hackathon-buke-team/grid-up/hardware/B1/GW/pcb-3d.png

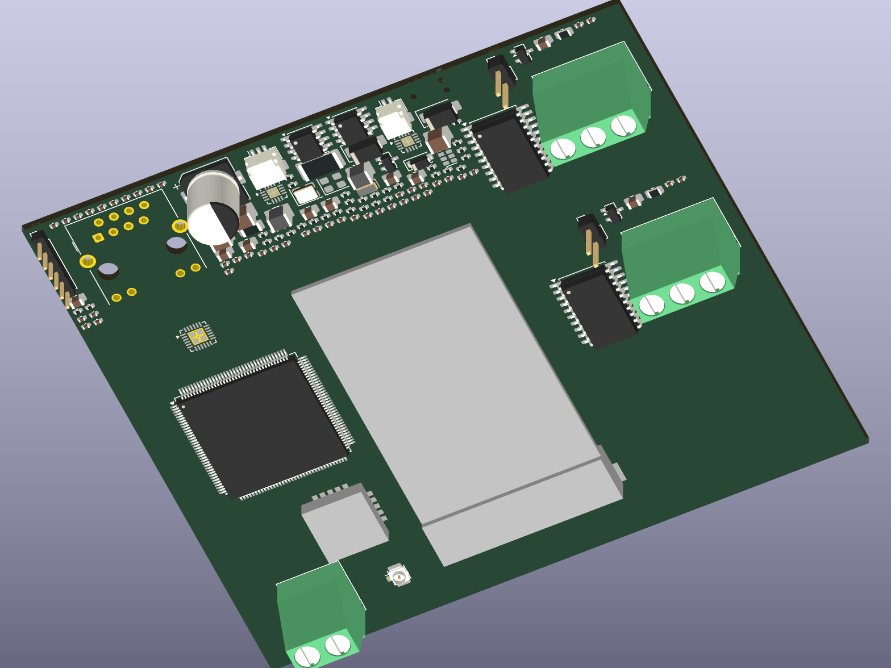
hardware/B1/GW/pcb-3d.png
