hackathon-buke-team/grid-up/hardware/B1/TC/pcb-3d.png

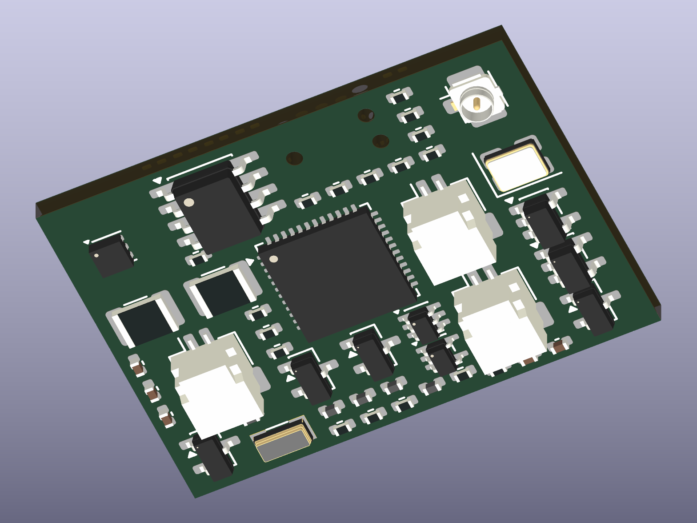
hardware/B1/TC/pcb-3d.png
