hackathon-buke-team/grid-up/hardware/B1/TEDARIK-ACIKLARI.md

# B1 tedarik açıkları

Bu dosya teklif talebi hazırlığıdır; hiçbir tedarikçiye gönderilmedi. Her satır için kesin MPN, paket, pin dizilimi, sıcaklık sınıfı, birim fiyat/para birimi/adet, alternatif ve Türkiye teslim tarihi kaydedilmelidir.

RF eşleme parçalarının değerleri routing ve RF doğrulaması sonrası sabitlenir. CT, HLC, izole faz referansı ve kutu kalemlerinde ölçü/elektriksel uygunluk fiyatla birlikte onaylanmalıdır.

| Kart / ref | Adet / kit | Teknik şart | Açık iş |
|---|---:|---|---|
| TC / J1 | 6 | CELL + HLC / Connector_JST:JST_SH_SM02B-SRSS-TB_1x02-1MP_P1.00mm_Horizontal | MPN_AND_QUOTE_REVIEW |
| TC / C1,C2,C13,C28,C30 | 30 | X7R 16V 1uF / Capacitor_SMD:C_0402_1005Metric | MPN_AND_QUOTE_REVIEW |
| TC / Q1 | 6 | AO3401A / Package_TO_SOT_SMD:SOT-23 | MPN_AND_QUOTE_REVIEW |
| TC / Q2,Q3 | 12 | 2N7002 / Package_TO_SOT_SMD:SOT-23 | MPN_AND_QUOTE_REVIEW |
| TC / R1,R2,R18,R19 | 24 | 1% thick film 1M / Resistor_SMD:R_0402_1005Metric | MPN_AND_QUOTE_REVIEW |
| TC / R3,R4,R6,R9,R11,R16 | 36 | 1% thick film 100k / Resistor_SMD:R_0402_1005Metric | MPN_AND_QUOTE_REVIEW |
| TC / C3 | 6 | X7R 16V 10nF / Capacitor_SMD:C_0402_1005Metric | MPN_AND_QUOTE_REVIEW |
| TC / R5 | 6 | 1% thick film 68R 0.5W / Resistor_SMD:R_1210_3225Metric | MPN_AND_QUOTE_REVIEW |
| TC / R7,R8 | 12 | 1% thick film 10k / Resistor_SMD:R_0402_1005Metric | MPN_AND_QUOTE_REVIEW |
| TC / C4,C5,C6,C7,C8,C11,C12,C16,C27,C31 | 60 | X7R 16V 100nF / Capacitor_SMD:C_0402_1005Metric | MPN_AND_QUOTE_REVIEW |
| TC / J2 | 6 | SWD TC2030 / Connector:Tag-Connect_TC2030-IDC-NL_2x03_P1.27mm_Vertical | MPN_AND_QUOTE_REVIEW |
| TC / J3 | 6 | MOUNT switch / Connector_JST:JST_SH_SM02B-SRSS-TB_1x02-1MP_P1.00mm_Horizontal | MPN_AND_QUOTE_REVIEW |
| TC / C9,C10 | 12 | X7R 16V 4.7uF / Capacitor_SMD:C_0402_1005Metric | MPN_AND_QUOTE_REVIEW |
| TC / R10,R15 | 12 | 1% thick film 0R / Resistor_SMD:R_0402_1005Metric | MPN_AND_QUOTE_REVIEW |
| TC / Y1 | 6 | 32MHz CL=10pF / Crystal:Crystal_SMD_3225-4Pin_3.2x2.5mm | MPN_AND_QUOTE_REVIEW |
| TC / Y2 | 6 | 32.768kHz CL=6pF / Crystal:Crystal_SMD_3215-2Pin_3.2x1.5mm | MPN_AND_QUOTE_REVIEW |
| TC / C14,C15 | 12 | X7R 16V 6pF / Capacitor_SMD:C_0402_1005Metric | MPN_AND_QUOTE_REVIEW |
| TC / U2 | 6 | MB85RS64V / Package_SO:SOIC-8_3.9x4.9mm_P1.27mm | MPN_AND_QUOTE_REVIEW |
| TC / R12,R13 | 12 | 1% thick film 4.7k / Resistor_SMD:R_0402_1005Metric | MPN_AND_QUOTE_REVIEW |
| TC / L1 | 6 | 47nH / Inductor_SMD:L_0402_1005Metric | MPN_AND_QUOTE_REVIEW |
| TC / C17,C29 | 12 | X7R 16V 47nF / Capacitor_SMD:C_0402_1005Metric | MPN_AND_QUOTE_REVIEW |
| TC / C18,C22,C26 | 18 | X7R 16V 68pF / Capacitor_SMD:C_0402_1005Metric | MPN_AND_QUOTE_REVIEW |
| TC / L2 | 6 | 4.4nH / Inductor_SMD:L_0402_1005Metric | MPN_AND_QUOTE_REVIEW |
| TC / C19 | 6 | X7R 16V 5.5pF / Capacitor_SMD:C_0402_1005Metric | MPN_AND_QUOTE_REVIEW |
| TC / C20 | 6 | X7R 16V 2.5pF / Capacitor_SMD:C_0402_1005Metric | MPN_AND_QUOTE_REVIEW |
| TC / L3 | 6 | 3.4nH / Inductor_SMD:L_0402_1005Metric | MPN_AND_QUOTE_REVIEW |
| TC / C21 | 6 | X7R 16V 4.3pF / Capacitor_SMD:C_0402_1005Metric | MPN_AND_QUOTE_REVIEW |
| TC / L4 | 6 | 9.2nH / Inductor_SMD:L_0402_1005Metric | MPN_AND_QUOTE_REVIEW |
| TC / C23 | 6 | X7R 16V 3.5pF / Capacitor_SMD:C_0402_1005Metric | MPN_AND_QUOTE_REVIEW |
| TC / C24 | 6 | X7R 16V 4.5pF / Capacitor_SMD:C_0402_1005Metric | MPN_AND_QUOTE_REVIEW |
| TC / L5 | 6 | 12nH / Inductor_SMD:L_0402_1005Metric | MPN_AND_QUOTE_REVIEW |
| TC / C25 | 6 | X7R 16V 2.7pF / Capacitor_SMD:C_0402_1005Metric | MPN_AND_QUOTE_REVIEW |
| TC / U3 | 6 | PE4259 / Package_TO_SOT_SMD:SOT-363_SC-70-6 | MPN_AND_QUOTE_REVIEW |
| TC / J4 | 6 | 868 MHz u.FL / Connector_Coaxial:U.FL_Hirose_U.FL-R-SMT-1_Vertical | MPN_AND_QUOTE_REVIEW |
| TC / J5 | 6 | CT 3000:1 / Connector_JST:JST_SH_SM02B-SRSS-TB_1x02-1MP_P1.00mm_Horizontal | MPN_AND_QUOTE_REVIEW |
| TC / R14 | 6 | 5.1R 0.1% 0.5W precision thin film; NOT generic 1% / Resistor_SMD:R_1210_3225Metric | MPN_AND_QUOTE_REVIEW |
| TC / R17 | 6 | 1% thick film 1k / Resistor_SMD:R_0402_1005Metric | MPN_AND_QUOTE_REVIEW |
| TC / U6 | 6 | BAT54S / Package_TO_SOT_SMD:SOT-23 | MPN_AND_QUOTE_REVIEW |
| IR / J1 | 1 | CELL + HLC / Connector_JST:JST_SH_SM02B-SRSS-TB_1x02-1MP_P1.00mm_Horizontal | MPN_AND_QUOTE_REVIEW |
| IR / L1 | 1 | 2.2uH Isat>=1A / Inductor_SMD:L_0805_2012Metric | MPN_AND_QUOTE_REVIEW |
| IR / R1 | 1 | 1% thick film 36.5k / Resistor_SMD:R_0402_1005Metric | MPN_AND_QUOTE_REVIEW |
| IR / R2 | 1 | 1% thick film 16.2k / Resistor_SMD:R_0402_1005Metric | MPN_AND_QUOTE_REVIEW |
| IR / C1,C28 | 2 | X7R 16V 10uF / Capacitor_SMD:C_0805_2012Metric | MPN_AND_QUOTE_REVIEW |
| IR / C2 | 1 | X7R 16V 22uF / Capacitor_SMD:C_0805_2012Metric | MPN_AND_QUOTE_REVIEW |
| IR / Q1,Q4 | 2 | AO3401A / Package_TO_SOT_SMD:SOT-23 | MPN_AND_QUOTE_REVIEW |
| IR / Q2,Q3,Q5 | 3 | 2N7002 / Package_TO_SOT_SMD:SOT-23 | MPN_AND_QUOTE_REVIEW |
| IR / R3,R4 | 2 | 1% thick film 1M / Resistor_SMD:R_0402_1005Metric | MPN_AND_QUOTE_REVIEW |
| IR / R5,R6,R8,R11,R13,R16,R17 | 7 | 1% thick film 100k / Resistor_SMD:R_0402_1005Metric | MPN_AND_QUOTE_REVIEW |
| IR / C3 | 1 | X7R 16V 10nF / Capacitor_SMD:C_0402_1005Metric | MPN_AND_QUOTE_REVIEW |
| IR / R7 | 1 | 1% thick film 68R 0.5W / Resistor_SMD:R_1210_3225Metric | MPN_AND_QUOTE_REVIEW |
| IR / R9,R10 | 2 | 1% thick film 10k / Resistor_SMD:R_0402_1005Metric | MPN_AND_QUOTE_REVIEW |
| IR / C4,C5,C6,C7,C8,C11,C12,C16,C27,C29 | 10 | X7R 16V 100nF / Capacitor_SMD:C_0402_1005Metric | MPN_AND_QUOTE_REVIEW |
| IR / J2 | 1 | SWD TC2030 / Connector:Tag-Connect_TC2030-IDC-NL_2x03_P1.27mm_Vertical | MPN_AND_QUOTE_REVIEW |
| IR / J3 | 1 | MOUNT switch / Connector_JST:JST_SH_SM02B-SRSS-TB_1x02-1MP_P1.00mm_Horizontal | MPN_AND_QUOTE_REVIEW |
| IR / C9,C10 | 2 | X7R 16V 4.7uF / Capacitor_SMD:C_0402_1005Metric | MPN_AND_QUOTE_REVIEW |
| IR / R12 | 1 | 1% thick film 0R / Resistor_SMD:R_0402_1005Metric | MPN_AND_QUOTE_REVIEW |
| IR / C13 | 1 | X7R 16V 1uF / Capacitor_SMD:C_0402_1005Metric | MPN_AND_QUOTE_REVIEW |
| IR / Y1 | 1 | 32MHz CL=10pF / Crystal:Crystal_SMD_3225-4Pin_3.2x2.5mm | MPN_AND_QUOTE_REVIEW |
| IR / Y2 | 1 | 32.768kHz CL=6pF / Crystal:Crystal_SMD_3215-2Pin_3.2x1.5mm | MPN_AND_QUOTE_REVIEW |
| IR / C14,C15 | 2 | X7R 16V 6pF / Capacitor_SMD:C_0402_1005Metric | MPN_AND_QUOTE_REVIEW |
| IR / U2 | 1 | MB85RS64V / Package_SO:SOIC-8_3.9x4.9mm_P1.27mm | MPN_AND_QUOTE_REVIEW |
| IR / R14,R15 | 2 | 1% thick film 4.7k / Resistor_SMD:R_0402_1005Metric | MPN_AND_QUOTE_REVIEW |
| IR / L2 | 1 | 47nH / Inductor_SMD:L_0402_1005Metric | MPN_AND_QUOTE_REVIEW |
| IR / C17 | 1 | X7R 16V 47nF / Capacitor_SMD:C_0402_1005Metric | MPN_AND_QUOTE_REVIEW |
| IR / C18,C22,C26 | 3 | X7R 16V 68pF / Capacitor_SMD:C_0402_1005Metric | MPN_AND_QUOTE_REVIEW |
| IR / L3 | 1 | 4.4nH / Inductor_SMD:L_0402_1005Metric | MPN_AND_QUOTE_REVIEW |
| IR / C19 | 1 | X7R 16V 5.5pF / Capacitor_SMD:C_0402_1005Metric | MPN_AND_QUOTE_REVIEW |
| IR / C20 | 1 | X7R 16V 2.5pF / Capacitor_SMD:C_0402_1005Metric | MPN_AND_QUOTE_REVIEW |
| IR / L4 | 1 | 3.4nH / Inductor_SMD:L_0402_1005Metric | MPN_AND_QUOTE_REVIEW |
| IR / C21 | 1 | X7R 16V 4.3pF / Capacitor_SMD:C_0402_1005Metric | MPN_AND_QUOTE_REVIEW |
| IR / L5 | 1 | 9.2nH / Inductor_SMD:L_0402_1005Metric | MPN_AND_QUOTE_REVIEW |
| IR / C23 | 1 | X7R 16V 3.5pF / Capacitor_SMD:C_0402_1005Metric | MPN_AND_QUOTE_REVIEW |
| IR / C24 | 1 | X7R 16V 4.5pF / Capacitor_SMD:C_0402_1005Metric | MPN_AND_QUOTE_REVIEW |
| IR / L6 | 1 | 12nH / Inductor_SMD:L_0402_1005Metric | MPN_AND_QUOTE_REVIEW |
| IR / C25 | 1 | X7R 16V 2.7pF / Capacitor_SMD:C_0402_1005Metric | MPN_AND_QUOTE_REVIEW |
| IR / U3 | 1 | PE4259 / Package_TO_SOT_SMD:SOT-363_SC-70-6 | MPN_AND_QUOTE_REVIEW |
| IR / J4 | 1 | 868 MHz u.FL / Connector_Coaxial:U.FL_Hirose_U.FL-R-SMT-1_Vertical | MPN_AND_QUOTE_REVIEW |
| IR / J5 | 1 | PHASE optional / Connector_JST:JST_SH_SM02B-SRSS-TB_1x02-1MP_P1.00mm_Horizontal | MPN_AND_QUOTE_REVIEW |
| PD / J1 | 1 | CELL + HLC / Connector_JST:JST_SH_SM02B-SRSS-TB_1x02-1MP_P1.00mm_Horizontal | MPN_AND_QUOTE_REVIEW |
| PD / L1 | 1 | 2.2uH Isat>=1A / Inductor_SMD:L_0805_2012Metric | MPN_AND_QUOTE_REVIEW |
| PD / R1 | 1 | 1% thick film 36.5k / Resistor_SMD:R_0402_1005Metric | MPN_AND_QUOTE_REVIEW |
| PD / R2 | 1 | 1% thick film 16.2k / Resistor_SMD:R_0402_1005Metric | MPN_AND_QUOTE_REVIEW |
| PD / C1,C27 | 2 | X7R 16V 10uF / Capacitor_SMD:C_0805_2012Metric | MPN_AND_QUOTE_REVIEW |
| PD / C2,C28 | 2 | X7R 16V 22uF / Capacitor_SMD:C_0805_2012Metric | MPN_AND_QUOTE_REVIEW |
| PD / Q1,Q4 | 2 | AO3401A / Package_TO_SOT_SMD:SOT-23 | MPN_AND_QUOTE_REVIEW |
| PD / Q2,Q3,Q5 | 3 | 2N7002 / Package_TO_SOT_SMD:SOT-23 | MPN_AND_QUOTE_REVIEW |
| PD / R3,R4 | 2 | 1% thick film 1M / Resistor_SMD:R_0402_1005Metric | MPN_AND_QUOTE_REVIEW |
| PD / R5,R6,R8,R11,R13,R17,R18,R23,R24,R25,R26,R27,R28,R29 | 14 | 1% thick film 100k / Resistor_SMD:R_0402_1005Metric | MPN_AND_QUOTE_REVIEW |
| PD / C3,C29,C30,C38,C42 | 5 | X7R 16V 10nF / Capacitor_SMD:C_0402_1005Metric | MPN_AND_QUOTE_REVIEW |
| PD / R7 | 1 | 1% thick film 68R 0.5W / Resistor_SMD:R_1210_3225Metric | MPN_AND_QUOTE_REVIEW |
| PD / R9,R10,R30 | 3 | 1% thick film 10k / Resistor_SMD:R_0402_1005Metric | MPN_AND_QUOTE_REVIEW |
| PD / C4,C5,C6,C7,C8,C11,C12,C16,C31,C33,C37,C40,C41,C44 | 14 | X7R 16V 100nF / Capacitor_SMD:C_0402_1005Metric | MPN_AND_QUOTE_REVIEW |
| PD / J2 | 1 | SWD TC2030 / Connector:Tag-Connect_TC2030-IDC-NL_2x03_P1.27mm_Vertical | MPN_AND_QUOTE_REVIEW |
| PD / J3 | 1 | MOUNT switch / Connector_JST:JST_SH_SM02B-SRSS-TB_1x02-1MP_P1.00mm_Horizontal | MPN_AND_QUOTE_REVIEW |
| PD / C9,C10 | 2 | X7R 16V 4.7uF / Capacitor_SMD:C_0402_1005Metric | MPN_AND_QUOTE_REVIEW |
| PD / R12 | 1 | 1% thick film 0R / Resistor_SMD:R_0402_1005Metric | MPN_AND_QUOTE_REVIEW |
| PD / C13,C43 | 2 | X7R 16V 1uF / Capacitor_SMD:C_0402_1005Metric | MPN_AND_QUOTE_REVIEW |
| PD / Y1 | 1 | 32MHz CL=10pF / Crystal:Crystal_SMD_3225-4Pin_3.2x2.5mm | MPN_AND_QUOTE_REVIEW |
| PD / Y2 | 1 | 32.768kHz CL=6pF / Crystal:Crystal_SMD_3215-2Pin_3.2x1.5mm | MPN_AND_QUOTE_REVIEW |
| PD / C14,C15 | 2 | X7R 16V 6pF / Capacitor_SMD:C_0402_1005Metric | MPN_AND_QUOTE_REVIEW |
| PD / U2 | 1 | MB85RS64V / Package_SO:SOIC-8_3.9x4.9mm_P1.27mm | MPN_AND_QUOTE_REVIEW |
| PD / R14,R15 | 2 | 1% thick film 4.7k / Resistor_SMD:R_0402_1005Metric | MPN_AND_QUOTE_REVIEW |
| PD / L2 | 1 | 47nH / Inductor_SMD:L_0402_1005Metric | MPN_AND_QUOTE_REVIEW |
| PD / C17 | 1 | X7R 16V 47nF / Capacitor_SMD:C_0402_1005Metric | MPN_AND_QUOTE_REVIEW |
| PD / C18,C22,C26 | 3 | X7R 16V 68pF / Capacitor_SMD:C_0402_1005Metric | MPN_AND_QUOTE_REVIEW |
| PD / L3 | 1 | 4.4nH / Inductor_SMD:L_0402_1005Metric | MPN_AND_QUOTE_REVIEW |
| PD / C19 | 1 | X7R 16V 5.5pF / Capacitor_SMD:C_0402_1005Metric | MPN_AND_QUOTE_REVIEW |
| PD / C20 | 1 | X7R 16V 2.5pF / Capacitor_SMD:C_0402_1005Metric | MPN_AND_QUOTE_REVIEW |
| PD / L4 | 1 | 3.4nH / Inductor_SMD:L_0402_1005Metric | MPN_AND_QUOTE_REVIEW |
| PD / C21 | 1 | X7R 16V 4.3pF / Capacitor_SMD:C_0402_1005Metric | MPN_AND_QUOTE_REVIEW |
| PD / L5 | 1 | 9.2nH / Inductor_SMD:L_0402_1005Metric | MPN_AND_QUOTE_REVIEW |
| PD / C23 | 1 | X7R 16V 3.5pF / Capacitor_SMD:C_0402_1005Metric | MPN_AND_QUOTE_REVIEW |
| PD / C24 | 1 | X7R 16V 4.5pF / Capacitor_SMD:C_0402_1005Metric | MPN_AND_QUOTE_REVIEW |
| PD / L6 | 1 | 12nH / Inductor_SMD:L_0402_1005Metric | MPN_AND_QUOTE_REVIEW |
| PD / C25 | 1 | X7R 16V 2.7pF / Capacitor_SMD:C_0402_1005Metric | MPN_AND_QUOTE_REVIEW |
| PD / U3,U5 | 2 | PE4259 / Package_TO_SOT_SMD:SOT-363_SC-70-6 | MPN_AND_QUOTE_REVIEW |
| PD / J4 | 1 | 868 MHz u.FL / Connector_Coaxial:U.FL_Hirose_U.FL-R-SMT-1_Vertical | MPN_AND_QUOTE_REVIEW |
| PD / L7 | 1 | 1uH Isat>=4A / Inductor_SMD:L_1210_3225Metric | MPN_AND_QUOTE_REVIEW |
| PD / R16 | 1 | 1% thick film 732k / Resistor_SMD:R_0402_1005Metric | MPN_AND_QUOTE_REVIEW |
| PD / J5 | 1 | HFCT50 / Connector_Coaxial:SMA_Amphenol_132134_Vertical | MPN_AND_QUOTE_REVIEW |
| PD / R19,R20 | 2 | 1% thick film 49.9R / Resistor_SMD:R_0402_1005Metric | MPN_AND_QUOTE_REVIEW |
| PD / J6 | 1 | TEV plate / Connector_Coaxial:SMA_Amphenol_132134_Vertical | MPN_AND_QUOTE_REVIEW |
| PD / C32 | 1 | X7R 16V 100pF / Capacitor_SMD:C_0402_1005Metric | MPN_AND_QUOTE_REVIEW |
| PD / L8 | 1 | 1uH / Inductor_SMD:L_0402_1005Metric | MPN_AND_QUOTE_REVIEW |
| PD / U6 | 1 | PGA-103+ / Package_TO_SOT_SMD:SOT-89-3 | MPN_AND_QUOTE_REVIEW |
| PD / L9 | 1 | 1uH / Inductor_SMD:L_0805_2012Metric | MPN_AND_QUOTE_REVIEW |
| PD / C34,C35,C39 | 3 | X7R 16V 1nF / Capacitor_SMD:C_0402_1005Metric | MPN_AND_QUOTE_REVIEW |
| PD / C36 | 1 | X7R 16V 220pF / Capacitor_SMD:C_0402_1005Metric | MPN_AND_QUOTE_REVIEW |
| PD / R21 | 1 | 1% thick film 499R / Resistor_SMD:R_0402_1005Metric | MPN_AND_QUOTE_REVIEW |
| PD / R22 | 1 | 1% thick film 1k / Resistor_SMD:R_0402_1005Metric | MPN_AND_QUOTE_REVIEW |
| PD / J7 | 1 | MA40S4R receiver / Connector_JST:JST_SH_SM02B-SRSS-TB_1x02-1MP_P1.00mm_Horizontal | MPN_AND_QUOTE_REVIEW |
| PD / J8 | 1 | ISOLATED 50Hz PHASE / Connector_JST:JST_SH_SM02B-SRSS-TB_1x02-1MP_P1.00mm_Horizontal | MPN_AND_QUOTE_REVIEW |
| GW / J1 | 1 | 5V SELV 4A / TerminalBlock_Phoenix:TerminalBlock_Phoenix_MKDS-1,5-2-5.08_1x02_P5.08mm_Horizontal | MPN_AND_QUOTE_REVIEW |
| GW / F1 | 1 | 3.15A slow / Fuse:Fuse_1206_3216Metric | MPN_AND_QUOTE_REVIEW |
| GW / Q1 | 1 | AO3401A / Package_TO_SOT_SMD:SOT-23 | MPN_AND_QUOTE_REVIEW |
| GW / C1 | 1 | X7R 16V 100uF / Capacitor_SMD:C_1210_3225Metric | MPN_AND_QUOTE_REVIEW |
| GW / L1,L2 | 2 | 2.2uH Isat>=4A / Inductor_SMD:L_1210_3225Metric | MPN_AND_QUOTE_REVIEW |
| GW / R1,R3 | 2 | 1% thick film 316k / Resistor_SMD:R_0402_1005Metric | MPN_AND_QUOTE_REVIEW |
| GW / R2,R4,R29,R30,R34,R35 | 6 | 1% thick film 100k / Resistor_SMD:R_0402_1005Metric | MPN_AND_QUOTE_REVIEW |
| GW / C2,C5,C57 | 3 | X7R 16V 10nF / Capacitor_SMD:C_0402_1005Metric | MPN_AND_QUOTE_REVIEW |
| GW / C3,C6,C56 | 3 | X7R 16V 22uF / Capacitor_SMD:C_0805_2012Metric | MPN_AND_QUOTE_REVIEW |
| GW / C4,C7 | 2 | X7R 16V 47uF / Capacitor_SMD:C_1210_3225Metric | MPN_AND_QUOTE_REVIEW |
| GW / C8 | 1 | X7R 16V 470uF low ESR / Capacitor_SMD:CP_Elec_8x10 | MPN_AND_QUOTE_REVIEW |
| GW / C9,C10 | 2 | X7R 16V 2.2uF / Capacitor_SMD:C_0402_1005Metric | MPN_AND_QUOTE_REVIEW |
| GW / C11,C12,C13,C14,C15,C16,C17,C18,C19,C20,C21,C22,C23,C24,C26,C31,C32,C33,C34,C36,C37,C38,C39,C40,C42,C43,C45,C46,C48,C49,C51,C52,C54 | 33 | X7R 16V 100nF / Capacitor_SMD:C_0402_1005Metric | MPN_AND_QUOTE_REVIEW |
| GW / C25,C44,C47,C50,C53,C55 | 6 | X7R 16V 10uF / Capacitor_SMD:C_0805_2012Metric | MPN_AND_QUOTE_REVIEW |
| GW / R5,R6,R7,R8,R11,R12,R13,R14,R15,R16,R17,R18,R21,R22,R24,R25,R27,R28,R32,R33 | 20 | 1% thick film 10k / Resistor_SMD:R_0402_1005Metric | MPN_AND_QUOTE_REVIEW |
| GW / Y1 | 1 | 25MHz CL=12pF / Crystal:Crystal_SMD_3225-4Pin_3.2x2.5mm | MPN_AND_QUOTE_REVIEW |
| GW / C27,C28 | 2 | X7R 16V 18pF / Capacitor_SMD:C_0402_1005Metric | MPN_AND_QUOTE_REVIEW |
| GW / Y2 | 1 | 32.768kHz / Crystal:Crystal_SMD_3215-2Pin_3.2x1.5mm | MPN_AND_QUOTE_REVIEW |
| GW / C29,C30 | 2 | X7R 16V 6pF / Capacitor_SMD:C_0402_1005Metric | MPN_AND_QUOTE_REVIEW |
| GW / J2 | 1 | SWD TC2030 / Connector:Tag-Connect_TC2030-IDC-NL_2x03_P1.27mm_Vertical | MPN_AND_QUOTE_REVIEW |
| GW / U3 | 1 | W25Q64JVSSIQ / Package_SO:SOIC-8_3.9x4.9mm_P1.27mm | MPN_AND_QUOTE_REVIEW |
| GW / U4 | 1 | APS6404L-3SQR-SN / Package_SO:SOIC-8_3.9x4.9mm_P1.27mm | MPN_AND_QUOTE_REVIEW |
| GW / U5 | 1 | RV-3028-C7 / Package_SON:MicroCrystal_C7_SON-8_1.5x3.2mm_P0.9mm | MPN_AND_QUOTE_REVIEW |
| GW / J3 | 1 | RTC primary cell / Connector_JST:JST_SH_SM02B-SRSS-TB_1x02-1MP_P1.00mm_Horizontal | MPN_AND_QUOTE_REVIEW |
| GW / R9,R10 | 2 | 1% thick film 4.7k / Resistor_SMD:R_0402_1005Metric | MPN_AND_QUOTE_REVIEW |
| GW / U6 | 1 | LAN8742A-CZ-TR / Package_DFN_QFN:VQFN-24-1EP_4x4mm_P0.5mm_EP2.5x2.5mm_ThermalVias | MPN_AND_QUOTE_REVIEW |
| GW / U7 | 1 | 50MHz 3V3 OSC / Oscillator:Oscillator_SMD_Abracon_ASE-4Pin_3.2x2.5mm | MPN_AND_QUOTE_REVIEW |
| GW / R19 | 1 | 1% thick film 12.1k 1% / Resistor_SMD:R_0402_1005Metric | MPN_AND_QUOTE_REVIEW |
| GW / C35 | 1 | X7R 16V 1uF / Capacitor_SMD:C_0402_1005Metric | MPN_AND_QUOTE_REVIEW |
| GW / J4 | 1 | HR911105A / Connector_RJ:RJ45_Hanrun_HR911105A_Horizontal | MPN_AND_QUOTE_REVIEW |
| GW / R20 | 1 | 1% thick film 1M / Resistor_SMD:R_0402_1005Metric | MPN_AND_QUOTE_REVIEW |
| GW / C41 | 1 | X7R 16V 1nF 2kV / Capacitor_SMD:C_1206_3216Metric | MPN_AND_QUOTE_REVIEW |
| GW / J5 | 1 | MPR / TerminalBlock_Phoenix:TerminalBlock_Phoenix_MKDS-1,5-3-5.08_1x03_P5.08mm_Horizontal | MPN_AND_QUOTE_REVIEW |
| GW / U9,U11 | 2 | SM712 / Package_TO_SOT_SMD:SOT-23 | MPN_AND_QUOTE_REVIEW |
| GW / R23,R26 | 2 | 1% thick film 120R / Resistor_SMD:R_0805_2012Metric | MPN_AND_QUOTE_REVIEW |
| GW / J6,J8 | 2 | TERM OPEN / Connector_PinHeader_2.54mm:PinHeader_1x02_P2.54mm_Vertical | MPN_AND_QUOTE_REVIEW |
| GW / J7 | 1 | TVOC / TerminalBlock_Phoenix:TerminalBlock_Phoenix_MKDS-1,5-3-5.08_1x03_P5.08mm_Horizontal | MPN_AND_QUOTE_REVIEW |
| GW / U12 | 1 | E22-900MM22S / B1:E22-900MM22S | MPN_AND_QUOTE_REVIEW |
| GW / J9 | 1 | 868MHz antenna / Connector_Coaxial:U.FL_Hirose_U.FL-R-SMT-1_Vertical | MPN_AND_QUOTE_REVIEW |
| GW / U13 | 1 | 2041119-1 / B1:TE_2041119_1 | MPN_AND_QUOTE_REVIEW |
| GW / J10 | 1 | SIM connector / Connector_PinHeader_2.00mm:PinHeader_1x06_P2.00mm_Vertical | MPN_AND_QUOTE_REVIEW |
| GW / D1,D2 | 2 | SS34 / Diode_SMD:D_SMA | MPN_AND_QUOTE_REVIEW |
| GW / D3 | 1 | BAT54 / Diode_SMD:D_SOD-123 | MPN_AND_QUOTE_REVIEW |
| GW / R31 | 1 | 1% thick film 100R 1W / Resistor_SMD:R_2512_6332Metric | MPN_AND_QUOTE_REVIEW |
| GW / J11 | 1 | 2x10F 2.7V EDLC pack / Connector_JST:JST_SH_SM03B-SRSS-TB_1x03-1MP_P1.00mm_Horizontal | MPN_AND_QUOTE_REVIEW |
| TC / EXTERNAL | 6 | CT 400 A / 3000:1 / split core / aperture >=32 mm / external | CUSTOM_OR_EXTERNAL_RFQ |
| TC / EXTERNAL | 6 | ER14250 3.6 V primary cell, 1.2 Ah envelope / external | CUSTOM_OR_EXTERNAL_RFQ |
| TC+PD / EXTERNAL | 7 | HLC pulse buffer <=16.5 x55 mm, compatible with Li-SOCl2 / external | CUSTOM_OR_EXTERNAL_RFQ |
| IR / EXTERNAL | 1 | ER14505 3.6 V 2.6 Ah, pulse-rated assembled pack / external | CUSTOM_OR_EXTERNAL_RFQ |
| PD / EXTERNAL | 1 | ER26500 3.6 V 8.5 Ah / external | CUSTOM_OR_EXTERNAL_RFQ |
| PD / EXTERNAL | 1 | HFCT50 / external | CUSTOM_OR_EXTERNAL_RFQ |
| PD / EXTERNAL | 1 | Insulated TEV capacitive plate assembly / external | CUSTOM_OR_EXTERNAL_RFQ |
| PD / EXTERNAL | 1 | MA40S4R 40 kHz receiver / external | CUSTOM_OR_EXTERNAL_RFQ |
| PD / EXTERNAL | 1 | Isolated 50 Hz voltage-phase reference, SELV 0..3.3 V output / external | CUSTOM_OR_EXTERNAL_RFQ |
| GW / EXTERNAL | 1 | EC21-E MiniPCIe LTE modem (not bare LCC EC21) / external | CUSTOM_OR_EXTERNAL_RFQ |
| GW / EXTERNAL | 1 | 5 V SELV 4 A isolated DIN power supply / external | CUSTOM_OR_EXTERNAL_RFQ |
| GW / EXTERNAL | 2 | 10 F / 2.7 V EDLC in enclosed series pack / external | CUSTOM_OR_EXTERNAL_RFQ |
| GW / EXTERNAL | 1 | Primary 3 V RTC backup cell, enclosed / external | CUSTOM_OR_EXTERNAL_RFQ |
| ALL / EXTERNAL | 9 | Insulated 868 MHz antenna and captive coax / external | CUSTOM_OR_EXTERNAL_RFQ |
| GW / EXTERNAL | 1 | LTE antenna + SIM holder + short USB/SIM harness / external | CUSTOM_OR_EXTERNAL_RFQ |
| ALL / EXTERNAL | 1 | 6 TC +1 IR +1 PD +1 GW enclosure/mount/gasket set / external | CUSTOM_OR_EXTERNAL_RFQ |
| ALL / EXTERNAL | 1 | 4-layer PCB: 6 TC +1 IR +1 PD +1 GW; assembly / external | CUSTOM_OR_EXTERNAL_RFQ |
| ALL / EXTERNAL | 1 | Low-voltage cables, clamps, strain relief and labels / external | CUSTOM_OR_EXTERNAL_RFQ |
