hackathon-buke-team/grid-up/PANO-GOZ-TAKIM-GOREV-DAGILIMI.docx

PANO GÖZ

Pano / Hücre İçi Anomali Erken Uyarı Sistemi

ADM & GDZ Elektrik Hackathon

— — — — — — — — — — — — — — — — — —

İSTERLER · YAPILANLAR · GELİŞTİRİLECEKLER
ve
4 KİŞİLİK TAKIM GÖREV DAĞILIMI

Sürüm 1.0 · 11 Eylül 2026

Bu belge takımın dört üyesi için bağımsız ilerleyebilen,
dengeli iş paketleri tanımlar. Herkes kendi bölümünü okumakla yetinmemeli;
§8 ortak kuralları hepimizi bağlar.

# 0. Bir sayfada durum

PANO GÖZ, 1600 kVA'lık bir TEDAŞ AG panosundaki cıvatalı bağlantıların gevşemesini, aşırı yükü, yoğuşmayı, nötr harmonik yüklenmesini ve ark koruma bütünlüğünü, arıza olmadan haftalar önce haber vermek üzere tasarlanmış uçtan uca bir izleme sistemidir. Ölçüm, kestirim, kural, alarm, SCADA ve bildirim katmanlarının tamamı çalışır durumdadır.

Ürünün tek cümlelik farkı şudur: sabit sıcaklık eşiği yerine, aynı havayı soluyan kardeş iletkenler arasındaki farkı anma akımına normalize eden θ metriği kullanılır. Bu sayede mevsim, yük ve yayıcılık sadeleşir; ağustosta kör olmayan, şubatta yanlış alarm üretmeyen bir dedektör kalır.

Boyut | Bugünkü durum
Kod tabanı | ≈ 39 300 satır · Python sunucu + C99 firmware + saf JS arayüz
Kapsanan varlık | Pano başına 74 cıvatalı bağlantı, 40'ı izlenen; 12 fider; 9 cihaz
Kanal kütüğü | 57 kanal, tek doğruluk kaynağı (`contracts/channels.py`)
Arıza modu | 7 mod: gevşek bağlantı, aşırı yük, ark bütünlüğü, ısıl kaçış, nötr harmonik, nem/yoğuşma, yalıtım
Senaryo kütüphanesi | 17 senaryo: 10 alarm üreten, 7 negatif kontrol
SCADA | Modbus TCP slave çalışıyor · ICD v2.0.0 · pano başına 48 register, 200 pano kapasitesi, üst adres 10599
Test durumu | pytest 138 · rules 40/40 · scada 30/30 · modbus 8/8 · prpd tamam · sim 52/52 · entegrasyon 17/17 · firmware öz test 0 hata
Belge paketi | 11 teknik belge + ICD + README ≈ 5 000 satır

Bu belgenin amacı

Elimizdeki şey güçlü ama eşit dağılmamış: yazılım ve doküman tarafı çok ilerideyken fiziksel modül, gerçek bildirim kanalı ve ikinci SCADA protokolü açıkta. Değerlendirme kriterleri bunların hepsine puan veriyor. Aşağıdaki dört iş paketi, tam olarak bu açıkları kapatacak şekilde ve birbirini beklemeyecek biçimde ayrılmıştır.

# 1. Yarışma isterleri ve karşılanma durumu

Aşağıdaki tablo, şartnamedeki “Takımlardan Beklenen Teknik Çıktılar” başlığının yedi maddesini ve demo beklentilerini bugünkü durumla eşler. Renk yerine sözcük kullanıldı, çünkü bu tablo yazdırıldığında da okunmalıdır.

# | İster (şartname) | Durum | Eksik kalan

1 | Kabin içi fiziksel modül / prototip tasarımı | KISMEN | Konsept, bileşen seçimi, blok şema ve BOM var. KiCad şematiği ve PCB çizilmedi, mekanik yerleşim görseli yok.
2 | Elektronik tasarım dokümantasyonu (PCB, I/O, bağlantı şeması, bileşenler) | KISMEN | Blok / I-O / BOM düzeyinde belgelendi. Gerçek şematik sayfası ve kart yerleşimi eksik.
3 | Yazılım mimarisi (MCU kaynak kodu, çalışma mantığı, akış diyagramı, frontend) | TAMAM | C99 firmware + akış diyagramı + frontend kaynağı var. STM32 hedef derlemesi (arm-none-eabi) doğrulanmadı.
4 | Monitoring (merkezî toplama ve izleme) | TAMAM | Dijital ikiz, alarm konsolu, kanıt ve bastırma ekranları çalışıyor. Mobil/saha görünümü yok.
4a | SCADA entegrasyonu — Modbus haritalama | TAMAM | Modbus TCP slave + ICD v2.0.0. IEC 60870-5-104 nokta listesi yazıldı, sunucu kurulmadı.
4b | On-premise altyapı (Public Cloud yok) | TAMAM | Tamamı yerelde çalışıyor, dış servis çağrısı yok. Compose dosyası sertleştirilmedi.
4c | SMS / WhatsApp alarm mekanizması | KISMEN | SMS ve sesli arama simüle ediliyor, transkript üretiliyor. Gerçek bir kanaldan tek bir mesaj bile gitmedi.
5 | Ölçeklenebilirlik — en az 100 modül | TAMAM | 112 pano ile ölçüldü ve raporlandı. 1000 pano yük testi ve kaynak ölçümü yapılmadı.
6 | On-premise / özel altyapı yaklaşımı | TAMAM | Public cloud bağımlılığı yok. mTLS ve broker ACL yorum satırında duruyor.
7 | Alarm ve acil bildirim mekanizması | KISMEN | Eskalasyon merdiveni, kimliklendirilmiş onay, fırtına sınırı kodlandı. Gerçek gönderim yok.
D | Demo: uçtan uca akış, normal/anormal senaryolar, mimari, saha uygulaması | KISMEN | Senaryo metni yazıldı (docs/08). Provası yapılmadı, video ve slayt yok.

## 1.1 Değerlendirme kriterleri ve bugünkü gücümüz

Kriter | Güçlü müyüz? | Neden / ne yapılmalı
Problemin doğru anlaşılması | ÇOK GÜÇLÜ | θ metriği problemin kendisinden türetilmiş; sabit eşiğin neden çalışmadığı sayıyla gösteriliyor.
Anomali ve risk tespitinin başarısı | GÜÇLÜ | RLS + CUSUM + değişim noktası + 3/5 debounce. Yanlış alarm aritmetiği analitik olarak savunuluyor. Doğruluk matrisi sunulmalı.
Saha koşullarında uygulanabilirlik | ORTA | Saha uygulama belgesi güçlü; fiziksel modül görseli ve montaj kanıtı eksik. En büyük açık bu.
Uçtan uca sistem yaklaşımı | ÇOK GÜÇLÜ | Sensörden SCADA register'ına kadar tek zincir çalışıyor.
Mevcut operasyon sistemleriyle entegrasyon | GÜÇLÜ | Modbus haritası hazır. IEC 104 eklenirse tartışmasız olur.
Ölçeklenebilirlik | GÜÇLÜ | 112 pano ölçüldü; 1000 pano testi bunu kanıta çevirir.
Kullanıcı / operasyon deneyimi | ORTA | Ekranlar var ama saha ekibi için mobil akış ve iş emri kartı yok.
Maliyet ve fayda | GÜÇLÜ | Maliyet-fayda belgesi hazır; BOM fiyatları tazelenmeli.
Yenilikçilik | GÜÇLÜ | θ normalizasyonu, bastırma katmanı ve “neden alarm vermedim” ekranı ayırt edici. Sunumda öne çıkarılmalı.

# 2. Bugüne kadar yapılanlar

## 2.1 Ölçüm ve tespit katmanı

- θ kestirimi: kardeş medyanına göre fark, anma akımına normalize; özyinelemeli en küçük kareler (RLS) ile ısıl gecikme çözülüyor.
- Sürüklenme tespiti: günlük medyanlar üzerinde CUSUM, değişim noktası kestirimi ve eğim; haftalar önceden haber verme yolu budur.
- Mutlak güvenlik limitleri ilk dakikadan itibaren açık: 110 °C KRİTİK, 130 °C ACİL — öğrenme haftasında bile.
- Nötr için ayrı kural (H3): K_N = ΔT/I² kendi taban çizgisine göre oranlanır; harmonik yüklenme ile gevşek nötr ayrılır.
- Yoğuşma: duvar sıcaklığı modeli, çiy noktası ve yoğuşma marjı; ıslanma süresi biriktiriliyor.
- Kısmi deşarj kanalı: faz çözünürlüklü histogram ve sınıflandırıcı; AG'de tek başına ekip yönlendirmediği açıkça yazılı.
- Ark koruma bütünlüğü: ABB TVOC-2 register'ları okunuyor; dedektör arızası, otokontrol gecikmesi ve aktif açma ayrı ayrı raporlanıyor.

## 2.2 Kural, alarm ve bildirim katmanı

- Sabit sıra: bastırma → füzyon → alarm. Açıklanabilen kanıt hiç olasılığa girmiyor.
- Bastırma gerekçeleri Türkçe, sayılarıyla ve zaman damgasıyla saklanıyor; “78 °C okudun, neden söylemedin?” sorusunun cevabı ekranda hazır.
- Alarm hijyeni: 3/5 günlük debounce, %40 ölü bant, 7 günlük kendiliğinden kapanma, iki kanal ailesi şartı, fırtına sınırı.
- Eskalasyon merdiveni ve kimliklendirilmiş onay: tahmin edilemeyen 4 haneli token, kişi + olay eşleşmesi.
- Üç faz gerilim THD artışı artık kesin şebeke olayı değil, şebeke olayı ADAYI olarak sınıflandırılıyor; ısıl bulguyu tek başına silmiyor.

## 2.3 Taşıma, depolama ve SCADA

- Süreç içi bus ve MQTT sürücüsü aynı arayüz arkasında; tek ortam değişkeniyle geçiş.
- QoS 1 store-and-forward: PUBACK gelmeden mesaj tamamlanmış sayılmıyor, yeniden başlatmada onaysız kuyruk geri yükleniyor.
- Tekrarlanan veya eski zarf canlı durumu geri almıyor; sıra numarası su damgası yalnız ileri gidiyor.
- Cihaz yayın aralığı sözleşmede taşınıyor (dev.period_s); tazelik pencereleri sunucuda sabit değil, cihazın ilan ettiği kadanstan türetiliyor.
- Modbus TCP slave: yalnız okuma, yazma istisna ile reddediliyor; register haritası ICD belgesinden üretiliyor.

## 2.4 Simülasyon, arayüz ve belgeler

- Fizikten türetilmiş dijital ikiz: yük profili, ısıl model, 17 arıza senaryosu, TVOC-2 ve MPR-53CS register sunucuları, PRPD üreteci.
- Arayüz: filo haritası, dijital ikiz, alarm konsolu, kanıt ekranı, bastırma ekranı, PRPD ve SCADA görünümü.
- C99 uç düğüm firmware'i: float yok, malloc yok; uyarlanabilir kadans (900/60/10 s), histerezis, enerji bütçesi, OTA durum makinesi. Ana bilgisayarda derleniyor ve öz testi sıfır hatayla geçiyor.
- 11 teknik belge: mimari, donanım, elektronik, anomali tespiti, saha uygulaması, ölçeklenebilirlik, maliyet-fayda, demo senaryosu, veri analizi, OG hücre konsepti, açık sorular.

## 2.5 Son turda kapatılan gerçek hatalar

Hata | Sonucu | Şimdi
Füzyon, dedektörün kararını anlık θ ile eziyordu | Alarm konsolu ile pano ekranı aynı bağlantı için farklı seviye gösterebiliyordu | Tek karar mercii; mutlak limitler üstte kalıyor
Pano yükü 2312 A yerine 3250 A'ya bölünüyordu | Üç faz tam yükteyken pano %71 yüklü görünüyordu | Bara ve fider ölçekleri ayrı alanlar
Paho 2.x ReasonCode TypeError | Gerçek broker'a bağlanma yolunda çökme | Düzeltildi, regresyon testi var
PUBACK beklenmeden tampon boşaltılıyordu | Kopan bağlantıda sessiz veri kaybı | Makbuz tabanlı; outbox SQLite'ta kalıcı
Tekrarlanan mesaj eski değeri geri getiriyordu | Canlı akım 200 A'dan 100 A'ya düşebiliyordu | Duplicate düşürülüyor ve sayılıyor
15 dakikalık firmware kadansı 3 dakikalık sunucu eşiğiyle çelişiyordu | Sağlıklı düğüm 3. dakikada ölü ilan ediliyordu | Pencereler kadanstan türetiliyor
Geçmişten debounce penceresi kurulamıyordu | 60 günlük kanıtı olan pano hiç olay açamıyordu | Sentinel düzeltildi, uçtan uca test yeşil
Negatif kontrol testi davranışı değil sözlüğü kontrol ediyordu | Dedektörü kapalı bir sürümde de geçerdi | 7 senaryo gerçek boru hattından geçiyor

# 3. Geliştirilecekler

Öncelik, yarışma puanına etkisine göre verildi. P1 maddeleri kapanmazsa sunumda doğrudan soru gelir; P2 maddeleri farkı açar; P3 maddeleri vaktimiz kalırsa.

Ö | Konu | Neden önemli | Kim
P1 | KiCad şematiği ve PCB yerleşimi | Şartnamenin 2. maddesi doğrudan bunu istiyor. Bugün blok şema düzeyindeyiz. | K1
P1 | Kabin içi mekanik yerleşim görseli | Şartnamenin 1. maddesi. 1600 kVA pano çizimi üzerinde montaj gösterilmeli. | K1
P1 | Gerçek bildirim kanalından tek bir mesajın gitmesi | Şartnamenin 7. maddesi. Simülasyon “gösterilebilir” sayılır ama gerçeği tartışmayı bitirir. | K4
P1 | Gerçek Mosquitto üzerinde uçtan uca test | MQTT yolunun çalıştığını bugün yalnız süreç içi bus ile gösteriyoruz. | K2
P1 | Demo provası, slaytlar ve video | Final sunumu puanın büyük bölümünü taşıyor. | K4
P2 | IEC 60870-5-104 slave | “Mevcut operasyon sistemleriyle entegrasyon” kriterini tartışmasız hale getirir. | K2
P2 | STM32 hedef derlemesi (arm-none-eabi) | Firmware'in gerçek donanıma sığdığını flash/RAM raporuyla gösterir. | K1
P2 | Mobil / saha görünümü | “Kullanıcı ve operasyon deneyimi” kriteri. Ekibi sahaya yönlendiren ekran telefonda açılmalı. | K3
P2 | 1000 pano yük testi ve kaynak ölçümü | Ölçeklenebilirlik iddiasını ölçüme çevirir. | K2
P2 | Kanıt ekranının güçlendirilmesi | Ayırt edici özelliğimiz “neden alarm verdim / vermedim”. Ekran bunu anlatmalı. | K3
P2 | Doğruluk matrisi ve haber verme süresi dağılımı | “Anomali tespitinin başarısı” kriterine sayı ile cevap. | K4
P2 | Compose sertleştirme (mTLS, ACL, proxy) | On-premise güvenlik iddiasının arkasını doldurur. | K2
P3 | expect_flags sözleşme açıkları | STALE, SENSOR_DRIFT ve DE_ENERGISED bayrakları senaryonun vaat ettiği gibi kurulmuyor. | K4
P3 | Ucuz kartla canlı sıcaklık demosu | Tek kardeş çiftinde gerçek θ göstermek, jüride en çok konuşulacak an olur. | K1
P3 | TimescaleDB sürücüsü | Bugün yalnız SQLite var. Kapsam dışı bırakılması da kabul edilebilir; belgede dürüstçe yazılı. | K2
P3 | BOM fiyatlarının tazelenmesi | Maliyet-fayda belgesinin güncel kalması. | K1

Kapsam dışı bırakmaktan korkmayalım

Belge paketinin her bölümünde bir “Belgelendi, kodlanmadı” tablosu var ve bu bizim en güçlü yanlarımızdan biri. Yetişmeyen bir maddeyi gizlemek yerine oraya yazmak, jüride puan kaybettirmiyor; tam tersine mühendislik disiplini olarak okunuyor. Kural şu: yapılmayan hiçbir şey yapılmış gibi anlatılmaz.

# 4. Takım görev dağılımı

Dört iş paketi; her biri yaklaşık 6,5 iş günü. Paketler bilerek farklı dosyalara dokunacak şekilde ayrıldı, böylece aynı anda çalışırken çakışma olmaz. Tek ortak yüzey `panogoz/contracts/` klasörüdür ve oraya dokunmadan önce gruba haber verilir.

Paket | Kişi | Başlık | Ana teslimat | Gün
K1 | ____________ | Donanım ve uç düğüm | Jüriye gösterilebilir fiziksel modül dosyası ve hedef üzerinde derlenen firmware | 6,5
K2 | ____________ | Sunucu, entegrasyon ve ölçek | Gerçek broker üzerinde çalışan, sertleştirilmiş on-prem yığın ve ikinci SCADA protokolü | 6,5
K3 | ____________ | Monitoring ve operasyon deneyimi | Jürinin ekranda göreceği her şey; merkez ve saha için iki ayrı akış | 6,0
K4 | ____________ | Bildirim, doğrulama ve sunum | Telefonun gerçekten çalması ve sistemin doğruluğunun sayıyla savunulması | 6,5

# K1 · Donanım ve Uç Düğüm

Ana teslimat: jüriye gösterilebilir bir fiziksel modül dosyası ve gerçek hedef üzerinde derlenen firmware.

Bu paket bizim en açık yanımızı kapatıyor. Şartnamenin ilk iki maddesi doğrudan fiziksel modül ve elektronik dokümantasyon istiyor; bugün elimizde blok şema ve malzeme listesi var, çizim yok. Bu paket tamamen bağımsızdır: sunucu kodunun tek satırına dokunmadan ilerler.

# | Görev | Bitti sayılır | Gün

1.1 | KiCad şematiği: TC düğümü, IR/PD düğümü ve ağ geçidi kartı. Besleme, sensör arayüzleri, RF ön ucu, koruma elemanları. | Üç şematik sayfası PDF olarak dışa aktarılmış, ERC temiz, docs/03 ile bileşen bileşen eşleşiyor. | 2,0
1.2 | PCB yerleşimi ve 3D görünüm: kart ölçüleri, katman yığını, konnektör tablosu, anten açıklık alanı. | Her kart için üstten görünüm + 3D render PNG; kart ölçüleri kabin içi yerleşime uyuyor. | 1,5
1.3 | Mekanik: modülün 1600 kVA pano teknik çizimi üzerinde montaj yerleşimi; mıknatıs kaide, kablo yolu, erişim mesafesi. | Ölçülendirilmiş yerleşim görseli; “aşırı kablo yığını” kısıtına verilen cevap yazılı. | 1,0
1.4 | STM32WLE5CC hedef derlemesi: arm-none-eabi zinciri, `make target`, flash ve RAM kullanım raporu. | Derleme uyarısız; .map dosyasından flash/RAM kullanımı tabloya yazılmış. | 1,0
1.5 | Saha koşulları: yüksek/düşük sıcaklık, yoğun manyetik alan ve titreşim için alınan önlemlerin şemadaki karşılığı. | docs/03'teki önlem listesinin her satırı bir bileşene veya yerleşim kararına bağlanmış. | 0,5
1.6 | BOM tazeleme: güncel tedarikçi fiyatları, alternatif parçalar, tedarik süresi. | docs/02 ve docs/07'deki maliyet tabloları güncel fiyatlarla yeniden hesaplanmış. | 0,5
1.7 | OPSİYONEL — ucuz bir kart (Nucleo/ESP32) ve iki sıcaklık sensörüyle canlı θ demosu. | Tek kardeş çiftinde gerçek ölçümden θ hesaplanıyor ve arayüzde görünüyor. | 1,5

### Sahip olduğun dosyalar

firmware/ · docs/02-DONANIM-TASARIMI.md · docs/03-ELEKTRONIK-DOKUMANTASYON.md · yeni açılacak hardware/ klasörü (KiCad projesi, dışa aktarımlar)

### Bağımlılıkların

- Kanal listesi değişirse contracts/channels.py'den haberdar ol; başka bağımlılığın yok.
- Opsiyonel canlı demo yapılırsa K3 ile arayüzde tek bir pano kartı üzerinde anlaşın.

# K2 · Sunucu, Entegrasyon ve Ölçek

Ana teslimat: gerçek bir broker üzerinde çalışan, sertleştirilmiş on-premise yığın ve ikinci bir SCADA protokolü.

Bugün MQTT yolunu yalnız süreç içi bus ile ve Paho'nun yayın/ACK sınırını taklit eden testlerle gösteriyoruz. Gerçek Mosquitto üzerinde broker yeniden başlatması ve süreç yeniden başlatması test edilmedi. Bu paket taşıma, depolama ve entegrasyonun tamamını kapsar ve arayüze hiç dokunmaz.

# | Görev | Bitti sayılır | Gün

2.1 | Gerçek Mosquitto ile uçtan uca test: bağlanma, yeniden bağlanma, broker restart, süreç restart, outbox replay, duplicate düşürme. | Broker'ı öldürüp geri açan otomatik test yeşil; kayıp mesaj sıfır, tekrar mesaj sayılmış. | 2,0
2.2 | Compose sertleştirme: mTLS listener açık, cihaz başına ACL, ters vekil, gizli anahtar yönetimi, sağlık kontrolleri. | Anonim düz MQTT dinleyicisi kapalı; sertifikasız istemci reddediliyor (test ile). | 1,0
2.3 | IEC 60870-5-104 slave: nokta listesi ve IOA şeması hazır, sunucu yazılacak. Genel tarama, kendiliğinden bildirim, saat senkronu. | Bir 104 istemcisi bağlanıp nokta okuyor; test takımına eklendi. | 2,0
2.4 | 1000 pano yük testi ve kaynak ölçümü: CPU, RAM, disk, yazma hızı, algılama turu süresi. | Ölçüm tablosu docs/06'ya yazıldı; varsayım olan satırlar ölçüme dönüştü. | 1,0
2.5 | ICD ↔ Modbus haritası otomatik tutarlılık testi ve üçüncü taraf için CSV nokta listesi üretimi. | Belge ile kod ayrışırsa test düşüyor; CSV docs/ altına üretiliyor. | 0,5

### Sahip olduğun dosyalar

panogoz/bus/ · panogoz/store/ · panogoz/scada/ · panogoz/gateway/ · docker-compose.yml · Dockerfile · docs/01 · docs/06 · docs/PANOGOZ-ICD-v2.0.md

### Bağımlılıkların

- 104 sunucusu contracts/icd.py'deki nokta listesini okur; oraya kanal eklemen gerekirse gruba haber ver.
- Yük testi panogoz/api/runtime.py'yi ölçüm amaçlı çalıştırır ama değiştirmez; K3 aynı dosyanın arayüz tarafındadır.

# K3 · Monitoring ve Operasyon Deneyimi

Ana teslimat: jürinin ekranda göreceği her şey; merkez operasyon ve saha ekibi için iki ayrı akış.

Değerlendirme kriterlerinden biri doğrudan “kullanıcı ve operasyon deneyimi”. Ekranlarımız var ama saha ekibini yönlendiren akış eksik ve ayırt edici özelliğimiz olan “neden alarm verdim, neden vermedim” anlatısı ekranda yeterince güçlü değil. Bu paket tamamen arayüz tarafındadır.

# | Görev | Bitti sayılır | Gün

3.1 | Alarm konsolu: onay akışı, iş emri kartı, filtre ve sıralama, fırtına görünümü, kapatma gerekçesi. | Bir olay açılıştan onaya ve kapanışa kadar ekrandan tek başına yönetilebiliyor. | 1,5
3.2 | Kanıt ekranı: θ zaman serisi, CUSUM, değişim noktası işareti, kardeş karşılaştırma grafiği, bastırma gerekçeleri bir arada. | “Bu alarmı neden açtım” sorusu tek ekrandan, sayılarla cevaplanıyor. | 1,5
3.3 | Mobil / tablet görünümü: tek pano, tek bağlantı, konum ve iş emri; QR ile doğrudan bağlantı açılışı. | 400 px genişlikte yatay kaydırma yok; sahadaki telefonda okunuyor. | 1,0
3.4 | Bastırma ekranı ve SCADA register canlı görünümü cilası; register değerinin ekrandaki sayı ile aynı olduğunu gösteren eşleme. | Aynı büyüklük iki yerde gösteriliyor ve görsel olarak eşleştiriliyor. | 1,0
3.5 | Demo kontrol paneli: senaryo enjekte ve temizle, hız ayarı, sıfırlama; sunumda klavye kullanmadan yönetilebilir olsun. | Sunumu yapan kişi yalnız fareyle tüm senaryoları tetikleyebiliyor. | 0,5
3.6 | Ekran görüntülerinin yenilenmesi ve docs/08 demo senaryosuyla birebir eşlenmesi. | docs/ekran-goruntuleri güncel; her demo adımının karşılığı bir görsel. | 0,5

### Sahip olduğun dosyalar

frontend/ · panogoz/api/app.py · docs/08-DEMO-SENARYOSU.md · docs/ekran-goruntuleri/

### Bağımlılıkların

- Yeni bir alan göstermen gerekirse contracts/live.py'ye eklenmesi gerekir; bunu tek başına yapma, gruba söyle.
- K4'ün bildirim ekranı senin alarm konsolunun içinde yaşayacak; arayüzü birlikte kararlaştırın (yarım saatlik iş).

# K4 · Bildirim, Doğrulama ve Sunum

Ana teslimat: telefonun gerçekten çalması ve sistemin doğruluğunun sayıyla savunulabilmesi.

Şartname alarm bildirimini ayrı bir madde olarak istiyor ve bugün her şey simülasyon. Simülasyon kabul edilebilir, ama gerçek bir kanaldan giden tek bir mesaj tartışmayı bitirir. Bu paket ayrıca sunumun sahibi: en iyi sistem bile kötü anlatılırsa kaybeder.

# | Görev | Bitti sayılır | Gün

4.1 | Gerçek bildirim kanalı: WhatsApp Business API ya da on-premise kısıtına uygun bir alternatif; ayrıca gerçek GSM modem yolu. Seçim gerekçesi ve veri mahremiyeti değerlendirmesi yazılı olsun. | Bir KRİTİK olay gerçek bir telefona ulaşıyor ve onay mesajı sisteme geri dönüyor. | 2,0
4.2 | Eskalasyon: rota tanımı, onay token'ı, tekrar aralıkları, fırtına sınırı, sessize alma ve nöbet devri. | Her merdiven basamağı için test var; onaysız KRİTİK tekrar ediyor. | 1,0
4.3 | expect_flags sözleşme açıkları: STALE, SENSOR_DRIFT ve DE_ENERGISED bayrakları cihaz düzeyinde doğru kuruluyor mu? Kurulamıyorsa sözleşme gerçeğe çekilsin. | Yedi negatif senaryonun ilan ettiği her bayrak ya kuruluyor ya da sözleşmeden çıkarılmış. | 1,0
4.4 | Doğruluk sunumu: 17 senaryo × tespit matrisi, haber verme süresi dağılımı, yanlış alarm bütçesi, duyarlılık eğrisi. | Tek sayfalık bir tablo ve iki grafik; her sayı bir testten üretiliyor. | 1,0
4.5 | Sunum paketi: 15 dakikalık anlatı, slaytlar, demo videosu, jüri soru-cevap kartları, yedek plan (demo çökerse video). | Takım önünde bir kez prova edildi ve süre tutuldu. | 1,5

### Sahip olduğun dosyalar

panogoz/notify/ · panogoz/rules/ · panogoz/detector/engine.py (yalnız bayrak bölümü) · tests/ · docs/04-ANOMALI-TESPIT.md · sunum/ (yeni klasör)

### Bağımlılıkların

- Sunum videosunun çekilebilmesi için K3'ün demo kontrol panelinin (3.5) hazır olması iyi olur; olmazsa mevcut arayüzle de çekilebilir.
- Gerçek bildirim kanalı seçimi on-premise kısıtını ilgilendirir; kararı gruba danış, tek başına verme.

# 5. Kilometre taşları

Gün numaraları göreceli. Takım kendi teslim tarihine göre G+0'ı belirlesin.

Zaman | Ne biter | Kim | Kanıtı
G+1 sonu | Herkes kendi paketinin ilk görevine başlamış, ortam kurulu | Hepsi | Kısa yazılı durum mesajı
G+2 sonu | Şematik taslağı · Mosquitto testi yeşil · alarm konsolu akışı · bildirim kanalı seçimi yapılmış | K1 K2 K3 K4 | Ekran görüntüsü / test çıktısı
G+4 sonu | PCB yerleşimi · 104 slave okuyor · kanıt ekranı hazır · gerçek bildirim gitmiş | K1 K2 K3 K4 | Her paketten bir demo
G+5 sonu | Mekanik yerleşim · yük testi · mobil görünüm · doğruluk matrisi | K1 K2 K3 K4 | Belgelere yazılmış
G+6 sonu | Tüm test takımı yeşil · belgeler güncel · özellik dondurma | Hepsi | pytest çıktısı ekte
G+7 | Tam prova: 15 dakika, süre tutularak, kesintisiz | K4 yönetir | Video kaydı

Özellik dondurma kuralı

G+6'dan sonra hiçbir yeni özellik eklenmez. O günden sonra yalnız hata düzeltme, belge güncelleme ve prova yapılır. Son gün eklenen özellik, sunumda çöken özelliktir.

# 6. Riskler ve karşılığı

Risk | Olasılık | Karşılığı
Demo makinede canlı sistem çöker | Orta | Önceden çekilmiş demo videosu hazır olacak (görev 4.5). Sunum videoyla tamamlanabilir.
KiCad öğrenme eğrisi K1'i yavaşlatır | Orta | Şematik önce, PCB sonra. Şematik tek başına da şartnamenin 2. maddesini büyük ölçüde karşılar.
WhatsApp API onayı yetişmez | Yüksek | Alternatif: gerçek GSM modem ile SMS, ya da kurumsal e-posta. Gerekçesi belgeye yazılır.
1000 pano testi makineyi kilitler | Düşük | Kademeli olarak 250 → 500 → 1000. Her kademe ayrı ölçüm; kilitlenirse son geçen kademe raporlanır.
İki kişi aynı dosyayı değiştirir | Düşük | Dosya sahipliği §7'de yazılı. contracts/ dışında çakışma noktası bırakılmadı.
Son gün belgeler koddan geri kalır | Orta | G+6 dondurma günü aynı zamanda belge günü. Her paket kendi belgesini günceller.

# 7. Ortak çalışma kuralları

## 7.1 Dosya sahipliği

Alan | Sahip | Not
firmware/ · hardware/ · docs/02 · docs/03 | K1 | Tek başına karar verir
panogoz/bus · store · scada · gateway · compose · docs/01 · docs/06 | K2 | Tek başına karar verir
frontend/ · panogoz/api/app.py · docs/08 · ekran görüntüleri | K3 | Tek başına karar verir
panogoz/notify · panogoz/rules · tests/ · docs/04 · sunum/ | K4 | Tek başına karar verir
panogoz/contracts/ (channels, live, icd, assets, envelope) | ORTAK | Değiştirmeden önce gruba yaz. Burası ekran ile register'ın aynı sayıyı göstermesini sağlayan yer.
README.md · CLAUDE_CODE_DEVIR.md | ORTAK | Kendi bölümünü herkes günceller

## 7.2 Değişmez kurallar

- Önce kırmızı test. Bir hatayı düzeltmeden önce o hatayı gösteren testi yaz ve düştüğünü gör. Bu proje bu kuralla buraya geldi.
- `python -m pytest -q` yeşil olmadan hiçbir iş “bitti” sayılmaz.
- Yapılmayan hiçbir şey yapılmış gibi yazılmaz. Ölçülmeyen sayı “varsayım” olarak etiketlenir.
- Kendi paketinin belgesini kendin güncelle. Kod ile belge aynı gün değişir.
- Başkasının dosyasına dokunman gerekiyorsa önce sor. Beş dakikalık mesaj, yarım günlük çakışmayı önler.
- Günde bir kez, on dakikalık yazılı durum: dün ne bitti, bugün ne var, neye takıldım.

## 7.3 Sık kullanılacak komutlar

Amaç | Komut
Sistemi çalıştır | python -m panogoz.run_local --panels 112 --port 8080
Hızlı başlangıç (az pano) | python -m panogoz.run_local --panels 8 --backfill-days 20
Tüm gerileme takımı | python -m pytest -q
Kural katmanı kanıtı | python -m tests.test_rules
Dedektör kanıtı | python -m tests.test_detector
Uçtan uca kabul kapısı | python -m tests.test_integration
SCADA / Modbus | python -m tests.test_scada · python -m tests.test_modbus
Firmware ana bilgisayar derlemesi | cd firmware/node && make host && ./panogoz_node --selftest
Firmware enerji bütçesi | ./panogoz_node --scenario energy

Not: Windows'ta Türkçe çıktı için komutların başına PYTHONIOENCODING=utf-8 eklenmelidir.

# 8. Sunum ve demo kontrol listesi

Final sunumunda şartnamenin açıkça istediği yedi başlık. Her birinin sahibi belli olsun ki sunum sırasında kimse birbirini beklemesin.

# | Gösterilecek | Sahibi | Hazır mı?

1 | Fiziksel modül veya çalışan prototip | K1 | ☐
2 | Uçtan uca veri akışı (sensör → SCADA register) | K2 | ☐
3 | Monitoring ve SCADA ekranları | K3 | ☐
4 | Normal ve anormal çalışma senaryoları | K3 + K4 | ☐
5 | Alarm oluşması ve bildirim mekanizması | K4 | ☐
6 | Sistem mimarisi | K2 | ☐
7 | Gerçek saha uygulaması ve ölçeklendirme yaklaşımı | K1 + K2 | ☐
8 | Yedek plan: demo videosu hazır | K4 | ☐

Sunumda öne çıkaracağımız üç cümle

1) Sabit eşik ağustosu atlatacak kadar yüksek kurulur, dolayısıyla şubatta kördür; biz kardeşler arasındaki farkı ölçüyoruz ve yük ile mevsim sadeleşiyor. 2) Bastırma katmanı, alarm üretmediğimiz durumların gerekçesini de kaydeder; “78 derece okudun, neden söylemedin?” sorusunun cevabı ekranda hazır duruyor. 3) Sistem koruma yapmaz ve bunu açıkça söyler: ark açması SIL-2 donanımda yaklaşık bir milisaniyede gerçekleşir, biz gözler, konumlandırır, zaman damgalar ve haber veririz.
