hackathon-buke-team/grid-up/docs/ekran-goruntuleri/s1-filo.png

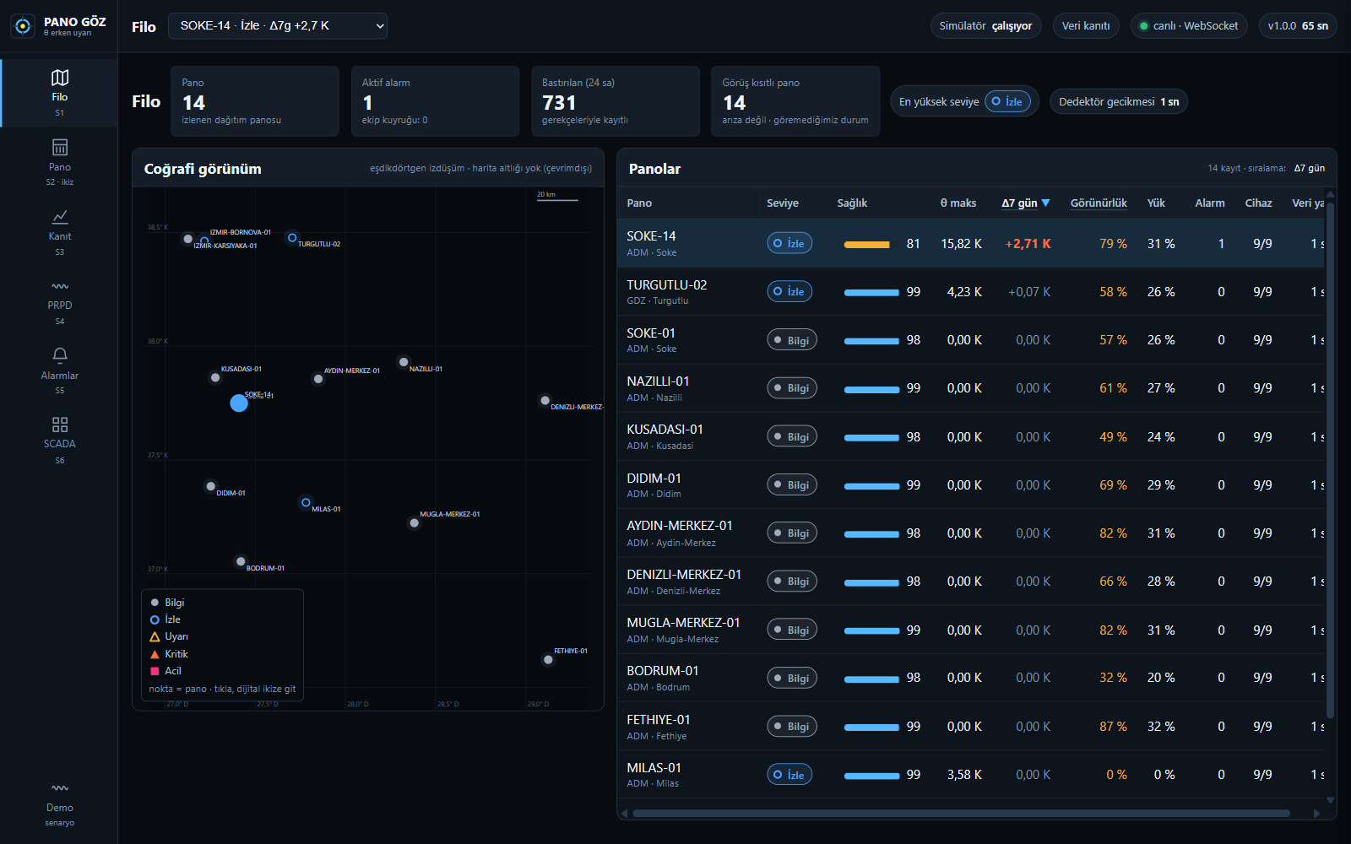
docs/ekran-goruntuleri/s1-filo.png
