hackathon-buke-team/grid-up/docs/ekran-goruntuleri/s2-dijital-ikiz.png

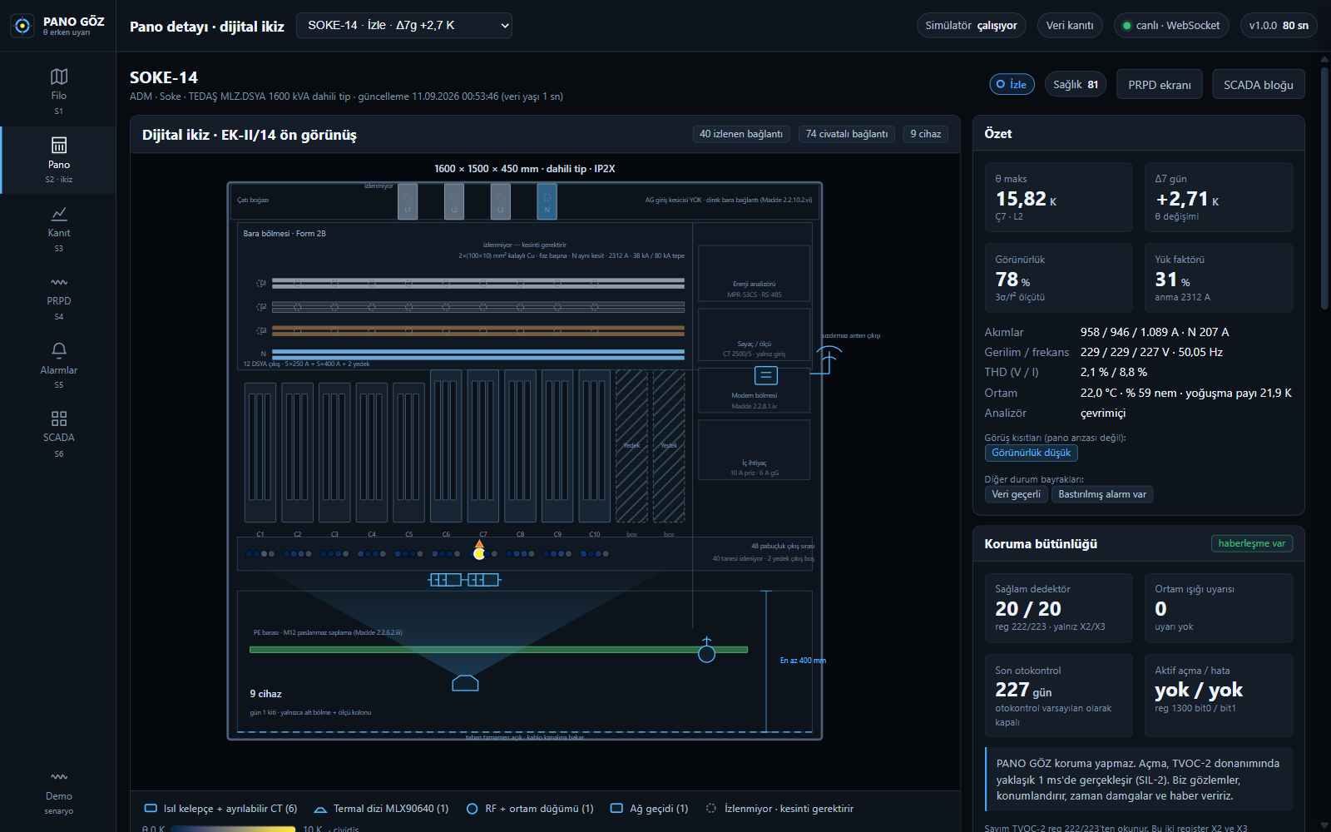
docs/ekran-goruntuleri/s2-dijital-ikiz.png
