hackathon-buke-team/grid-up/docs/ekran-goruntuleri/s3-kanit.png

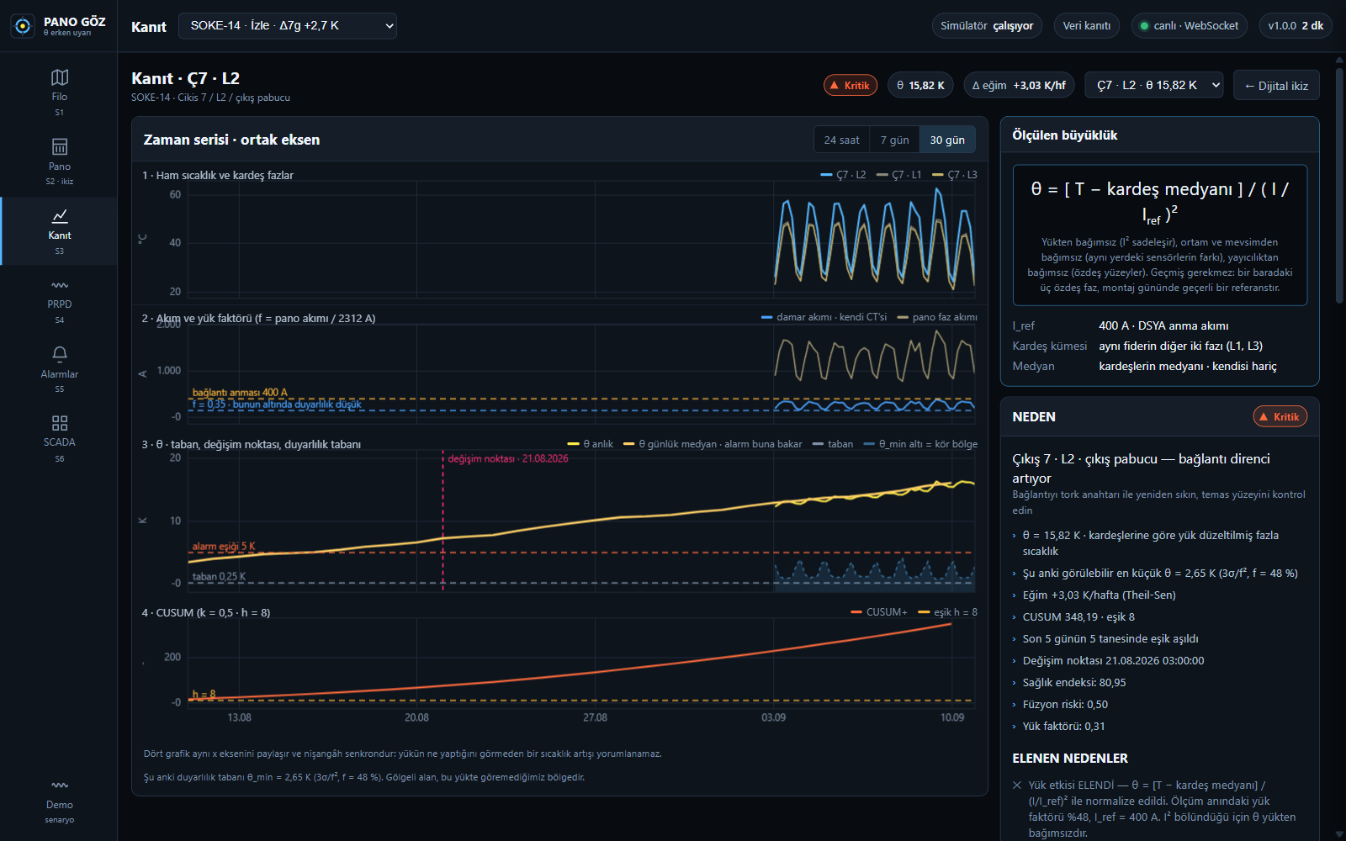
docs/ekran-goruntuleri/s3-kanit.png
