hackathon-buke-team/grid-up/docs/ekran-goruntuleri/s4-prpd.png

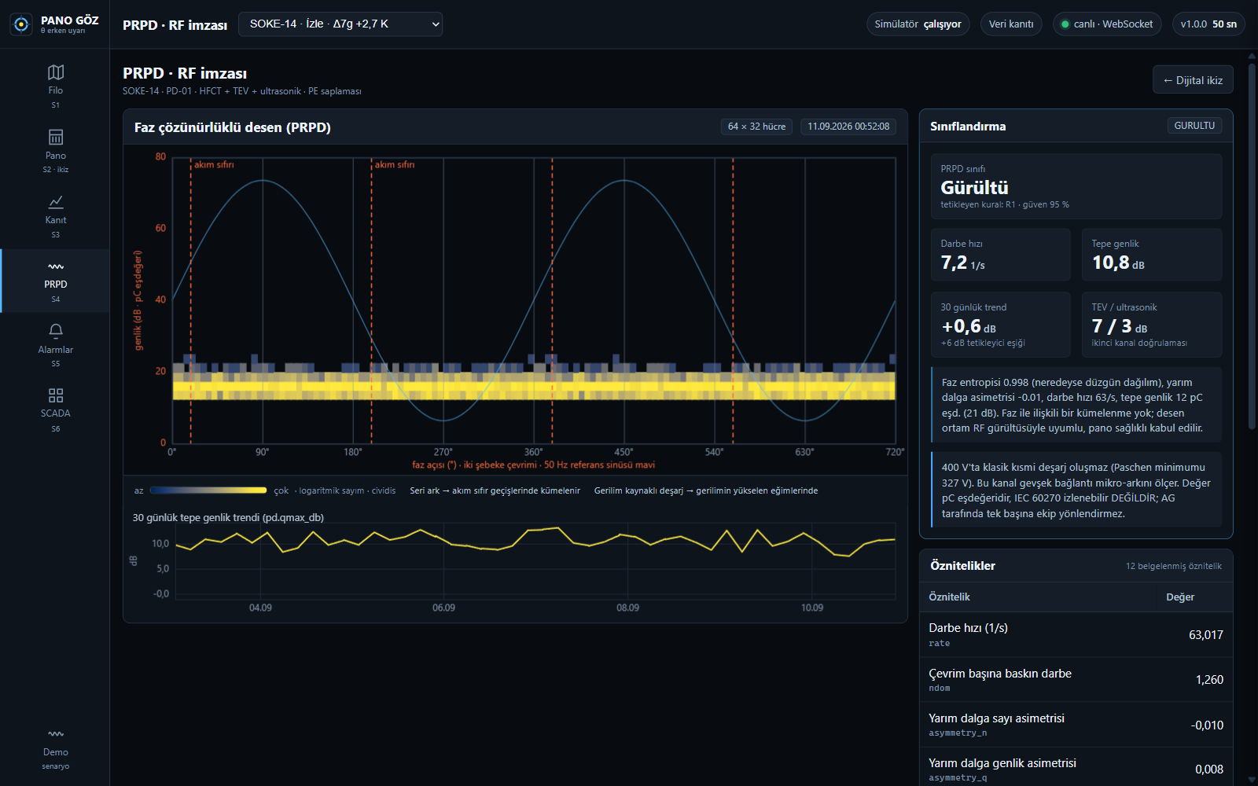
docs/ekran-goruntuleri/s4-prpd.png
