hackathon-buke-team/grid-up/docs/ekran-goruntuleri/s5-bastirilan.png

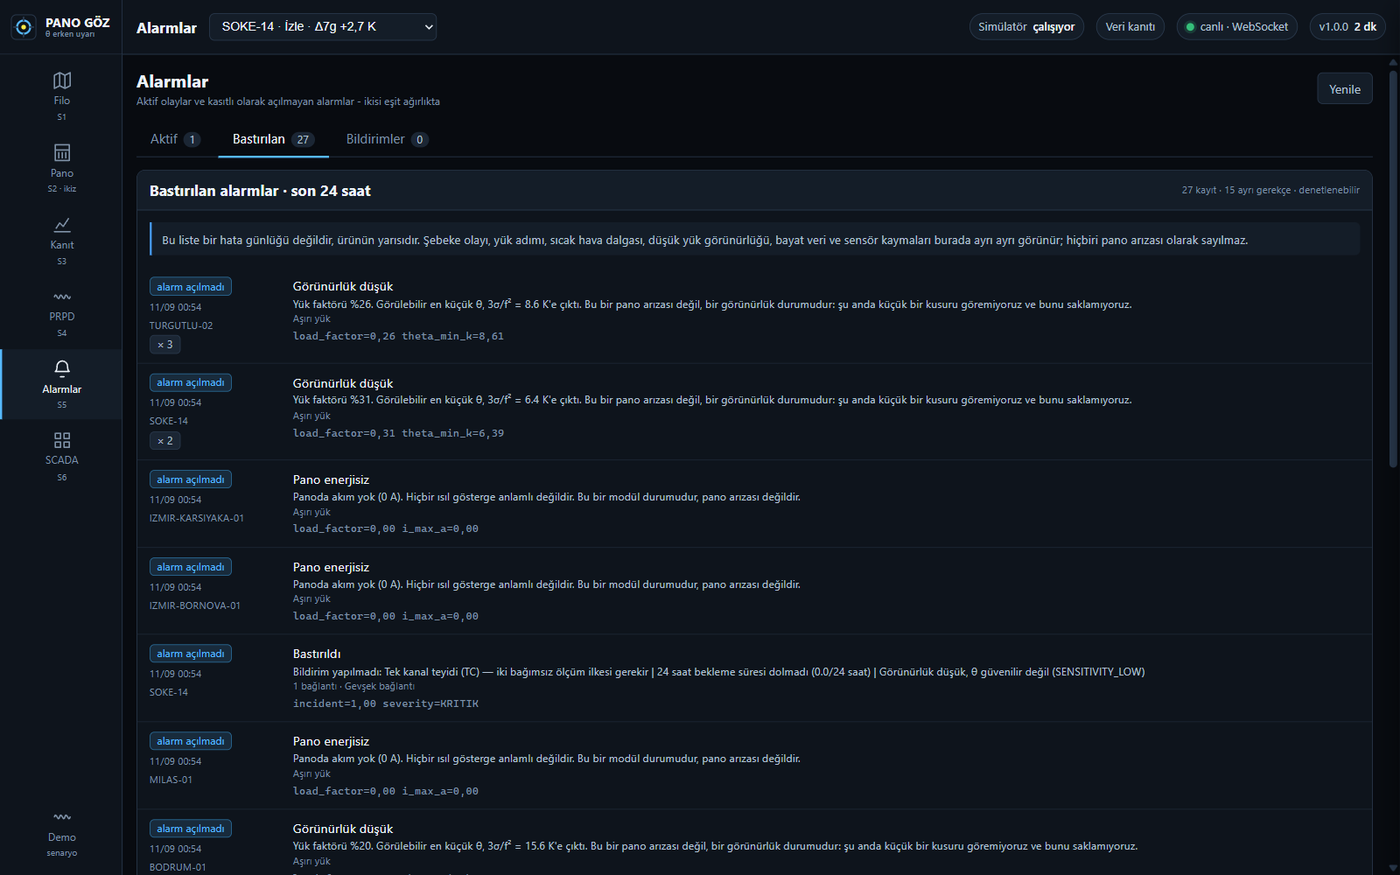
docs/ekran-goruntuleri/s5-bastirilan.png
