hackathon-buke-team/grid-up/docs/ekran-goruntuleri/s6-scada.png

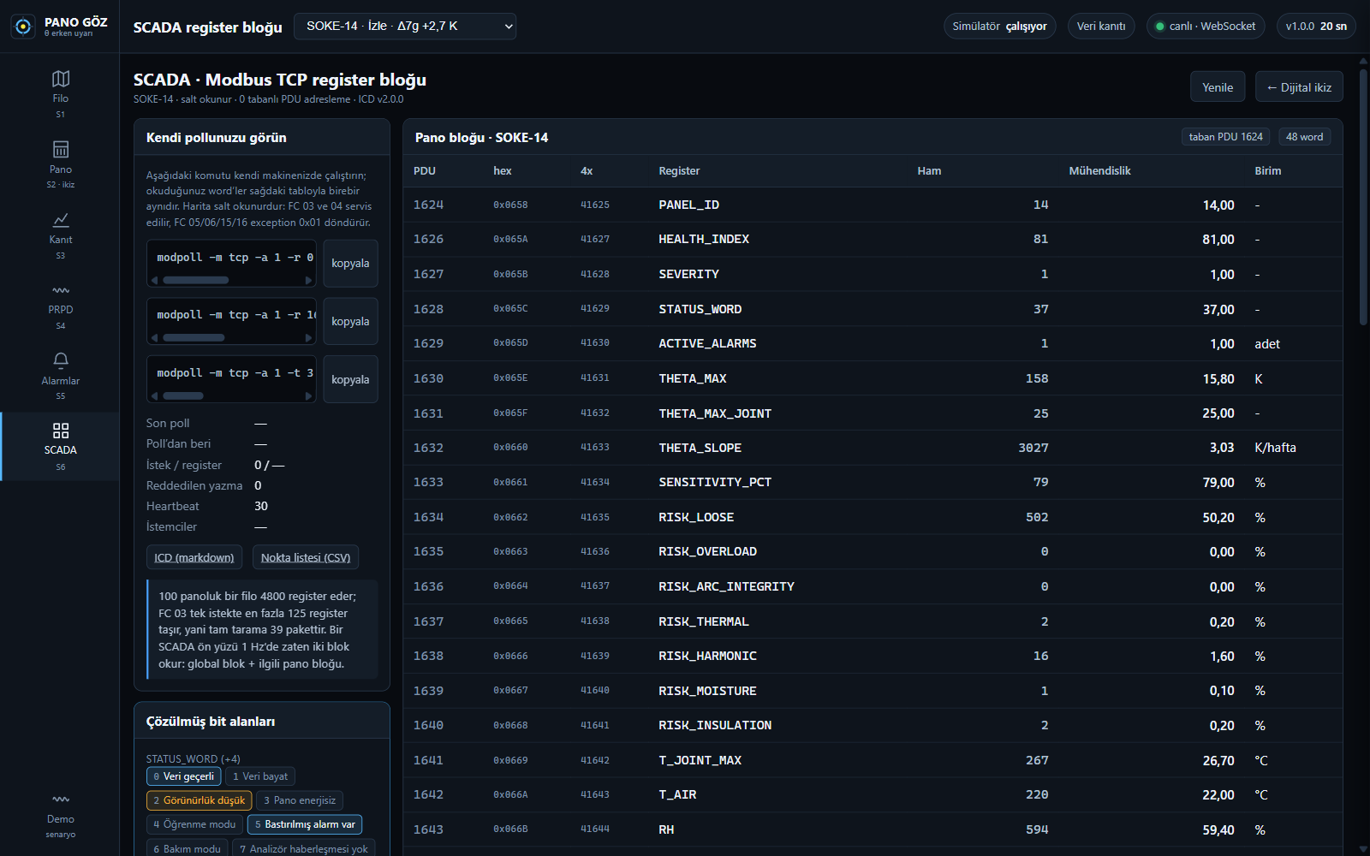
docs/ekran-goruntuleri/s6-scada.png
