hackathon-buke-team/grid-up/hardware/B1/GW/pcb-bottom.png

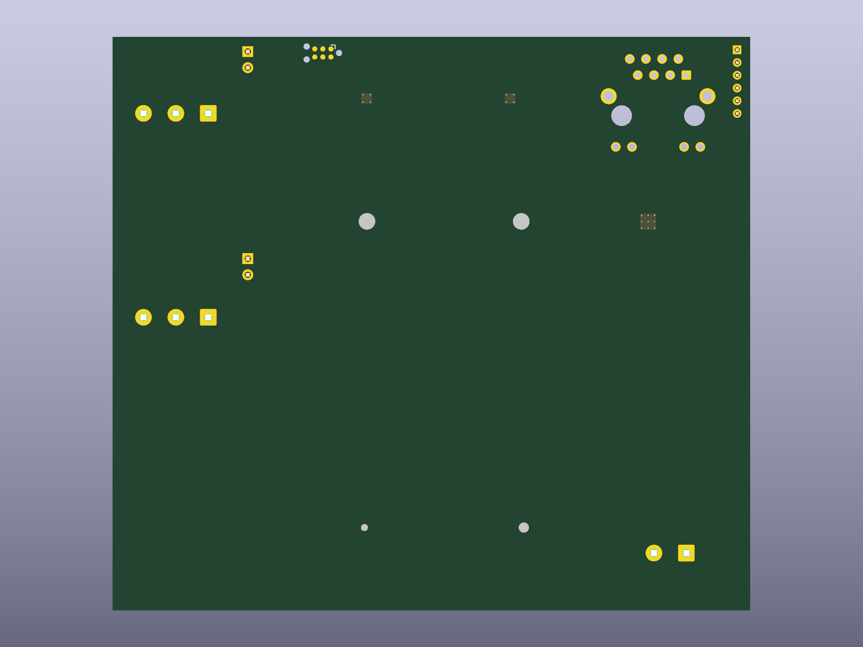
hardware/B1/GW/pcb-bottom.png
