hackathon-buke-team/grid-up/hardware/B1/GW/pcb-top.png

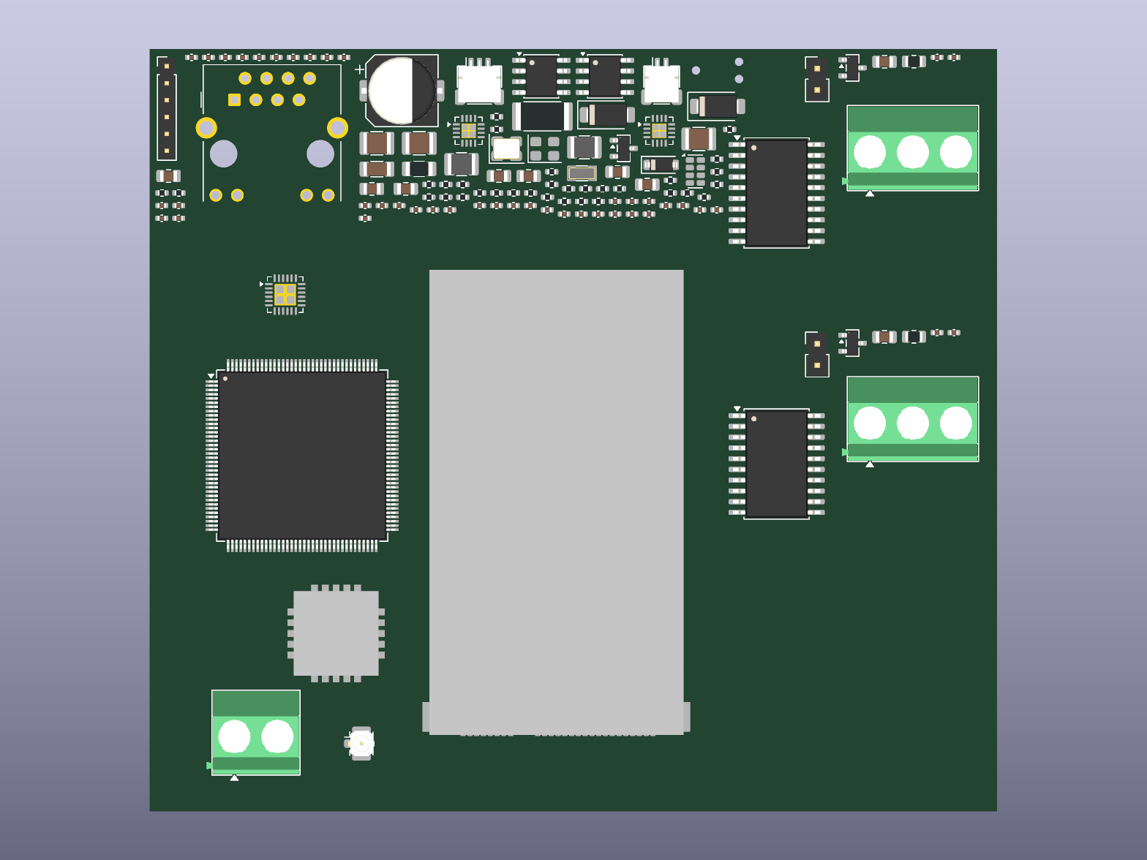
hardware/B1/GW/pcb-top.png
