hackathon-buke-team/grid-up/hardware/B1/IR/pcb-3d.png

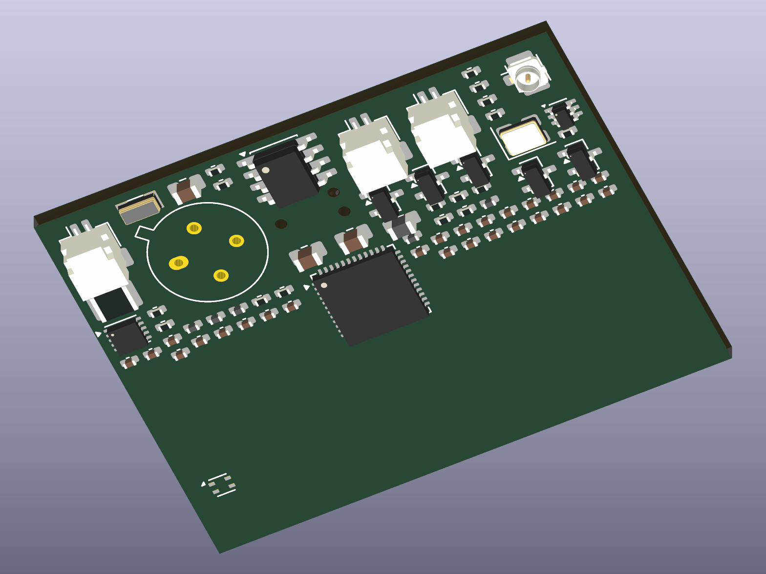
hardware/B1/IR/pcb-3d.png
