hackathon-buke-team/grid-up/hardware/B1/IR/pcb-bottom.png

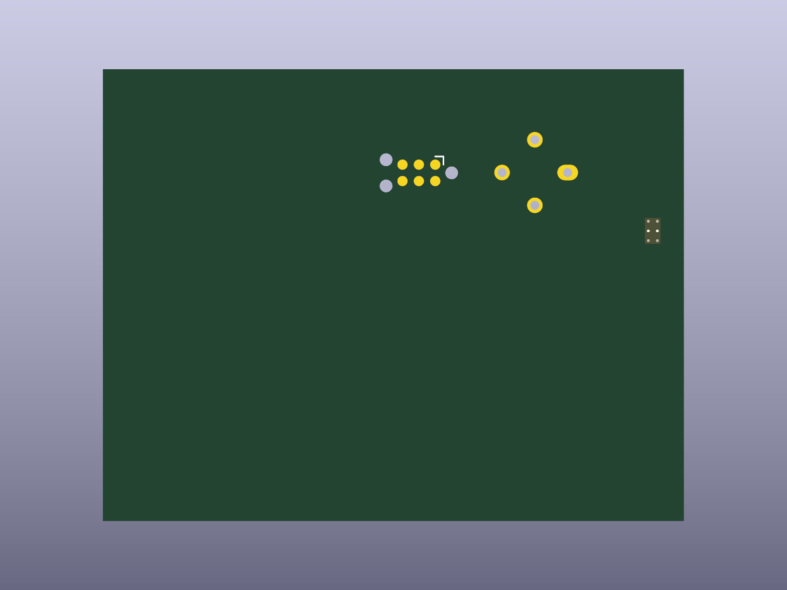
hardware/B1/IR/pcb-bottom.png
