hackathon-buke-team/grid-up/hardware/B1/IR/pcb-top.png

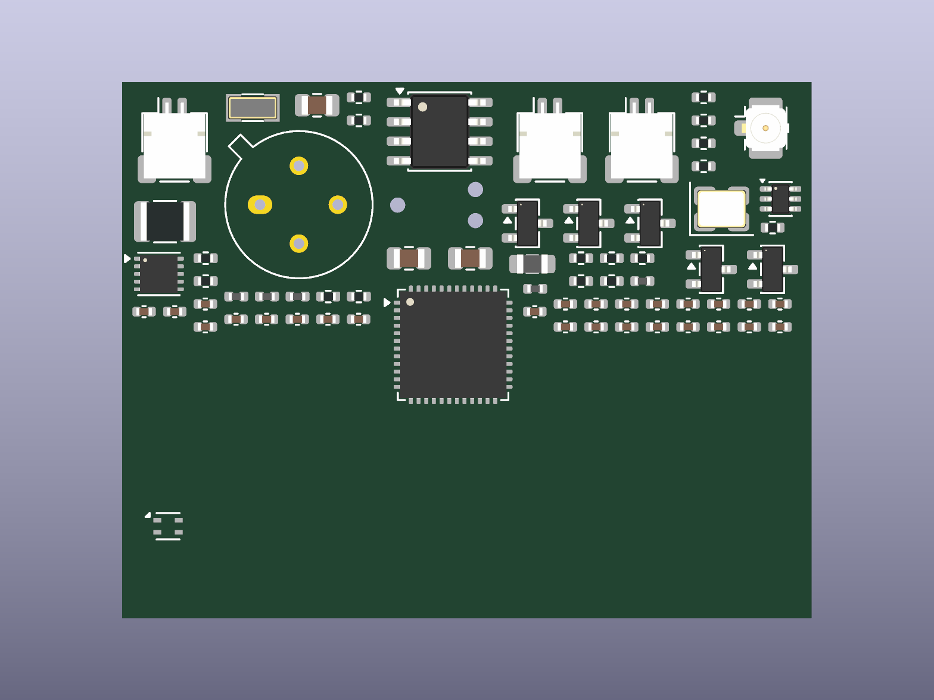
hardware/B1/IR/pcb-top.png
