hackathon-buke-team/grid-up/hardware/B1/mechanical/panel-reference.png

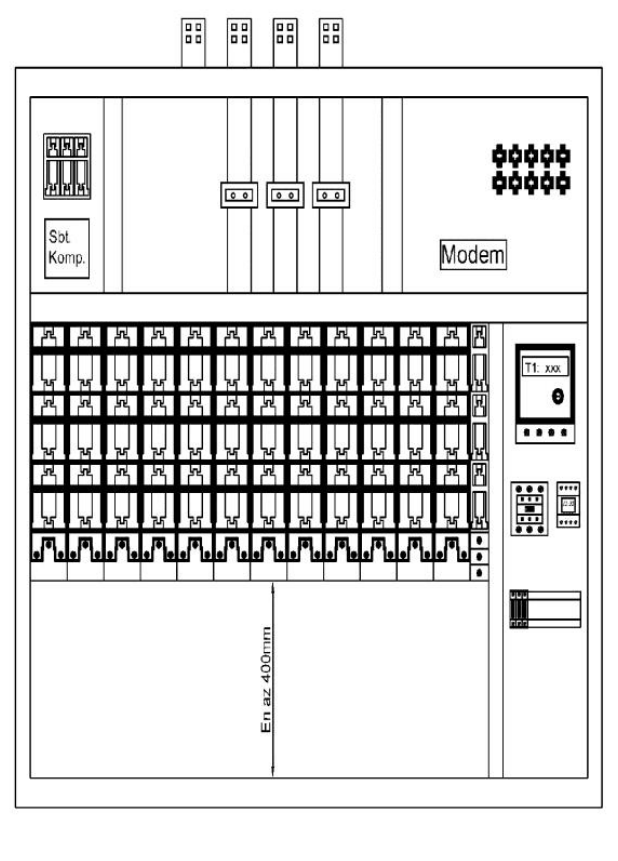
hardware/B1/mechanical/panel-reference.png
