hackathon-buke-team/grid-up/hardware/B1/PD/pcb-3d.png

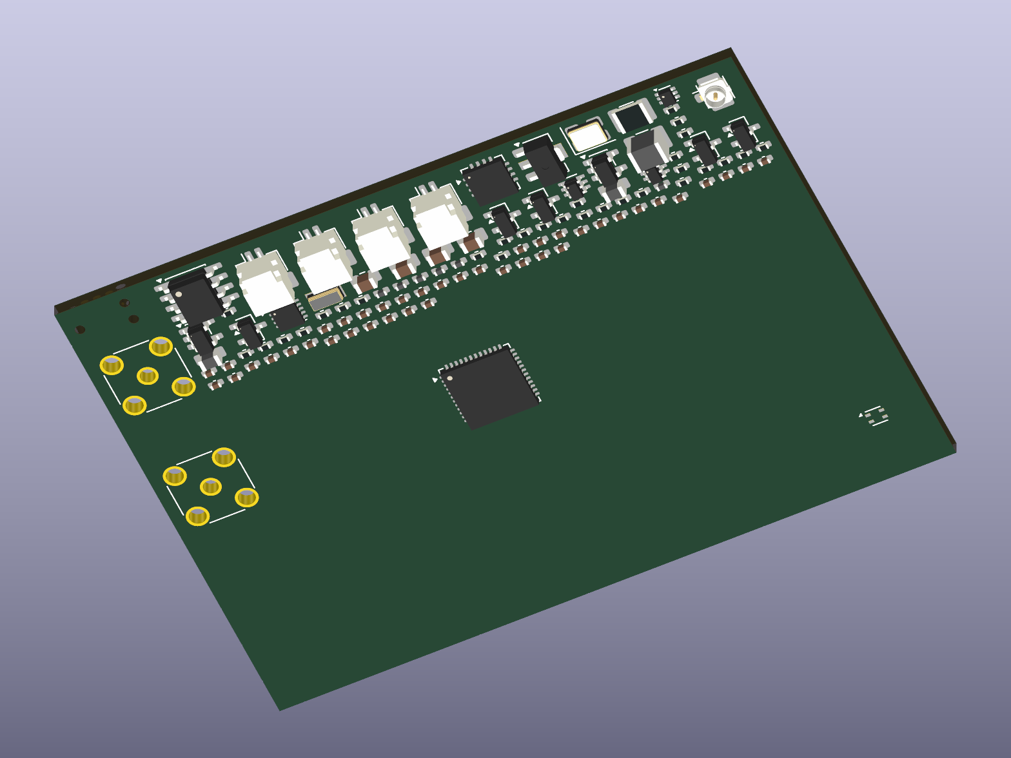
hardware/B1/PD/pcb-3d.png
