hackathon-buke-team/grid-up/hardware/B1/PD/pcb-bottom.png

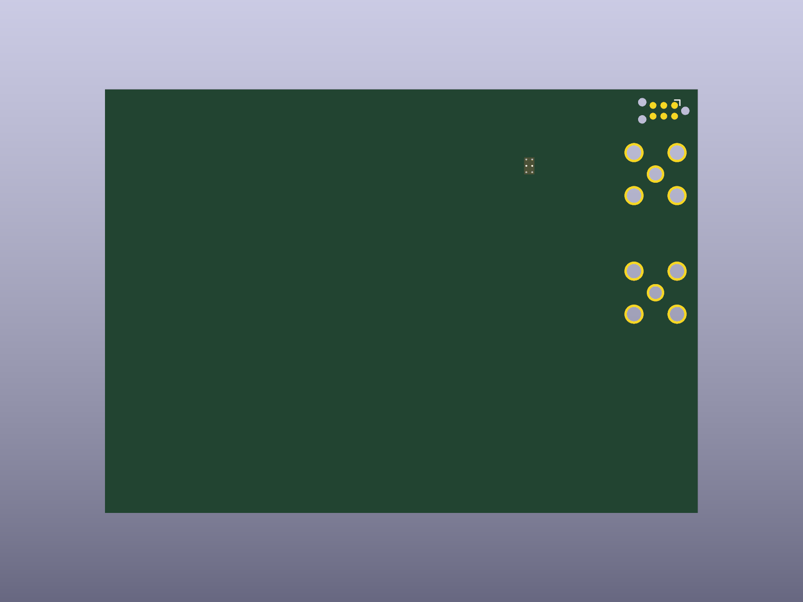
hardware/B1/PD/pcb-bottom.png
