hackathon-buke-team/grid-up/hardware/B1/PD/pcb-top.png

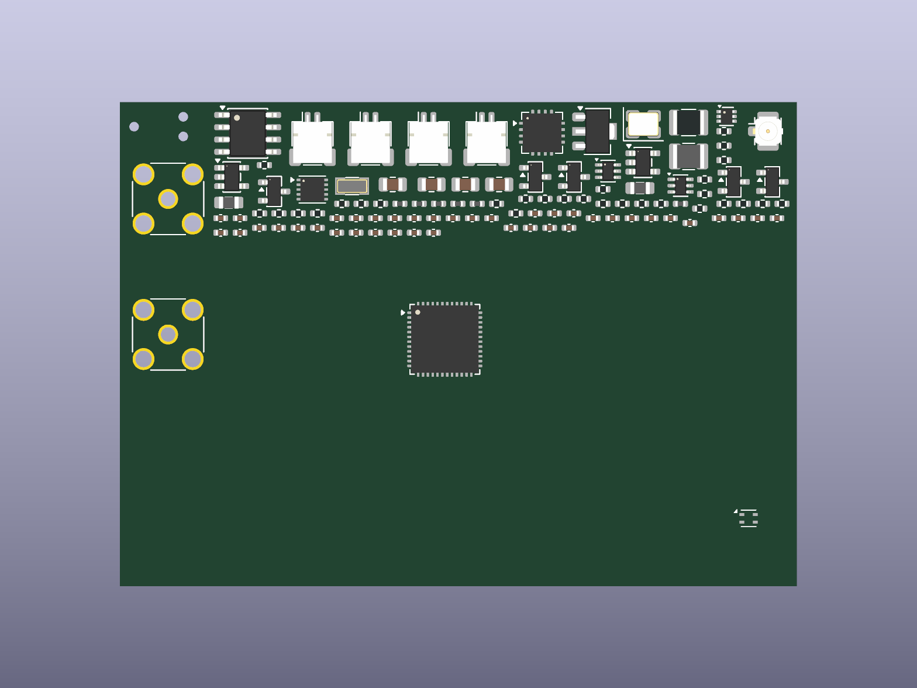
hardware/B1/PD/pcb-top.png
