hackathon-buke-team/grid-up/hardware/B1/TC/pcb-bottom.png

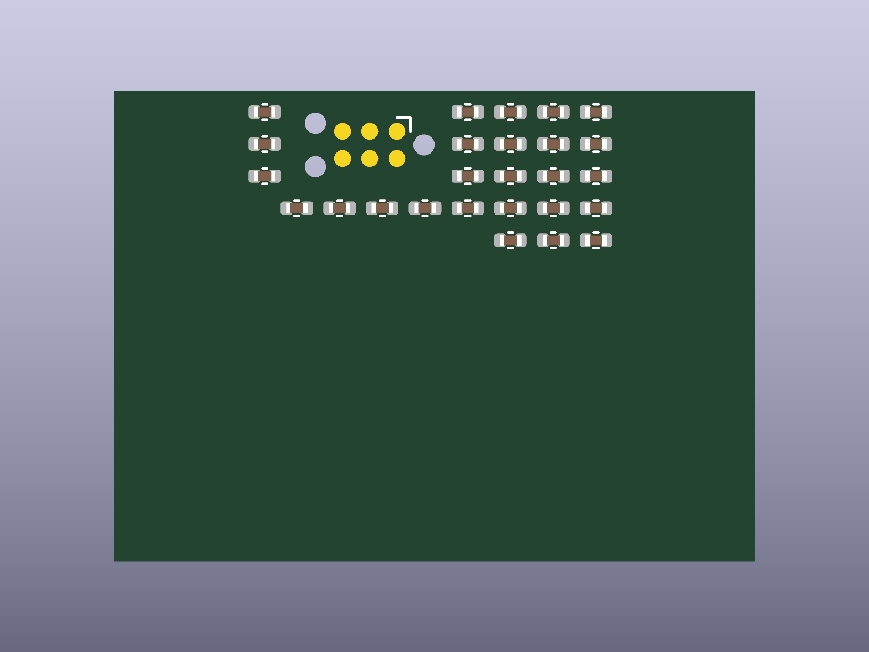
hardware/B1/TC/pcb-bottom.png
