hackathon-buke-team/grid-up/hardware/B1/TC/pcb-top.png

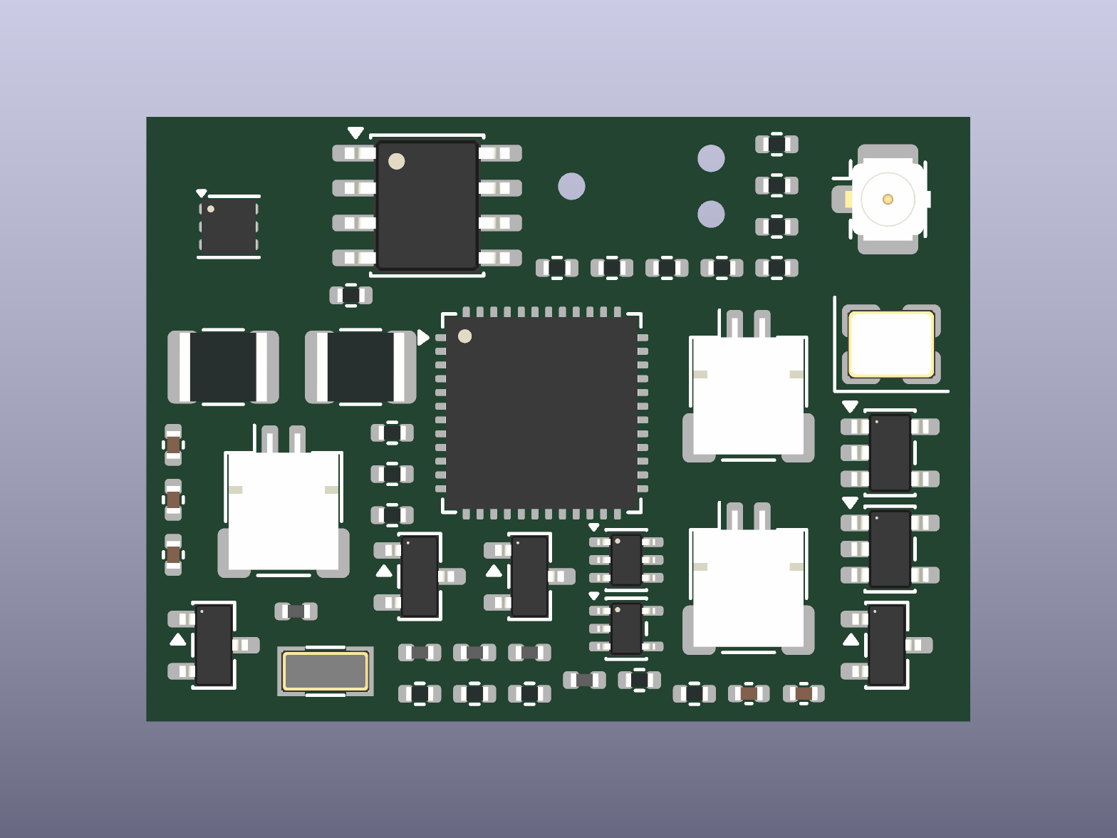
hardware/B1/TC/pcb-top.png
