hackathon-buke-team/grid-up/hardware/B1/BOM.md

# B1 mühendislik BOM ve fiyat kaydı

20.09.2026. Doğrulanmış fiyatı bulunan satırların kit ara toplamı **260.09 USD**. Bu, tam kit fiyatı değildir. Vergi, nakliye, üretim ve fiyatı bulunmayan satırlar hariçtir. Boş fiyat sıfır maliyet anlamına gelmez.

Toplam 214 satın alma satırı; 195 satır için teklif gerekiyor. Kesin maliyet/geri dönüş süresi ilan edilemez. Parça bazında kaynak, alternatif ve termin için `bom.json` esas alınır.

| Kart / ref | Parça veya mühendislik tanımı | Kit adet | Birim USD | Durum / kaynak |
|---|---|---:|---:|---|
| TC / J1 | CELL + HLC | 6 | teklif | DigiKey / Mouser RFQ |
| TC / U1 | TPS7A0230PDBVR | 6 | 0.84 | [DigiKey](https://www.digikey.com/en/products/detail/texas-instruments/TPS7A0230PDBVR/12165118) |
| TC / C1,C2,C13,C28,C30 | 1uF | 30 | teklif | DigiKey / Mouser RFQ |
| TC / Q1 | AO3401A | 6 | teklif | DigiKey / Mouser RFQ |
| TC / Q2,Q3 | 2N7002 | 12 | teklif | DigiKey / Mouser RFQ |
| TC / R1,R2,R18,R19 | 1M | 24 | teklif | DigiKey / Mouser RFQ |
| TC / R3,R4,R6,R9,R11,R16 | 100k | 36 | teklif | DigiKey / Mouser RFQ |
| TC / C3 | 10nF | 6 | teklif | DigiKey / Mouser RFQ |
| TC / R5 | 68R 0.5W | 6 | teklif | DigiKey / Mouser RFQ |
| TC / U10 | STM32WLE5CCU6 | 6 | 9.26 | [DigiKey](https://www.digikey.com/en/products/detail/stmicroelectronics/STM32WLE5CCU6/13557445) |
| TC / R7,R8 | 10k | 12 | teklif | DigiKey / Mouser RFQ |
| TC / C4,C5,C6,C7,C8,C11,C12,C16,C27,C31 | 100nF | 60 | teklif | DigiKey / Mouser RFQ |
| TC / J2 | SWD TC2030 | 6 | teklif | DigiKey / Mouser RFQ |
| TC / J3 | MOUNT switch | 6 | teklif | DigiKey / Mouser RFQ |
| TC / C9,C10 | 4.7uF | 12 | teklif | DigiKey / Mouser RFQ |
| TC / R10,R15 | 0R | 12 | teklif | DigiKey / Mouser RFQ |
| TC / Y1 | 32MHz CL=10pF | 6 | teklif | DigiKey / Mouser RFQ |
| TC / Y2 | 32.768kHz CL=6pF | 6 | teklif | DigiKey / Mouser RFQ |
| TC / C14,C15 | 6pF | 12 | teklif | DigiKey / Mouser RFQ |
| TC / U2 | MB85RS64V | 6 | teklif | DigiKey / Mouser RFQ |
| TC / R12,R13 | 4.7k | 12 | teklif | DigiKey / Mouser RFQ |
| TC / L1 | 47nH | 6 | teklif | DigiKey / Mouser RFQ |
| TC / C17,C29 | 47nF | 12 | teklif | DigiKey / Mouser RFQ |
| TC / C18,C22,C26 | 68pF | 18 | teklif | DigiKey / Mouser RFQ |
| TC / L2 | 4.4nH | 6 | teklif | DigiKey / Mouser RFQ |
| TC / C19 | 5.5pF | 6 | teklif | DigiKey / Mouser RFQ |
| TC / C20 | 2.5pF | 6 | teklif | DigiKey / Mouser RFQ |
| TC / L3 | 3.4nH | 6 | teklif | DigiKey / Mouser RFQ |
| TC / C21 | 4.3pF | 6 | teklif | DigiKey / Mouser RFQ |
| TC / L4 | 9.2nH | 6 | teklif | DigiKey / Mouser RFQ |
| TC / C23 | 3.5pF | 6 | teklif | DigiKey / Mouser RFQ |
| TC / C24 | 4.5pF | 6 | teklif | DigiKey / Mouser RFQ |
| TC / L5 | 12nH | 6 | teklif | DigiKey / Mouser RFQ |
| TC / C25 | 2.7pF | 6 | teklif | DigiKey / Mouser RFQ |
| TC / U3 | PE4259 | 6 | teklif | DigiKey / Mouser RFQ |
| TC / J4 | 868 MHz u.FL | 6 | teklif | DigiKey / Mouser RFQ |
| TC / U4 | TMP117AIDRVR | 6 | 5.56 | [DigiKey](https://www.digikey.com/en/products/detail/texas-instruments/TMP117AIDRVR/9685284) |
| TC / J5 | CT 3000:1 | 6 | teklif | DigiKey / Mouser RFQ |
| TC / R14 | 5.1R 0.1% 0.5W | 6 | teklif | DigiKey / Mouser RFQ |
| TC / R17 | 1k | 6 | teklif | DigiKey / Mouser RFQ |
| TC / U5 | OPA333AIDBVR | 6 | 2.60 | [DigiKey](https://www.digikey.com/en/products/detail/texas-instruments/OPA333AIDBVR/1572431) |
| TC / U6 | BAT54S | 6 | teklif | DigiKey / Mouser RFQ |
| TC / U7 | TLV3691IDCKR | 6 | 1.28 | [DigiKey](https://www.digikey.com/en/products/detail/texas-instruments/TLV3691IDCKR/4555468) |
| IR / J1 | CELL + HLC | 1 | teklif | DigiKey / Mouser RFQ |
| IR / U1 | TPS63900DSKR | 1 | 2.74 | [DigiKey](https://www.digikey.com/en/products/detail/texas-instruments/TPS63900DSKR/13535479) |
| IR / L1 | 2.2uH Isat>=1A | 1 | teklif | DigiKey / Mouser RFQ |
| IR / R1 | 36.5k | 1 | teklif | DigiKey / Mouser RFQ |
| IR / R2 | 16.2k | 1 | teklif | DigiKey / Mouser RFQ |
| IR / C1,C28 | 10uF | 2 | teklif | DigiKey / Mouser RFQ |
| IR / C2 | 22uF | 1 | teklif | DigiKey / Mouser RFQ |
| IR / Q1,Q4 | AO3401A | 2 | teklif | DigiKey / Mouser RFQ |
| IR / Q2,Q3,Q5 | 2N7002 | 3 | teklif | DigiKey / Mouser RFQ |
| IR / R3,R4 | 1M | 2 | teklif | DigiKey / Mouser RFQ |
| IR / R5,R6,R8,R11,R13,R16,R17 | 100k | 7 | teklif | DigiKey / Mouser RFQ |
| IR / C3 | 10nF | 1 | teklif | DigiKey / Mouser RFQ |
| IR / R7 | 68R 0.5W | 1 | teklif | DigiKey / Mouser RFQ |
| IR / U10 | STM32WLE5CCU6 | 1 | 9.26 | [DigiKey](https://www.digikey.com/en/products/detail/stmicroelectronics/STM32WLE5CCU6/13557445) |
| IR / R9,R10 | 10k | 2 | teklif | DigiKey / Mouser RFQ |
| IR / C4,C5,C6,C7,C8,C11,C12,C16,C27,C29 | 100nF | 10 | teklif | DigiKey / Mouser RFQ |
| IR / J2 | SWD TC2030 | 1 | teklif | DigiKey / Mouser RFQ |
| IR / J3 | MOUNT switch | 1 | teklif | DigiKey / Mouser RFQ |
| IR / C9,C10 | 4.7uF | 2 | teklif | DigiKey / Mouser RFQ |
| IR / R12 | 0R | 1 | teklif | DigiKey / Mouser RFQ |
| IR / C13 | 1uF | 1 | teklif | DigiKey / Mouser RFQ |
| IR / Y1 | 32MHz CL=10pF | 1 | teklif | DigiKey / Mouser RFQ |
| IR / Y2 | 32.768kHz CL=6pF | 1 | teklif | DigiKey / Mouser RFQ |
| IR / C14,C15 | 6pF | 2 | teklif | DigiKey / Mouser RFQ |
| IR / U2 | MB85RS64V | 1 | teklif | DigiKey / Mouser RFQ |
| IR / R14,R15 | 4.7k | 2 | teklif | DigiKey / Mouser RFQ |
| IR / L2 | 47nH | 1 | teklif | DigiKey / Mouser RFQ |
| IR / C17 | 47nF | 1 | teklif | DigiKey / Mouser RFQ |
| IR / C18,C22,C26 | 68pF | 3 | teklif | DigiKey / Mouser RFQ |
| IR / L3 | 4.4nH | 1 | teklif | DigiKey / Mouser RFQ |
| IR / C19 | 5.5pF | 1 | teklif | DigiKey / Mouser RFQ |
| IR / C20 | 2.5pF | 1 | teklif | DigiKey / Mouser RFQ |
| IR / L4 | 3.4nH | 1 | teklif | DigiKey / Mouser RFQ |
| IR / C21 | 4.3pF | 1 | teklif | DigiKey / Mouser RFQ |
| IR / L5 | 9.2nH | 1 | teklif | DigiKey / Mouser RFQ |
| IR / C23 | 3.5pF | 1 | teklif | DigiKey / Mouser RFQ |
| IR / C24 | 4.5pF | 1 | teklif | DigiKey / Mouser RFQ |
| IR / L6 | 12nH | 1 | teklif | DigiKey / Mouser RFQ |
| IR / C25 | 2.7pF | 1 | teklif | DigiKey / Mouser RFQ |
| IR / U3 | PE4259 | 1 | teklif | DigiKey / Mouser RFQ |
| IR / J4 | 868 MHz u.FL | 1 | teklif | DigiKey / Mouser RFQ |
| IR / U4 | MLX90640ESF-BAA-000-TU | 1 | 38.52 | [DigiKey](https://www.digikey.com/en/products/detail/melexis-technologies-nv/MLX90640ESF-BAA-000-TU/8638463) |
| IR / U5 | SHT41-AD1B-R2 | 1 | 2.95 | [DigiKey](https://www.digikey.com/en/products/detail/sensirion-ag/SHT41-AD1B-R2/15296591) |
| IR / J5 | PHASE optional | 1 | teklif | DigiKey / Mouser RFQ |
| PD / J1 | CELL + HLC | 1 | teklif | DigiKey / Mouser RFQ |
| PD / U1 | TPS63900DSKR | 1 | 2.74 | [DigiKey](https://www.digikey.com/en/products/detail/texas-instruments/TPS63900DSKR/13535479) |
| PD / L1 | 2.2uH Isat>=1A | 1 | teklif | DigiKey / Mouser RFQ |
| PD / R1 | 36.5k | 1 | teklif | DigiKey / Mouser RFQ |
| PD / R2 | 16.2k | 1 | teklif | DigiKey / Mouser RFQ |
| PD / C1,C27 | 10uF | 2 | teklif | DigiKey / Mouser RFQ |
| PD / C2,C28 | 22uF | 2 | teklif | DigiKey / Mouser RFQ |
| PD / Q1,Q4 | AO3401A | 2 | teklif | DigiKey / Mouser RFQ |
| PD / Q2,Q3,Q5 | 2N7002 | 3 | teklif | DigiKey / Mouser RFQ |
| PD / R3,R4 | 1M | 2 | teklif | DigiKey / Mouser RFQ |
| PD / R5,R6,R8,R11,R13,R17,R18,R23,R24,R25,R26,R27,R28,R29 | 100k | 14 | teklif | DigiKey / Mouser RFQ |
| PD / C3,C29,C30,C38,C42 | 10nF | 5 | teklif | DigiKey / Mouser RFQ |
| PD / R7 | 68R 0.5W | 1 | teklif | DigiKey / Mouser RFQ |
| PD / U10 | STM32WLE5CCU6 | 1 | 9.26 | [DigiKey](https://www.digikey.com/en/products/detail/stmicroelectronics/STM32WLE5CCU6/13557445) |
| PD / R9,R10,R30 | 10k | 3 | teklif | DigiKey / Mouser RFQ |
| PD / C4,C5,C6,C7,C8,C11,C12,C16,C31,C33,C37,C40,C41,C44 | 100nF | 14 | teklif | DigiKey / Mouser RFQ |
| PD / J2 | SWD TC2030 | 1 | teklif | DigiKey / Mouser RFQ |
| PD / J3 | MOUNT switch | 1 | teklif | DigiKey / Mouser RFQ |
| PD / C9,C10 | 4.7uF | 2 | teklif | DigiKey / Mouser RFQ |
| PD / R12 | 0R | 1 | teklif | DigiKey / Mouser RFQ |
| PD / C13,C43 | 1uF | 2 | teklif | DigiKey / Mouser RFQ |
| PD / Y1 | 32MHz CL=10pF | 1 | teklif | DigiKey / Mouser RFQ |
| PD / Y2 | 32.768kHz CL=6pF | 1 | teklif | DigiKey / Mouser RFQ |
| PD / C14,C15 | 6pF | 2 | teklif | DigiKey / Mouser RFQ |
| PD / U2 | MB85RS64V | 1 | teklif | DigiKey / Mouser RFQ |
| PD / R14,R15 | 4.7k | 2 | teklif | DigiKey / Mouser RFQ |
| PD / L2 | 47nH | 1 | teklif | DigiKey / Mouser RFQ |
| PD / C17 | 47nF | 1 | teklif | DigiKey / Mouser RFQ |
| PD / C18,C22,C26 | 68pF | 3 | teklif | DigiKey / Mouser RFQ |
| PD / L3 | 4.4nH | 1 | teklif | DigiKey / Mouser RFQ |
| PD / C19 | 5.5pF | 1 | teklif | DigiKey / Mouser RFQ |
| PD / C20 | 2.5pF | 1 | teklif | DigiKey / Mouser RFQ |
| PD / L4 | 3.4nH | 1 | teklif | DigiKey / Mouser RFQ |
| PD / C21 | 4.3pF | 1 | teklif | DigiKey / Mouser RFQ |
| PD / L5 | 9.2nH | 1 | teklif | DigiKey / Mouser RFQ |
| PD / C23 | 3.5pF | 1 | teklif | DigiKey / Mouser RFQ |
| PD / C24 | 4.5pF | 1 | teklif | DigiKey / Mouser RFQ |
| PD / L6 | 12nH | 1 | teklif | DigiKey / Mouser RFQ |
| PD / C25 | 2.7pF | 1 | teklif | DigiKey / Mouser RFQ |
| PD / U3,U5 | PE4259 | 2 | teklif | DigiKey / Mouser RFQ |
| PD / J4 | 868 MHz u.FL | 1 | teklif | DigiKey / Mouser RFQ |
| PD / U4 | TPS61023DRLR | 1 | 1.22 | [DigiKey](https://www.digikey.com/en/products/detail/texas-instruments/tps61023drlr/11310629) |
| PD / L7 | 1uH Isat>=4A | 1 | teklif | DigiKey / Mouser RFQ |
| PD / R16 | 732k | 1 | teklif | DigiKey / Mouser RFQ |
| PD / J5 | HFCT50 | 1 | teklif | DigiKey / Mouser RFQ |
| PD / R19,R20 | 49.9R | 2 | teklif | DigiKey / Mouser RFQ |
| PD / J6 | TEV plate | 1 | teklif | DigiKey / Mouser RFQ |
| PD / C32 | 100pF | 1 | teklif | DigiKey / Mouser RFQ |
| PD / L8 | 1uH | 1 | teklif | DigiKey / Mouser RFQ |
| PD / U6 | PGA-103+ | 1 | teklif | DigiKey / Mouser RFQ |
| PD / L9 | 1uH | 1 | teklif | DigiKey / Mouser RFQ |
| PD / C34,C35,C39 | 1nF | 3 | teklif | DigiKey / Mouser RFQ |
| PD / U7 | AD8318ACPZ | 1 | 18.85 | [DigiKey](https://www.digikey.com/en/products/detail/analog-devices-inc/AD8318ACPZ-REEL7/996044) |
| PD / C36 | 220pF | 1 | teklif | DigiKey / Mouser RFQ |
| PD / R21 | 499R | 1 | teklif | DigiKey / Mouser RFQ |
| PD / R22 | 1k | 1 | teklif | DigiKey / Mouser RFQ |
| PD / U8 | TLV3201AIDBVR | 1 | 1.41 | [DigiKey](https://www.digikey.com/en/products/detail/texas-instruments/TLV3201AIDBVR/3188691) |
| PD / U9 | SHT41-AD1B-R2 | 1 | 2.95 | [DigiKey](https://www.digikey.com/en/products/detail/sensirion-ag/SHT41-AD1B-R2/15296591) |
| PD / J7 | MA40S4R receiver | 1 | teklif | DigiKey / Mouser RFQ |
| PD / U11 | OPA320AIDBVR | 1 | 3.06 | [DigiKey](https://www.digikey.com/en/products/detail/texas-instruments/OPA320AIDBVR/2747429) |
| PD / J8 | ISOLATED 50Hz PHASE | 1 | teklif | DigiKey / Mouser RFQ |
| GW / J1 | 5V SELV 4A | 1 | teklif | DigiKey / Mouser RFQ |
| GW / F1 | 3.15A slow | 1 | teklif | DigiKey / Mouser RFQ |
| GW / Q1 | AO3401A | 1 | teklif | DigiKey / Mouser RFQ |
| GW / C1 | 100uF | 1 | teklif | DigiKey / Mouser RFQ |
| GW / U1,U2 | TPS62130RGTR | 2 | 1.99 | [DigiKey](https://www.digikey.com/en/products/detail/texas-instruments/TPS62130RGTR/2833429) |
| GW / L1,L2 | 2.2uH Isat>=4A | 2 | teklif | DigiKey / Mouser RFQ |
| GW / R1,R3 | 316k | 2 | teklif | DigiKey / Mouser RFQ |
| GW / R2,R4,R29,R30,R34,R35 | 100k | 6 | teklif | DigiKey / Mouser RFQ |
| GW / C2,C5,C57 | 10nF | 3 | teklif | DigiKey / Mouser RFQ |
| GW / C3,C6,C56 | 22uF | 3 | teklif | DigiKey / Mouser RFQ |
| GW / C4,C7 | 47uF | 2 | teklif | DigiKey / Mouser RFQ |
| GW / C8 | 470uF low ESR | 1 | teklif | DigiKey / Mouser RFQ |
| GW / U20 | STM32H563ZIT6 | 1 | 11.19 | [DigiKey](https://www.digikey.com/en/products/detail/stmicroelectronics/STM32H563ZIT6/18110508) |
| GW / C9,C10 | 2.2uF | 2 | teklif | DigiKey / Mouser RFQ |
| GW / C11,C12,C13,C14,C15,C16,C17,C18,C19,C20,C21,C22,C23,C24,C26,C31,C32,C33,C34,C36,C37,C38,C39,C40,C42,C43,C45,C46,C48,C49,C51,C52,C54 | 100nF | 33 | teklif | DigiKey / Mouser RFQ |
| GW / C25,C44,C47,C50,C53,C55 | 10uF | 6 | teklif | DigiKey / Mouser RFQ |
| GW / R5,R6,R7,R8,R11,R12,R13,R14,R15,R16,R17,R18,R21,R22,R24,R25,R27,R28,R32,R33 | 10k | 20 | teklif | DigiKey / Mouser RFQ |
| GW / Y1 | 25MHz CL=12pF | 1 | teklif | DigiKey / Mouser RFQ |
| GW / C27,C28 | 18pF | 2 | teklif | DigiKey / Mouser RFQ |
| GW / Y2 | 32.768kHz | 1 | teklif | DigiKey / Mouser RFQ |
| GW / C29,C30 | 6pF | 2 | teklif | DigiKey / Mouser RFQ |
| GW / J2 | SWD TC2030 | 1 | teklif | DigiKey / Mouser RFQ |
| GW / U3 | W25Q64JVSSIQ | 1 | teklif | DigiKey / Mouser RFQ |
| GW / U4 | APS6404L-3SQR-SN | 1 | teklif | DigiKey / Mouser RFQ |
| GW / U5 | RV-3028-C7 | 1 | teklif | DigiKey / Mouser RFQ |
| GW / J3 | RTC primary cell | 1 | teklif | DigiKey / Mouser RFQ |
| GW / R9,R10 | 4.7k | 2 | teklif | DigiKey / Mouser RFQ |
| GW / U6 | LAN8742A-CZ-TR | 1 | teklif | DigiKey / Mouser RFQ |
| GW / U7 | 50MHz 3V3 OSC | 1 | teklif | DigiKey / Mouser RFQ |
| GW / R19 | 12.1k 1% | 1 | teklif | DigiKey / Mouser RFQ |
| GW / C35 | 1uF | 1 | teklif | DigiKey / Mouser RFQ |
| GW / J4 | HR911105A | 1 | teklif | DigiKey / Mouser RFQ |
| GW / R20 | 1M | 1 | teklif | DigiKey / Mouser RFQ |
| GW / C41 | 1nF 2kV | 1 | teklif | DigiKey / Mouser RFQ |
| GW / U8,U10 | ADM2587EBRWZ | 2 | 17.36 | [DigiKey](https://www.digikey.com/en/products/detail/analog-devices-inc/ADM2587EBRWZ/2261070) |
| GW / J5 | MPR | 1 | teklif | DigiKey / Mouser RFQ |
| GW / U9,U11 | SM712 | 2 | teklif | DigiKey / Mouser RFQ |
| GW / R23,R26 | 120R | 2 | teklif | DigiKey / Mouser RFQ |
| GW / J6,J8 | TERM OPEN | 2 | teklif | DigiKey / Mouser RFQ |
| GW / J7 | TVOC | 1 | teklif | DigiKey / Mouser RFQ |
| GW / U12 | E22-900MM22S SX1262 | 1 | teklif | DigiKey / Mouser RFQ |
| GW / J9 | 868MHz antenna | 1 | teklif | DigiKey / Mouser RFQ |
| GW / U13 | EC21-E MiniPCIe SOCKET | 1 | teklif | DigiKey / Mouser RFQ |
| GW / J10 | SIM connector | 1 | teklif | DigiKey / Mouser RFQ |
| GW / D1,D2 | SS34 | 2 | teklif | DigiKey / Mouser RFQ |
| GW / D3 | BAT54 | 1 | teklif | DigiKey / Mouser RFQ |
| GW / R31 | 100R 1W | 1 | teklif | DigiKey / Mouser RFQ |
| GW / J11 | 2x10F 2.7V EDLC pack | 1 | teklif | DigiKey / Mouser RFQ |
| TC / EXTERNAL | CT 400 A / 3000:1 / split core / aperture >=32 mm | 6 | teklif | Custom CT supplier quote; captive secondary clamp 5.6 V and burden connector |
| TC / EXTERNAL | ER14250 3.6 V primary cell, 1.2 Ah envelope | 6 | teklif | EVE / Saft qualified equivalent; compare discharge limits |
| TC+PD / EXTERNAL | HLC pulse buffer <=16.5 x55 mm, compatible with Li-SOCl2 | 7 | teklif | Tadiran hybrid battery supplier; selection and pack qualification pending |
| IR / EXTERNAL | ER14505 3.6 V 2.6 Ah, pulse-rated assembled pack | 1 | teklif | EVE / Tadiran; IR inrush <= selected pack rating |
| PD / EXTERNAL | ER26500 3.6 V 8.5 Ah | 1 | teklif | EVE / Tadiran; buffer mandatory for RF front-end peaks |
| PD / EXTERNAL | HFCT50 | 1 | teklif | Power Diagnostix / authorized supplier; supplied DS_HFCT50_eng.pdf |
| PD / EXTERNAL | Insulated TEV capacitive plate assembly | 1 | teklif | Custom mechanical supplier; capacitance and transfer calibration pending |
| PD / EXTERNAL | MA40S4R 40 kHz receiver | 1 | teklif | Murata / authorized distributor |
| PD / EXTERNAL | Isolated 50 Hz voltage-phase reference, SELV 0..3.3 V output | 1 | teklif | Qualified external sensing accessory; never line voltage on header |
| GW / EXTERNAL | EC21-E MiniPCIe LTE modem (not bare LCC EC21) | 1 | teklif | Quectel authorized distributor; local bands/carrier approval check |
| GW / EXTERNAL | 5 V SELV 4 A isolated DIN power supply | 1 | teklif | Industrial certified PSU RFQ; no mains design on carrier |
| GW / EXTERNAL | 10 F / 2.7 V EDLC in enclosed series pack | 2 | teklif | Panasonic / Eaton; ESR/leakage/temperature data required |
| GW / EXTERNAL | Primary 3 V RTC backup cell, enclosed | 1 | teklif | No charging enabled in RV3028 configuration |
| ALL / EXTERNAL | Insulated 868 MHz antenna and captive coax | 9 | teklif | Antenna supplier; RF gain and mounting calibration |
| GW / EXTERNAL | LTE antenna + SIM holder + short USB/SIM harness | 1 | teklif | Quectel-compatible matched accessories |
| ALL / EXTERNAL | 6 TC +1 IR +1 PD +1 GW enclosure/mount/gasket set | 1 | teklif | Local prototype shop; STEP models, flame grade and tolerance quote |
| ALL / EXTERNAL | 4-layer PCB: 6 TC +1 IR +1 PD +1 GW; assembly | 1 | teklif | Board house RFQ AFTER routing, DRC and design release |
| ALL / EXTERNAL | Low-voltage cables, clamps, strain relief and labels | 1 | teklif | Lengths in mechanical document; assembly quote |

Pasifler için değer/paket/tolerans mühendislik şartıdır; `X7R 16V ...` veya `1% ...` sipariş edilebilir üretici kodu değildir. Satın alma BOM’u, eksik MPN ve teklifler tamamlanmadan serbest bırakılmayacaktır. RF kapasitörlerinde C0G ve yüksek Q, CT burden direncinde 0,1%/0,5 W zorunludur. Üretim katman yığını ve toleranslar üreticiyle onaylanmalıdır.
