hackathon-buke-team/grid-up/hardware/B1/GW/pinmap.csv

reference | MPN | physical_pin | pin_name | electrical_type | net
J1 | 5V SELV 4A | 1 | Pin_1 | passive | V5_IN
J1 | 5V SELV 4A | 2 | Pin_2 | passive | GND
F1 | 3.15A slow | 1 |  | passive | V5_IN
F1 | 3.15A slow | 2 |  | passive | V5_FUSED
Q1 | AO3401A | 1 | G | input | GND
Q1 | AO3401A | 2 | S | passive | V5
Q1 | AO3401A | 3 | D | passive | V5_FUSED
C1 | X7R 16V 100uF | 1 |  | passive | V5
C1 | X7R 16V 100uF | 2 |  | passive | GND
U1 | TPS62130RGTR | 1 | SW | output | SW_LOGIC
U1 | TPS62130RGTR | 2 | SW | passive | SW_LOGIC
U1 | TPS62130RGTR | 3 | SW | passive | SW_LOGIC
U1 | TPS62130RGTR | 4 | PG | open_collector | NC
U1 | TPS62130RGTR | 5 | FB | input | FB_LOGIC
U1 | TPS62130RGTR | 6 | GND | power_in | GND
U1 | TPS62130RGTR | 7 | FSW | input | GND
U1 | TPS62130RGTR | 8 | DEF | input | GND
U1 | TPS62130RGTR | 9 | SS/TR | input | SS_LOGIC
U1 | TPS62130RGTR | 10 | VIN | power_in | V5_HOLD
U1 | TPS62130RGTR | 11 | VIN | passive | V5_HOLD
U1 | TPS62130RGTR | 12 | VIN | passive | V5_HOLD
U1 | TPS62130RGTR | 13 | EN | input | V5_HOLD
U1 | TPS62130RGTR | 14 | VOS | input | V3V3
U1 | TPS62130RGTR | 15 | GND | passive | GND
U1 | TPS62130RGTR | 16 | GND | passive | GND
U1 | TPS62130RGTR | 17 | GND | passive | GND
L1 | 2.2uH Isat>=4A | 1 | 1 | passive | SW_LOGIC
L1 | 2.2uH Isat>=4A | 2 | 2 | passive | V3V3
R1 | 1% thick film 316k | 1 |  | passive | V3V3
R1 | 1% thick film 316k | 2 |  | passive | FB_LOGIC
R2 | 1% thick film 100k | 1 |  | passive | FB_LOGIC
R2 | 1% thick film 100k | 2 |  | passive | GND
C2 | X7R 16V 10nF | 1 |  | passive | SS_LOGIC
C2 | X7R 16V 10nF | 2 |  | passive | GND
C3 | X7R 16V 22uF | 1 |  | passive | V5
C3 | X7R 16V 22uF | 2 |  | passive | GND
C4 | X7R 16V 47uF | 1 |  | passive | V3V3
C4 | X7R 16V 47uF | 2 |  | passive | GND
U2 | TPS62130RGTR | 1 | SW | output | SW_LTE
U2 | TPS62130RGTR | 2 | SW | passive | SW_LTE
U2 | TPS62130RGTR | 3 | SW | passive | SW_LTE
U2 | TPS62130RGTR | 4 | PG | open_collector | NC
U2 | TPS62130RGTR | 5 | FB | input | FB_LTE
U2 | TPS62130RGTR | 6 | GND | power_in | GND
U2 | TPS62130RGTR | 7 | FSW | input | GND
U2 | TPS62130RGTR | 8 | DEF | input | GND
U2 | TPS62130RGTR | 9 | SS/TR | input | SS_LTE
U2 | TPS62130RGTR | 10 | VIN | power_in | V5
U2 | TPS62130RGTR | 11 | VIN | passive | V5
U2 | TPS62130RGTR | 12 | VIN | passive | V5
U2 | TPS62130RGTR | 13 | EN | input | V5
U2 | TPS62130RGTR | 14 | VOS | input | LTE_3V3
U2 | TPS62130RGTR | 15 | GND | passive | GND
U2 | TPS62130RGTR | 16 | GND | passive | GND
U2 | TPS62130RGTR | 17 | GND | passive | GND
L2 | 2.2uH Isat>=4A | 1 | 1 | passive | SW_LTE
L2 | 2.2uH Isat>=4A | 2 | 2 | passive | LTE_3V3
R3 | 1% thick film 316k | 1 |  | passive | LTE_3V3
R3 | 1% thick film 316k | 2 |  | passive | FB_LTE
R4 | 1% thick film 100k | 1 |  | passive | FB_LTE
R4 | 1% thick film 100k | 2 |  | passive | GND
C5 | X7R 16V 10nF | 1 |  | passive | SS_LTE
C5 | X7R 16V 10nF | 2 |  | passive | GND
C6 | X7R 16V 22uF | 1 |  | passive | V5
C6 | X7R 16V 22uF | 2 |  | passive | GND
C7 | X7R 16V 47uF | 1 |  | passive | LTE_3V3
C7 | X7R 16V 47uF | 2 |  | passive | GND
C8 | X7R 16V 470uF low ESR | 1 |  | passive | LTE_3V3
C8 | X7R 16V 470uF low ESR | 2 |  | passive | GND
U20 | STM32H563ZIT6 | 1 | PE2 | bidirectional | NC
U20 | STM32H563ZIT6 | 2 | PE3 | bidirectional | NC
U20 | STM32H563ZIT6 | 3 | PE4 | bidirectional | NC
U20 | STM32H563ZIT6 | 4 | PE5 | bidirectional | NC
U20 | STM32H563ZIT6 | 5 | PE6 | bidirectional | NC
U20 | STM32H563ZIT6 | 6 | VBAT | power_in | V3V3
U20 | STM32H563ZIT6 | 7 | PC13 | bidirectional | NC
U20 | STM32H563ZIT6 | 8 | PC14 | bidirectional | LSE_IN
U20 | STM32H563ZIT6 | 9 | PC15 | bidirectional | LSE_OUT
U20 | STM32H563ZIT6 | 10 | PF0 | bidirectional | RF_TXEN
U20 | STM32H563ZIT6 | 11 | PF1 | bidirectional | RF_RXEN
U20 | STM32H563ZIT6 | 12 | PF2 | bidirectional | FLASH_CS
U20 | STM32H563ZIT6 | 13 | PF3 | bidirectional | NC
U20 | STM32H563ZIT6 | 14 | PF4 | bidirectional | NC
U20 | STM32H563ZIT6 | 15 | PF5 | bidirectional | NC
U20 | STM32H563ZIT6 | 16 | VSS | power_in | GND
U20 | STM32H563ZIT6 | 17 | VDD | power_in | V3V3
U20 | STM32H563ZIT6 | 18 | PF6 | bidirectional | MEM_IO3
U20 | STM32H563ZIT6 | 19 | PF7 | bidirectional | MEM_IO2
U20 | STM32H563ZIT6 | 20 | PF8 | bidirectional | MEM_IO0
U20 | STM32H563ZIT6 | 21 | PF9 | bidirectional | MEM_IO1
U20 | STM32H563ZIT6 | 22 | PF10 | bidirectional | MEM_CLK
U20 | STM32H563ZIT6 | 23 | PH0 | bidirectional | HSE_IN
U20 | STM32H563ZIT6 | 24 | PH1 | bidirectional | HSE_OUT
U20 | STM32H563ZIT6 | 25 | NRST | input | NRST
U20 | STM32H563ZIT6 | 26 | PC0 | bidirectional | NC
U20 | STM32H563ZIT6 | 27 | PC1 | bidirectional | ETH_MDC
U20 | STM32H563ZIT6 | 28 | PC2 | bidirectional | NC
U20 | STM32H563ZIT6 | 29 | PC3 | bidirectional | NC
U20 | STM32H563ZIT6 | 30 | VDD | power_in | V3V3
U20 | STM32H563ZIT6 | 31 | VSSA | power_in | GND
U20 | STM32H563ZIT6 | 32 | VREF+ | input | V3V3
U20 | STM32H563ZIT6 | 33 | VDDA | power_in | V3V3
U20 | STM32H563ZIT6 | 34 | PA0 | bidirectional | PFAIL_ADC
U20 | STM32H563ZIT6 | 35 | PA1 | bidirectional | ETH_CLK50
U20 | STM32H563ZIT6 | 36 | PA2 | bidirectional | ETH_MDIO
U20 | STM32H563ZIT6 | 37 | PA3 | bidirectional | NC
U20 | STM32H563ZIT6 | 38 | VSS | passive | GND
U20 | STM32H563ZIT6 | 39 | VDD | power_in | V3V3
U20 | STM32H563ZIT6 | 40 | PA4 | bidirectional | RF_CS
U20 | STM32H563ZIT6 | 41 | PA5 | bidirectional | RF_SCK
U20 | STM32H563ZIT6 | 42 | PA6 | bidirectional | RF_MISO
U20 | STM32H563ZIT6 | 43 | PA7 | bidirectional | ETH_CRS
U20 | STM32H563ZIT6 | 44 | PC4 | bidirectional | ETH_RXD0
U20 | STM32H563ZIT6 | 45 | PC5 | bidirectional | ETH_RXD1
U20 | STM32H563ZIT6 | 46 | PB0 | bidirectional | RF_BUSY
U20 | STM32H563ZIT6 | 47 | PB1 | bidirectional | RF_DIO1
U20 | STM32H563ZIT6 | 48 | PB2 | bidirectional | RF_RST
U20 | STM32H563ZIT6 | 49 | PF11 | bidirectional | NC
U20 | STM32H563ZIT6 | 50 | PF12 | bidirectional | NC
U20 | STM32H563ZIT6 | 51 | VSS | passive | GND
U20 | STM32H563ZIT6 | 52 | VDD | power_in | V3V3
U20 | STM32H563ZIT6 | 53 | PF13 | bidirectional | NC
U20 | STM32H563ZIT6 | 54 | PF14 | bidirectional | NC
U20 | STM32H563ZIT6 | 55 | PF15 | bidirectional | NC
U20 | STM32H563ZIT6 | 56 | PG0 | bidirectional | NC
U20 | STM32H563ZIT6 | 57 | PG1 | bidirectional | NC
U20 | STM32H563ZIT6 | 58 | PE7 | bidirectional | NC
U20 | STM32H563ZIT6 | 59 | PE8 | bidirectional | NC
U20 | STM32H563ZIT6 | 60 | PE9 | bidirectional | NC
U20 | STM32H563ZIT6 | 61 | VSS | passive | GND
U20 | STM32H563ZIT6 | 62 | VDD | power_in | V3V3
U20 | STM32H563ZIT6 | 63 | PE10 | bidirectional | NC
U20 | STM32H563ZIT6 | 64 | PE11 | bidirectional | NC
U20 | STM32H563ZIT6 | 65 | PE12 | bidirectional | NC
U20 | STM32H563ZIT6 | 66 | PE13 | bidirectional | NC
U20 | STM32H563ZIT6 | 67 | PE14 | bidirectional | NC
U20 | STM32H563ZIT6 | 68 | PE15 | bidirectional | NC
U20 | STM32H563ZIT6 | 69 | PB10 | bidirectional | NC
U20 | STM32H563ZIT6 | 70 | VCAP | power_out | VCAP1
U20 | STM32H563ZIT6 | 71 | VSS | passive | GND
U20 | STM32H563ZIT6 | 72 | VDD | power_in | V3V3
U20 | STM32H563ZIT6 | 73 | PB12 | bidirectional | RS1_DE
U20 | STM32H563ZIT6 | 74 | PB13 | bidirectional | NC
U20 | STM32H563ZIT6 | 75 | PB14 | bidirectional | NC
U20 | STM32H563ZIT6 | 76 | PB15 | bidirectional | NC
U20 | STM32H563ZIT6 | 77 | PD8 | bidirectional | RS1_TX
U20 | STM32H563ZIT6 | 78 | PD9 | bidirectional | RS1_RX
U20 | STM32H563ZIT6 | 79 | PD10 | bidirectional | RS2_DE
U20 | STM32H563ZIT6 | 80 | PD11 | bidirectional | NC
U20 | STM32H563ZIT6 | 81 | PD12 | bidirectional | NC
U20 | STM32H563ZIT6 | 82 | PD13 | bidirectional | NC
U20 | STM32H563ZIT6 | 83 | VSS | passive | GND
U20 | STM32H563ZIT6 | 84 | VDD | power_in | V3V3
U20 | STM32H563ZIT6 | 85 | PD14 | bidirectional | NC
U20 | STM32H563ZIT6 | 86 | PD15 | bidirectional | NC
U20 | STM32H563ZIT6 | 87 | PG2 | bidirectional | NC
U20 | STM32H563ZIT6 | 88 | PG3 | bidirectional | NC
U20 | STM32H563ZIT6 | 89 | PG4 | bidirectional | NC
U20 | STM32H563ZIT6 | 90 | PG5 | bidirectional | NC
U20 | STM32H563ZIT6 | 91 | PG6 | bidirectional | NC
U20 | STM32H563ZIT6 | 92 | PG7 | bidirectional | NC
U20 | STM32H563ZIT6 | 93 | PG8 | bidirectional | NC
U20 | STM32H563ZIT6 | 94 | VSS | passive | GND
U20 | STM32H563ZIT6 | 95 | VDD | power_in | V3V3
U20 | STM32H563ZIT6 | 96 | PC6 | bidirectional | NC
U20 | STM32H563ZIT6 | 97 | PC7 | bidirectional | ETH_RST
U20 | STM32H563ZIT6 | 98 | PC8 | bidirectional | NC
U20 | STM32H563ZIT6 | 99 | PC9 | bidirectional | NC
U20 | STM32H563ZIT6 | 100 | PA8 | bidirectional | NC
U20 | STM32H563ZIT6 | 101 | PA9 | bidirectional | LTE_TX
U20 | STM32H563ZIT6 | 102 | PA10 | bidirectional | LTE_RX
U20 | STM32H563ZIT6 | 103 | PA11 | bidirectional | USB_DM
U20 | STM32H563ZIT6 | 104 | PA12 | bidirectional | USB_DP
U20 | STM32H563ZIT6 | 105 | PA13(JTMS | bidirectional | SWDIO
U20 | STM32H563ZIT6 | 106 | VDDUSB | power_in | V3V3
U20 | STM32H563ZIT6 | 107 | VSS | passive | GND
U20 | STM32H563ZIT6 | 108 | VDD | power_in | V3V3
U20 | STM32H563ZIT6 | 109 | PA14(JTCK | bidirectional | SWCLK
U20 | STM32H563ZIT6 | 110 | PA15(JTDI) | bidirectional | NC
U20 | STM32H563ZIT6 | 111 | PC10 | bidirectional | NC
U20 | STM32H563ZIT6 | 112 | PC11 | bidirectional | NC
U20 | STM32H563ZIT6 | 113 | PC12 | bidirectional | NC
U20 | STM32H563ZIT6 | 114 | PD0 | bidirectional | NC
U20 | STM32H563ZIT6 | 115 | PD1 | bidirectional | NC
U20 | STM32H563ZIT6 | 116 | PD2 | bidirectional | NC
U20 | STM32H563ZIT6 | 117 | PD3 | bidirectional | NC
U20 | STM32H563ZIT6 | 118 | PD4 | bidirectional | NC
U20 | STM32H563ZIT6 | 119 | PD5 | bidirectional | RS2_TX
U20 | STM32H563ZIT6 | 120 | VSS | passive | GND
U20 | STM32H563ZIT6 | 121 | VDDIO2 | power_in | V3V3
U20 | STM32H563ZIT6 | 122 | PD6 | bidirectional | RS2_RX
U20 | STM32H563ZIT6 | 123 | PD7 | bidirectional | NC
U20 | STM32H563ZIT6 | 124 | PG9 | bidirectional | RAM_CS
U20 | STM32H563ZIT6 | 125 | PG10 | bidirectional | NC
U20 | STM32H563ZIT6 | 126 | PG11 | bidirectional | ETH_TXEN
U20 | STM32H563ZIT6 | 127 | PG12 | bidirectional | NC
U20 | STM32H563ZIT6 | 128 | PG13 | bidirectional | ETH_TXD0
U20 | STM32H563ZIT6 | 129 | PG14 | bidirectional | ETH_TXD1
U20 | STM32H563ZIT6 | 130 | VSS | passive | GND
U20 | STM32H563ZIT6 | 131 | VDD | power_in | V3V3
U20 | STM32H563ZIT6 | 132 | PG15 | bidirectional | NC
U20 | STM32H563ZIT6 | 133 | PB3(JTDO | bidirectional | NC
U20 | STM32H563ZIT6 | 134 | PB4(NJTRST) | bidirectional | NC
U20 | STM32H563ZIT6 | 135 | PB5 | bidirectional | RF_MOSI
U20 | STM32H563ZIT6 | 136 | PB6 | bidirectional | GW_SCL
U20 | STM32H563ZIT6 | 137 | PB7 | bidirectional | GW_SDA
U20 | STM32H563ZIT6 | 138 | BOOT0 | input | BOOT0
U20 | STM32H563ZIT6 | 139 | PB8 | bidirectional | NC
U20 | STM32H563ZIT6 | 140 | PB9 | bidirectional | NC
U20 | STM32H563ZIT6 | 141 | PE0 | bidirectional | NC
U20 | STM32H563ZIT6 | 142 | VCAP | power_out | VCAP2
U20 | STM32H563ZIT6 | 143 | VSS | passive | GND
U20 | STM32H563ZIT6 | 144 | VDD | power_in | V3V3
C9 | X7R 16V 2.2uF | 1 |  | passive | VCAP1
C9 | X7R 16V 2.2uF | 2 |  | passive | GND
C10 | X7R 16V 2.2uF | 1 |  | passive | VCAP2
C10 | X7R 16V 2.2uF | 2 |  | passive | GND
C11 | X7R 16V 100nF | 1 |  | passive | V3V3
C11 | X7R 16V 100nF | 2 |  | passive | GND
C12 | X7R 16V 100nF | 1 |  | passive | V3V3
C12 | X7R 16V 100nF | 2 |  | passive | GND
C13 | X7R 16V 100nF | 1 |  | passive | V3V3
C13 | X7R 16V 100nF | 2 |  | passive | GND
C14 | X7R 16V 100nF | 1 |  | passive | V3V3
C14 | X7R 16V 100nF | 2 |  | passive | GND
C15 | X7R 16V 100nF | 1 |  | passive | V3V3
C15 | X7R 16V 100nF | 2 |  | passive | GND
C16 | X7R 16V 100nF | 1 |  | passive | V3V3
C16 | X7R 16V 100nF | 2 |  | passive | GND
C17 | X7R 16V 100nF | 1 |  | passive | V3V3
C17 | X7R 16V 100nF | 2 |  | passive | GND
C18 | X7R 16V 100nF | 1 |  | passive | V3V3
C18 | X7R 16V 100nF | 2 |  | passive | GND
C19 | X7R 16V 100nF | 1 |  | passive | V3V3
C19 | X7R 16V 100nF | 2 |  | passive | GND
C20 | X7R 16V 100nF | 1 |  | passive | V3V3
C20 | X7R 16V 100nF | 2 |  | passive | GND
C21 | X7R 16V 100nF | 1 |  | passive | V3V3
C21 | X7R 16V 100nF | 2 |  | passive | GND
C22 | X7R 16V 100nF | 1 |  | passive | V3V3
C22 | X7R 16V 100nF | 2 |  | passive | GND
C23 | X7R 16V 100nF | 1 |  | passive | V3V3
C23 | X7R 16V 100nF | 2 |  | passive | GND
C24 | X7R 16V 100nF | 1 |  | passive | V3V3
C24 | X7R 16V 100nF | 2 |  | passive | GND
C25 | X7R 16V 10uF | 1 |  | passive | V3V3
C25 | X7R 16V 10uF | 2 |  | passive | GND
R5 | 1% thick film 10k | 1 |  | passive | NRST
R5 | 1% thick film 10k | 2 |  | passive | V3V3
C26 | X7R 16V 100nF | 1 |  | passive | NRST
C26 | X7R 16V 100nF | 2 |  | passive | GND
R6 | 1% thick film 10k | 1 |  | passive | BOOT0
R6 | 1% thick film 10k | 2 |  | passive | GND
Y1 | 25MHz CL=12pF | 1 | 1 | passive | HSE_IN
Y1 | 25MHz CL=12pF | 2 | G | passive | GND
Y1 | 25MHz CL=12pF | 3 | 3 | passive | HSE_OUT
Y1 | 25MHz CL=12pF | 4 | G | passive | GND
C27 | X7R 16V 18pF | 1 |  | passive | HSE_IN
C27 | X7R 16V 18pF | 2 |  | passive | GND
C28 | X7R 16V 18pF | 1 |  | passive | HSE_OUT
C28 | X7R 16V 18pF | 2 |  | passive | GND
Y2 | 32.768kHz | 1 | 1 | passive | LSE_IN
Y2 | 32.768kHz | 2 | 2 | passive | LSE_OUT
C29 | X7R 16V 6pF | 1 |  | passive | LSE_IN
C29 | X7R 16V 6pF | 2 |  | passive | GND
C30 | X7R 16V 6pF | 1 |  | passive | LSE_OUT
C30 | X7R 16V 6pF | 2 |  | passive | GND
J2 | SWD TC2030 | 1 | Pin_1 | passive | V3V3
J2 | SWD TC2030 | 2 | Pin_2 | passive | SWDIO
J2 | SWD TC2030 | 3 | Pin_3 | passive | GND
J2 | SWD TC2030 | 4 | Pin_4 | passive | SWCLK
J2 | SWD TC2030 | 5 | Pin_5 | passive | NRST
J2 | SWD TC2030 | 6 | Pin_6 | passive | NC
U3 | W25Q64JVSSIQ | 1 | CS | input | FLASH_CS
U3 | W25Q64JVSSIQ | 2 | IO1 | bidirectional | MEM_IO1
U3 | W25Q64JVSSIQ | 3 | IO2 | bidirectional | MEM_IO2
U3 | W25Q64JVSSIQ | 4 | GND | power_in | GND
U3 | W25Q64JVSSIQ | 5 | IO0 | bidirectional | MEM_IO0
U3 | W25Q64JVSSIQ | 6 | CLK | input | MEM_CLK
U3 | W25Q64JVSSIQ | 7 | IO3 | bidirectional | MEM_IO3
U3 | W25Q64JVSSIQ | 8 | VCC | power_in | V3V3
R7 | 1% thick film 10k | 1 |  | passive | FLASH_CS
R7 | 1% thick film 10k | 2 |  | passive | V3V3
C31 | X7R 16V 100nF | 1 |  | passive | V3V3
C31 | X7R 16V 100nF | 2 |  | passive | GND
U4 | APS6404L-3SQR-SN | 1 | CS | input | RAM_CS
U4 | APS6404L-3SQR-SN | 2 | IO1 | bidirectional | MEM_IO1
U4 | APS6404L-3SQR-SN | 3 | IO2 | bidirectional | MEM_IO2
U4 | APS6404L-3SQR-SN | 4 | GND | power_in | GND
U4 | APS6404L-3SQR-SN | 5 | IO0 | bidirectional | MEM_IO0
U4 | APS6404L-3SQR-SN | 6 | CLK | input | MEM_CLK
U4 | APS6404L-3SQR-SN | 7 | IO3 | bidirectional | MEM_IO3
U4 | APS6404L-3SQR-SN | 8 | VCC | power_in | V3V3
R8 | 1% thick film 10k | 1 |  | passive | RAM_CS
R8 | 1% thick film 10k | 2 |  | passive | V3V3
C32 | X7R 16V 100nF | 1 |  | passive | V3V3
C32 | X7R 16V 100nF | 2 |  | passive | GND
U5 | RV-3028-C7 | 1 | CLKOUT | output | NC
U5 | RV-3028-C7 | 2 | ~{INT} | open_collector | NC
U5 | RV-3028-C7 | 3 | SCL | input | GW_SCL
U5 | RV-3028-C7 | 4 | SDA | bidirectional | GW_SDA
U5 | RV-3028-C7 | 5 | VSS | power_in | GND
U5 | RV-3028-C7 | 6 | VBACKUP | power_in | RTC_BACKUP
U5 | RV-3028-C7 | 7 | VDD | power_in | V3V3
U5 | RV-3028-C7 | 8 | EVI | input | GND
J3 | RTC primary cell | 1 | Pin_1 | passive | RTC_BACKUP
J3 | RTC primary cell | 2 | Pin_2 | passive | GND
C33 | X7R 16V 100nF | 1 |  | passive | V3V3
C33 | X7R 16V 100nF | 2 |  | passive | GND
R9 | 1% thick film 4.7k | 1 |  | passive | GW_SCL
R9 | 1% thick film 4.7k | 2 |  | passive | V3V3
R10 | 1% thick film 4.7k | 1 |  | passive | GW_SDA
R10 | 1% thick film 4.7k | 2 |  | passive | V3V3
U6 | LAN8742A-CZ-TR | 1 | VDD2A | power_in | V3V3
U6 | LAN8742A-CZ-TR | 2 | LED2/~{INTSEL} | bidirectional | PHY_INTSEL
U6 | LAN8742A-CZ-TR | 3 | LED1/REGOFF | bidirectional | PHY_REGOFF
U6 | LAN8742A-CZ-TR | 4 | XTAL2 | output | NC
U6 | LAN8742A-CZ-TR | 5 | XTAL1/CLKIN | input | ETH_CLK50
U6 | LAN8742A-CZ-TR | 6 | VDDCR | power_in | VDDCR
U6 | LAN8742A-CZ-TR | 7 | RXD1/MODE1 | bidirectional | ETH_RXD1
U6 | LAN8742A-CZ-TR | 8 | RXD0/MODE0 | bidirectional | ETH_RXD0
U6 | LAN8742A-CZ-TR | 9 | VDDIO | power_in | V3V3
U6 | LAN8742A-CZ-TR | 10 | RXER/PHYAD0 | output | PHY_ADDR
U6 | LAN8742A-CZ-TR | 11 | CRS_DV/MODE2 | bidirectional | ETH_CRS
U6 | LAN8742A-CZ-TR | 12 | MDIO | bidirectional | ETH_MDIO
U6 | LAN8742A-CZ-TR | 13 | MDC | input | ETH_MDC
U6 | LAN8742A-CZ-TR | 14 | ~{INT}/REFCLKO | output | NC
U6 | LAN8742A-CZ-TR | 15 | ~{RST} | input | ETH_RST
U6 | LAN8742A-CZ-TR | 16 | TXEN | input | ETH_TXEN
U6 | LAN8742A-CZ-TR | 17 | TXD0 | input | ETH_TXD0
U6 | LAN8742A-CZ-TR | 18 | TXD1 | input | ETH_TXD1
U6 | LAN8742A-CZ-TR | 19 | VDD1A | power_in | V3V3
U6 | LAN8742A-CZ-TR | 20 | TXN | passive | TXN
U6 | LAN8742A-CZ-TR | 21 | TXP | passive | TXP
U6 | LAN8742A-CZ-TR | 22 | RXN | passive | RXN
U6 | LAN8742A-CZ-TR | 23 | RXP | passive | RXP
U6 | LAN8742A-CZ-TR | 24 | RBIAS | passive | RBIAS
U6 | LAN8742A-CZ-TR | 25 | VSS | power_in | GND
U7 | 50MHz 3V3 OSC | 1 | OE | input | V3V3
U7 | 50MHz 3V3 OSC | 2 | GND | power_in | GND
U7 | 50MHz 3V3 OSC | 3 | OUT | output | ETH_CLK50
U7 | 50MHz 3V3 OSC | 4 | VDD | power_in | V3V3
C34 | X7R 16V 100nF | 1 |  | passive | V3V3
C34 | X7R 16V 100nF | 2 |  | passive | GND
R11 | 1% thick film 10k | 1 |  | passive | PHY_INTSEL
R11 | 1% thick film 10k | 2 |  | passive | V3V3
R12 | 1% thick film 10k | 1 |  | passive | PHY_REGOFF
R12 | 1% thick film 10k | 2 |  | passive | GND
R13 | 1% thick film 10k | 1 |  | passive | PHY_ADDR
R13 | 1% thick film 10k | 2 |  | passive | GND
R14 | 1% thick film 10k | 1 |  | passive | ETH_RXD0
R14 | 1% thick film 10k | 2 |  | passive | V3V3
R15 | 1% thick film 10k | 1 |  | passive | ETH_RXD1
R15 | 1% thick film 10k | 2 |  | passive | V3V3
R16 | 1% thick film 10k | 1 |  | passive | ETH_CRS
R16 | 1% thick film 10k | 2 |  | passive | V3V3
R17 | 1% thick film 10k | 1 |  | passive | ETH_MDIO
R17 | 1% thick film 10k | 2 |  | passive | V3V3
R18 | 1% thick film 10k | 1 |  | passive | ETH_RST
R18 | 1% thick film 10k | 2 |  | passive | V3V3
R19 | 1% thick film 12.1k 1% | 1 |  | passive | RBIAS
R19 | 1% thick film 12.1k 1% | 2 |  | passive | GND
C35 | X7R 16V 1uF | 1 |  | passive | VDDCR
C35 | X7R 16V 1uF | 2 |  | passive | GND
C36 | X7R 16V 100nF | 1 |  | passive | VDDCR
C36 | X7R 16V 100nF | 2 |  | passive | GND
C37 | X7R 16V 100nF | 1 |  | passive | V3V3
C37 | X7R 16V 100nF | 2 |  | passive | GND
C38 | X7R 16V 100nF | 1 |  | passive | V3V3
C38 | X7R 16V 100nF | 2 |  | passive | GND
C39 | X7R 16V 100nF | 1 |  | passive | V3V3
C39 | X7R 16V 100nF | 2 |  | passive | GND
J4 | HR911105A | 1 | TD+ | passive | TXP
J4 | HR911105A | 2 | TD- | passive | TXN
J4 | HR911105A | 3 | RD+ | passive | RXP
J4 | HR911105A | 4 | TCT | passive | ETH_CT
J4 | HR911105A | 5 | RCT | passive | ETH_CT
J4 | HR911105A | 6 | RD- | passive | RXN
J4 | HR911105A | 7 | NC | no_connect | NC
J4 | HR911105A | 8 |  | power_in | CHASSIS
J4 | HR911105A | 9 |  | passive | NC
J4 | HR911105A | 10 |  | passive | NC
J4 | HR911105A | 11 |  | passive | NC
J4 | HR911105A | 12 |  | passive | NC
J4 | HR911105A | SH |  | passive | CHASSIS
C40 | X7R 16V 100nF | 1 |  | passive | ETH_CT
C40 | X7R 16V 100nF | 2 |  | passive | GND
R20 | 1% thick film 1M | 1 |  | passive | CHASSIS
R20 | 1% thick film 1M | 2 |  | passive | GND
C41 | X7R 16V 1nF 2kV | 1 |  | passive | CHASSIS
C41 | X7R 16V 1nF 2kV | 2 |  | passive | GND
U8 | ADM2587EBRWZ | 1 | GND1 | power_in | GND
U8 | ADM2587EBRWZ | 2 | VCC | power_in | V3V3
U8 | ADM2587EBRWZ | 3 | GND1 | power_in | GND
U8 | ADM2587EBRWZ | 4 | RxD | output | RS1_RX
U8 | ADM2587EBRWZ | 5 | ~{RE} | input | RS1_DE
U8 | ADM2587EBRWZ | 6 | DE | input | RS1_DE
U8 | ADM2587EBRWZ | 7 | TxD | input | RS1_TX
U8 | ADM2587EBRWZ | 8 | VCC | power_in | V3V3
U8 | ADM2587EBRWZ | 9 | GND1 | power_in | GND
U8 | ADM2587EBRWZ | 10 | GND1 | power_in | GND
U8 | ADM2587EBRWZ | 11 | GND2 | power_in | ISO1_GND
U8 | ADM2587EBRWZ | 12 | Visoout | power_out | ISO1_V
U8 | ADM2587EBRWZ | 13 | Y | output | RS1_A
U8 | ADM2587EBRWZ | 14 | GND2 | power_in | ISO1_GND
U8 | ADM2587EBRWZ | 15 | Z | output | RS1_B
U8 | ADM2587EBRWZ | 16 | GND2 | power_in | ISO1_GND
U8 | ADM2587EBRWZ | 17 | B | input | RS1_B
U8 | ADM2587EBRWZ | 18 | A | input | RS1_A
U8 | ADM2587EBRWZ | 19 | Visoin | power_in | ISO1_V
U8 | ADM2587EBRWZ | 20 | GND2 | power_in | ISO1_GND
C42 | X7R 16V 100nF | 1 |  | passive | V3V3
C42 | X7R 16V 100nF | 2 |  | passive | GND
C43 | X7R 16V 100nF | 1 |  | passive | V3V3
C43 | X7R 16V 100nF | 2 |  | passive | GND
C44 | X7R 16V 10uF | 1 |  | passive | V3V3
C44 | X7R 16V 10uF | 2 |  | passive | GND
C45 | X7R 16V 100nF | 1 |  | passive | ISO1_V
C45 | X7R 16V 100nF | 2 |  | passive | ISO1_GND
C46 | X7R 16V 100nF | 1 |  | passive | ISO1_V
C46 | X7R 16V 100nF | 2 |  | passive | ISO1_GND
C47 | X7R 16V 10uF | 1 |  | passive | ISO1_V
C47 | X7R 16V 10uF | 2 |  | passive | ISO1_GND
R21 | 1% thick film 10k | 1 |  | passive | RS1_DE
R21 | 1% thick film 10k | 2 |  | passive | GND
R22 | 1% thick film 10k | 1 |  | passive | RS1_TX
R22 | 1% thick film 10k | 2 |  | passive | V3V3
J5 | MPR | 1 | Pin_1 | passive | RS1_A
J5 | MPR | 2 | Pin_2 | passive | RS1_B
J5 | MPR | 3 | Pin_3 | passive | ISO1_GND
U9 | SM712 | 1 | A | passive | RS1_A
U9 | SM712 | 2 | B | passive | RS1_B
U9 | SM712 | 3 | GND | passive | ISO1_GND
R23 | 1% thick film 120R | 1 |  | passive | RS1_A
R23 | 1% thick film 120R | 2 |  | passive | TERM1
J6 | TERM OPEN | 1 | Pin_1 | passive | TERM1
J6 | TERM OPEN | 2 | Pin_2 | passive | RS1_B
U10 | ADM2587EBRWZ | 1 | GND1 | power_in | GND
U10 | ADM2587EBRWZ | 2 | VCC | power_in | V3V3
U10 | ADM2587EBRWZ | 3 | GND1 | power_in | GND
U10 | ADM2587EBRWZ | 4 | RxD | output | RS2_RX
U10 | ADM2587EBRWZ | 5 | ~{RE} | input | RS2_DE
U10 | ADM2587EBRWZ | 6 | DE | input | RS2_DE
U10 | ADM2587EBRWZ | 7 | TxD | input | RS2_TX
U10 | ADM2587EBRWZ | 8 | VCC | power_in | V3V3
U10 | ADM2587EBRWZ | 9 | GND1 | power_in | GND
U10 | ADM2587EBRWZ | 10 | GND1 | power_in | GND
U10 | ADM2587EBRWZ | 11 | GND2 | power_in | ISO2_GND
U10 | ADM2587EBRWZ | 12 | Visoout | power_out | ISO2_V
U10 | ADM2587EBRWZ | 13 | Y | output | RS2_A
U10 | ADM2587EBRWZ | 14 | GND2 | power_in | ISO2_GND
U10 | ADM2587EBRWZ | 15 | Z | output | RS2_B
U10 | ADM2587EBRWZ | 16 | GND2 | power_in | ISO2_GND
U10 | ADM2587EBRWZ | 17 | B | input | RS2_B
U10 | ADM2587EBRWZ | 18 | A | input | RS2_A
U10 | ADM2587EBRWZ | 19 | Visoin | power_in | ISO2_V
U10 | ADM2587EBRWZ | 20 | GND2 | power_in | ISO2_GND
C48 | X7R 16V 100nF | 1 |  | passive | V3V3
C48 | X7R 16V 100nF | 2 |  | passive | GND
C49 | X7R 16V 100nF | 1 |  | passive | V3V3
C49 | X7R 16V 100nF | 2 |  | passive | GND
C50 | X7R 16V 10uF | 1 |  | passive | V3V3
C50 | X7R 16V 10uF | 2 |  | passive | GND
C51 | X7R 16V 100nF | 1 |  | passive | ISO2_V
C51 | X7R 16V 100nF | 2 |  | passive | ISO2_GND
C52 | X7R 16V 100nF | 1 |  | passive | ISO2_V
C52 | X7R 16V 100nF | 2 |  | passive | ISO2_GND
C53 | X7R 16V 10uF | 1 |  | passive | ISO2_V
C53 | X7R 16V 10uF | 2 |  | passive | ISO2_GND
R24 | 1% thick film 10k | 1 |  | passive | RS2_DE
R24 | 1% thick film 10k | 2 |  | passive | GND
R25 | 1% thick film 10k | 1 |  | passive | RS2_TX
R25 | 1% thick film 10k | 2 |  | passive | V3V3
J7 | TVOC | 1 | Pin_1 | passive | RS2_A
J7 | TVOC | 2 | Pin_2 | passive | RS2_B
J7 | TVOC | 3 | Pin_3 | passive | ISO2_GND
U11 | SM712 | 1 | A | passive | RS2_A
U11 | SM712 | 2 | B | passive | RS2_B
U11 | SM712 | 3 | GND | passive | ISO2_GND
R26 | 1% thick film 120R | 1 |  | passive | RS2_A
R26 | 1% thick film 120R | 2 |  | passive | TERM2
J8 | TERM OPEN | 1 | Pin_1 | passive | TERM2
J8 | TERM OPEN | 2 | Pin_2 | passive | RS2_B
U12 | E22-900MM22S | 1 | VCC | power_in | V3V3
U12 | E22-900MM22S | 2 | GND | power_in | GND
U12 | E22-900MM22S | 3 | NRST | input | RF_RST
U12 | E22-900MM22S | 4 | NC | no_connect | NC
U12 | E22-900MM22S | 5 | NC | no_connect | NC
U12 | E22-900MM22S | 6 | ANT | passive | GW_ANT
U12 | E22-900MM22S | 7 | GND | power_in | GND
U12 | E22-900MM22S | 8 | NC | no_connect | NC
U12 | E22-900MM22S | 9 | TXEN | input | RF_TXEN
U12 | E22-900MM22S | 10 | RXEN | input | RF_RXEN
U12 | E22-900MM22S | 11 | BUSY | output | RF_BUSY
U12 | E22-900MM22S | 12 | MISO | output | RF_MISO
U12 | E22-900MM22S | 13 | MOSI | input | RF_MOSI
U12 | E22-900MM22S | 14 | NSS | input | RF_CS
U12 | E22-900MM22S | 15 | SCK | input | RF_SCK
U12 | E22-900MM22S | 16 | GND | power_in | GND
U12 | E22-900MM22S | 17 | NC | no_connect | NC
U12 | E22-900MM22S | 18 | DIO3 | bidirectional | NC
U12 | E22-900MM22S | 19 | DIO2 | bidirectional | NC
U12 | E22-900MM22S | 20 | DIO1 | bidirectional | RF_DIO1
C54 | X7R 16V 100nF | 1 |  | passive | V3V3
C54 | X7R 16V 100nF | 2 |  | passive | GND
C55 | X7R 16V 10uF | 1 |  | passive | V3V3
C55 | X7R 16V 10uF | 2 |  | passive | GND
R27 | 1% thick film 10k | 1 |  | passive | RF_CS
R27 | 1% thick film 10k | 2 |  | passive | V3V3
R28 | 1% thick film 10k | 1 |  | passive | RF_RST
R28 | 1% thick film 10k | 2 |  | passive | V3V3
R29 | 1% thick film 100k | 1 |  | passive | RF_TXEN
R29 | 1% thick film 100k | 2 |  | passive | GND
R30 | 1% thick film 100k | 1 |  | passive | RF_RXEN
R30 | 1% thick film 100k | 2 |  | passive | GND
J9 | 868MHz antenna | 1 | In | passive | GW_ANT
J9 | 868MHz antenna | 2 | Ext | passive | GND
U13 | 2041119-1 | 1 | PIN_1 | passive | NC
U13 | 2041119-1 | 2 | PIN_2 | passive | LTE_3V3
U13 | 2041119-1 | 3 | PIN_3 | passive | NC
U13 | 2041119-1 | 4 | PIN_4 | passive | GND
U13 | 2041119-1 | 5 | PIN_5 | passive | NC
U13 | 2041119-1 | 6 | PIN_6 | passive | NC
U13 | 2041119-1 | 7 | PIN_7 | passive | NC
U13 | 2041119-1 | 8 | PIN_8 | passive | SIM_VDD
U13 | 2041119-1 | 9 | PIN_9 | passive | GND
U13 | 2041119-1 | 10 | PIN_10 | passive | SIM_IO
U13 | 2041119-1 | 11 | PIN_11 | passive | LTE_TX
U13 | 2041119-1 | 12 | PIN_12 | passive | SIM_CLK
U13 | 2041119-1 | 13 | PIN_13 | passive | LTE_RX
U13 | 2041119-1 | 14 | PIN_14 | passive | SIM_RST
U13 | 2041119-1 | 15 | PIN_15 | passive | GND
U13 | 2041119-1 | 16 | PIN_16 | passive | NC
U13 | 2041119-1 | 17 | PIN_17 | passive | NC
U13 | 2041119-1 | 18 | PIN_18 | passive | GND
U13 | 2041119-1 | 19 | PIN_19 | passive | NC
U13 | 2041119-1 | 20 | PIN_20 | passive | NC
U13 | 2041119-1 | 21 | PIN_21 | passive | GND
U13 | 2041119-1 | 22 | PIN_22 | passive | NC
U13 | 2041119-1 | 23 | PIN_23 | passive | NC
U13 | 2041119-1 | 24 | PIN_24 | passive | NC
U13 | 2041119-1 | 25 | PIN_25 | passive | NC
U13 | 2041119-1 | 26 | PIN_26 | passive | GND
U13 | 2041119-1 | 27 | PIN_27 | passive | GND
U13 | 2041119-1 | 28 | PIN_28 | passive | NC
U13 | 2041119-1 | 29 | PIN_29 | passive | GND
U13 | 2041119-1 | 30 | PIN_30 | passive | NC
U13 | 2041119-1 | 31 | PIN_31 | passive | NC
U13 | 2041119-1 | 32 | PIN_32 | passive | NC
U13 | 2041119-1 | 33 | PIN_33 | passive | NC
U13 | 2041119-1 | 34 | PIN_34 | passive | GND
U13 | 2041119-1 | 35 | PIN_35 | passive | GND
U13 | 2041119-1 | 36 | PIN_36 | passive | USB_DM
U13 | 2041119-1 | 37 | PIN_37 | passive | GND
U13 | 2041119-1 | 38 | PIN_38 | passive | USB_DP
U13 | 2041119-1 | 39 | PIN_39 | passive | LTE_3V3
U13 | 2041119-1 | 40 | PIN_40 | passive | GND
U13 | 2041119-1 | 41 | PIN_41 | passive | LTE_3V3
U13 | 2041119-1 | 42 | PIN_42 | passive | NC
U13 | 2041119-1 | 43 | PIN_43 | passive | GND
U13 | 2041119-1 | 44 | PIN_44 | passive | NC
U13 | 2041119-1 | 45 | PIN_45 | passive | NC
U13 | 2041119-1 | 46 | PIN_46 | passive | NC
U13 | 2041119-1 | 47 | PIN_47 | passive | NC
U13 | 2041119-1 | 48 | PIN_48 | passive | NC
U13 | 2041119-1 | 49 | PIN_49 | passive | NC
U13 | 2041119-1 | 50 | PIN_50 | passive | GND
U13 | 2041119-1 | 51 | PIN_51 | passive | NC
U13 | 2041119-1 | 52 | PIN_52 | passive | LTE_3V3
J10 | SIM connector | 1 | Pin_1 | passive | SIM_VDD
J10 | SIM connector | 2 | Pin_2 | passive | SIM_RST
J10 | SIM connector | 3 | Pin_3 | passive | SIM_CLK
J10 | SIM connector | 4 | Pin_4 | passive | GND
J10 | SIM connector | 5 | Pin_5 | passive | SIM_IO
J10 | SIM connector | 6 | Pin_6 | passive | NC
D1 | SS34 | 1 | K | passive | V5_HOLD
D1 | SS34 | 2 | A | passive | V5
D2 | SS34 | 1 | K | passive | V5_HOLD
D2 | SS34 | 2 | A | passive | SC_TOP
D3 | BAT54 | 1 | K | passive | SC_CHARGE
D3 | BAT54 | 2 | A | passive | V5
R31 | 1% thick film 100R 1W | 1 |  | passive | SC_CHARGE
R31 | 1% thick film 100R 1W | 2 |  | passive | SC_TOP
J11 | 2x10F 2.7V EDLC pack | 1 | Pin_1 | passive | SC_TOP
J11 | 2x10F 2.7V EDLC pack | 2 | Pin_2 | passive | SC_MID
J11 | 2x10F 2.7V EDLC pack | 3 | Pin_3 | passive | GND
R32 | 1% thick film 10k | 1 |  | passive | SC_TOP
R32 | 1% thick film 10k | 2 |  | passive | SC_MID
R33 | 1% thick film 10k | 1 |  | passive | SC_MID
R33 | 1% thick film 10k | 2 |  | passive | GND
C56 | X7R 16V 22uF | 1 |  | passive | V5_HOLD
C56 | X7R 16V 22uF | 2 |  | passive | GND
R34 | 1% thick film 100k | 1 |  | passive | V5
R34 | 1% thick film 100k | 2 |  | passive | PFAIL_ADC
R35 | 1% thick film 100k | 1 |  | passive | PFAIL_ADC
R35 | 1% thick film 100k | 2 |  | passive | GND
C57 | X7R 16V 10nF | 1 |  | passive | PFAIL_ADC
C57 | X7R 16V 10nF | 2 |  | passive | GND
#FLG1 |  | 1 | pwr | power_out | V5_IN
#FLG2 |  | 1 | pwr | power_out | V5
#FLG3 |  | 1 | pwr | power_out | GND
#FLG4 |  | 1 | pwr | power_out | V3V3
#FLG5 |  | 1 | pwr | power_out | LTE_3V3
#FLG6 |  | 1 | pwr | power_out | RTC_BACKUP
#FLG7 |  | 1 | pwr | power_out | ISO1_GND
#FLG8 |  | 1 | pwr | power_out | ISO2_GND
#FLG9 |  | 1 | pwr | power_out | V5_HOLD
#FLG10 |  | 1 | pwr | power_out | VDDCR
#FLG11 |  | 1 | pwr | power_out | CHASSIS
