hackathon-buke-team/grid-up/hardware/B1/mechanical/IR/assembly.step

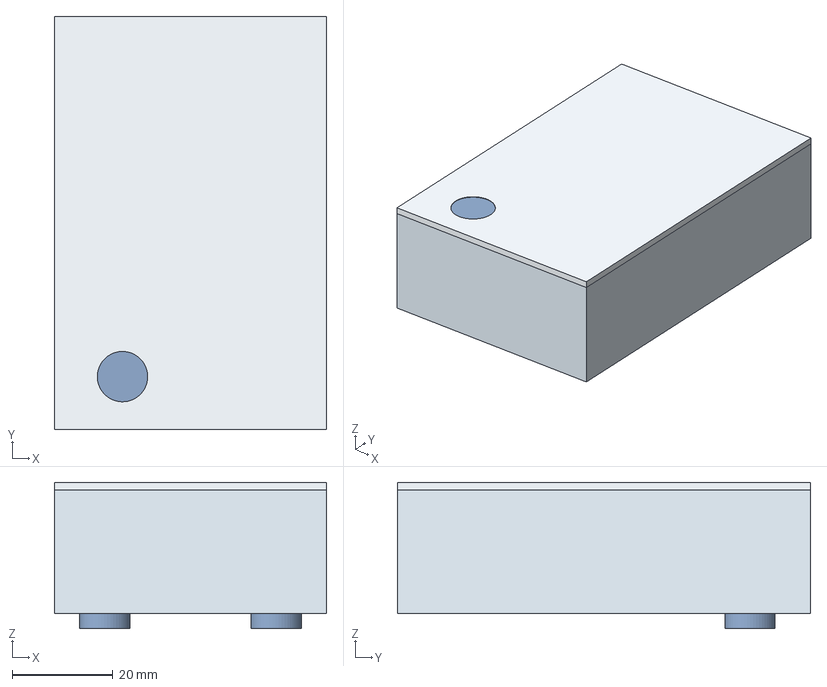
[picture p21: CAD file, 2026-09-20]
hardware/B1/mechanical/IR/assembly.step
54.0 x 82.0 x 29.0 mm
base
lid
pcb
gasket
battery_envelope
IR_window
magnet_10
magnet_44
