hackathon-buke-team/grid-up/hardware/B1/mechanical/GW/assembly.step

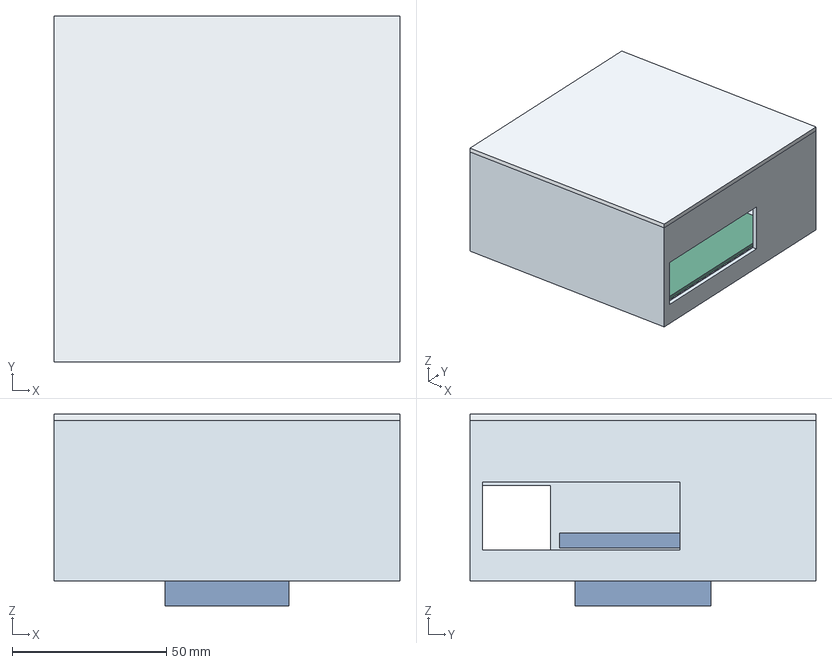
[picture p22: CAD file, 2026-09-20]
hardware/B1/mechanical/GW/assembly.step
112.0 x 112.0 x 62.0 mm
base
lid
pcb
gasket
DIN_clip
EC21_card_envelope
