hackathon-buke-team/grid-up/hardware/B1/mechanical/PD/assembly.step

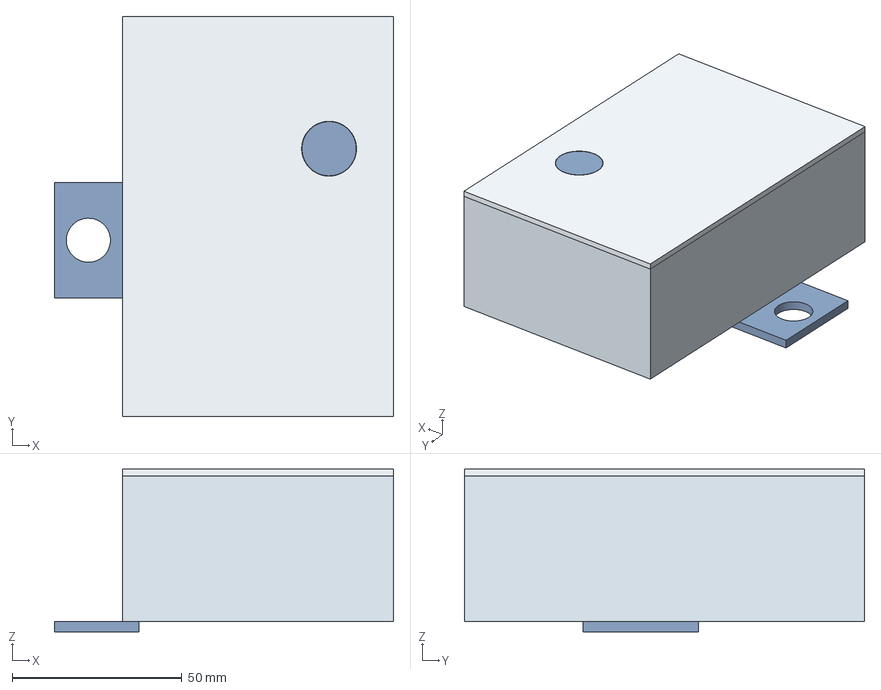
[picture p23: CAD file, 2026-09-20]
hardware/B1/mechanical/PD/assembly.step
100.0 x 118.0 x 48.0 mm
base
lid
pcb
gasket
ER26500_envelope
HLC_envelope
M12_bracket
ultrasound_envelope
