hackathon-buke-team/grid-up/hardware/B1/mechanical/TC/assembly.step

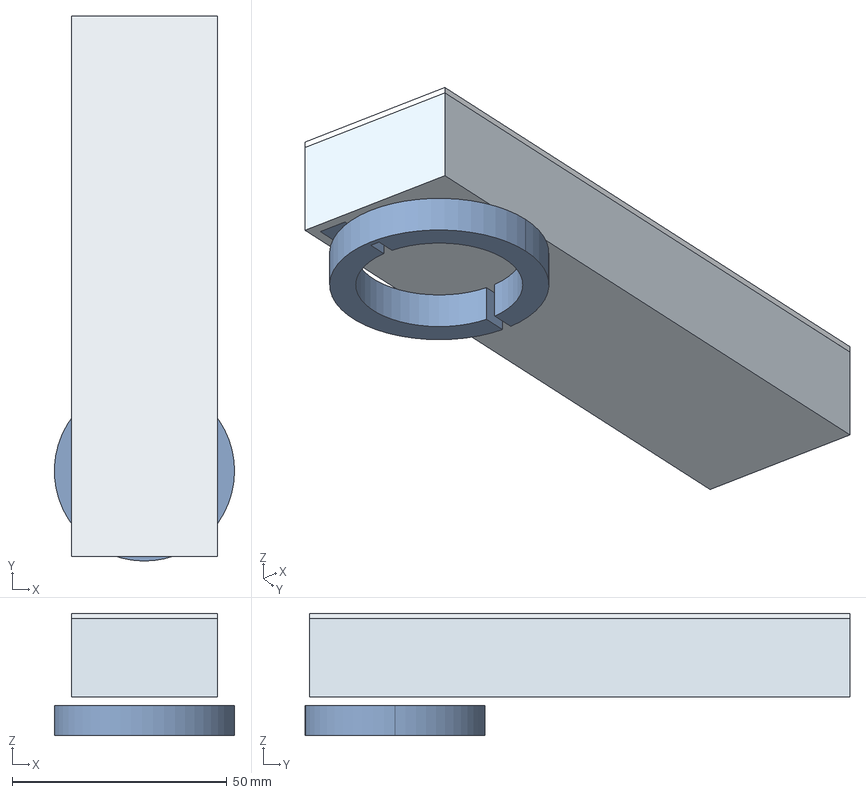
[picture p24: CAD file, 2026-09-20]
hardware/B1/mechanical/TC/assembly.step
42.0 x 127.0 x 28.5 mm
base
lid
pcb
gasket
thermal_pad
ER14250_envelope
HLC_envelope
split_clamp
