hackathon-buke-team/grid-up/hardware/B1/GW/models/E22-900MM22S-envelope.step

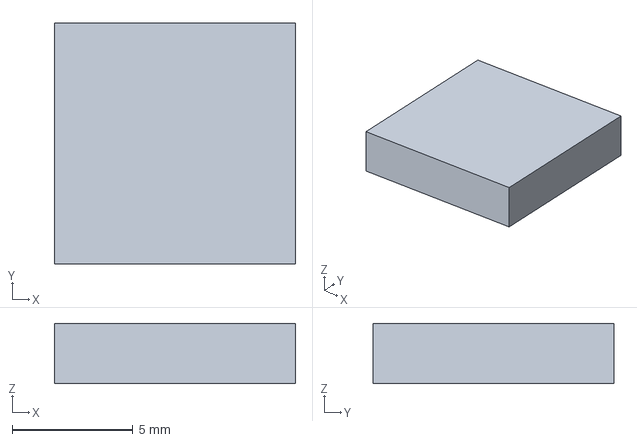
[picture p25: CAD file, 2026-09-20]
hardware/B1/GW/models/E22-900MM22S-envelope.step
10.0 x 10.0 x 2.50 mm
