hackathon-buke-team/grid-up/hardware/B1/mechanical/GW/base.step

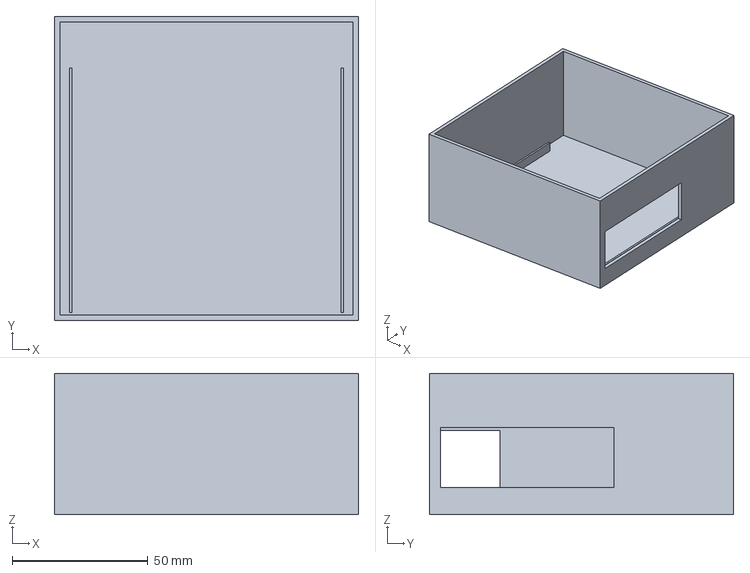
[picture p26: CAD file, 2026-09-20]
hardware/B1/mechanical/GW/base.step
112.0 x 112.0 x 52.0 mm
