hackathon-buke-team/grid-up/hardware/B1/mechanical/PD/lid.step

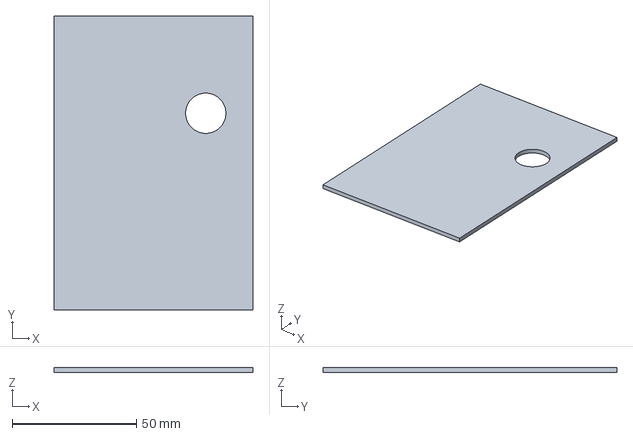
[picture p27: CAD file, 2026-09-20]
hardware/B1/mechanical/PD/lid.step
80.0 x 118.0 x 2.00 mm
