hackathon-buke-team/grid-up/hardware/B1/mechanical/TC/lid.step

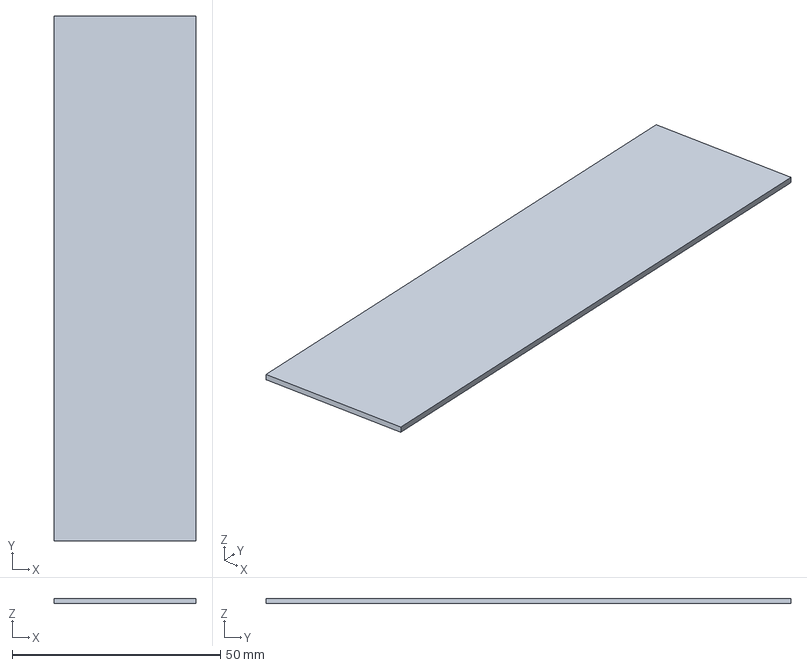
[picture p28: CAD file, 2026-09-20]
hardware/B1/mechanical/TC/lid.step
34.0 x 126.0 x 1.20 mm
