hackathon-buke-team/grid-up/hardware/B1/mechanical/IR/base.step

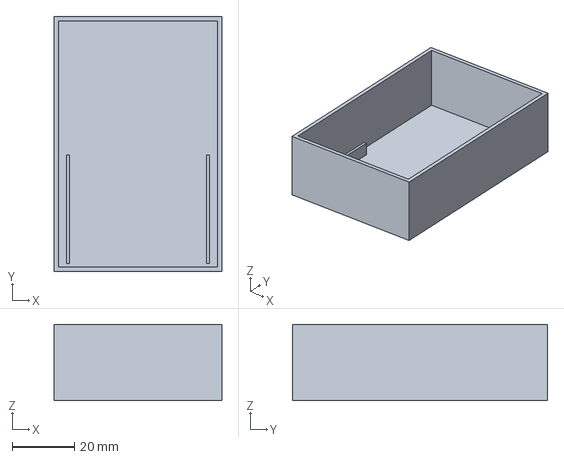
[picture p29: CAD file, 2026-09-20]
hardware/B1/mechanical/IR/base.step
54.0 x 82.0 x 24.5 mm
