hackathon-buke-team/grid-up/hardware/B1/mechanical/GW/lid.step

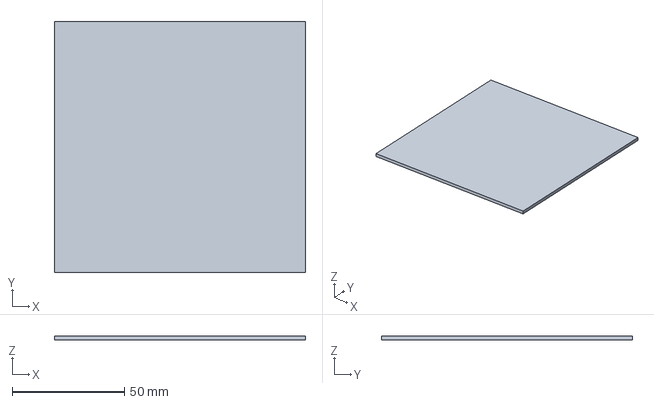
[picture p30: CAD file, 2026-09-20]
hardware/B1/mechanical/GW/lid.step
112.0 x 112.0 x 2.00 mm
