hackathon-buke-team/grid-up/hardware/B1/mechanical/IR/lid.step

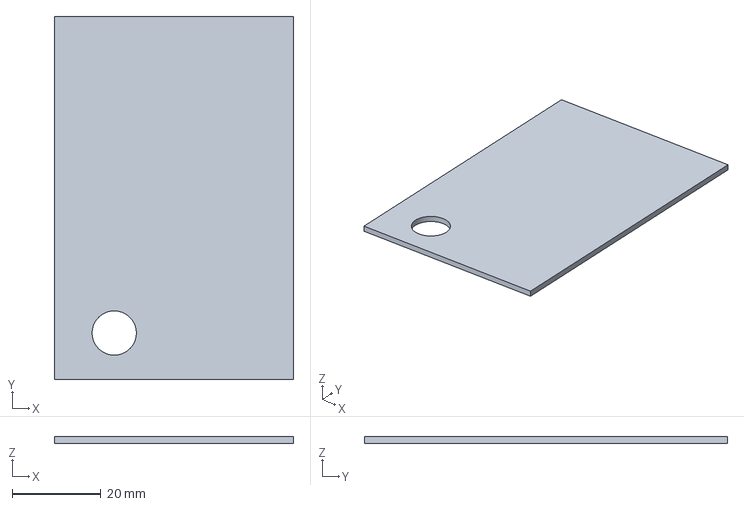
[picture p31: CAD file, 2026-09-20]
hardware/B1/mechanical/IR/lid.step
54.0 x 82.0 x 1.50 mm
