hackathon-buke-team/grid-up/hardware/B1/mechanical/PD/base.step

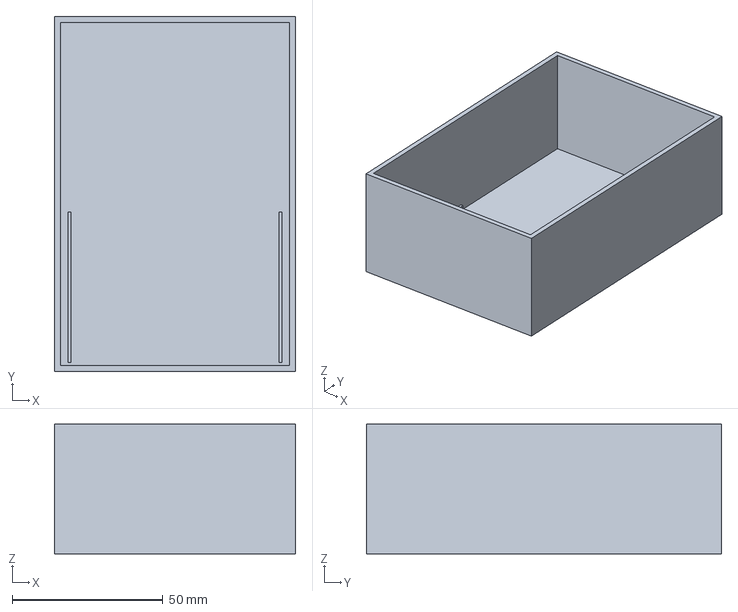
[picture p32: CAD file, 2026-09-20]
hardware/B1/mechanical/PD/base.step
80.0 x 118.0 x 43.0 mm
