hackathon-buke-team/grid-up/hardware/B1/mechanical/TC/base.step

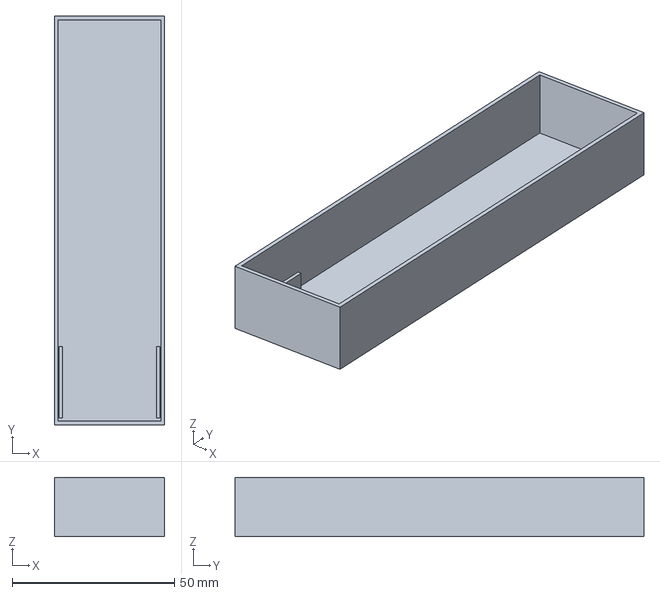
[picture p33: CAD file, 2026-09-20]
hardware/B1/mechanical/TC/base.step
34.0 x 126.0 x 18.3 mm
