hackathon-buke-team/grid-up/hardware/B1/GW/models/TE2041119-EC21-envelope.step

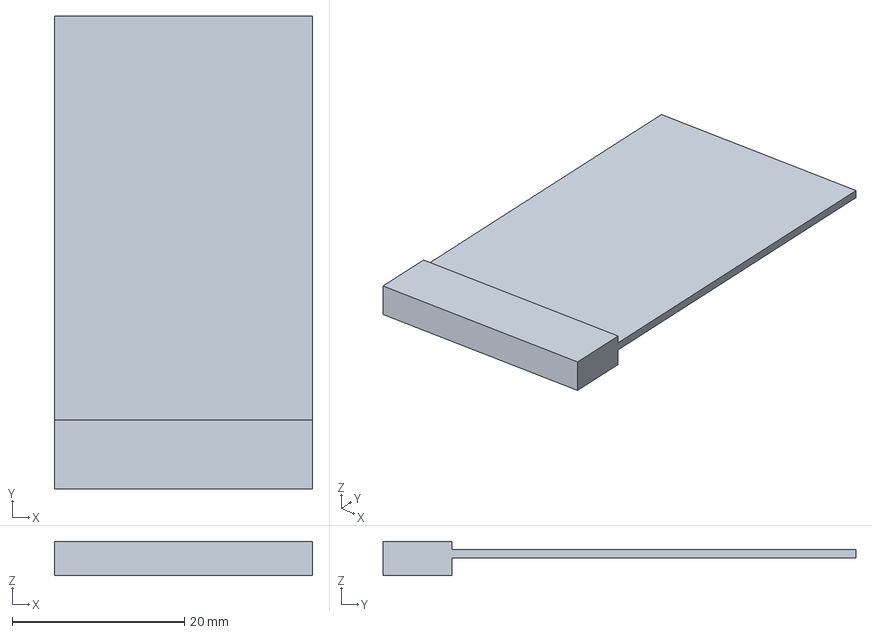
[picture p34: CAD file, 2026-09-20]
hardware/B1/GW/models/TE2041119-EC21-envelope.step
30.0 x 55.0 x 4.00 mm
