hackathon-buke-team/grid-up/(list of files, cad)

Other CAD files:
hardware/B1/mechanical/GW/base.stl
hardware/B1/mechanical/IR/base.stl
hardware/B1/mechanical/PD/base.stl
hardware/B1/mechanical/TC/base.stl
