hackathon-buke-team/grid-up/hardware/B1/mechanical/GW/assembly.png

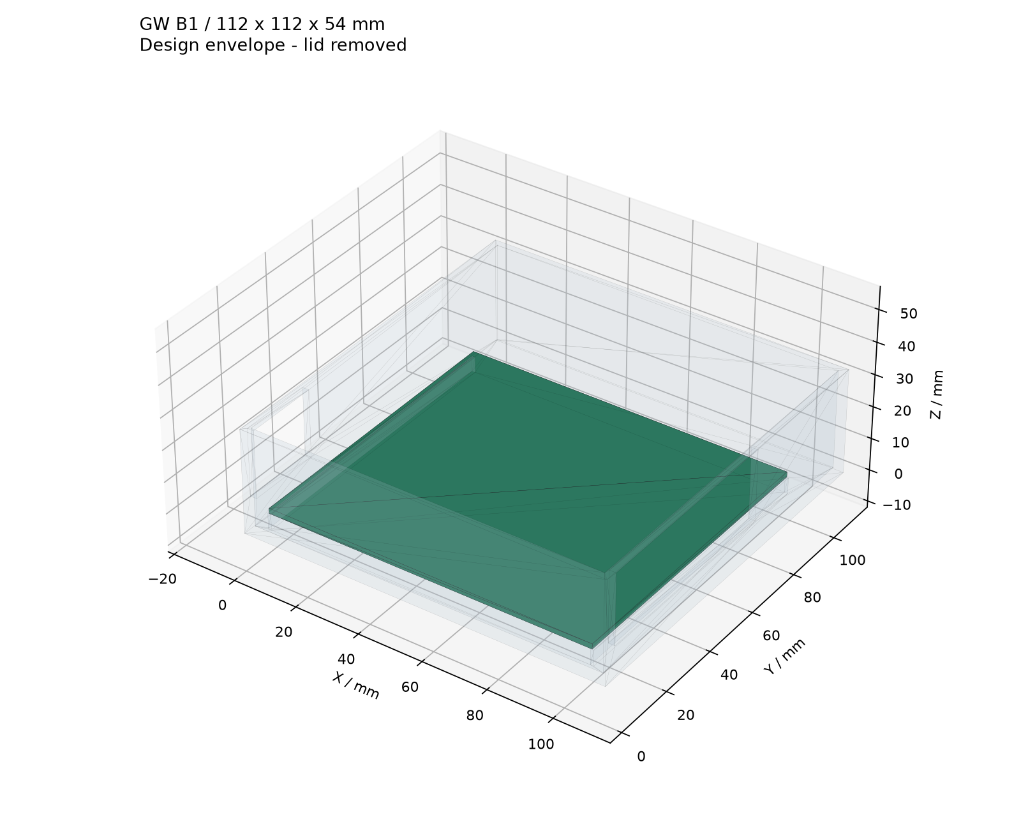
hardware/B1/mechanical/GW/assembly.png
