hackathon-buke-team/grid-up/hardware/B1/mechanical/IR/assembly.png

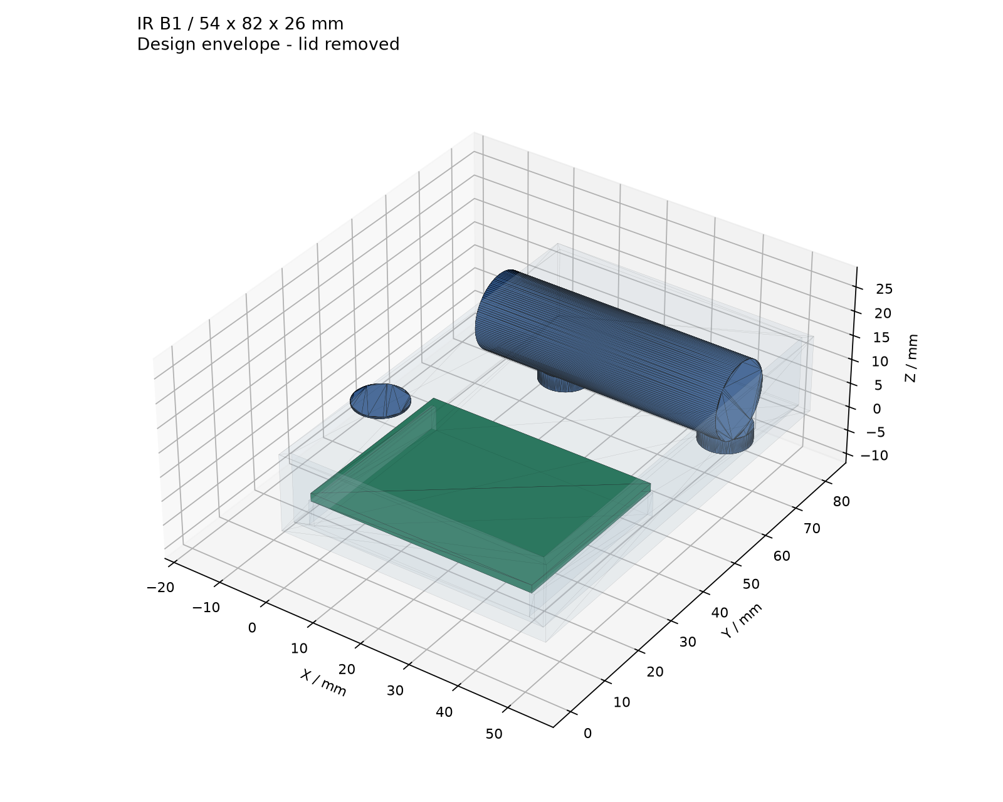
hardware/B1/mechanical/IR/assembly.png
