hackathon-buke-team/grid-up/hardware/B1/mechanical/TC/assembly.png

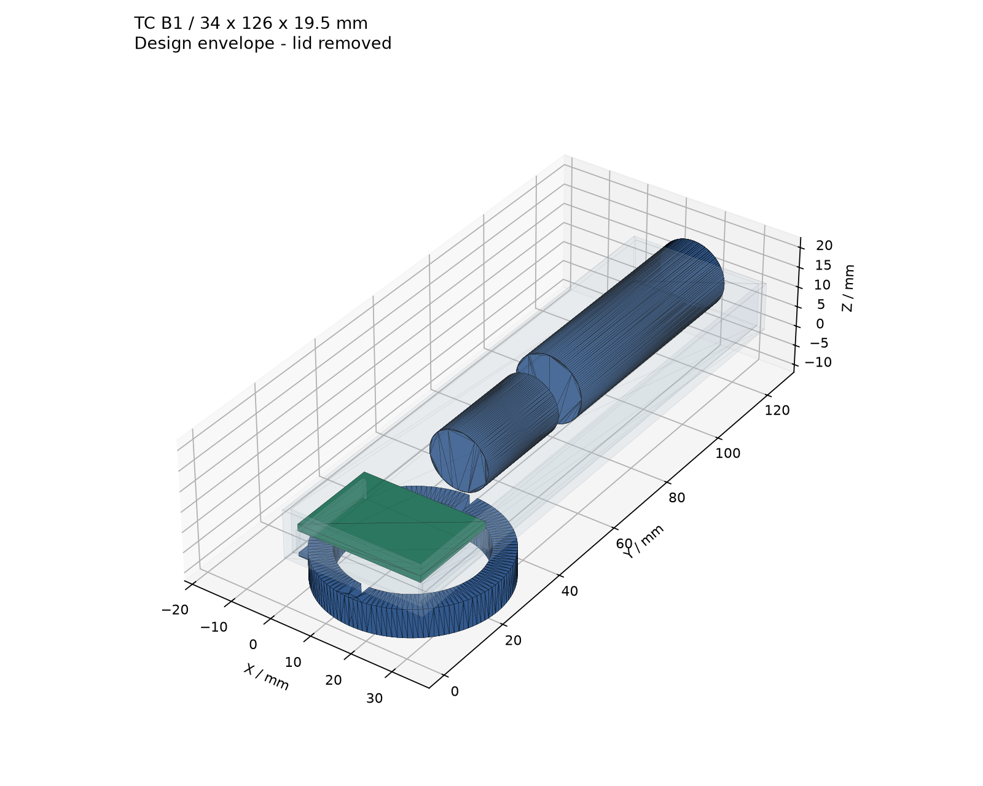
hardware/B1/mechanical/TC/assembly.png
