hackathon-buke-team/grid-up/hardware/B1/GW/schematic.pdf

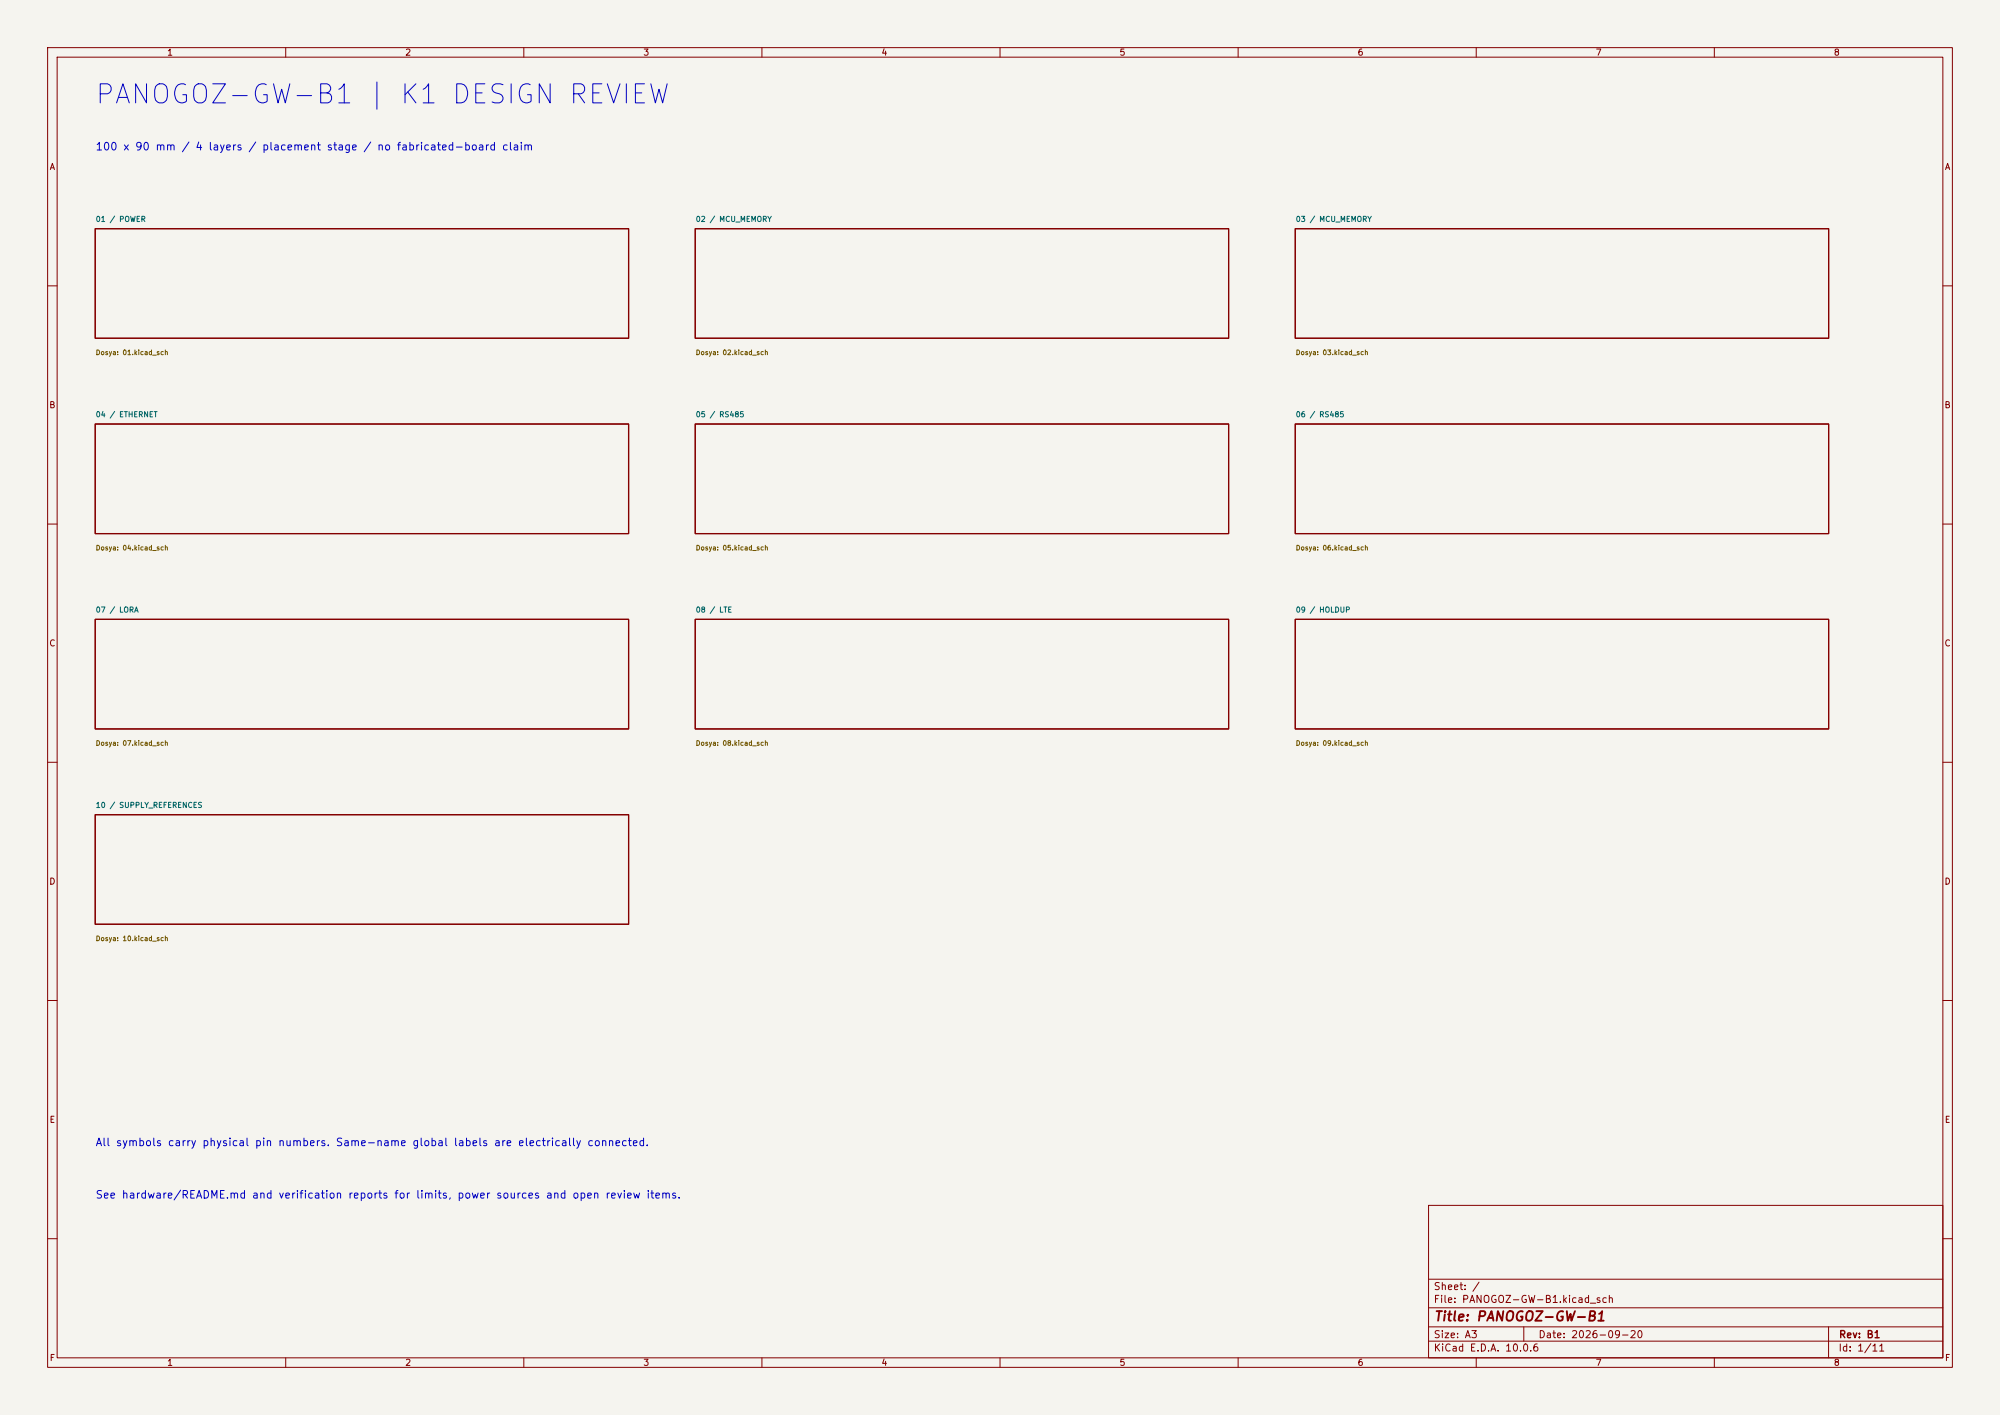
[picture p38: page 1]

Dosya: 10.kicad_sch PANOGOZ-GW-B1 | K1 DESIGN REVIEW

100 x 90 mm / 4 layers / placement stage / no fabricated-board claim

Dosya: 01.kicad_sch 04 / ETHERNET Dosya: 04.kicad_sch 07 / LORA Dosya: 07.kicad_sch 10 / SUPPLY_REFERENCES

All symbols carry physical pin numbers. Same-name global labels are electrically connected.

See hardware/README.md and verification reports for limits, power sources and open review items.

Size: A3 | Rev: B1 | F Date: 2026-09-20
KiCad E.D.A. 10.0.6 | Id: 1/11

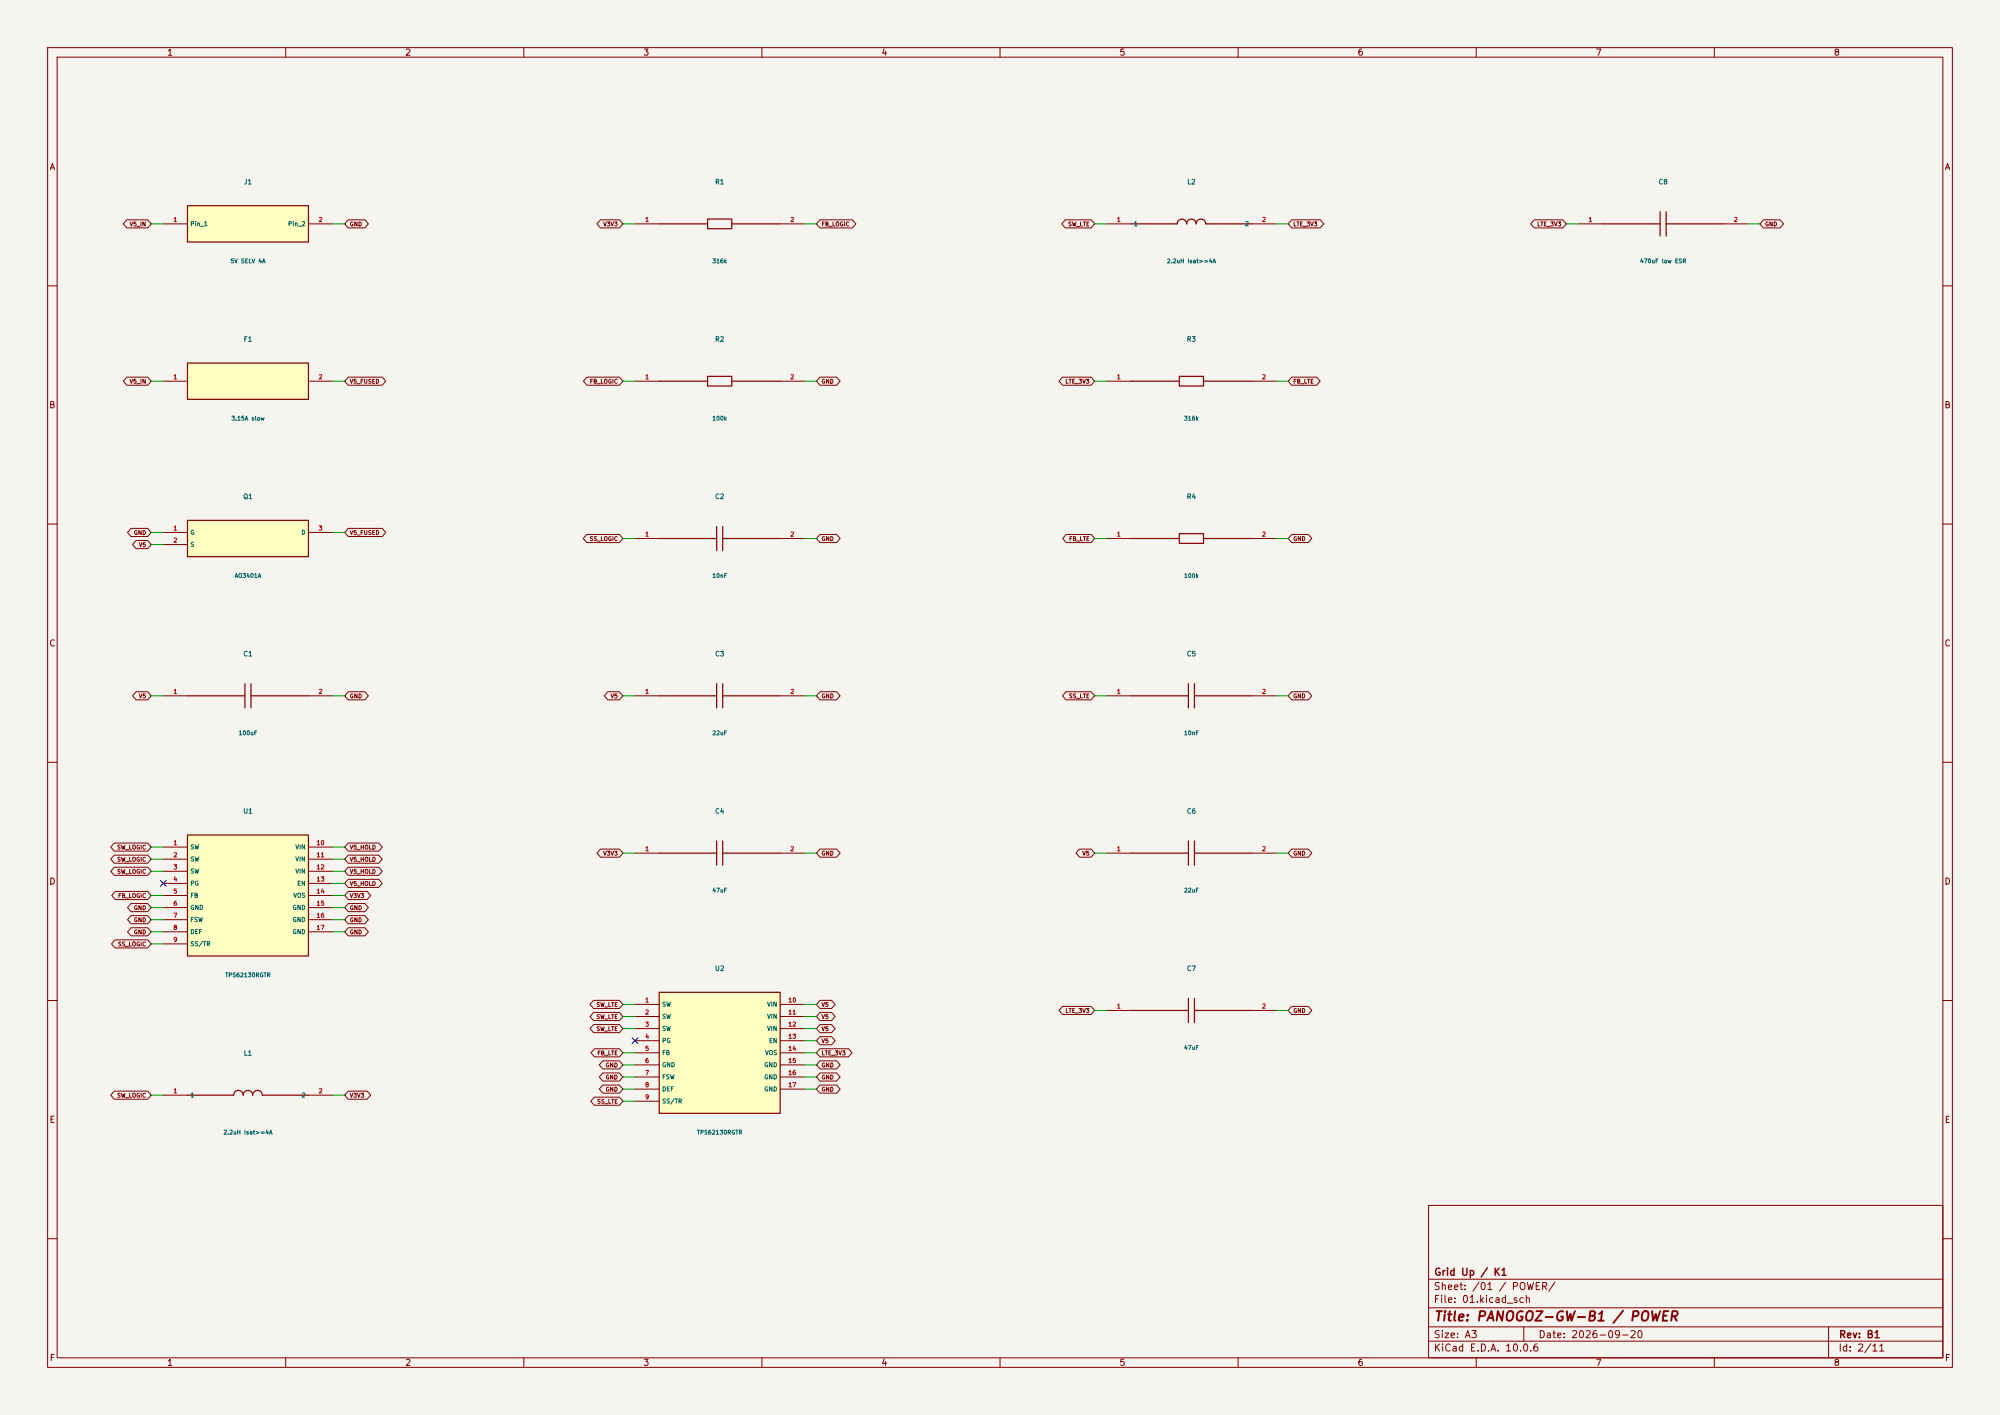
[picture p39: page 2]

Grid Up / K1
Sheet: /01 / POWER/
File: 01.kicad_sch
Title: PANOGOZ-GW-B1 / POWER

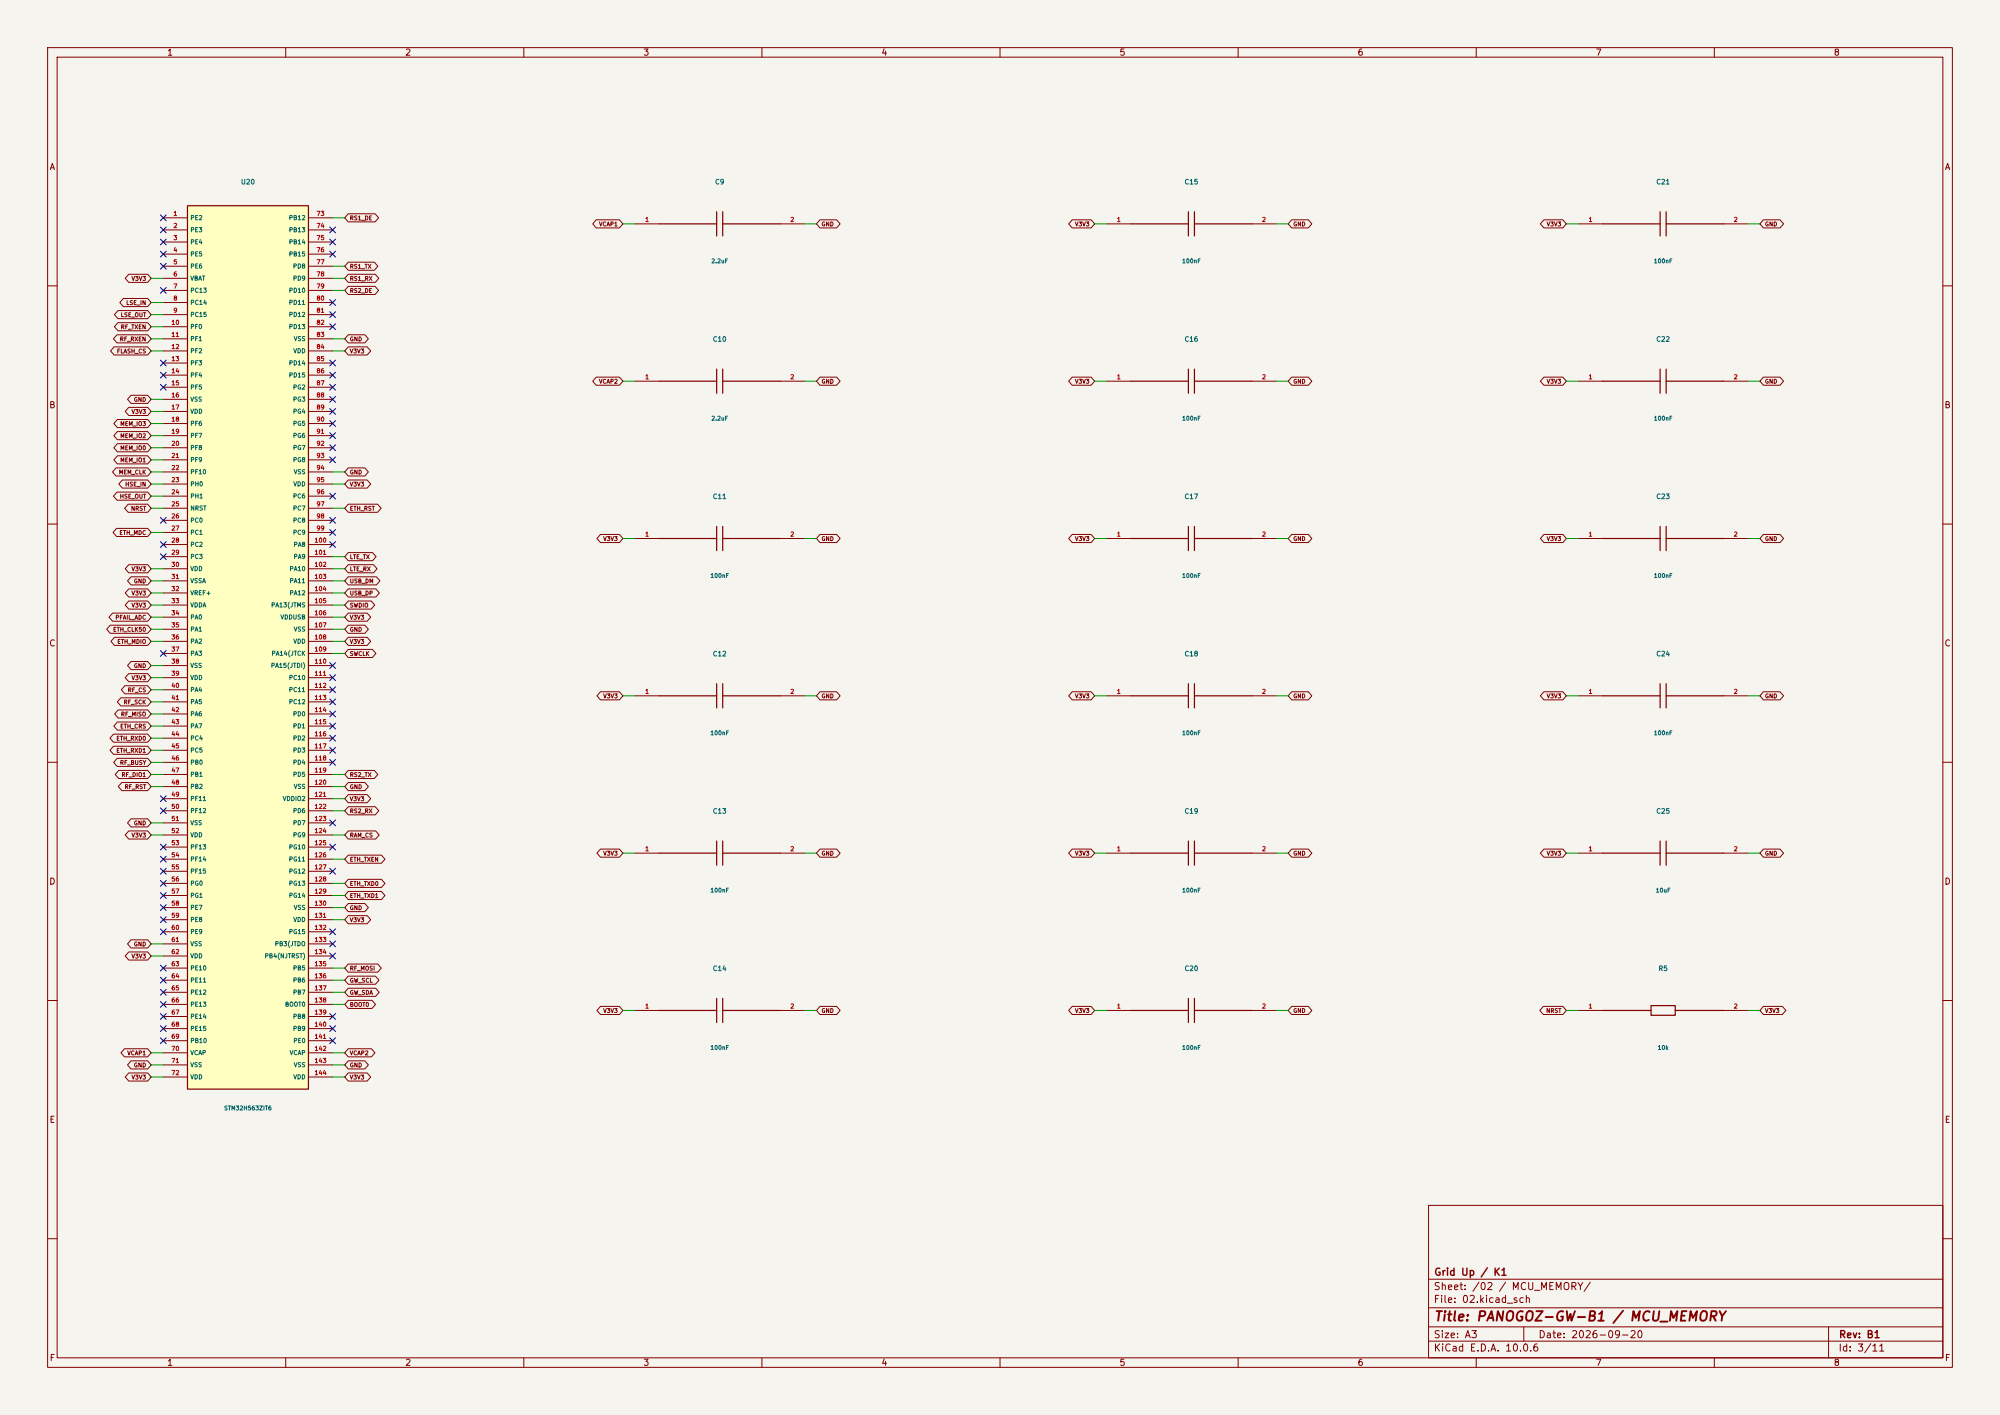
[picture p40: page 3]

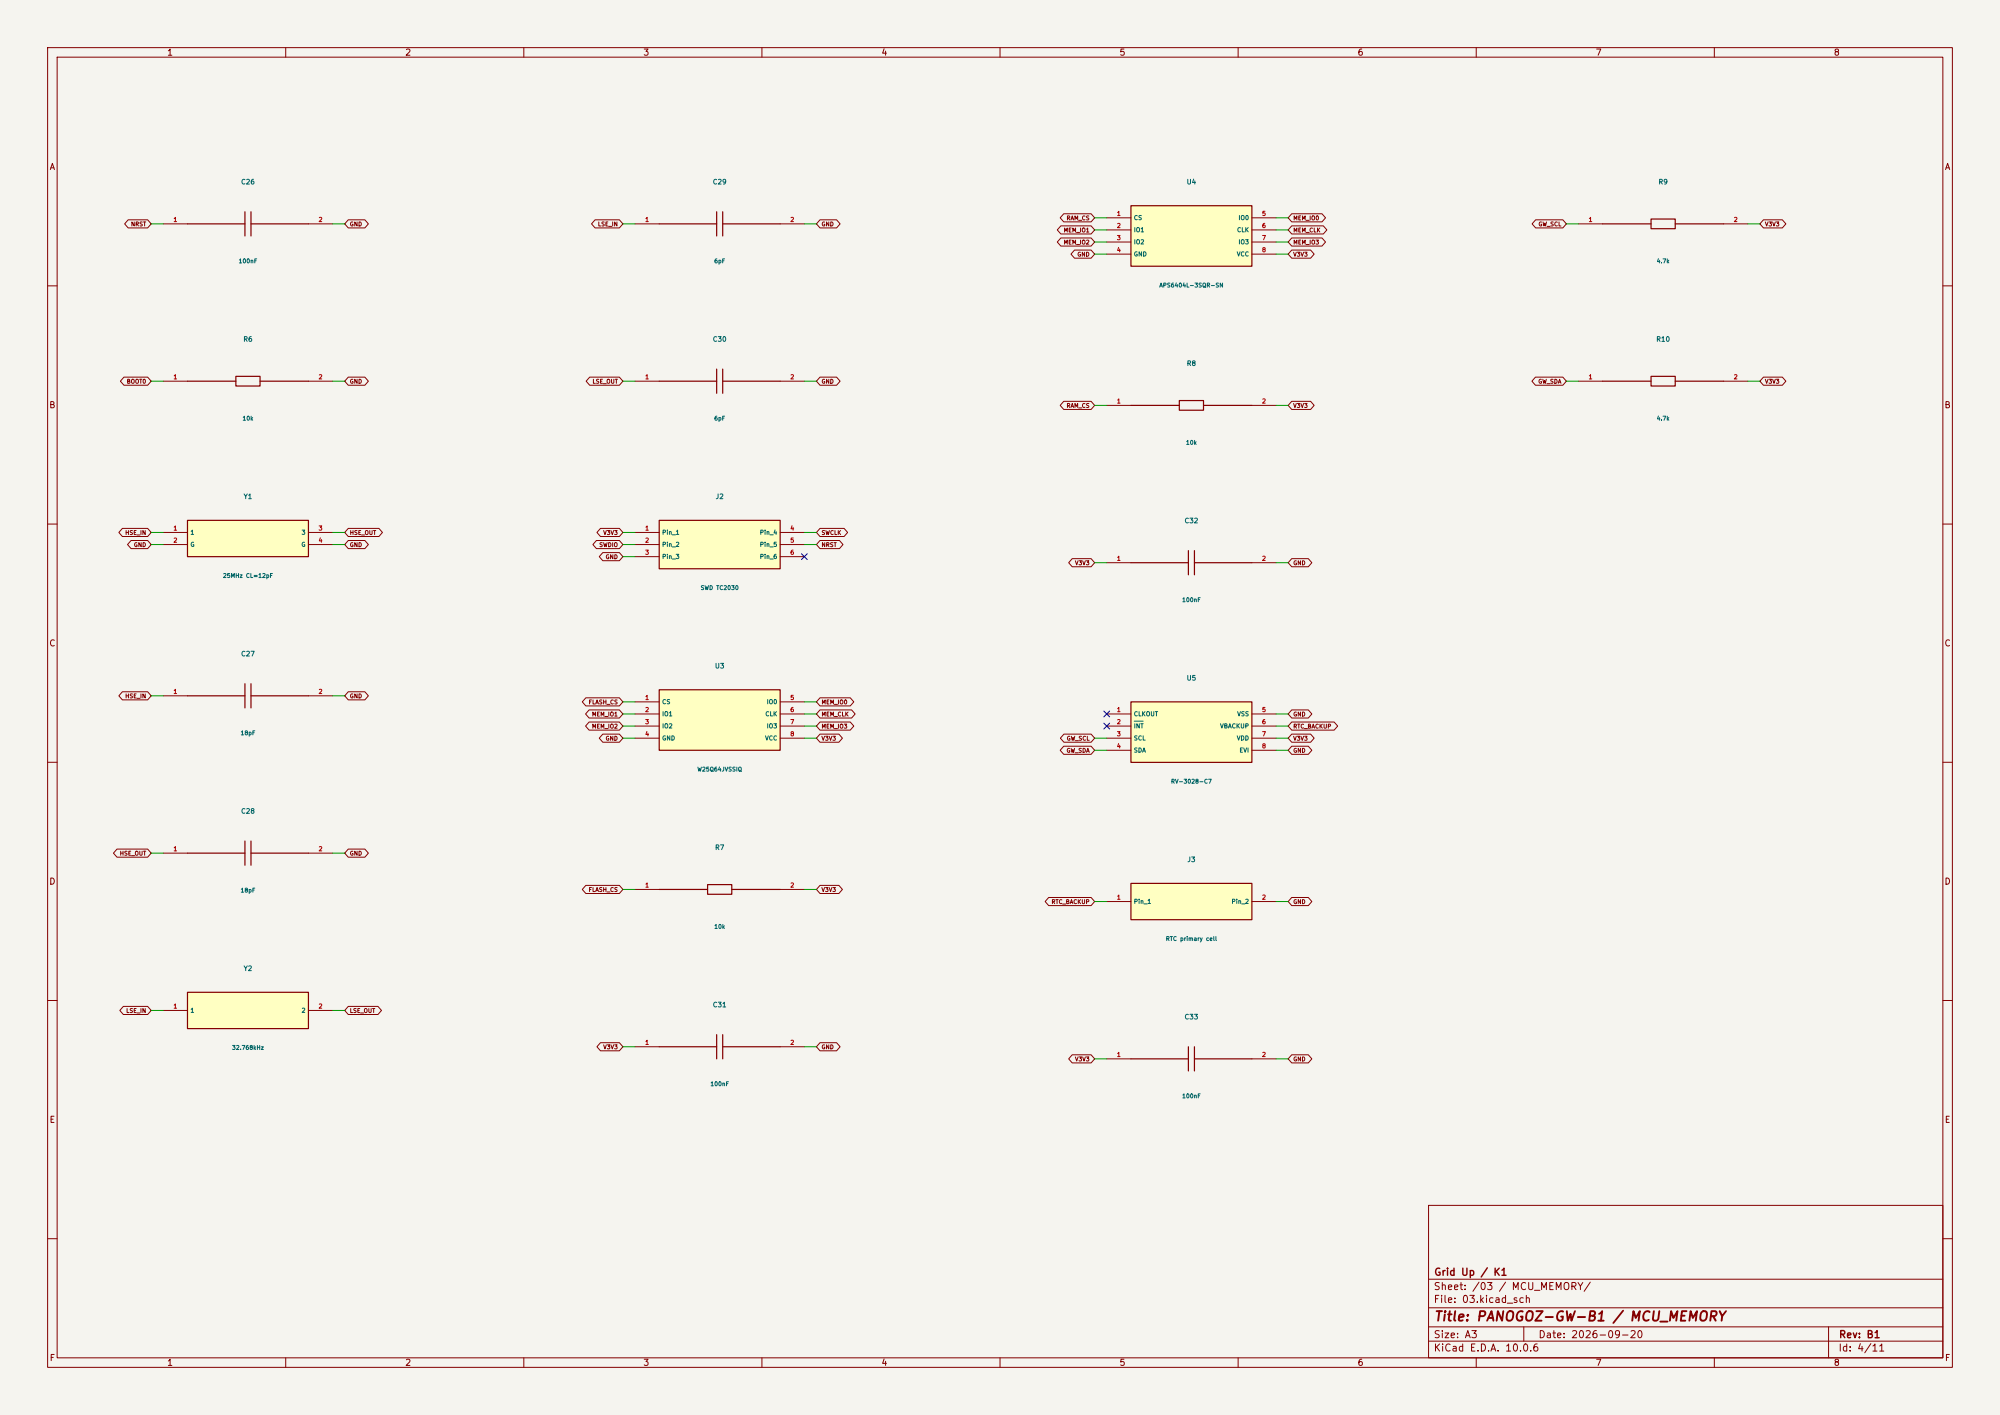
[picture p41: page 4]

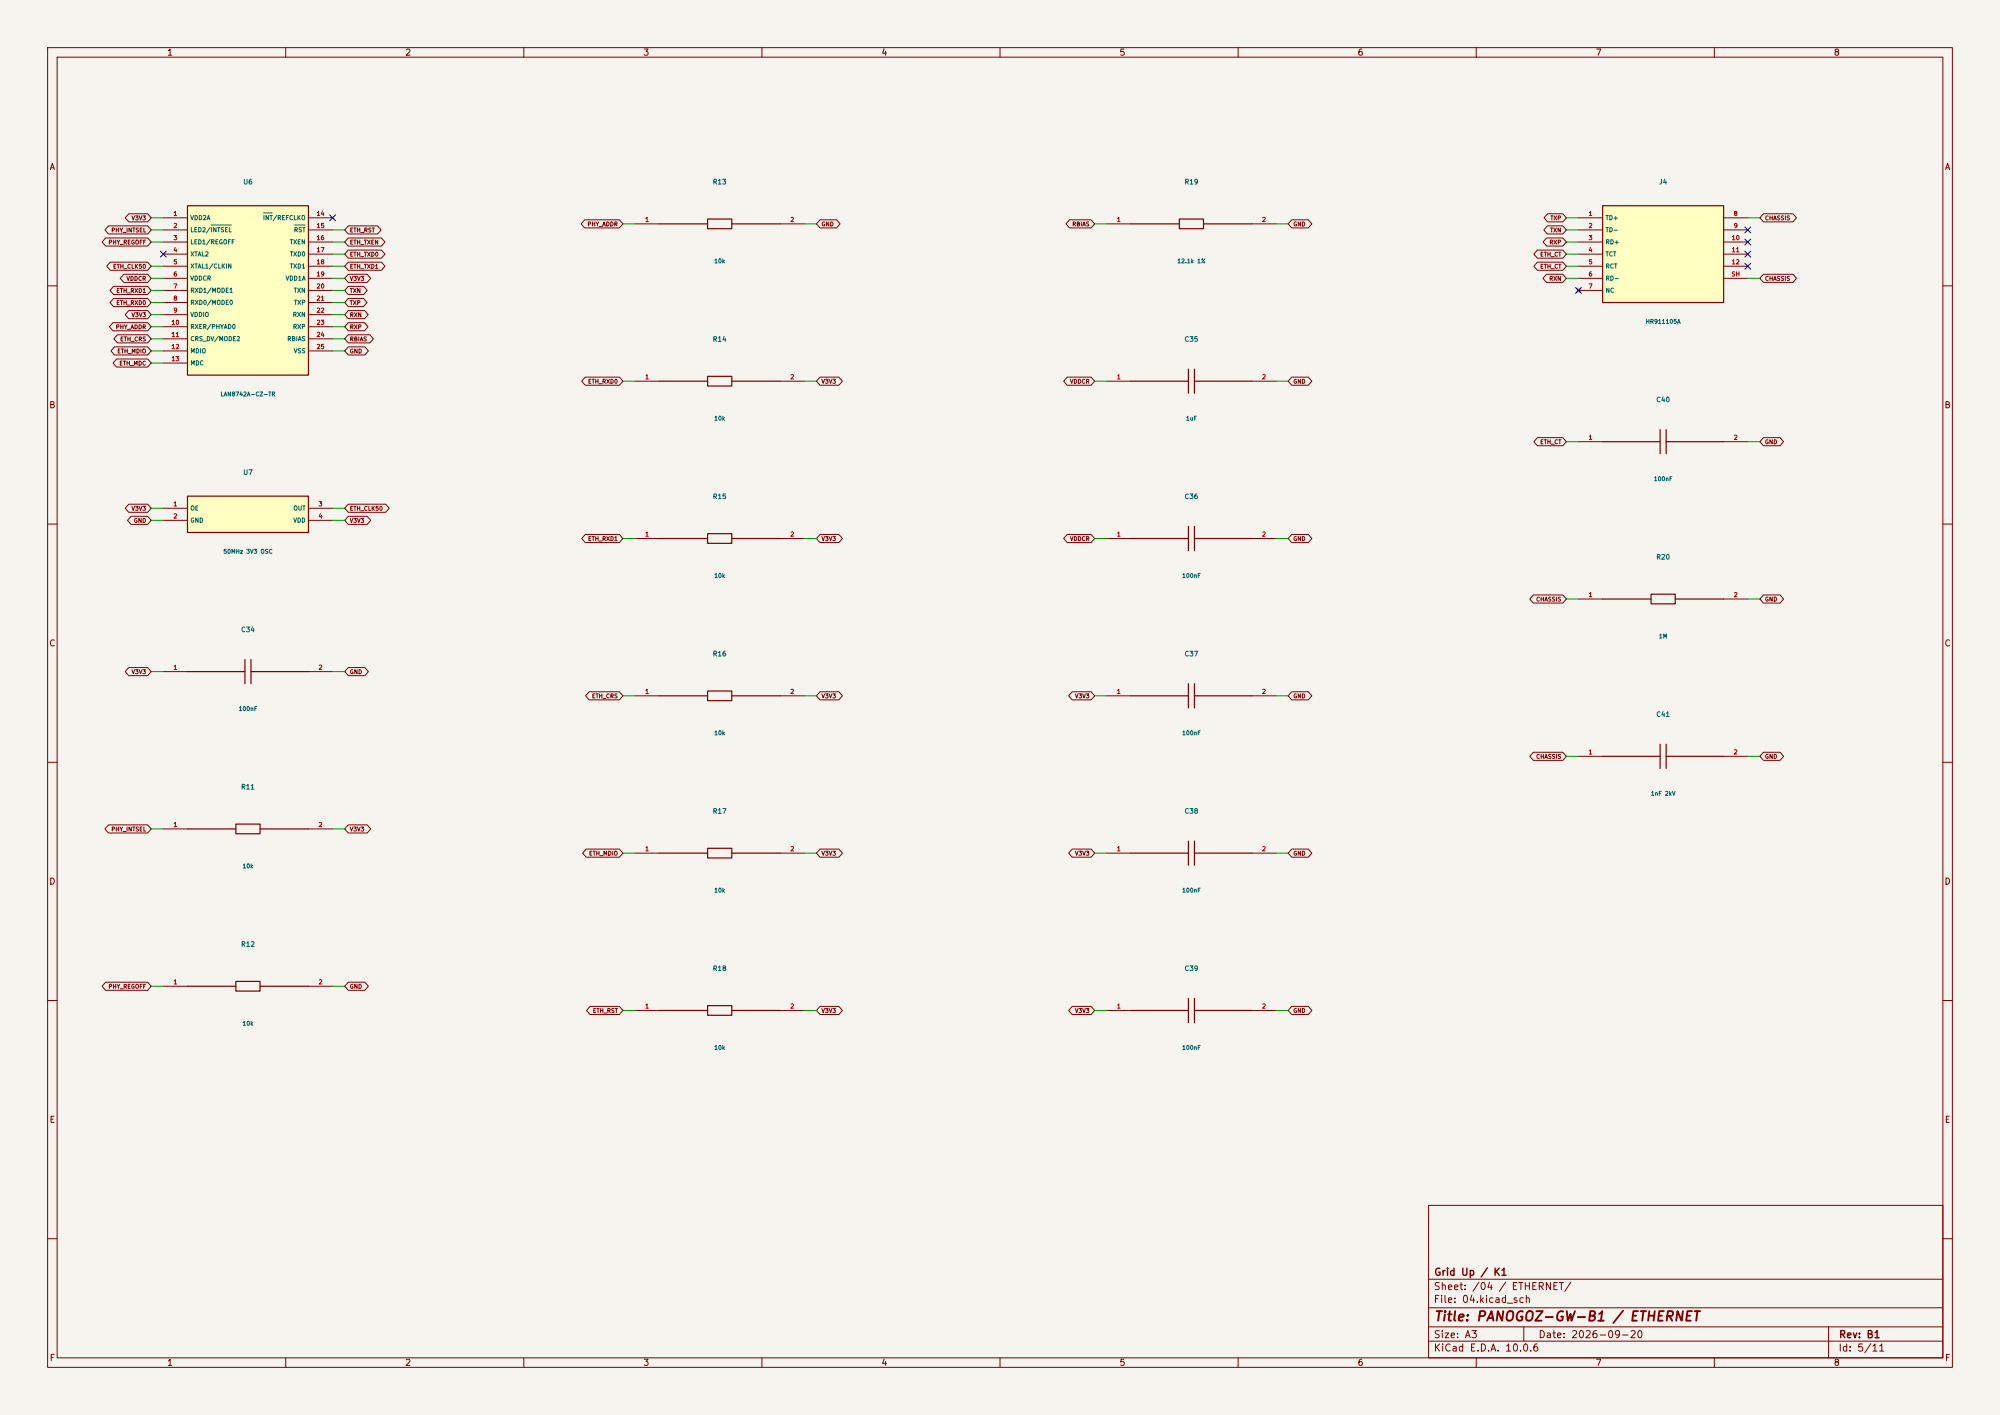
[picture p42: page 5]

Grid Up / K1
Sheet: /04 / ETHERNET/
File: 04.kicad_sch
Title: PANOGOZ-GW-B1 / ETHERNET

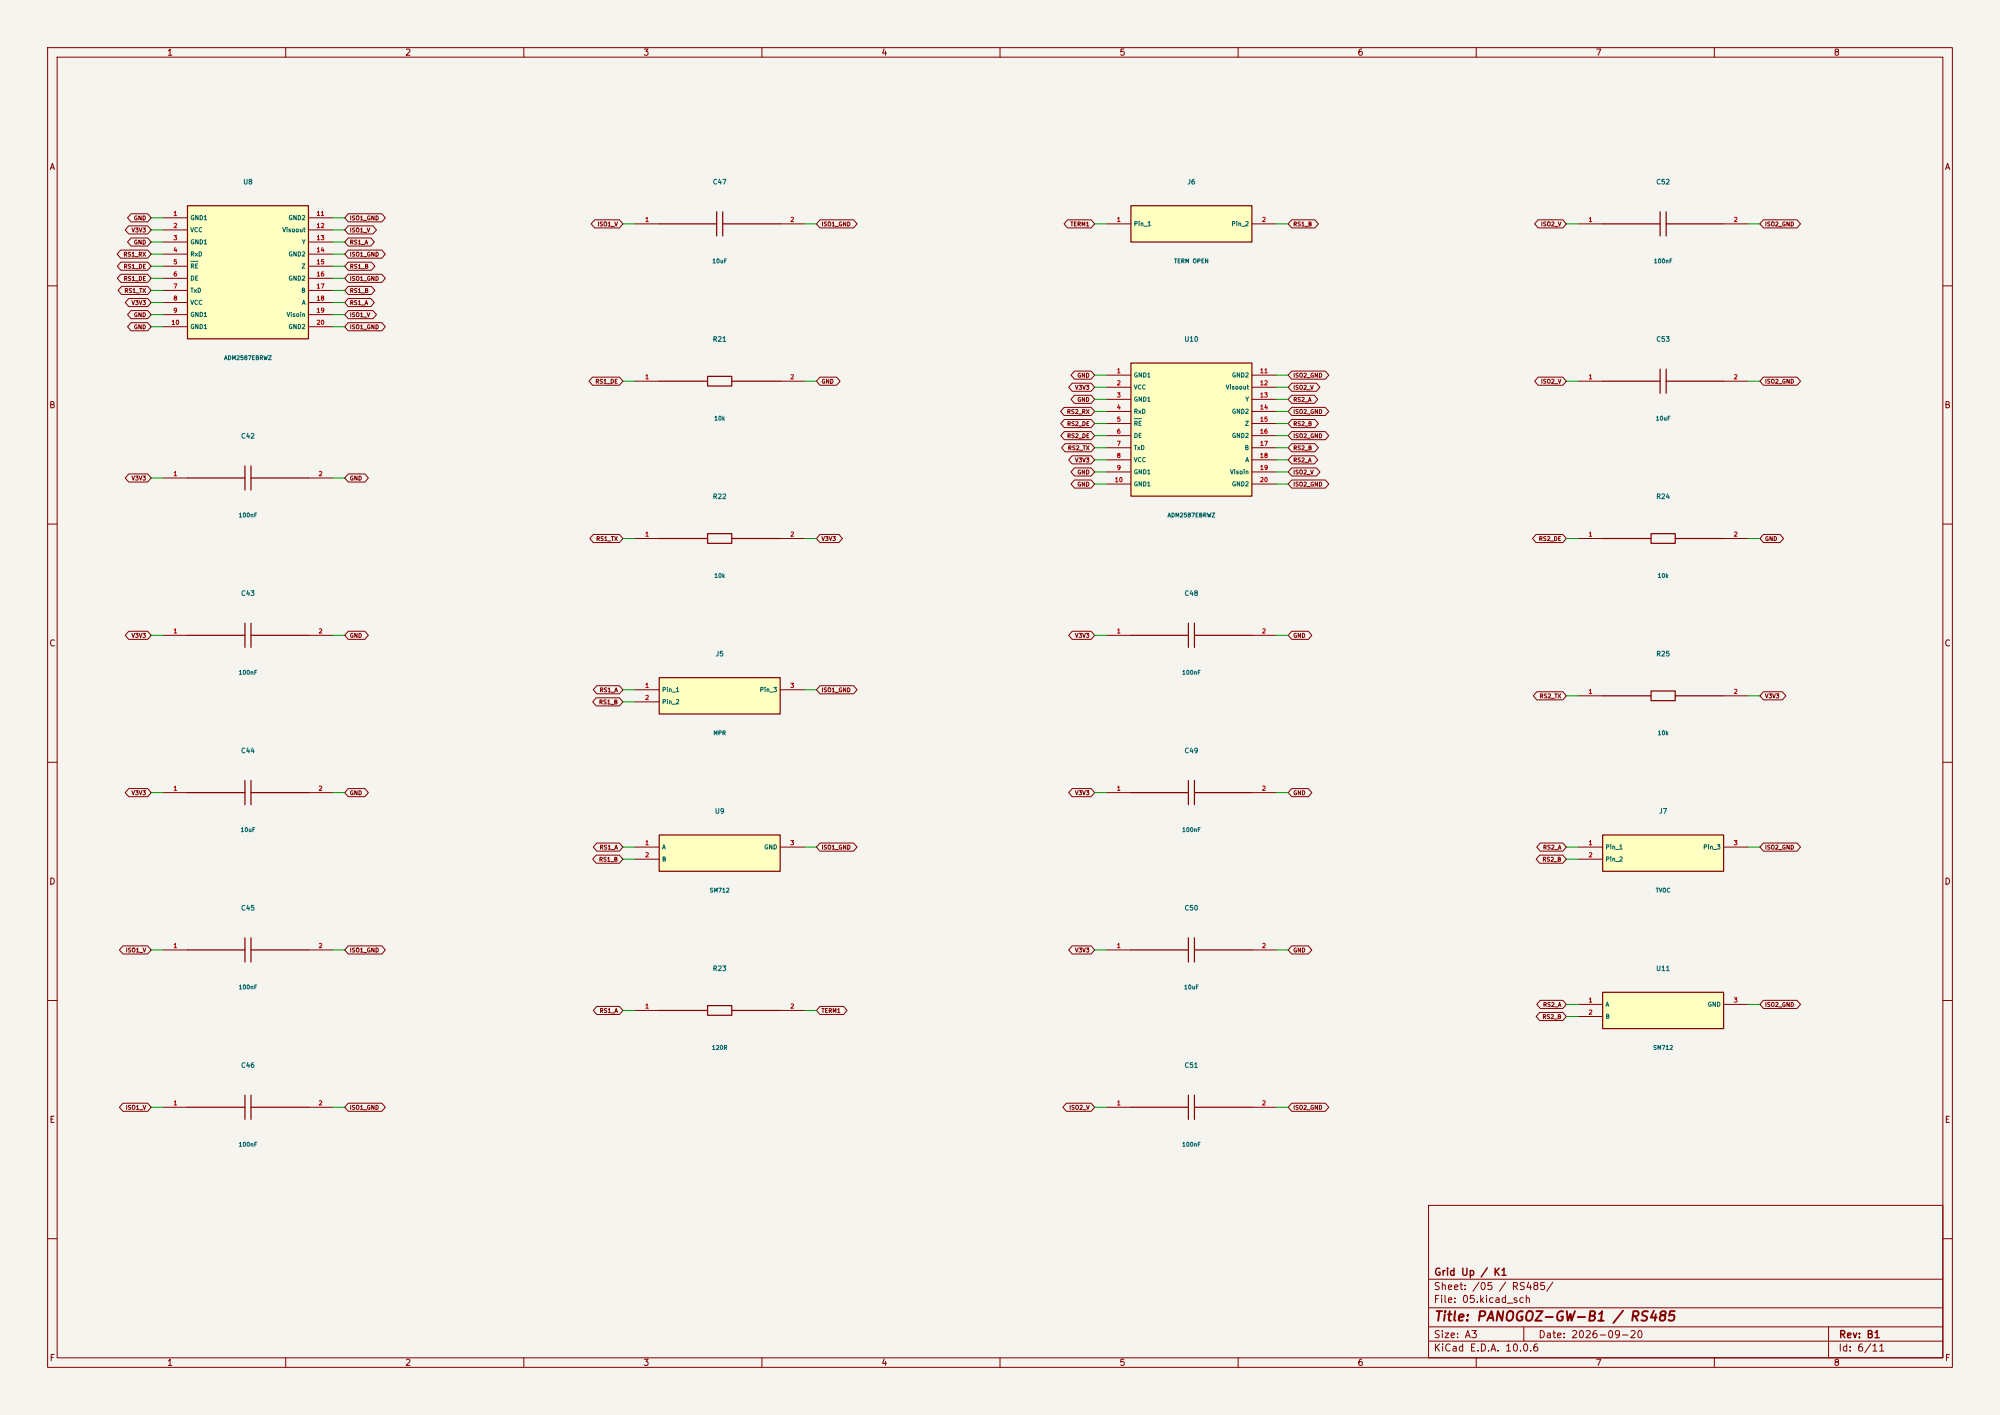
[picture p43: page 6]

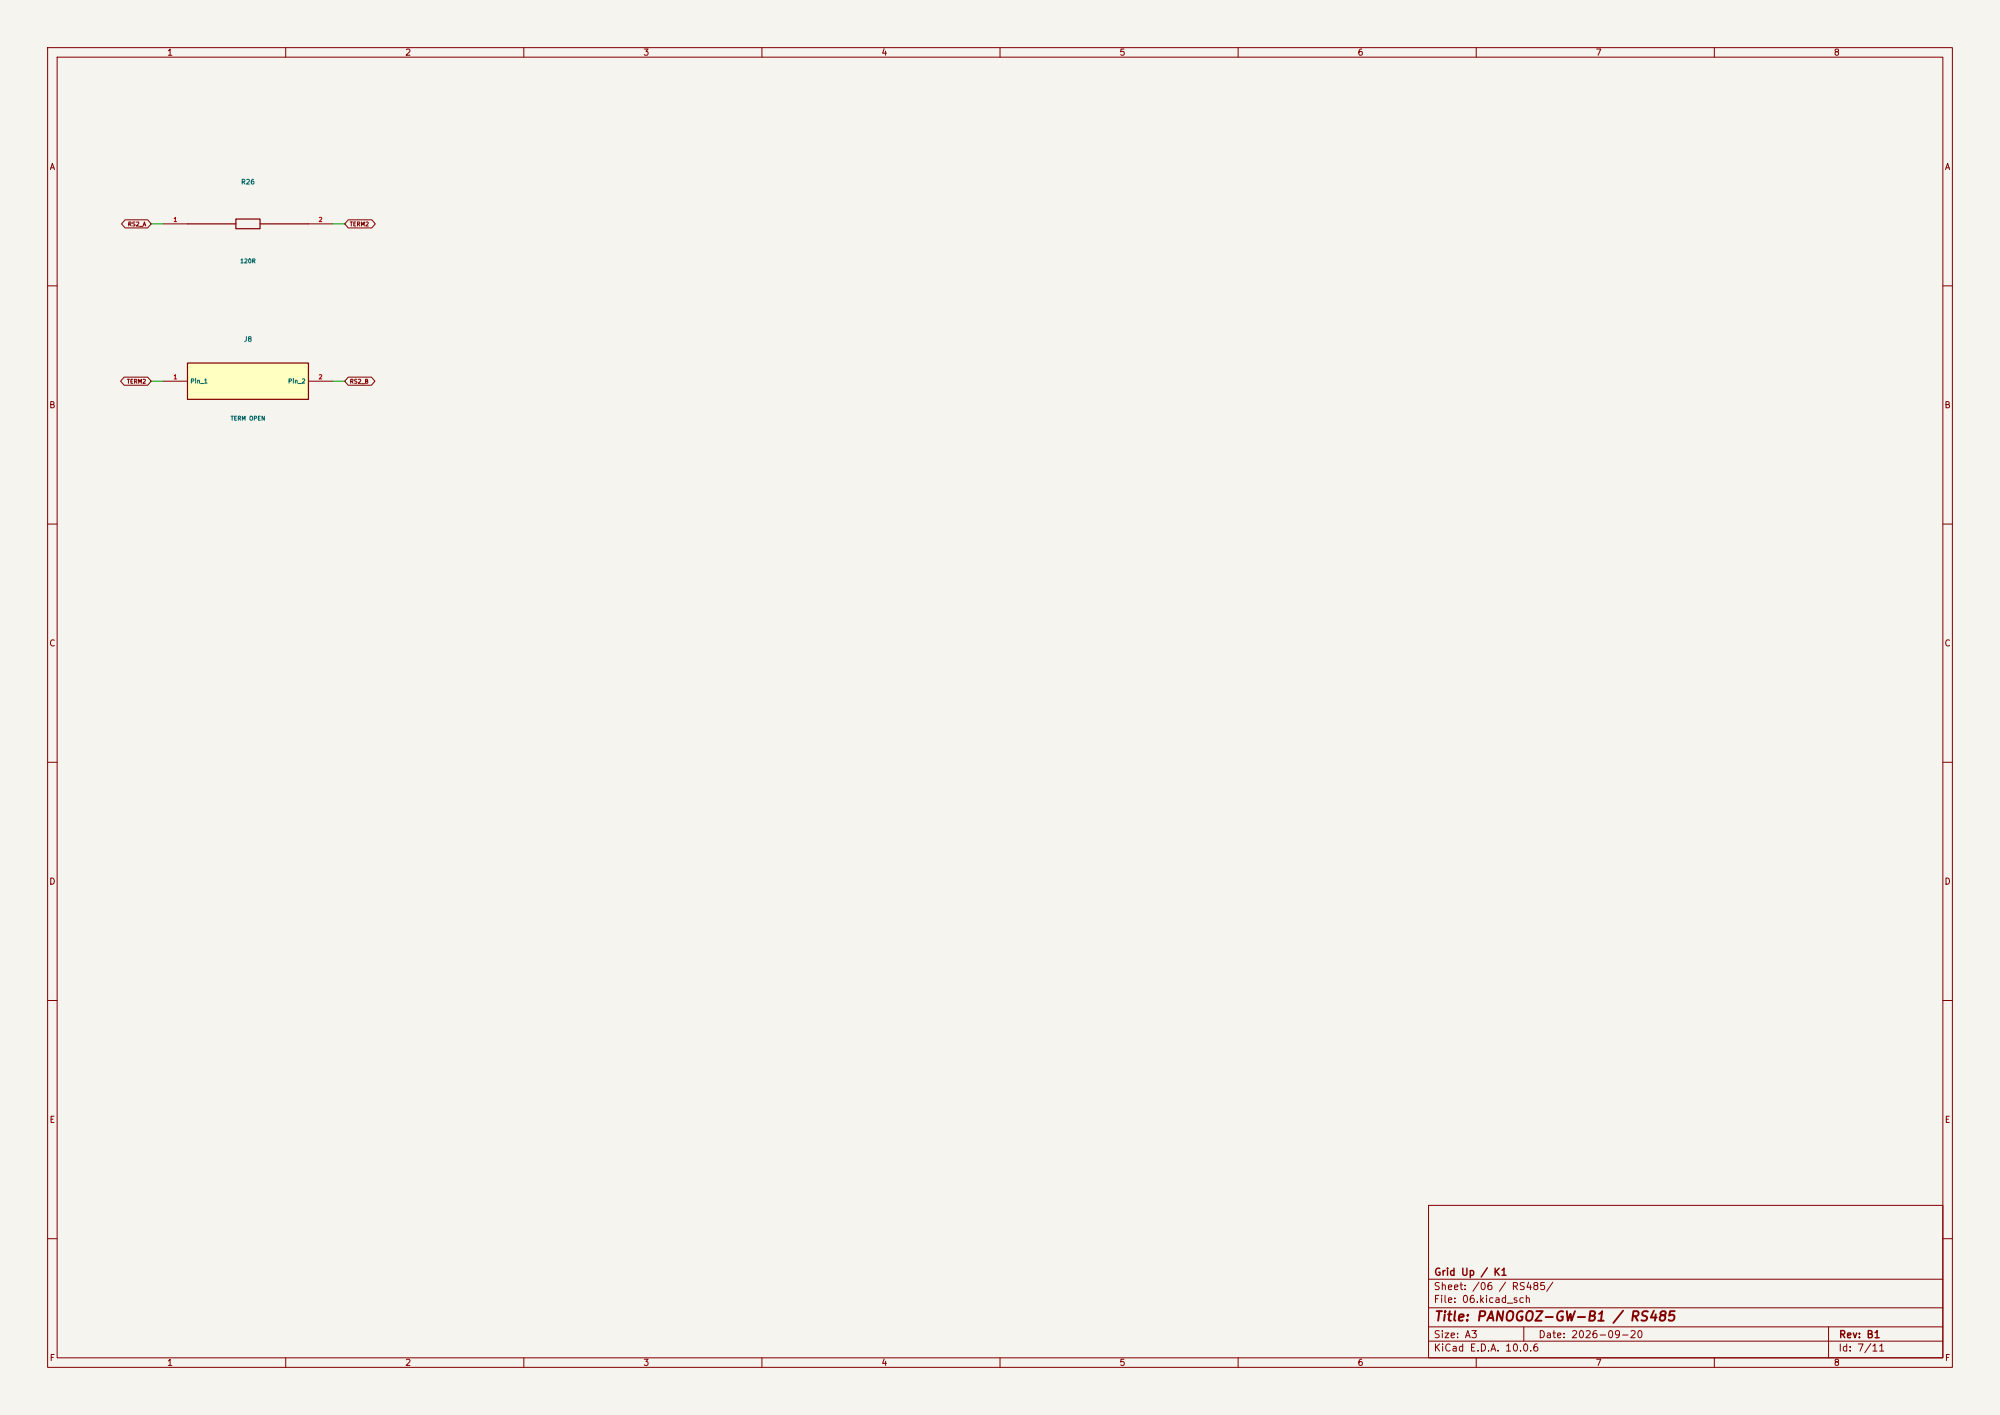
[picture p44: page 7]

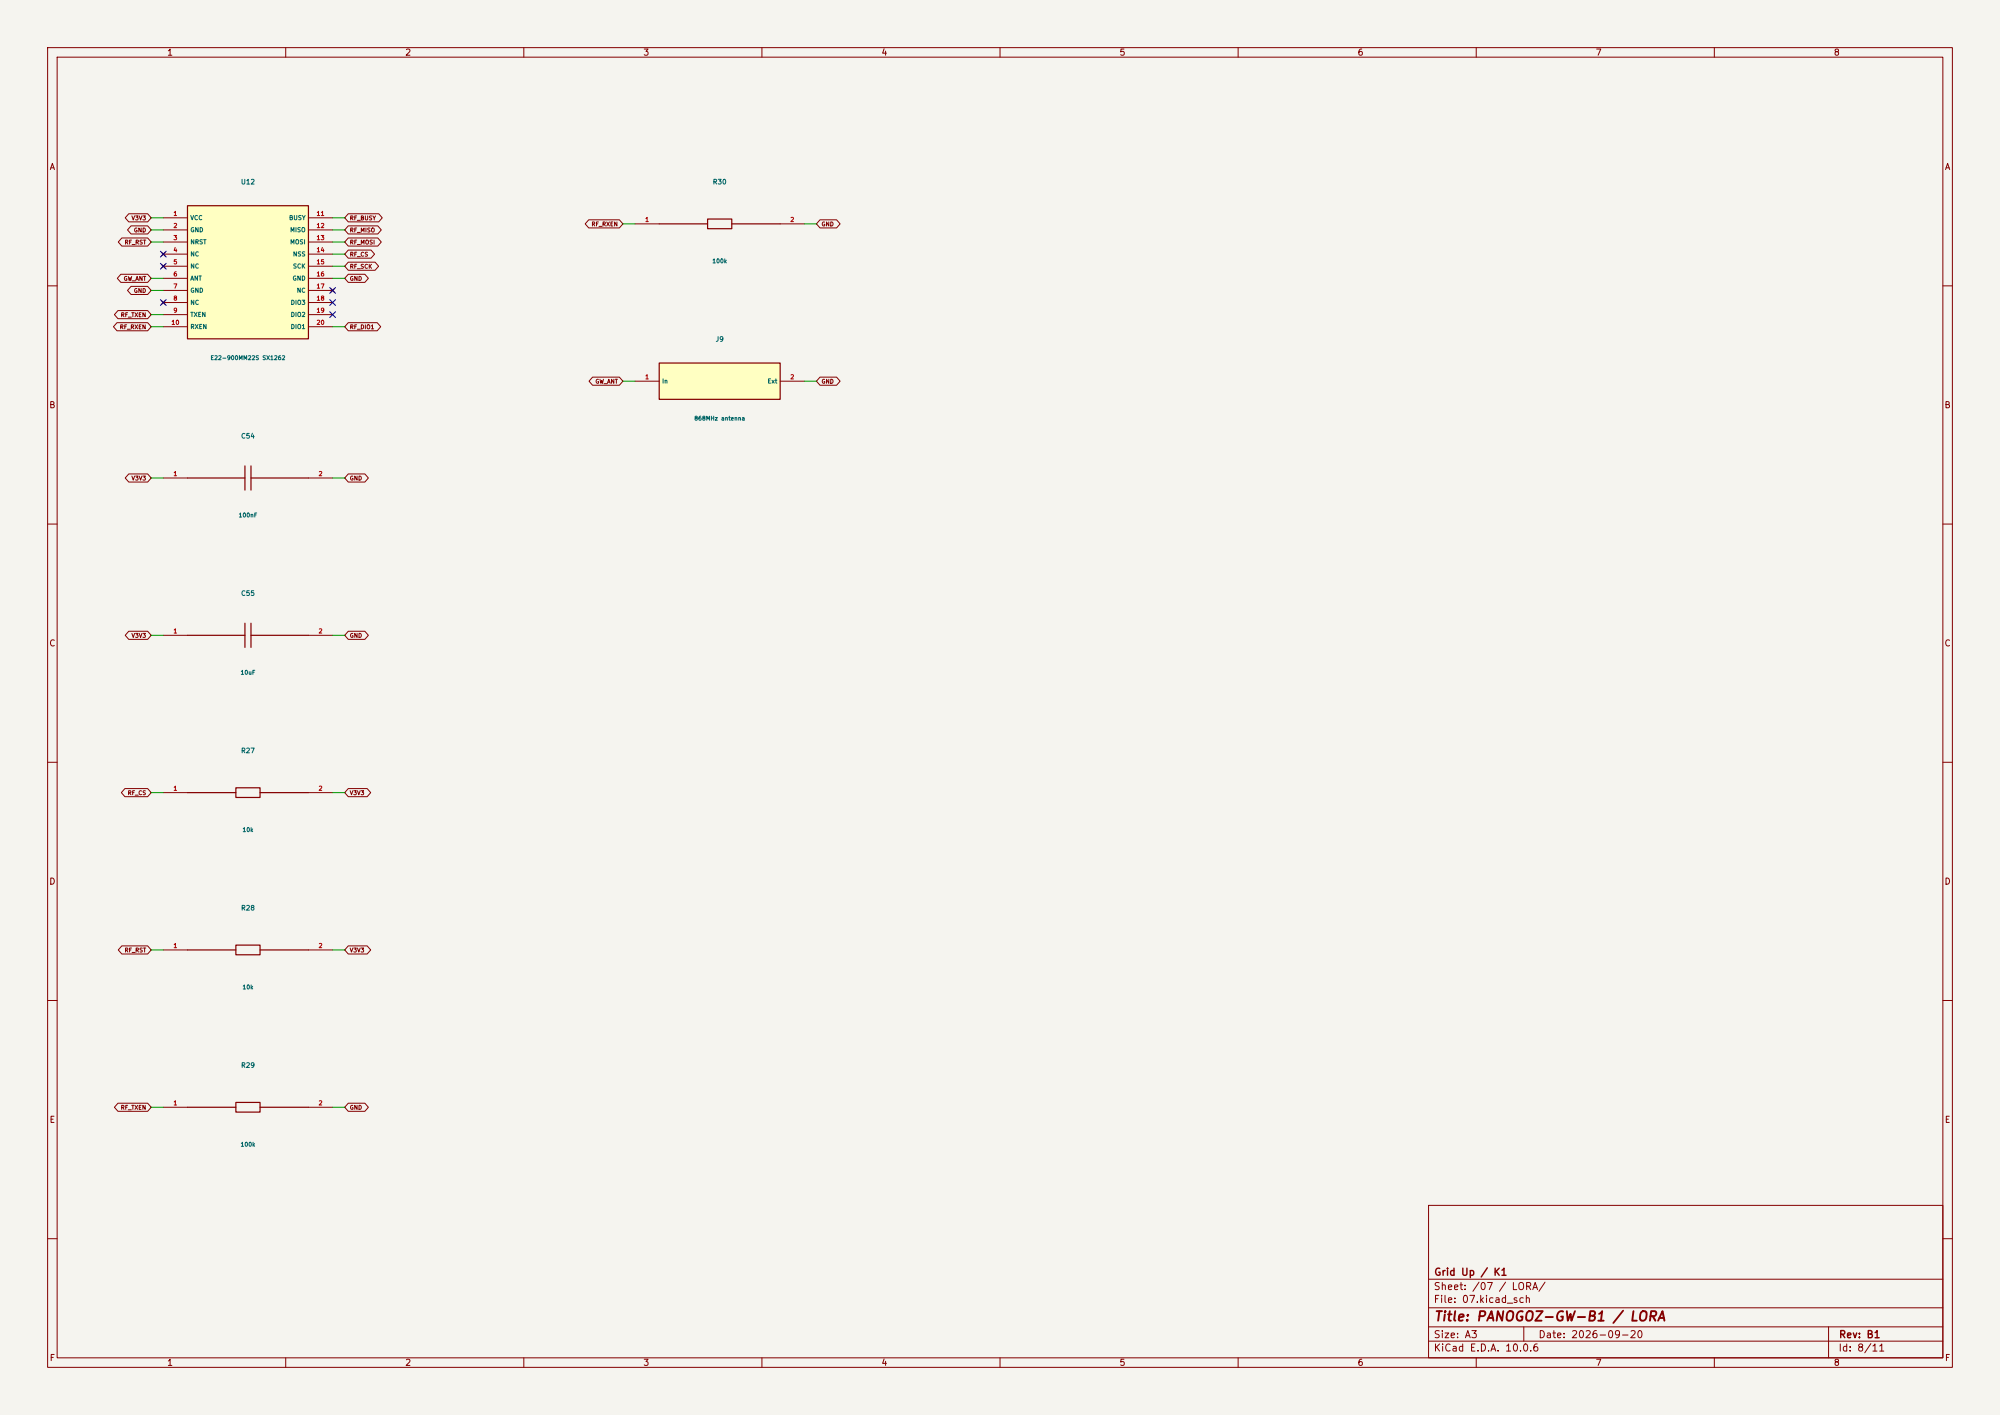
[picture p45: page 8]

Grid Up / K1
Sheet: /07 / LORA/
File: 07.kicad_sch
Title: PANOGOZ-GW-B1 / LORA

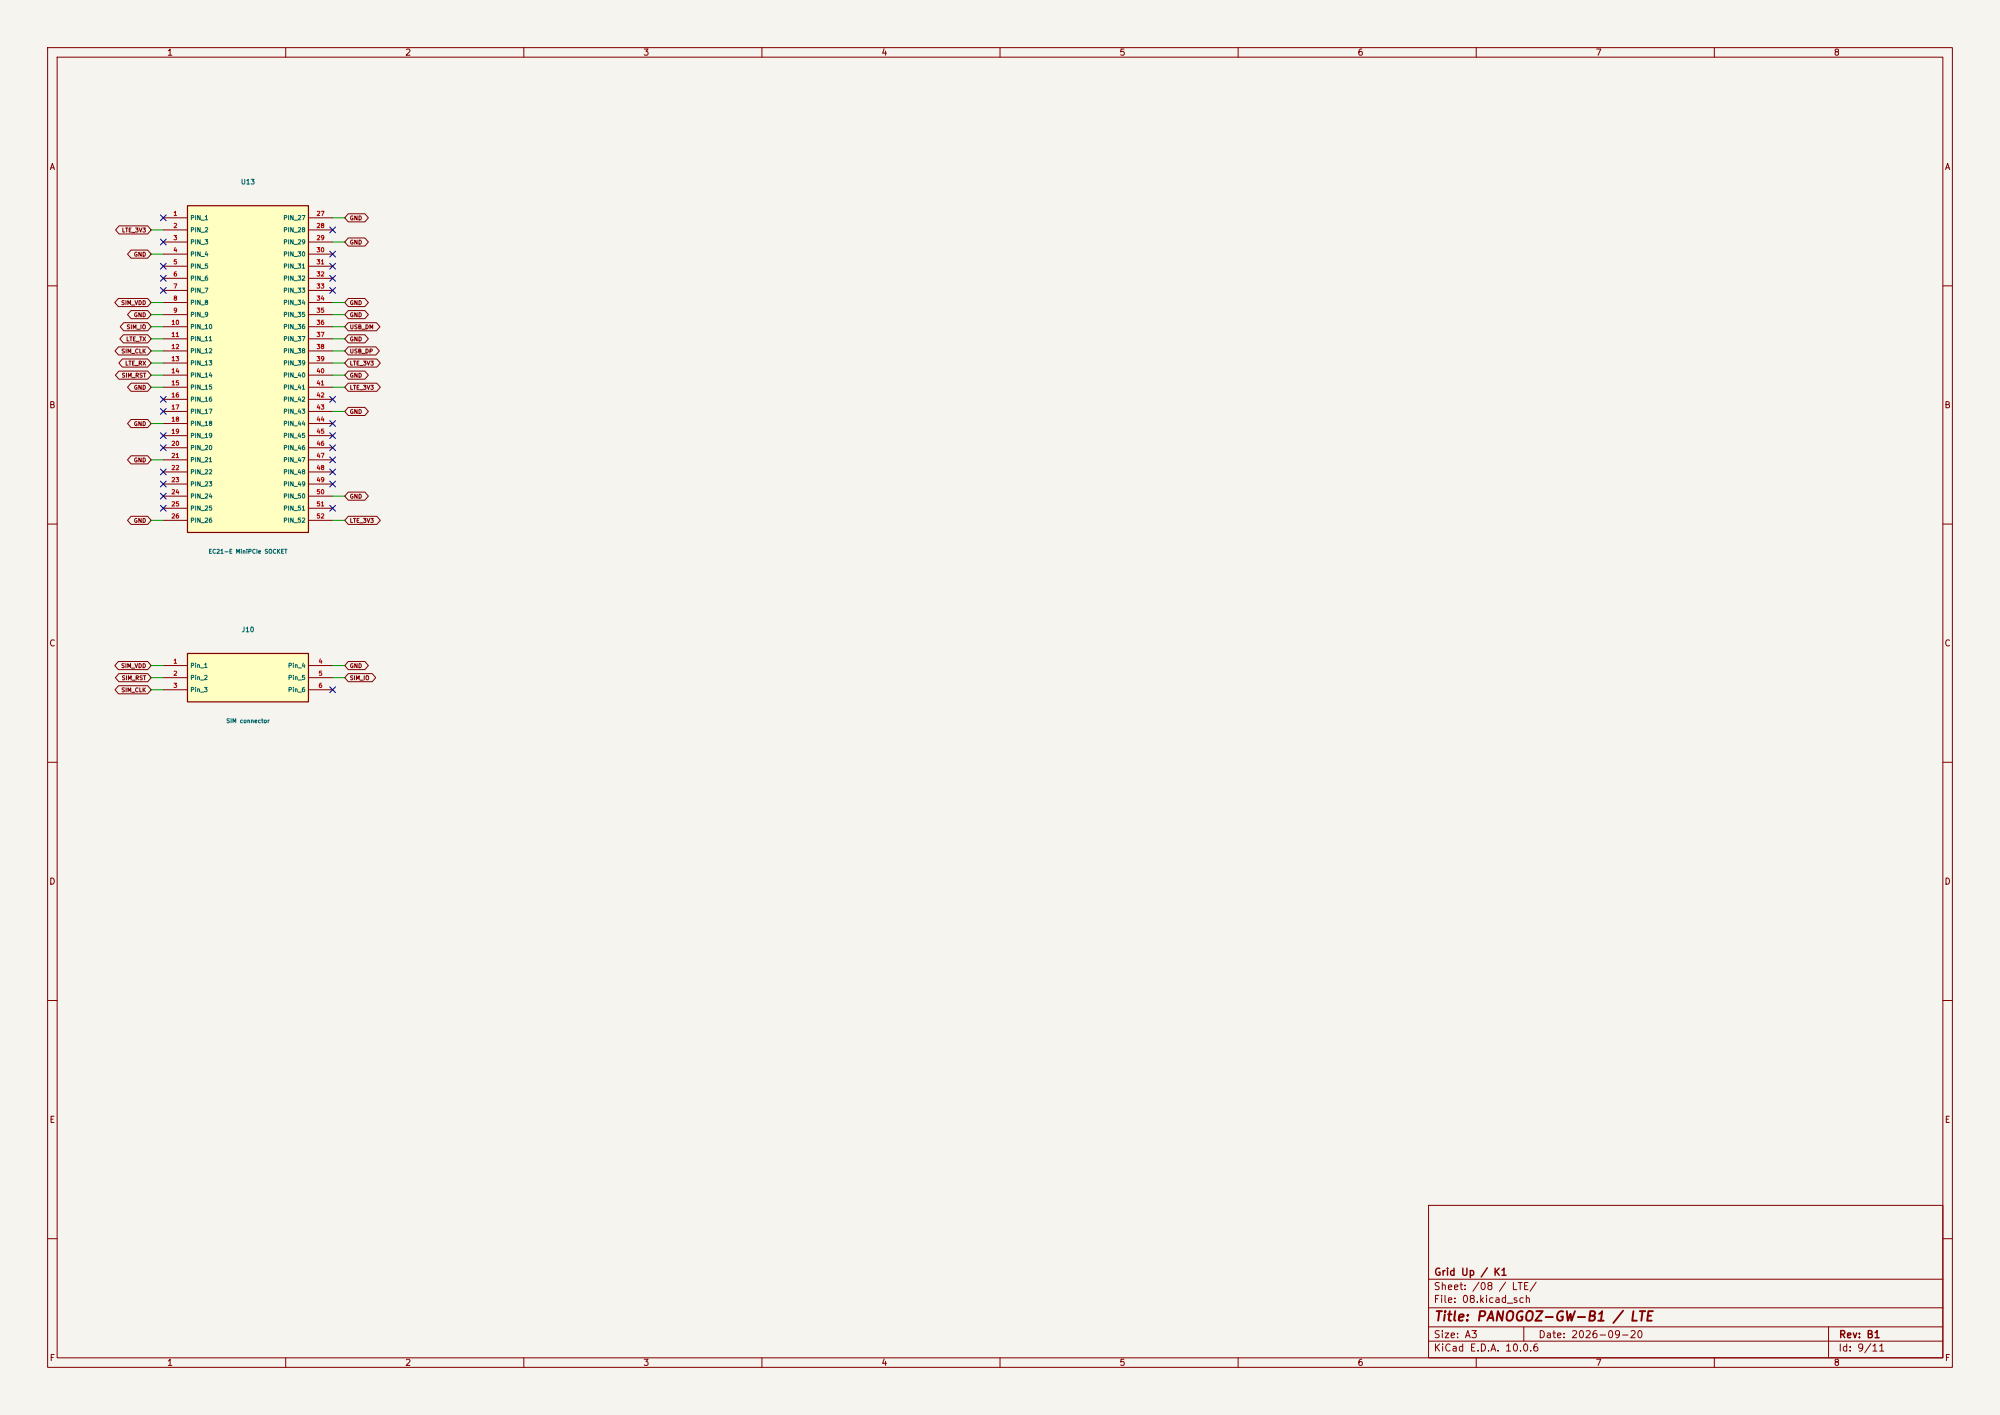
[picture p46: page 9]

Grid Up / K1
Sheet: /08 / LTE/
File: 08.kicad_sch
Title: PANOGOZ-GW-B1 / LTE

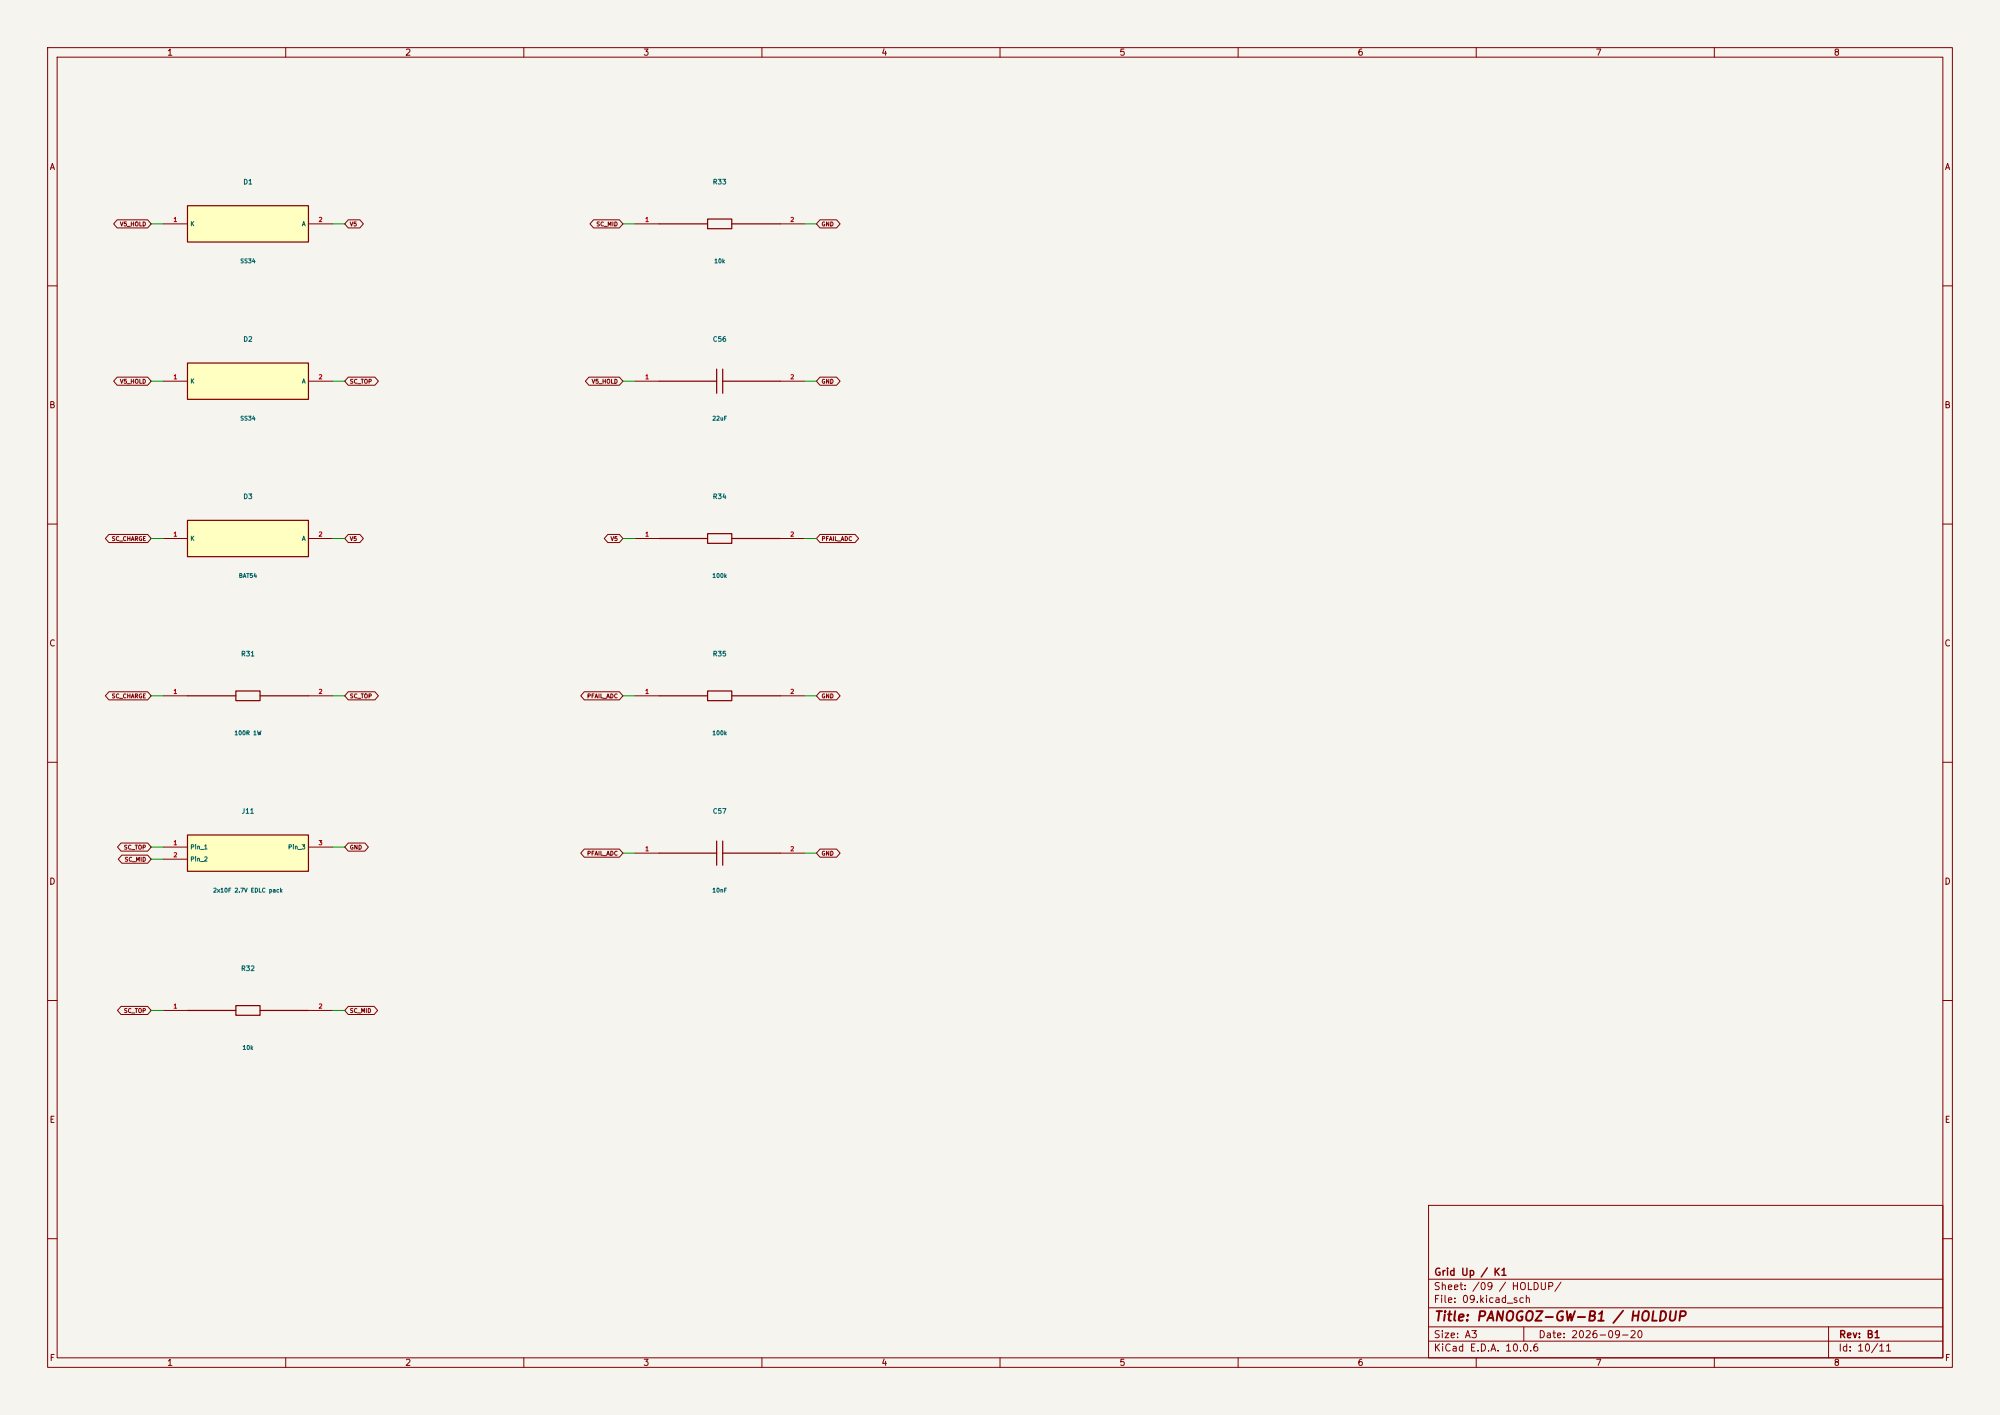
[picture p47: page 10]

Grid Up / K1
Sheet: /09 / HOLDUP/
File: 09.kicad_sch
Title: PANOGOZ-GW-B1 / HOLDUP

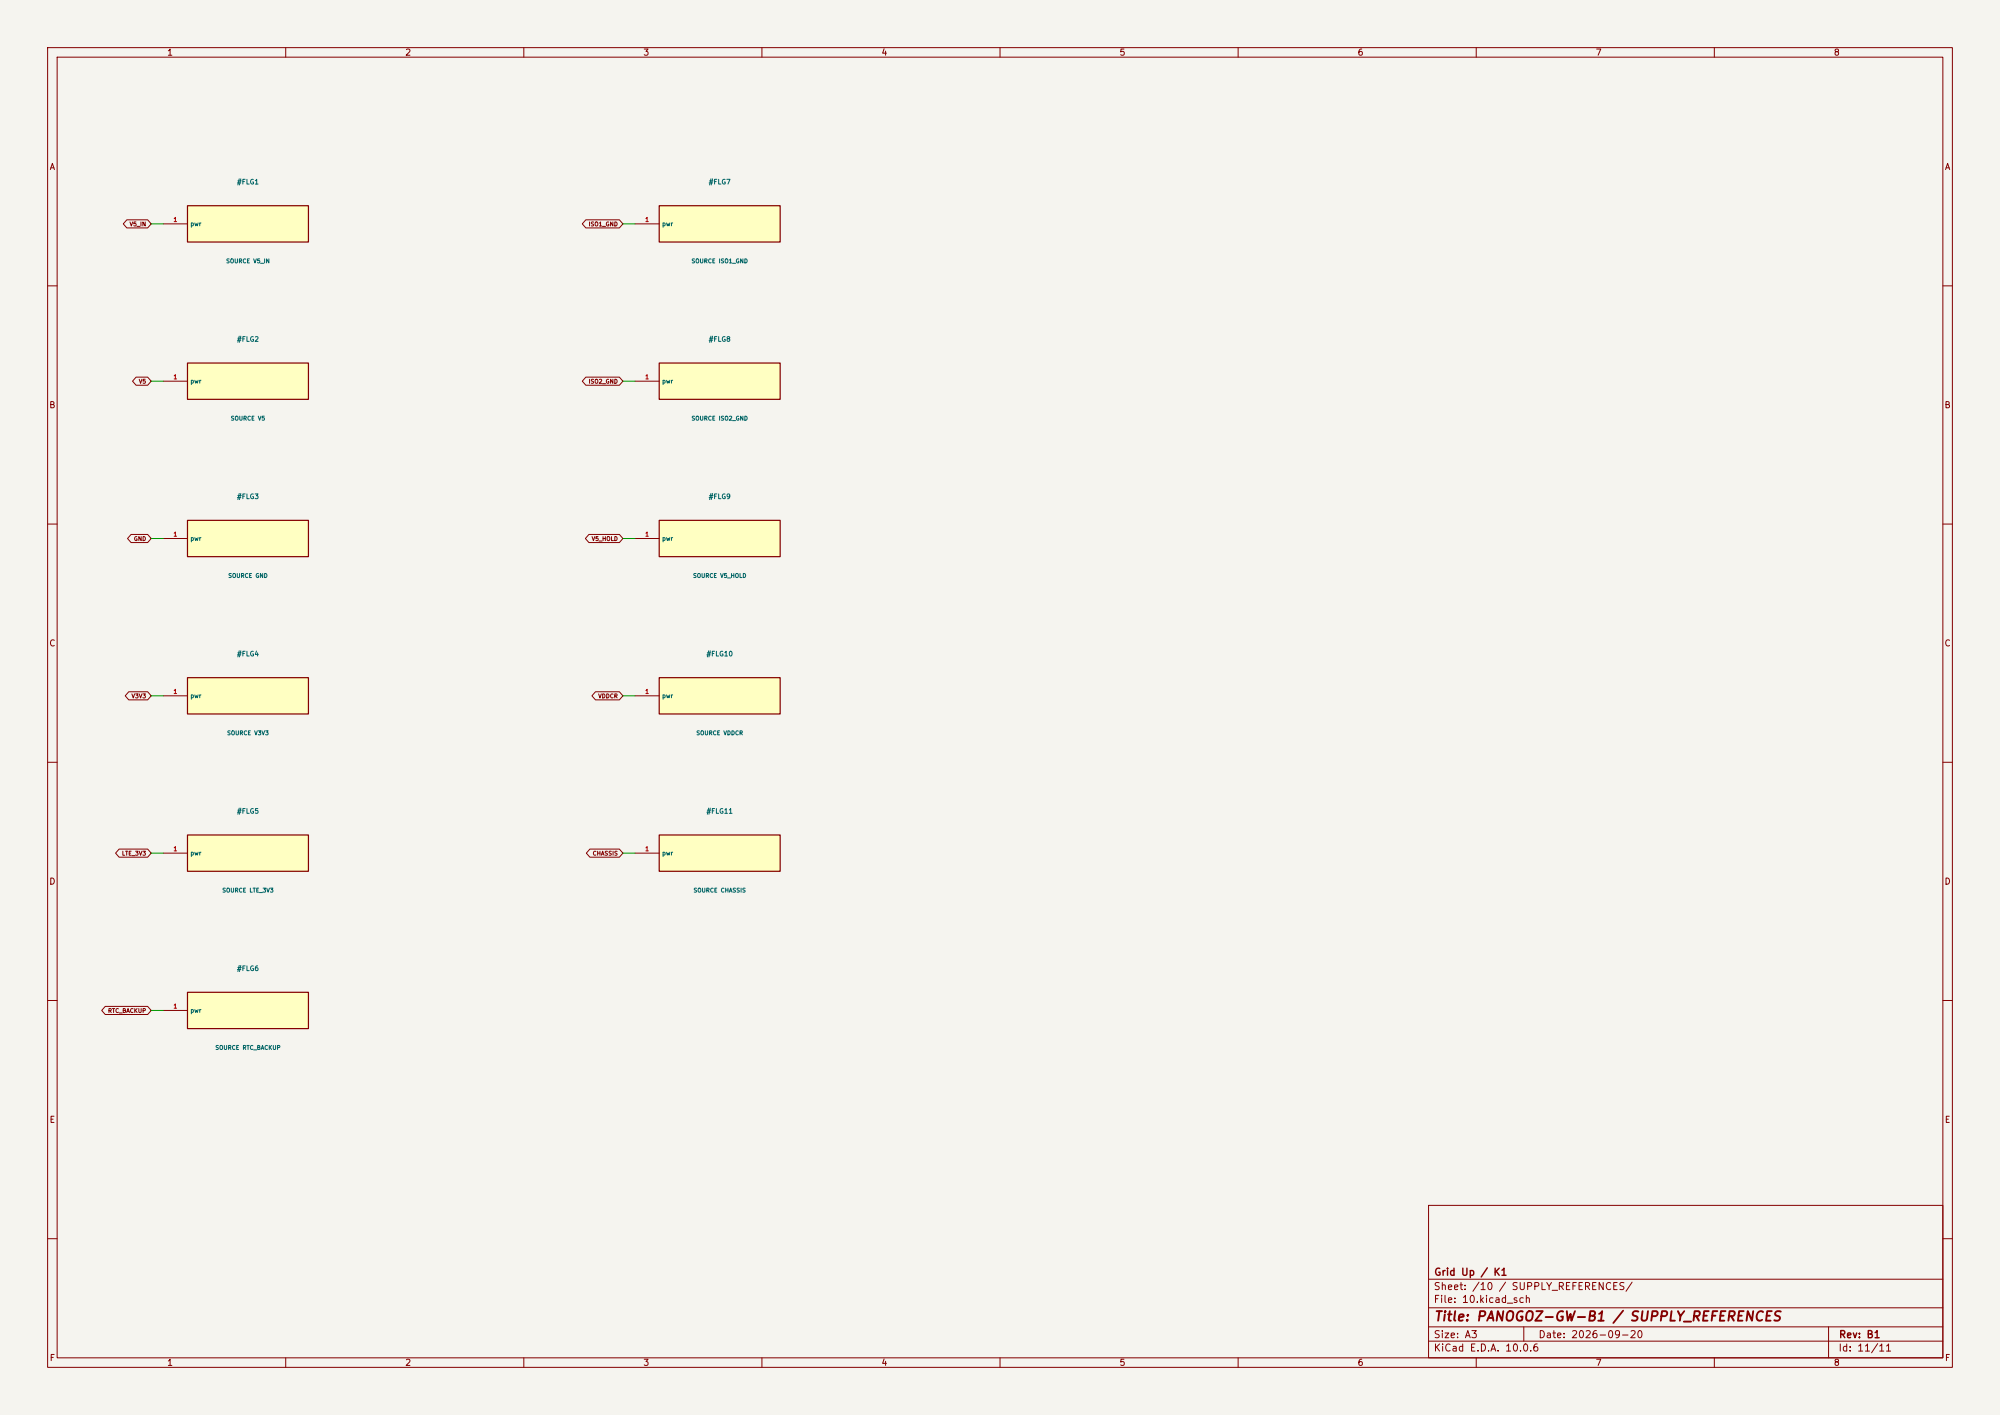
[picture p48: page 11]
