hackathon-buke-team/grid-up/hardware/B1/IR/schematic.pdf

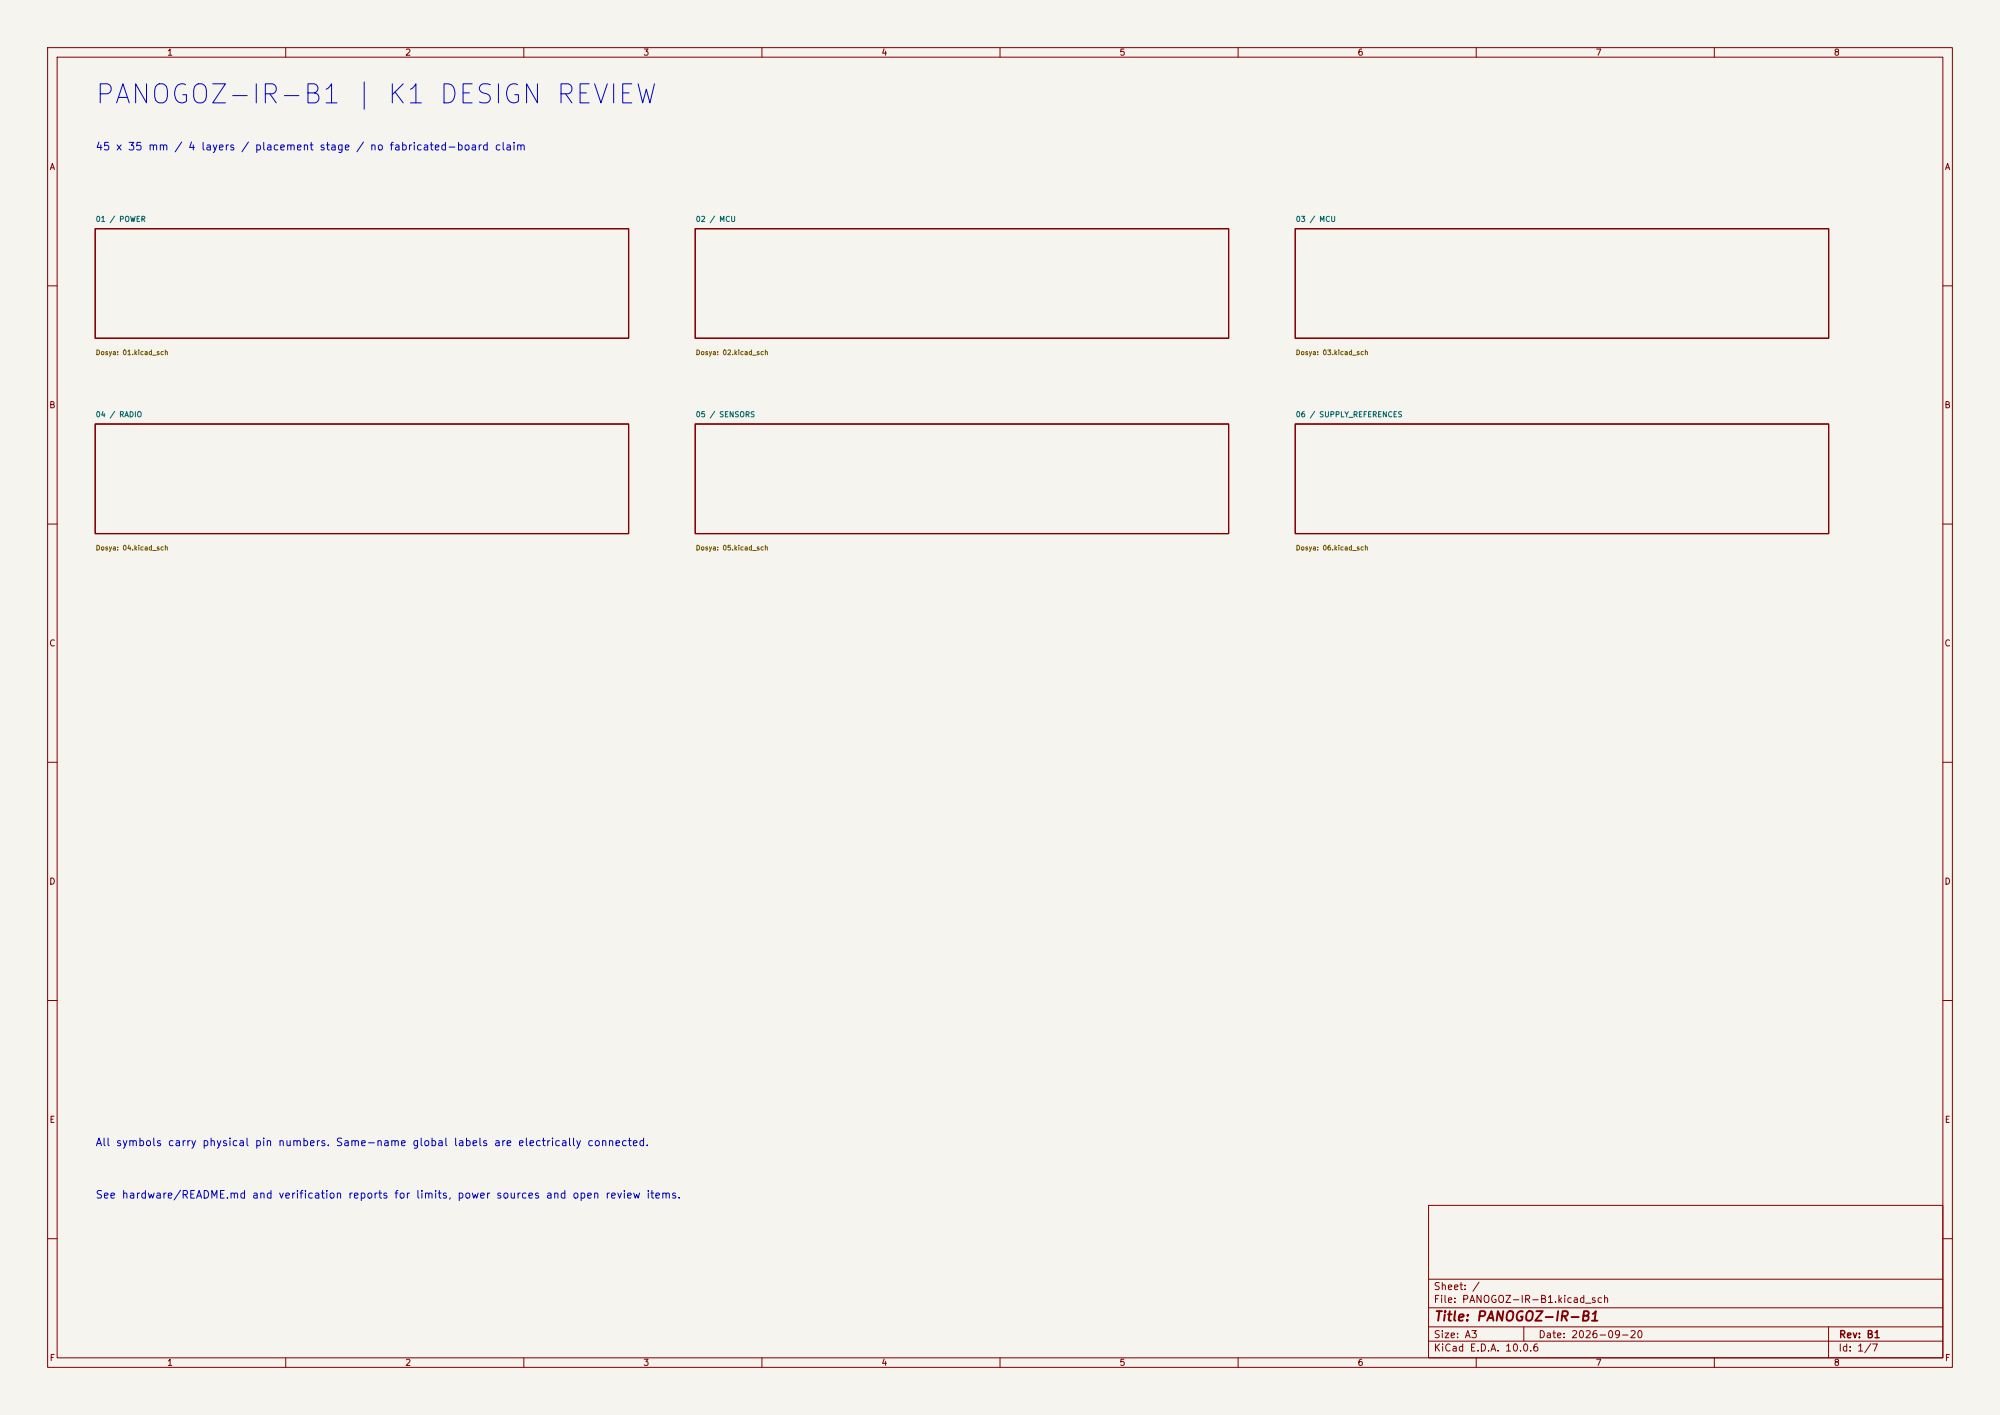
[picture p49: page 1]

Dosya: 04.kicad_sch PANOGOZ-IR-B1 | K1 DESIGN REVIEW

45 x 35 mm / 4 layers / placement stage / no fabricated-board claim

All symbols carry physical pin numbers. Same-name global labels are electrically connected.

See hardware/README.md and verification reports for limits, power sources and open review items.

Size: A3 | Rev: B1 | F Date: 2026-09-20
KiCad E.D.A. 10.0.6 | Id: 1/7

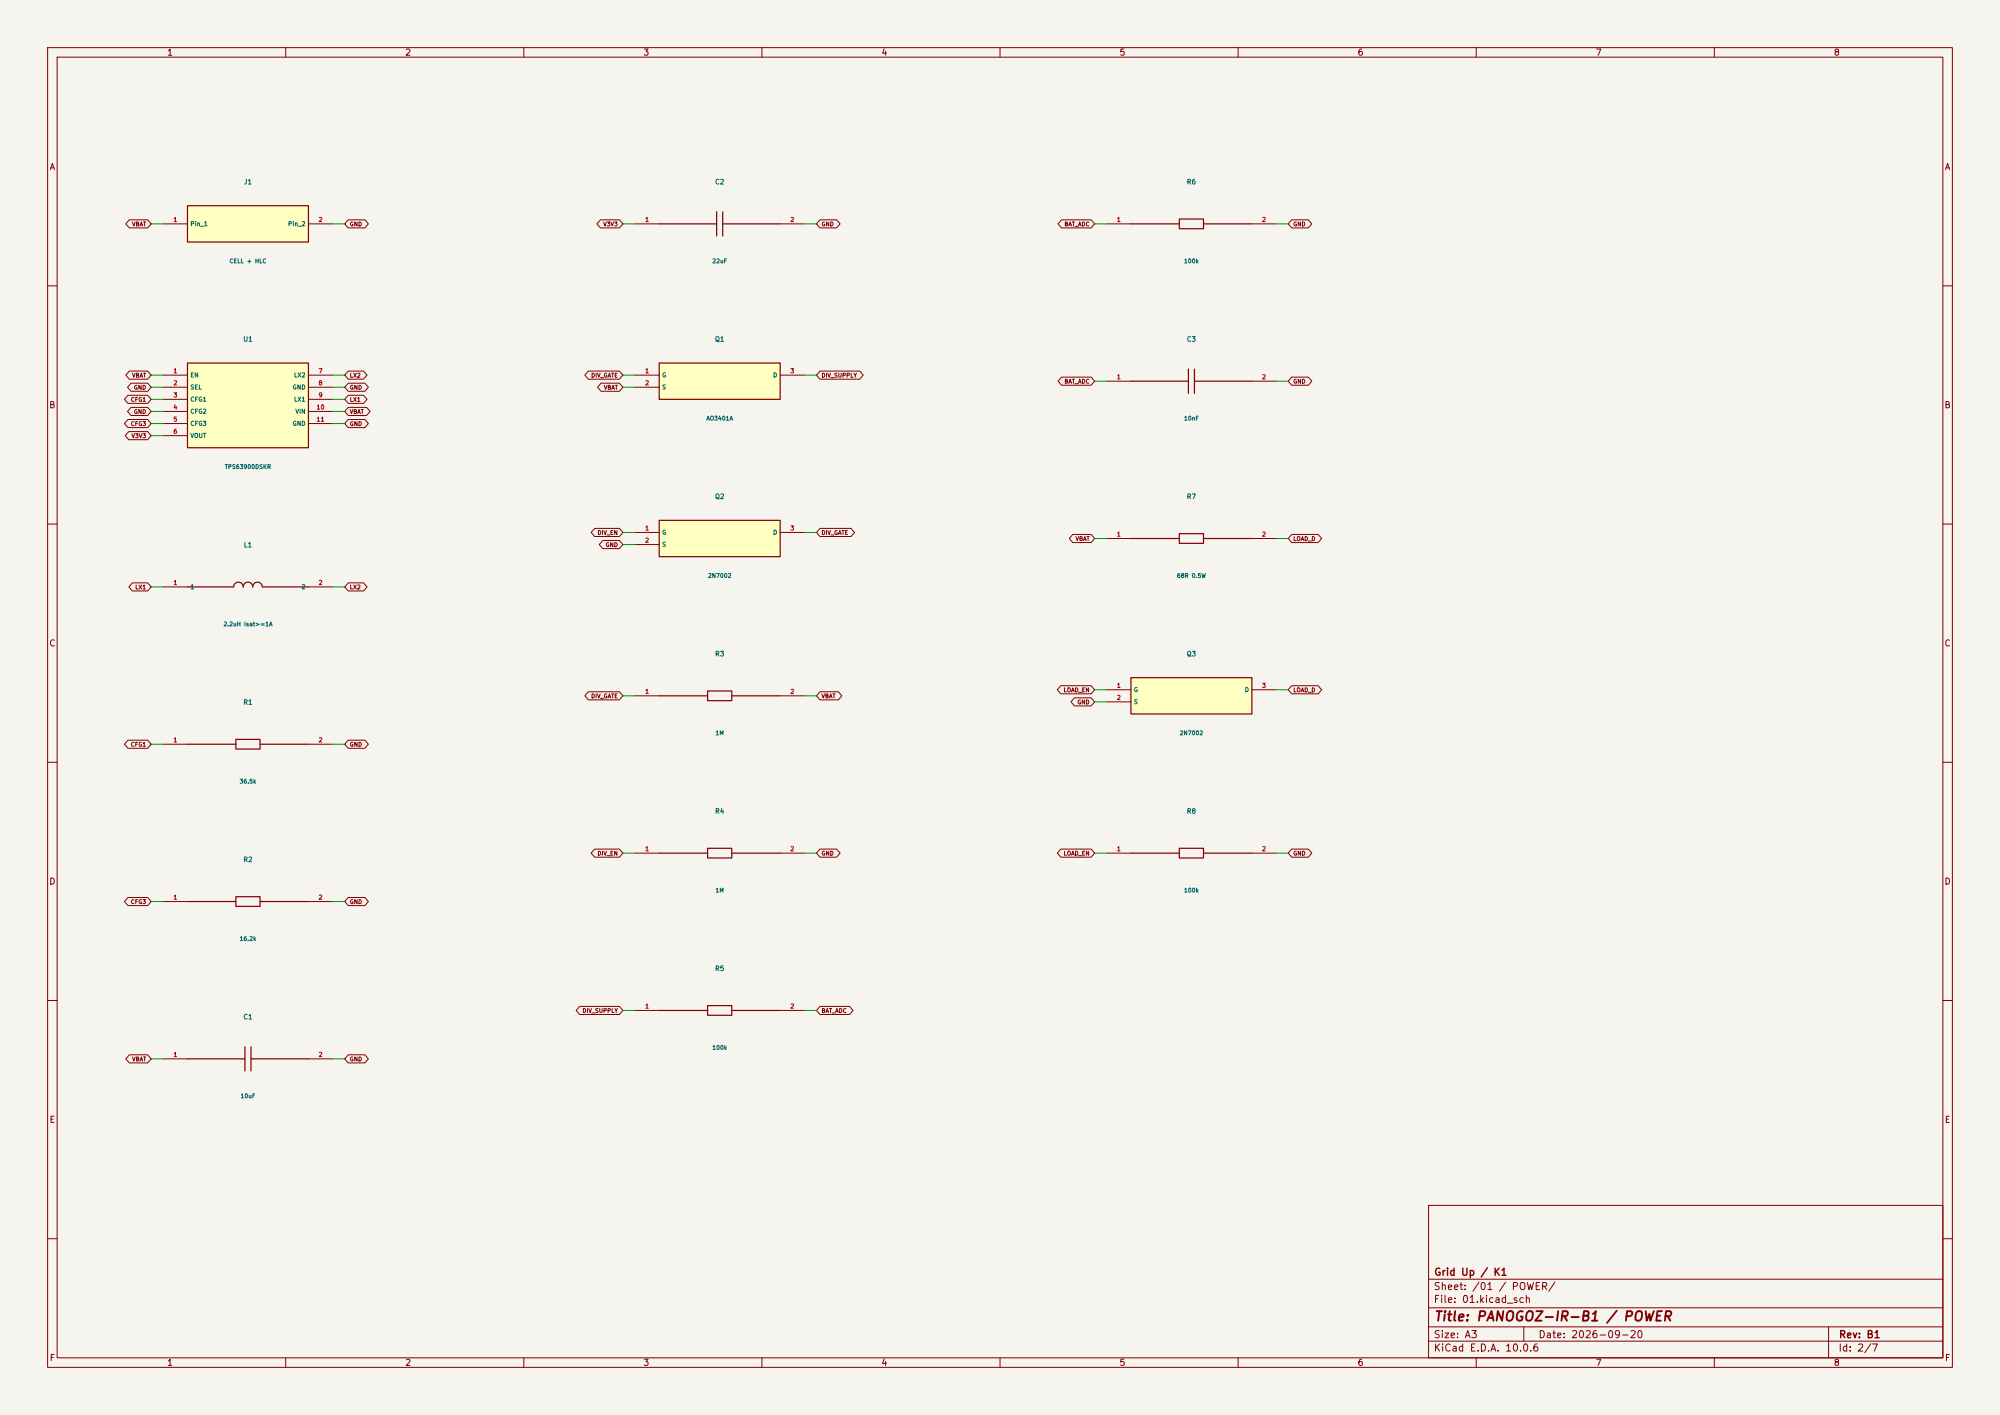
[picture p50: page 2]

Grid Up / K1
Sheet: /01 / POWER/
File: 01.kicad_sch
Title: PANOGOZ-IR-B1 / POWER

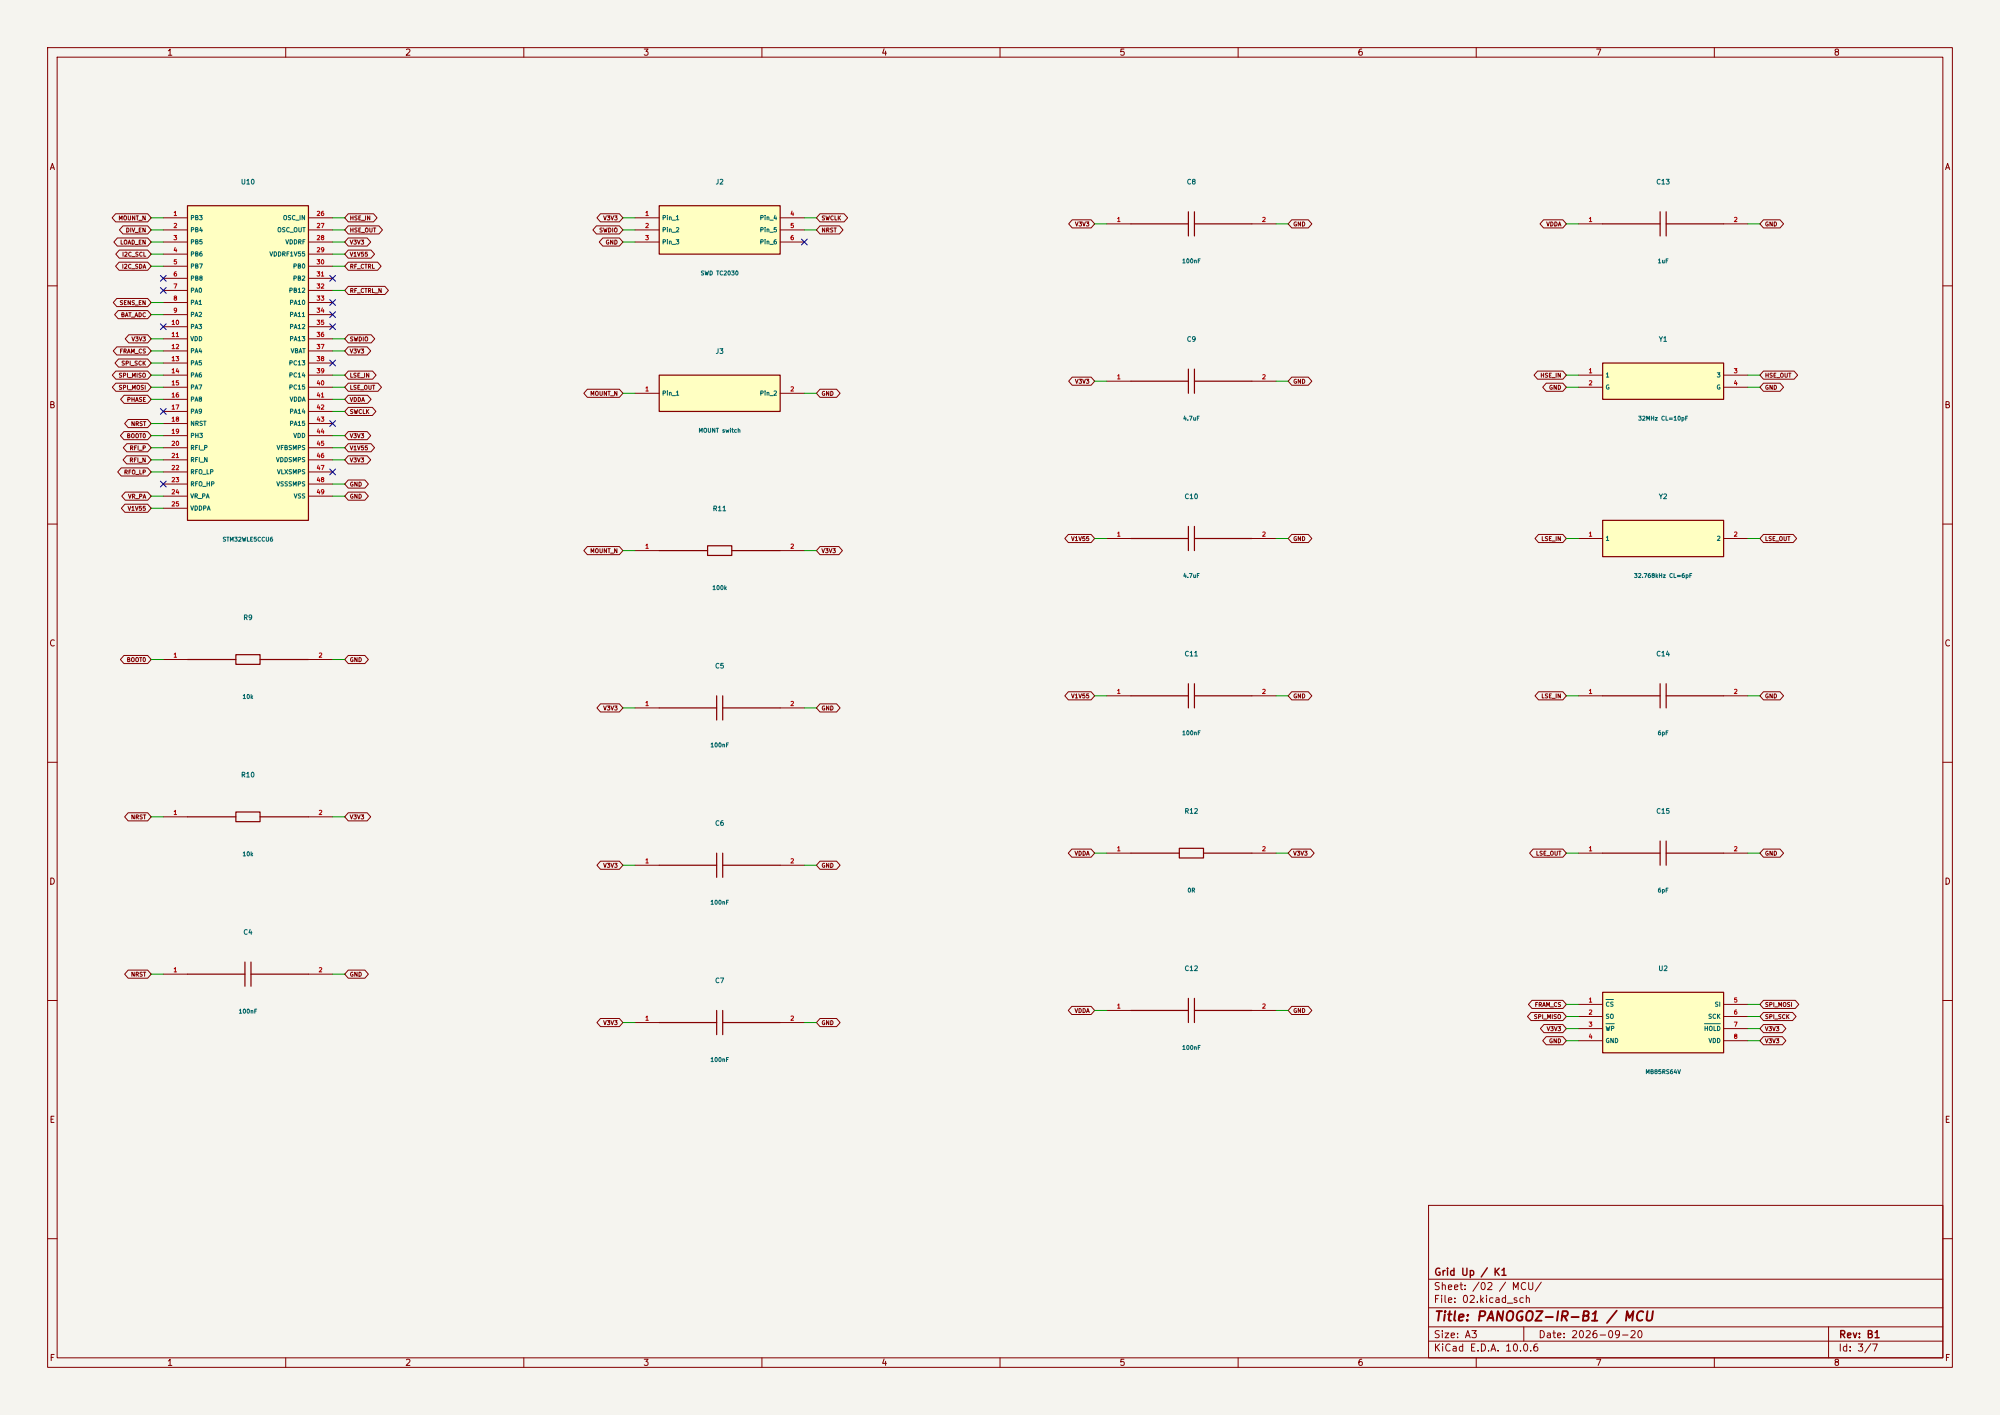
[picture p51: page 3]

Grid Up / K1
Sheet: /02 / MCU/
File: 02.kicad_sch
Title: PANOGOZ-IR-B1 / MCU

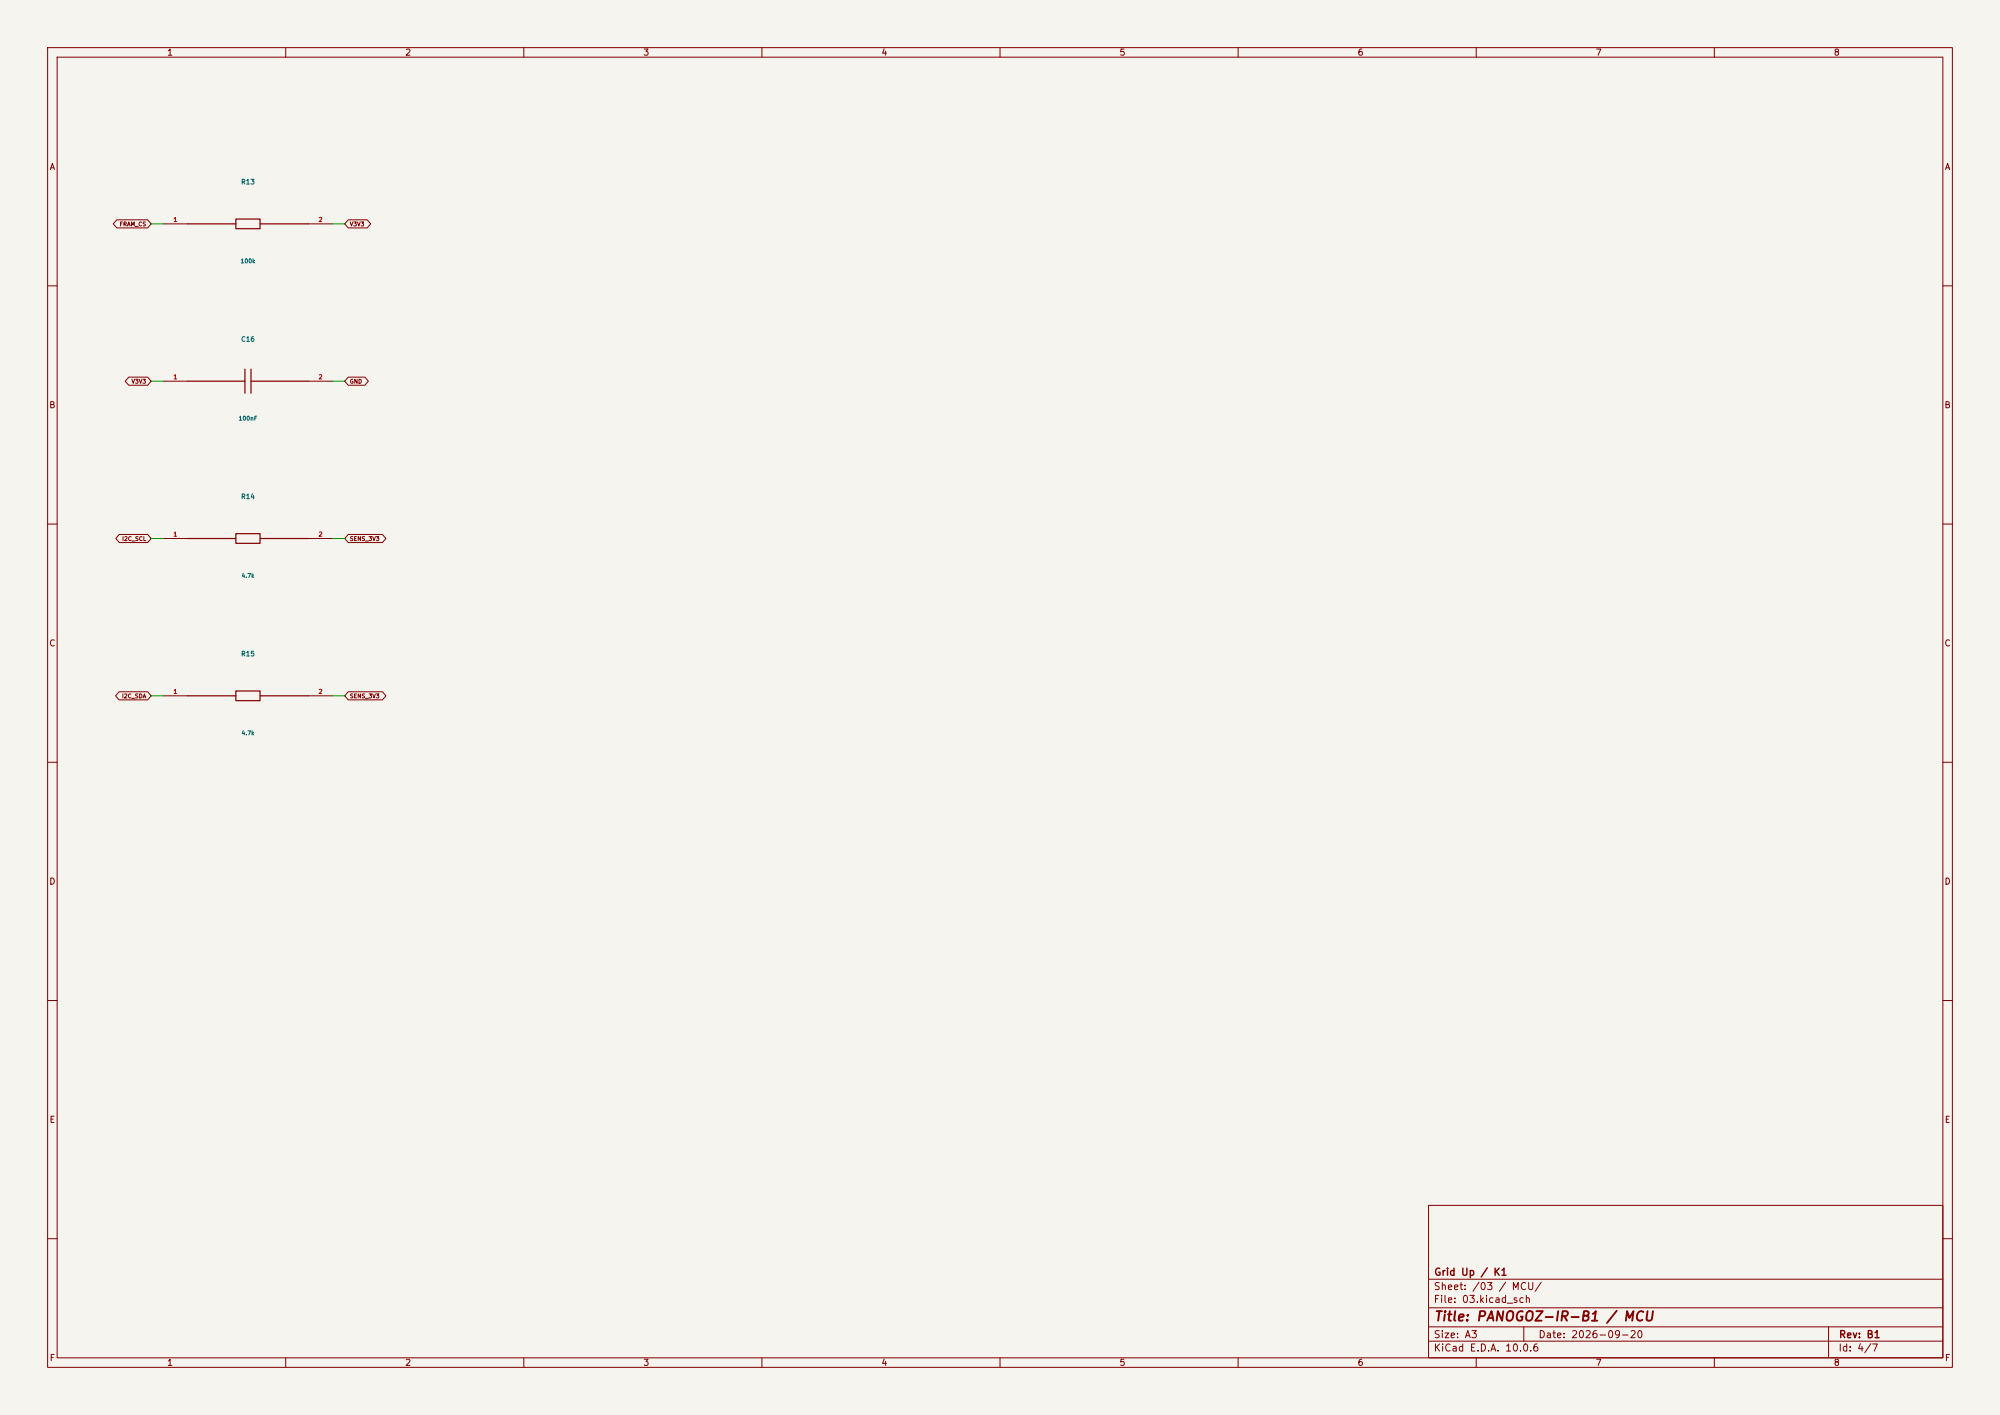
[picture p52: page 4]

Grid Up / K1
Sheet: /03 / MCU/
File: 03.kicad_sch
Title: PANOGOZ-IR-B1 / MCU

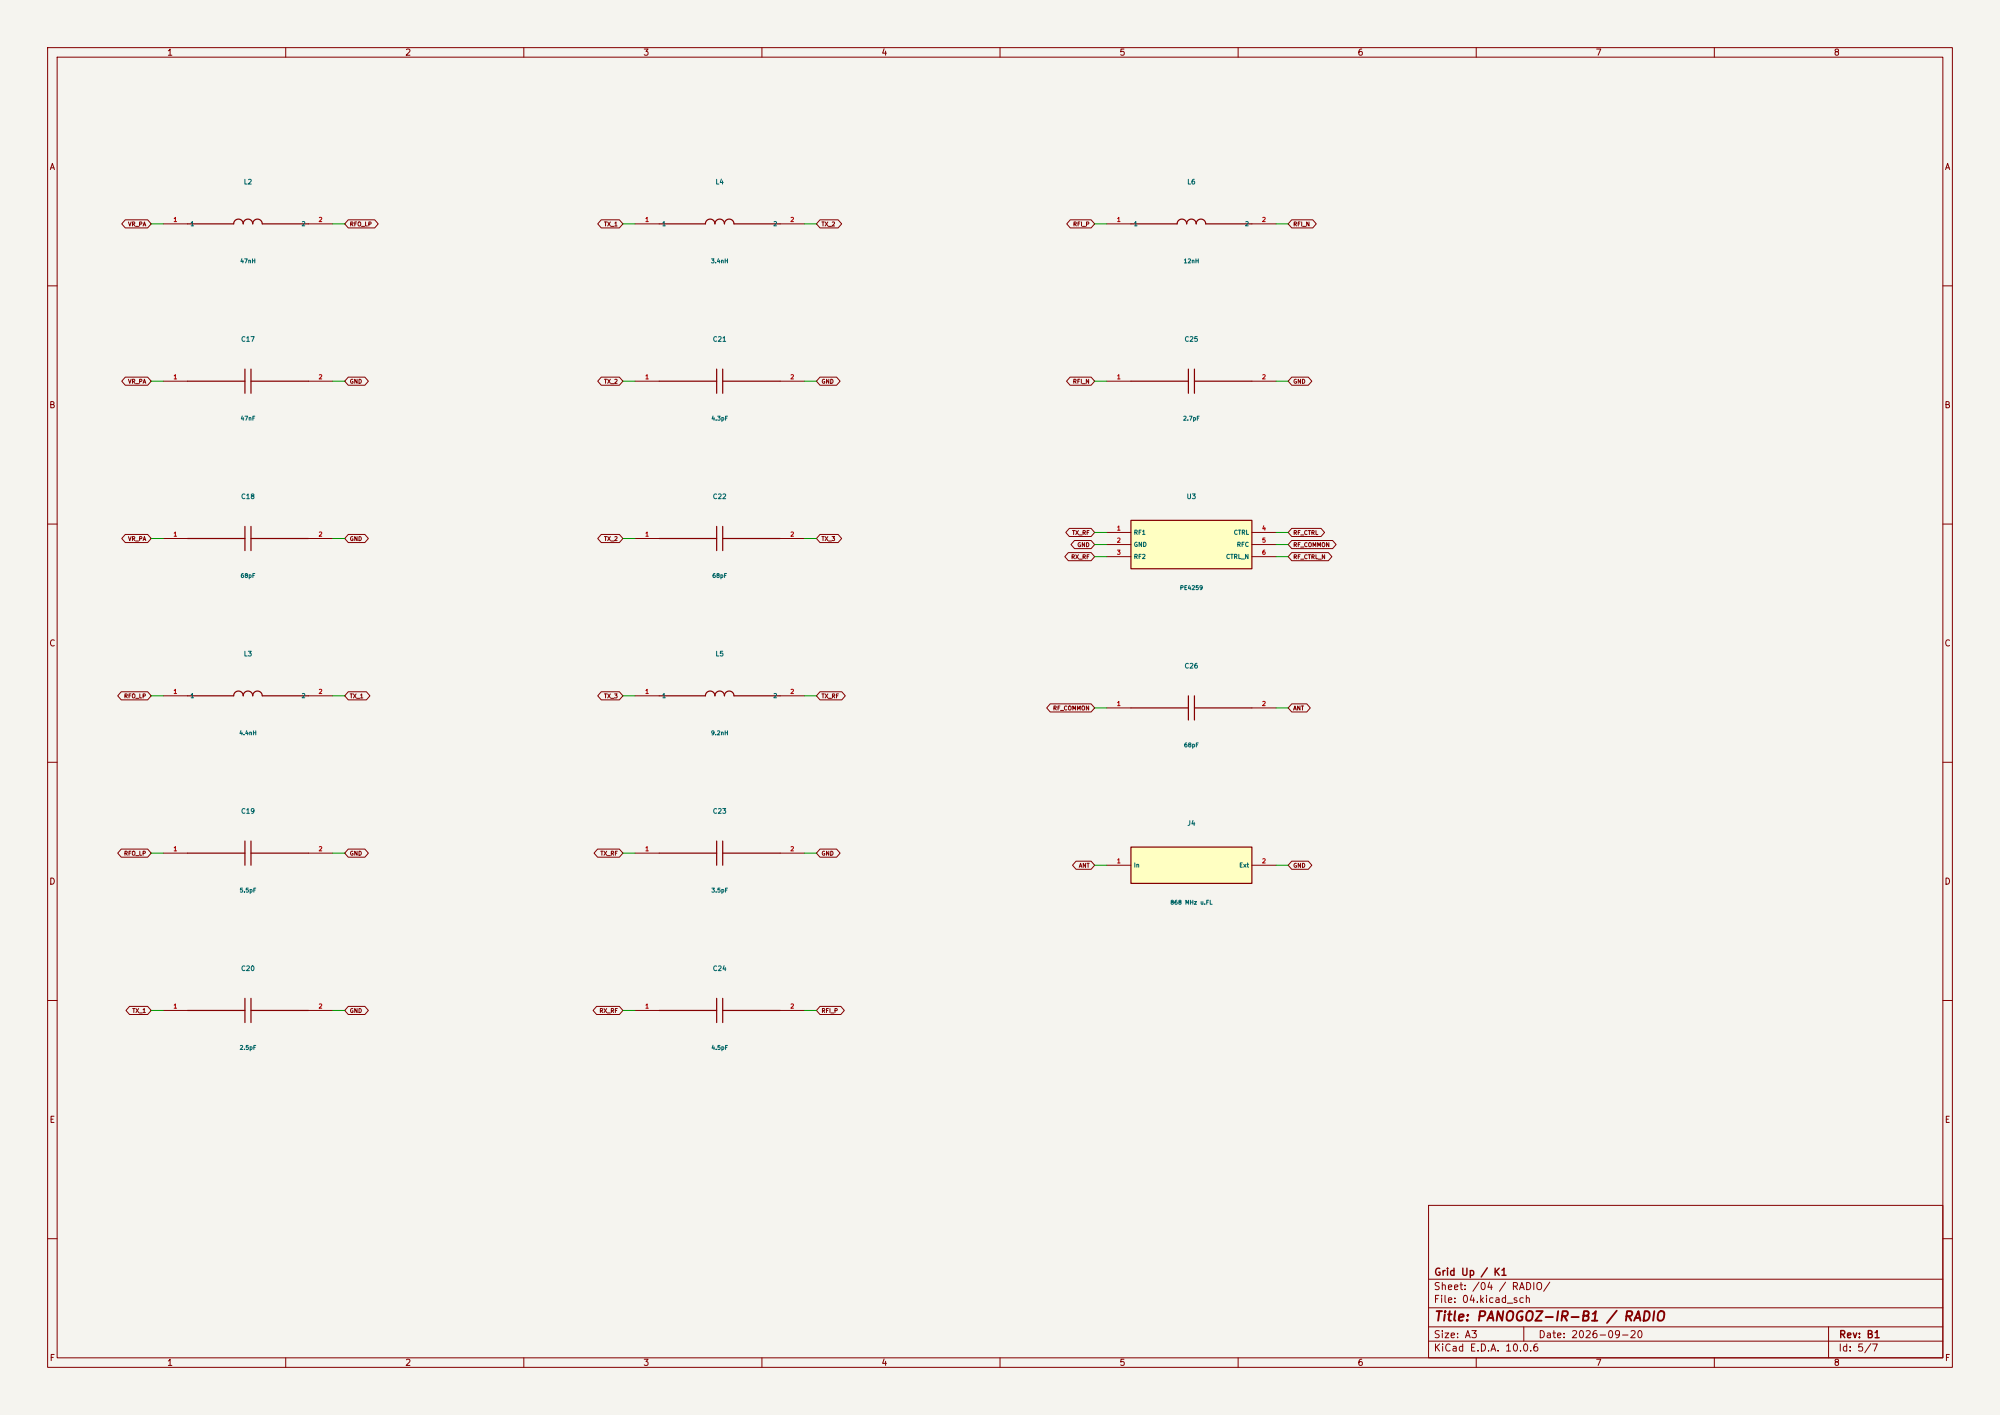
[picture p53: page 5]

Grid Up / K1
Sheet: /04 / RADIO/
File: 04.kicad_sch
Title: PANOGOZ-IR-B1 / RADIO

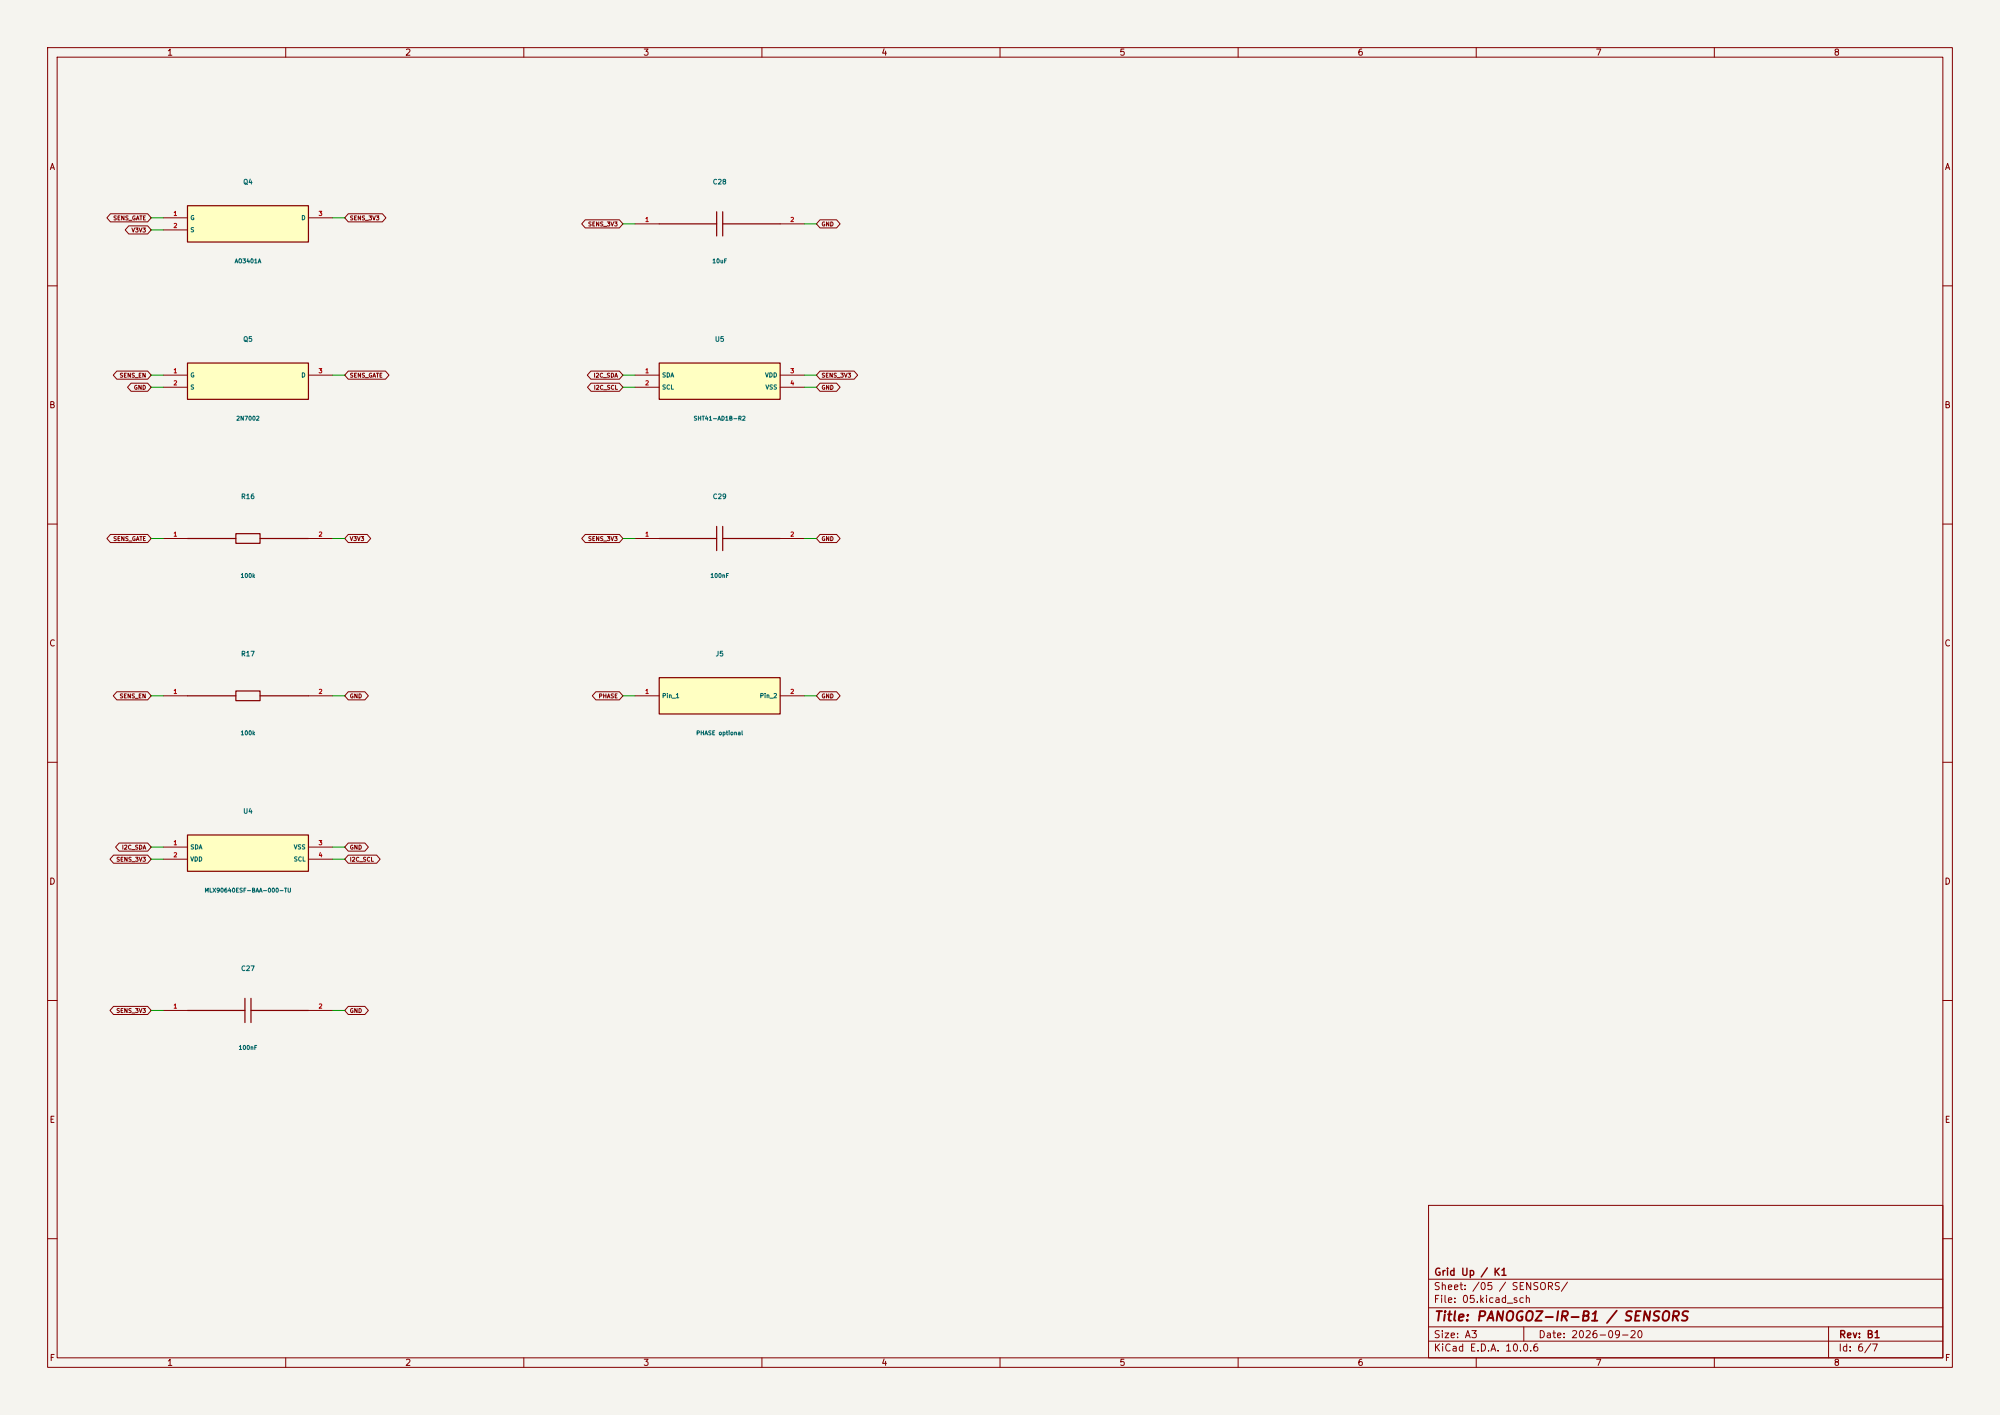
[picture p54: page 6]

Grid Up / K1
Sheet: /05 / SENSORS/
File: 05.kicad_sch
Title: PANOGOZ-IR-B1 / SENSORS

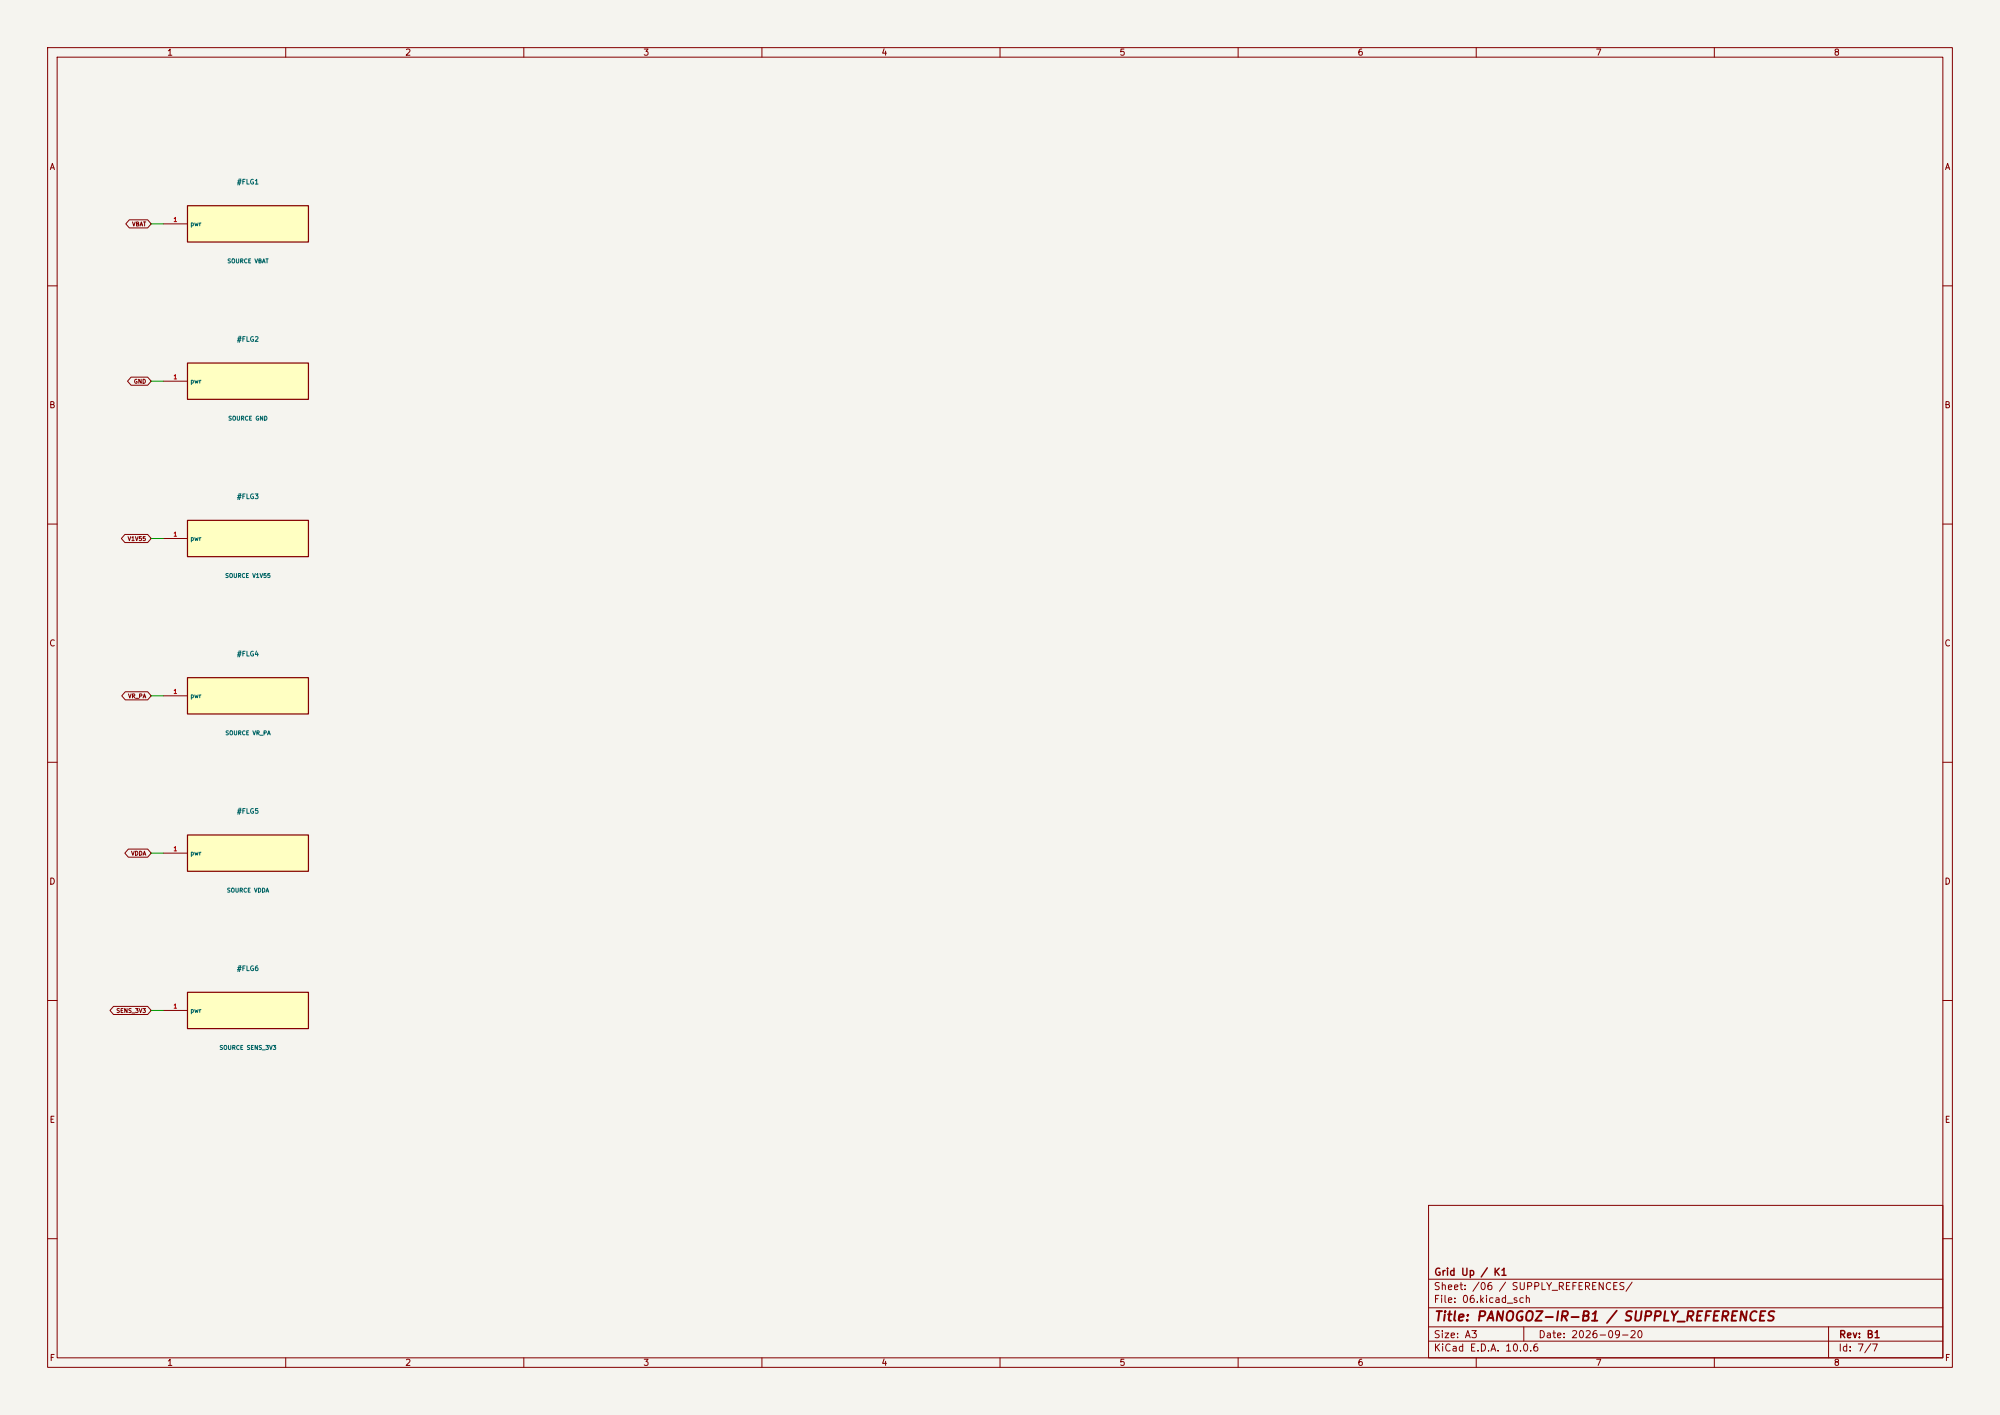
[picture p55: page 7]
