hackathon-buke-team/grid-up/hardware/B1/PD/schematic.pdf

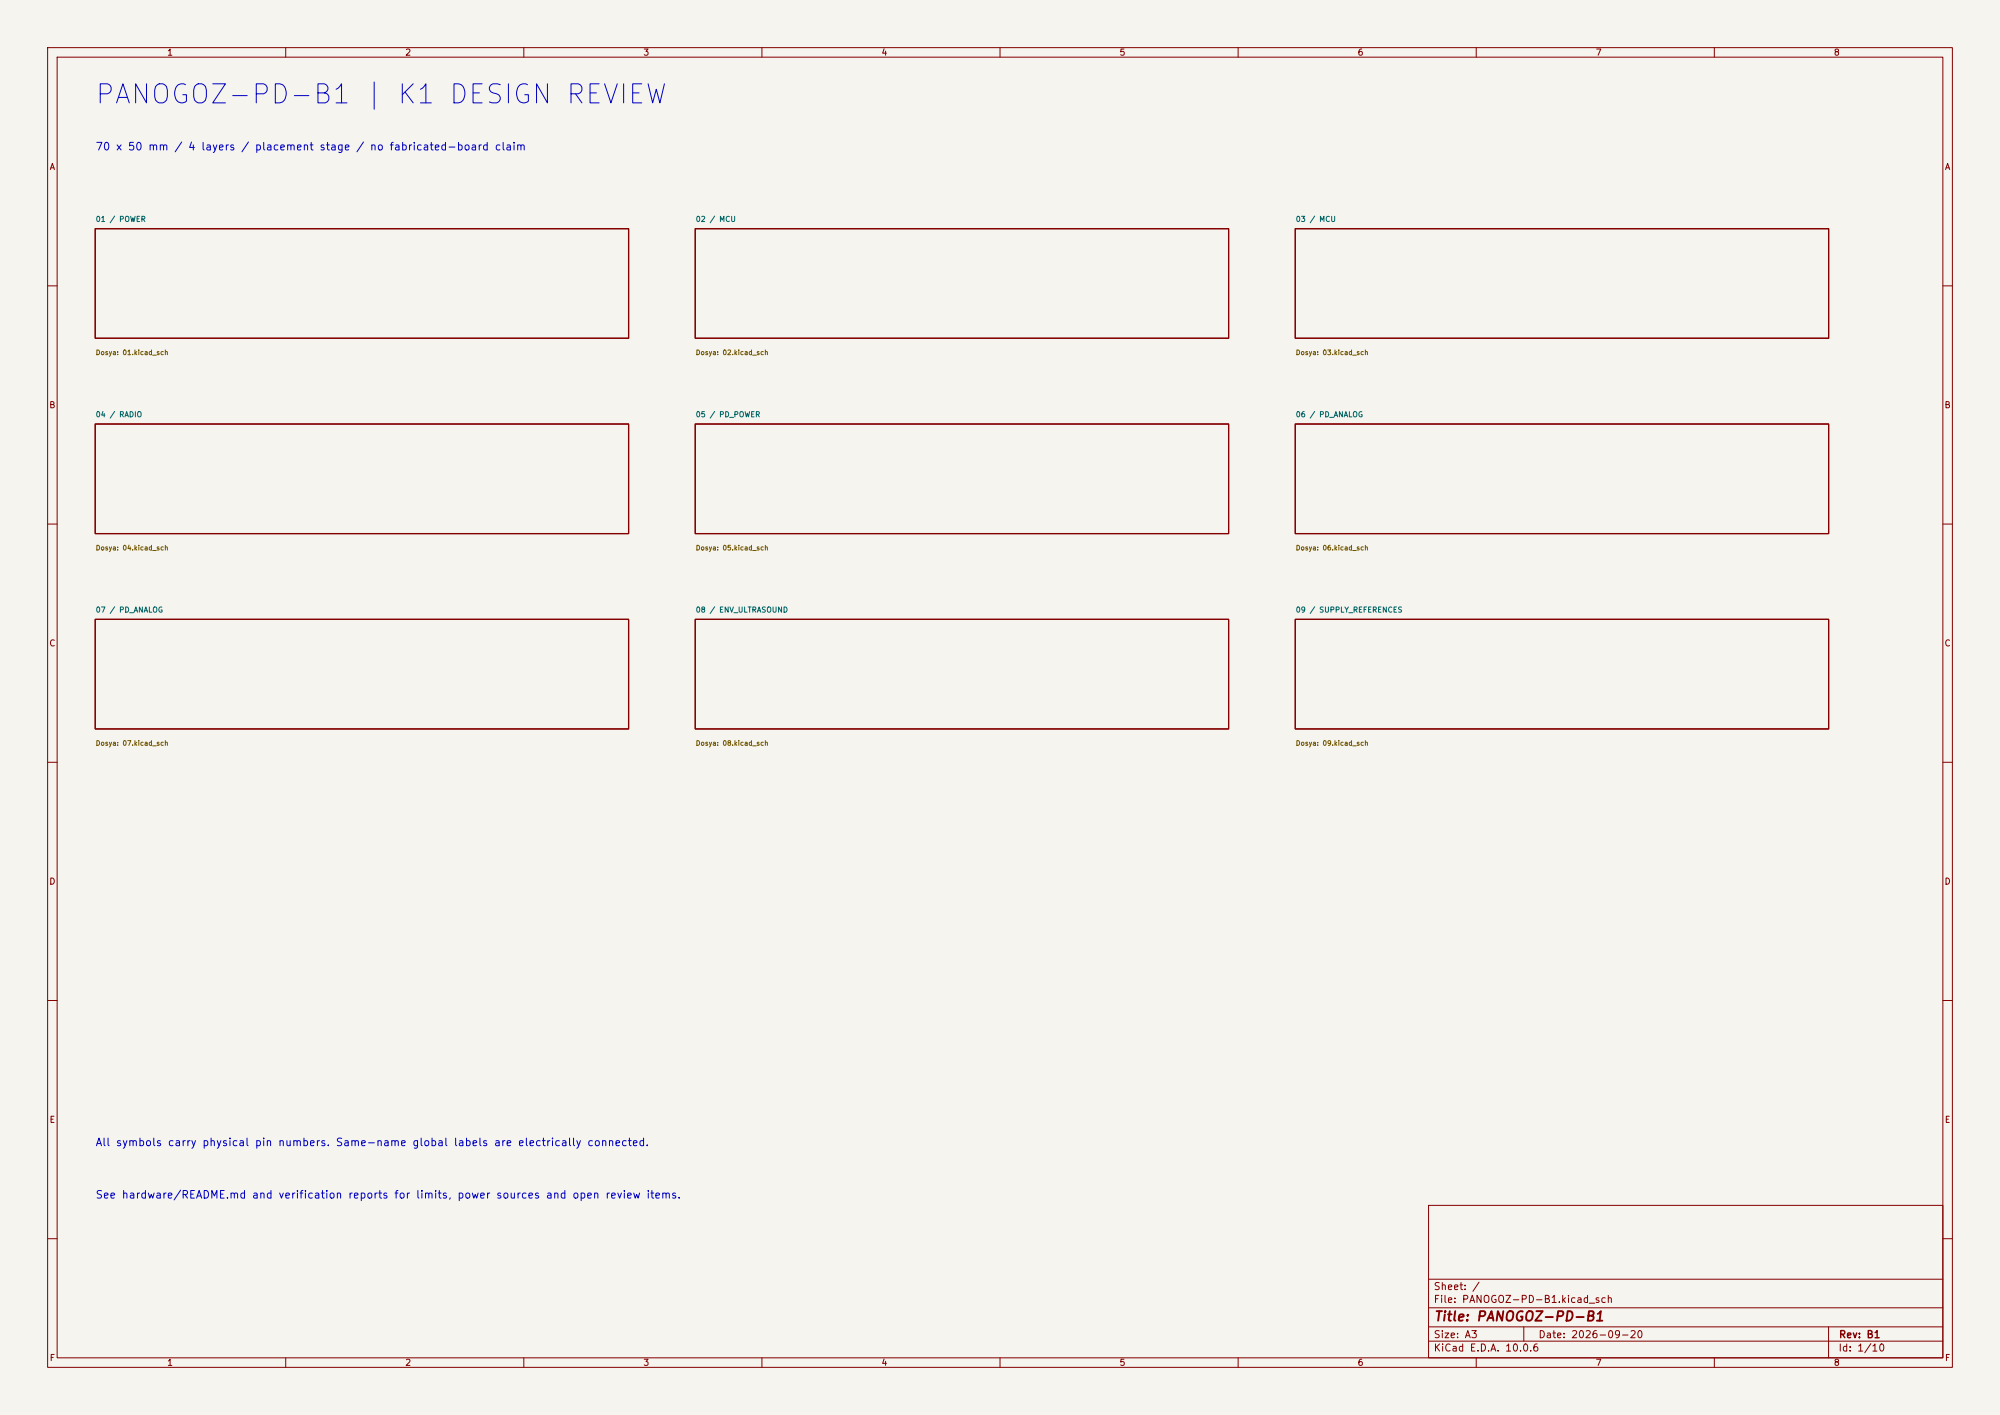
[picture p56: page 1]

Dosya: 07.kicad_sch PANOGOZ-PD-B1 | K1 DESIGN REVIEW

70 x 50 mm / 4 layers / placement stage / no fabricated-board claim

All symbols carry physical pin numbers. Same-name global labels are electrically connected.

See hardware/README.md and verification reports for limits, power sources and open review items.

Size: A3 | Rev: B1 | F Date: 2026-09-20
KiCad E.D.A. 10.0.6 | Id: 1/10

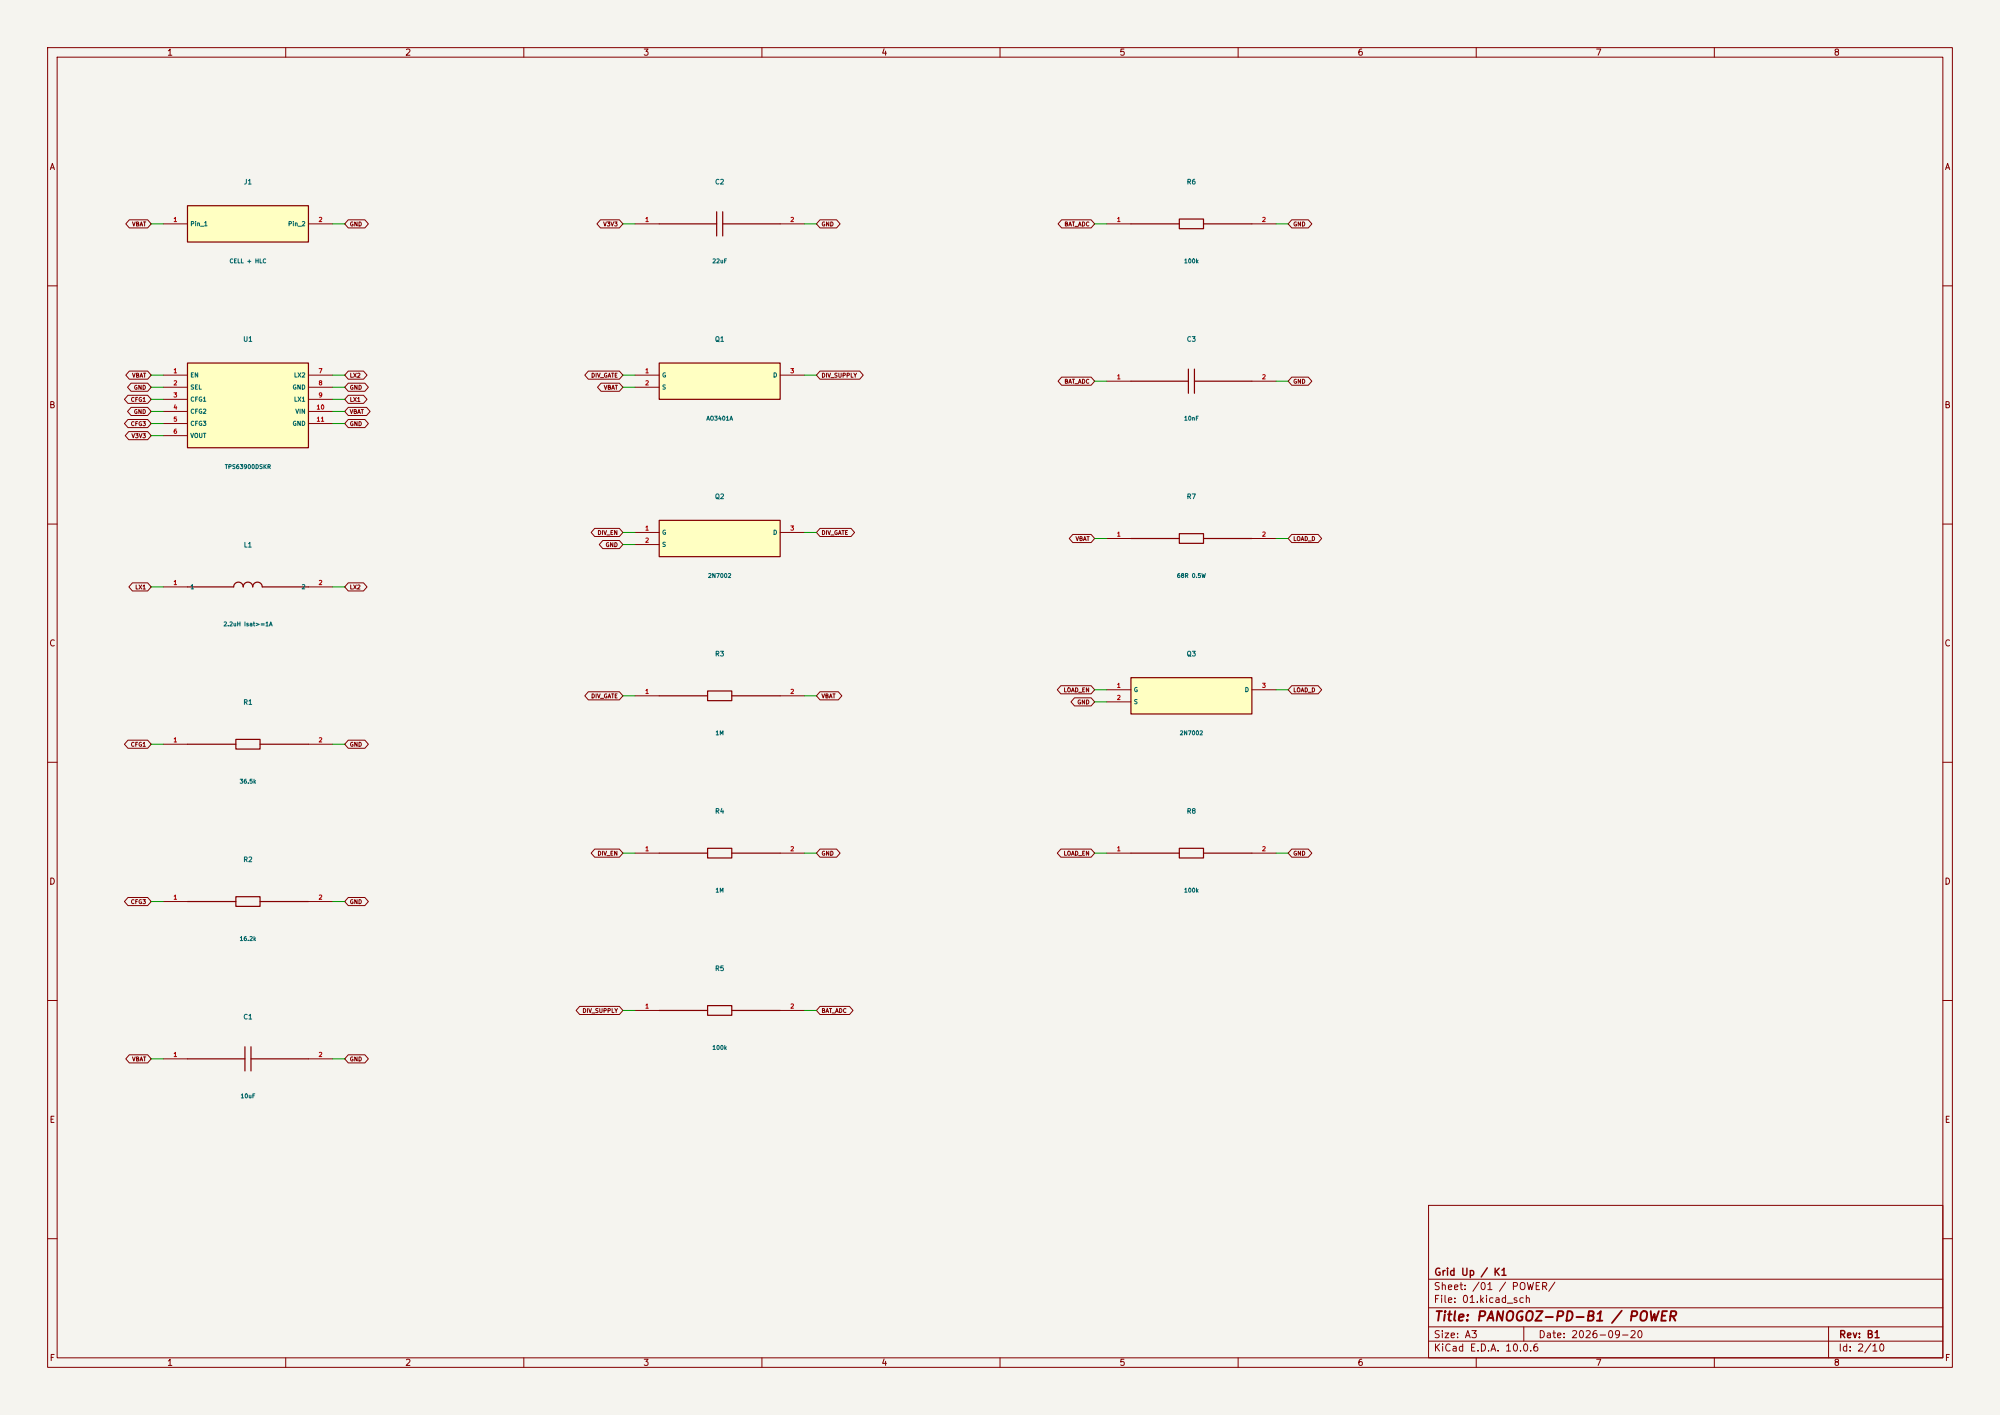
[picture p57: page 2]

Grid Up / K1
Sheet: /01 / POWER/
File: 01.kicad_sch
Title: PANOGOZ-PD-B1 / POWER

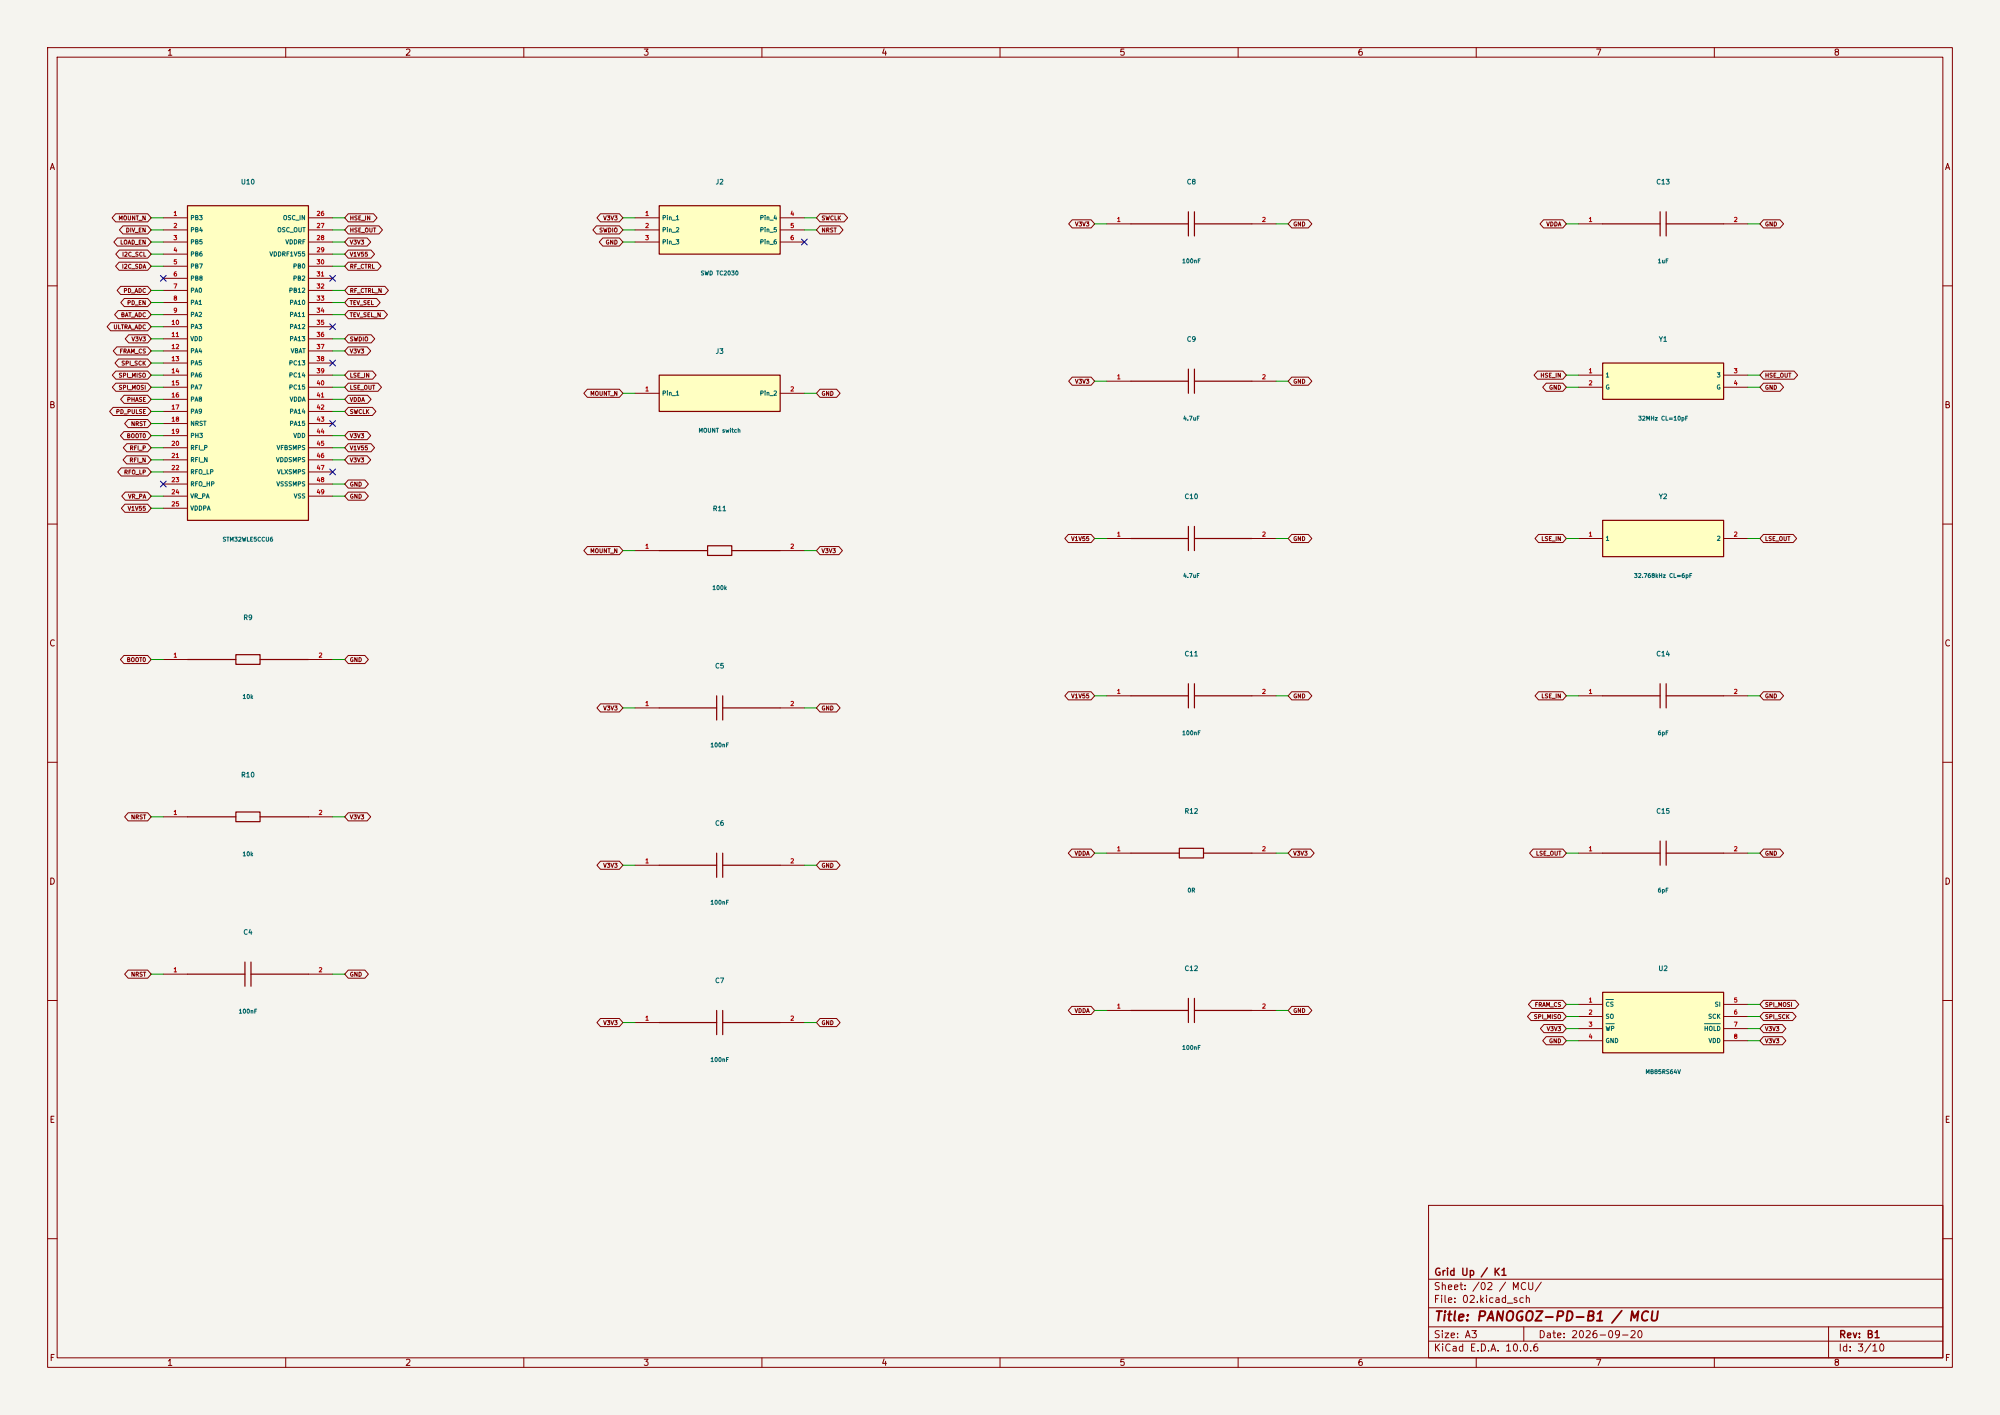
[picture p58: page 3]

Sheet: /02 / MCU/
File: 02.kicad_sch
Title: PANOGOZ-PD-B1 / MCU

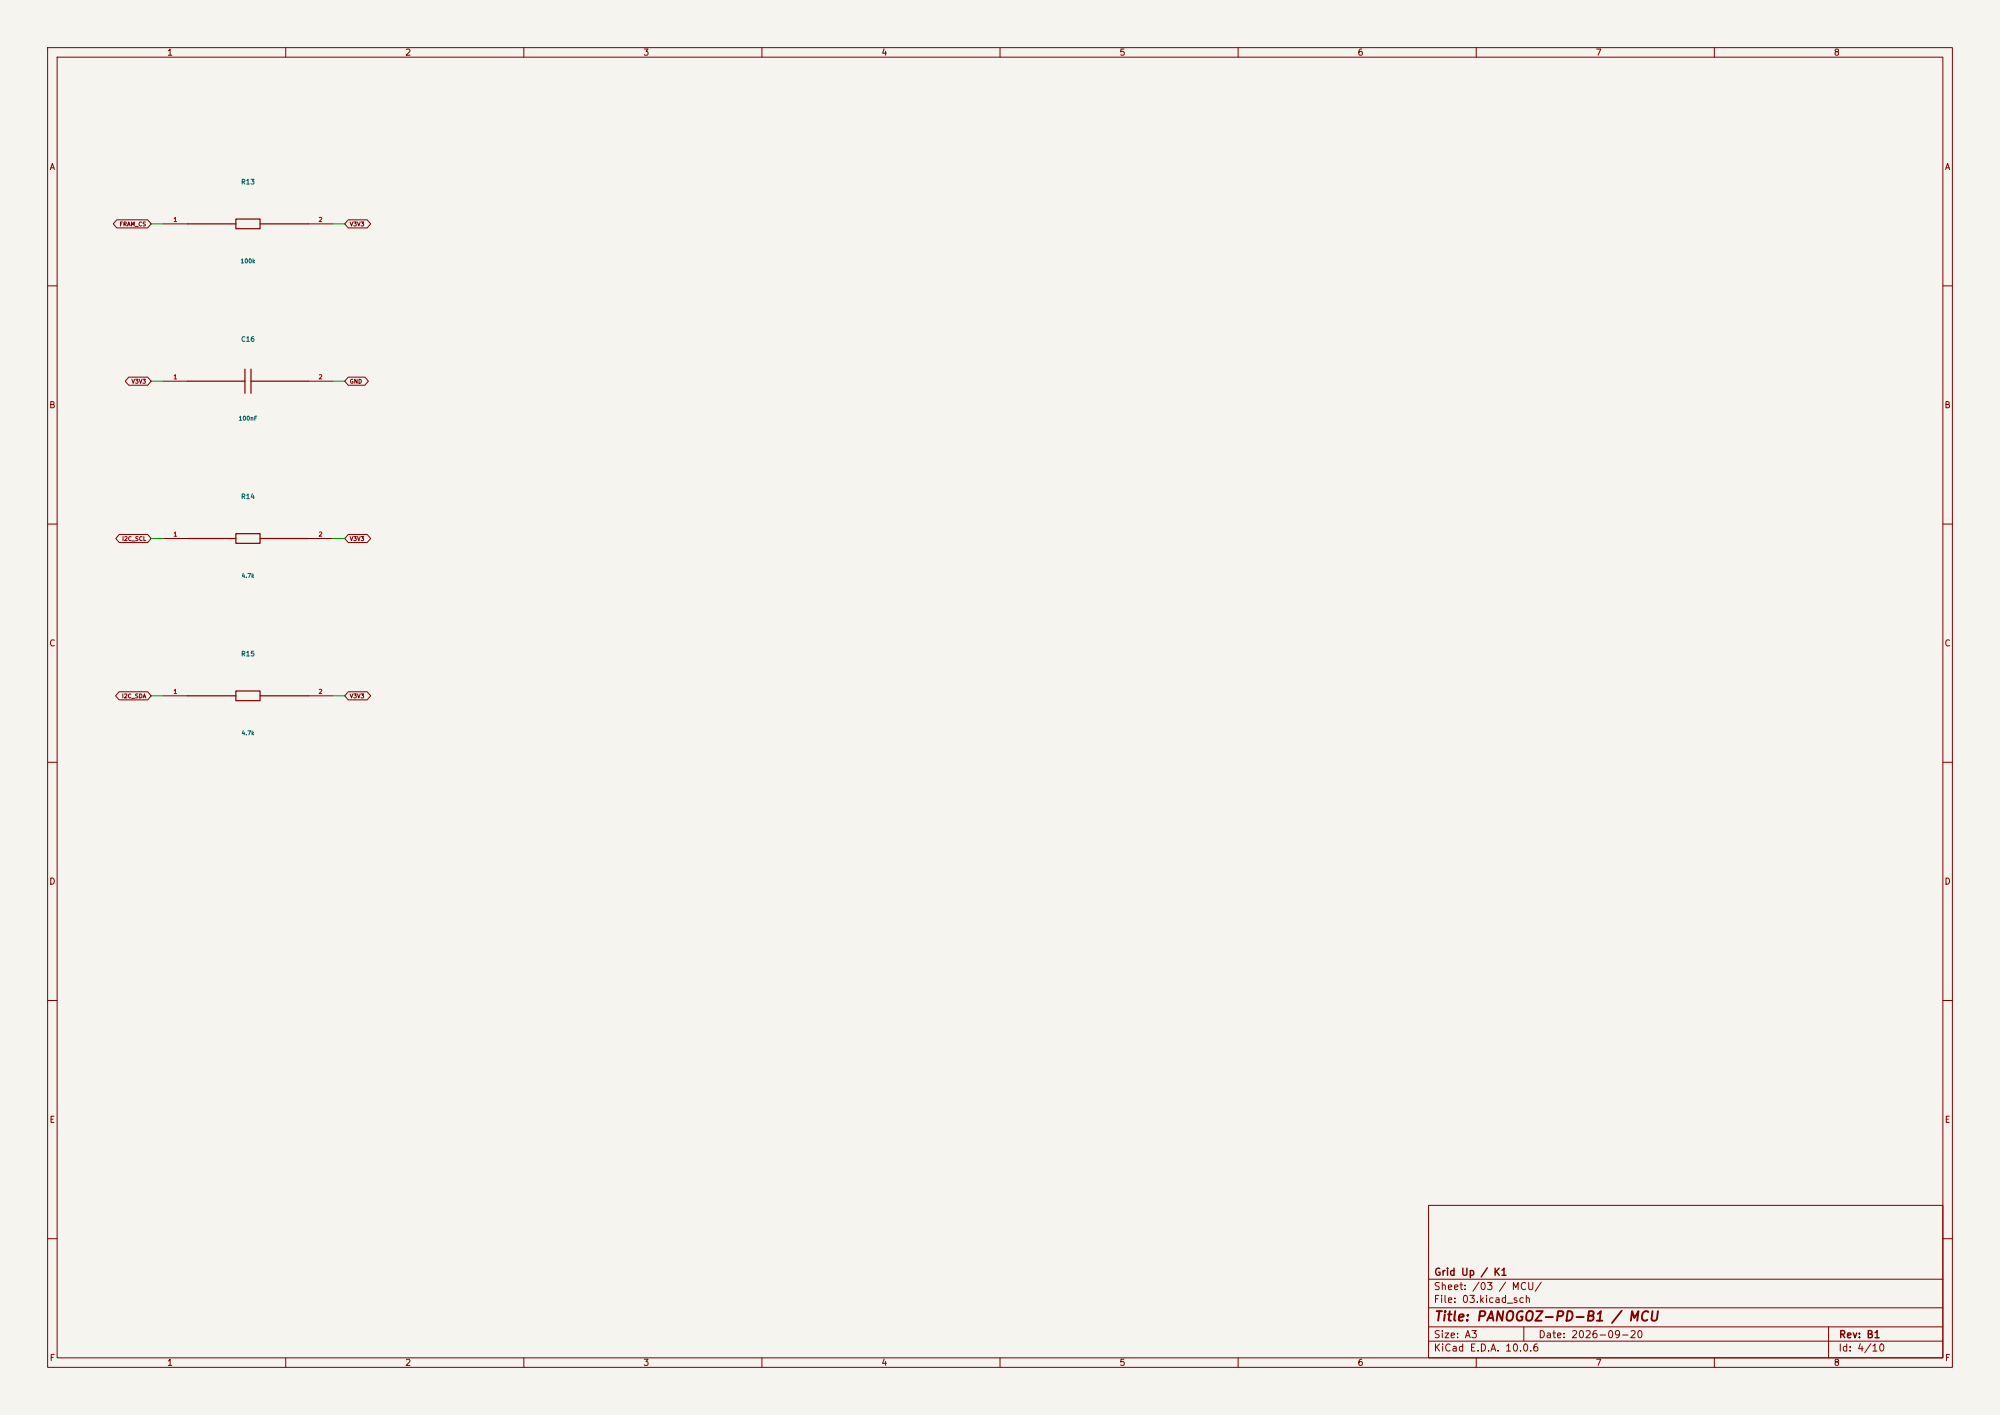
[picture p59: page 4]

Grid Up / K1
Sheet: /03 / MCU/
File: 03.kicad_sch
Title: PANOGOZ-PD-B1 / MCU

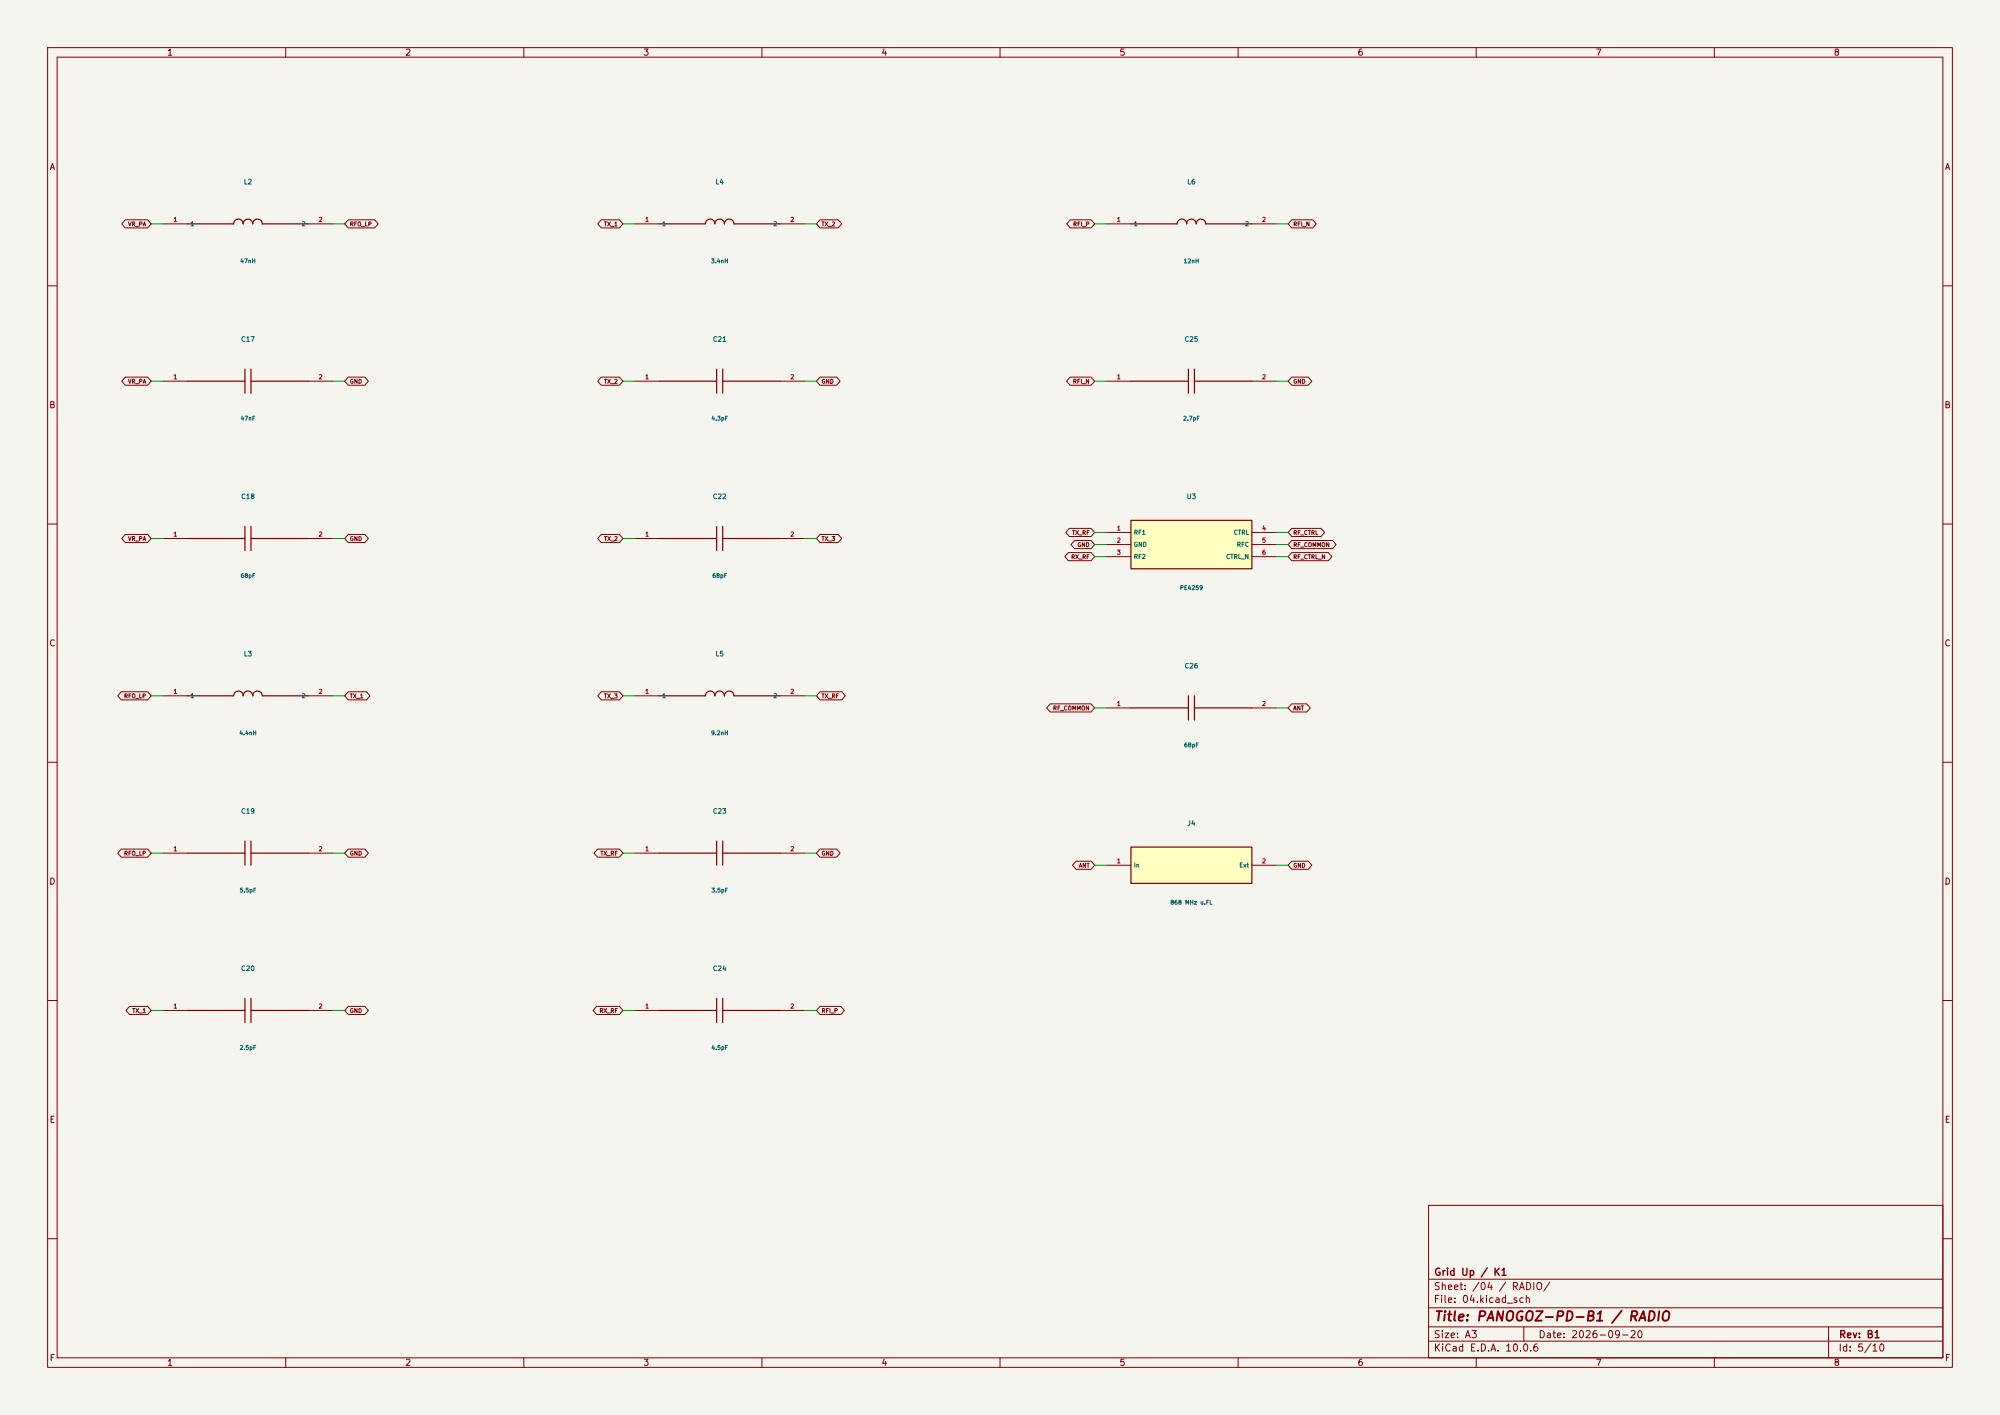
[picture p60: page 5]

Grid Up / K1
Sheet: /04 / RADIO/
File: 04.kicad_sch
Title: PANOGOZ-PD-B1 / RADIO

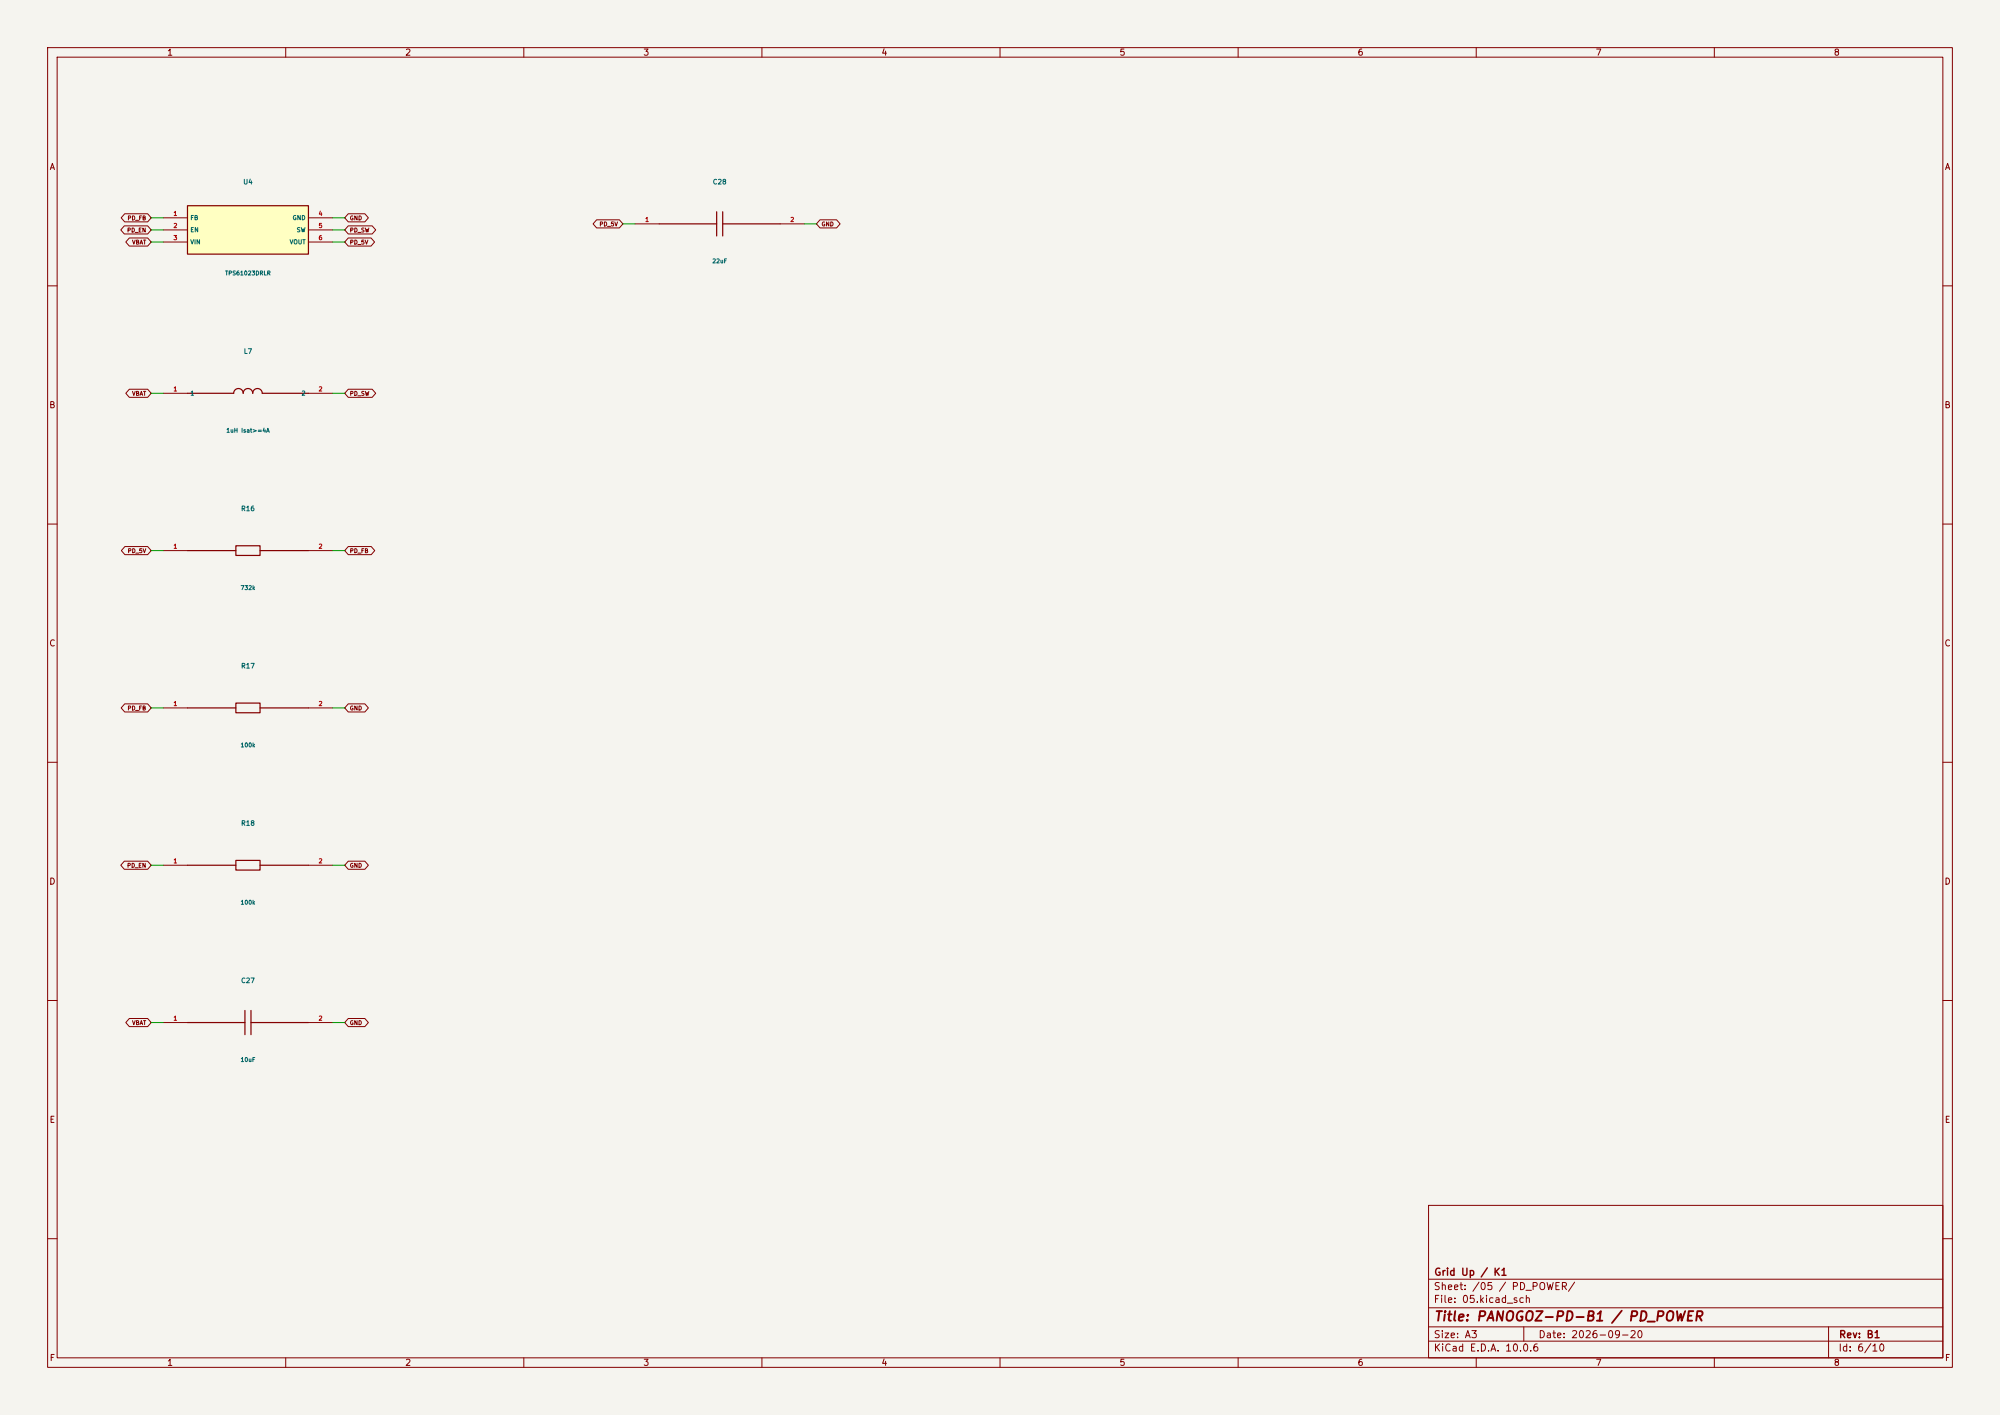
[picture p61: page 6]

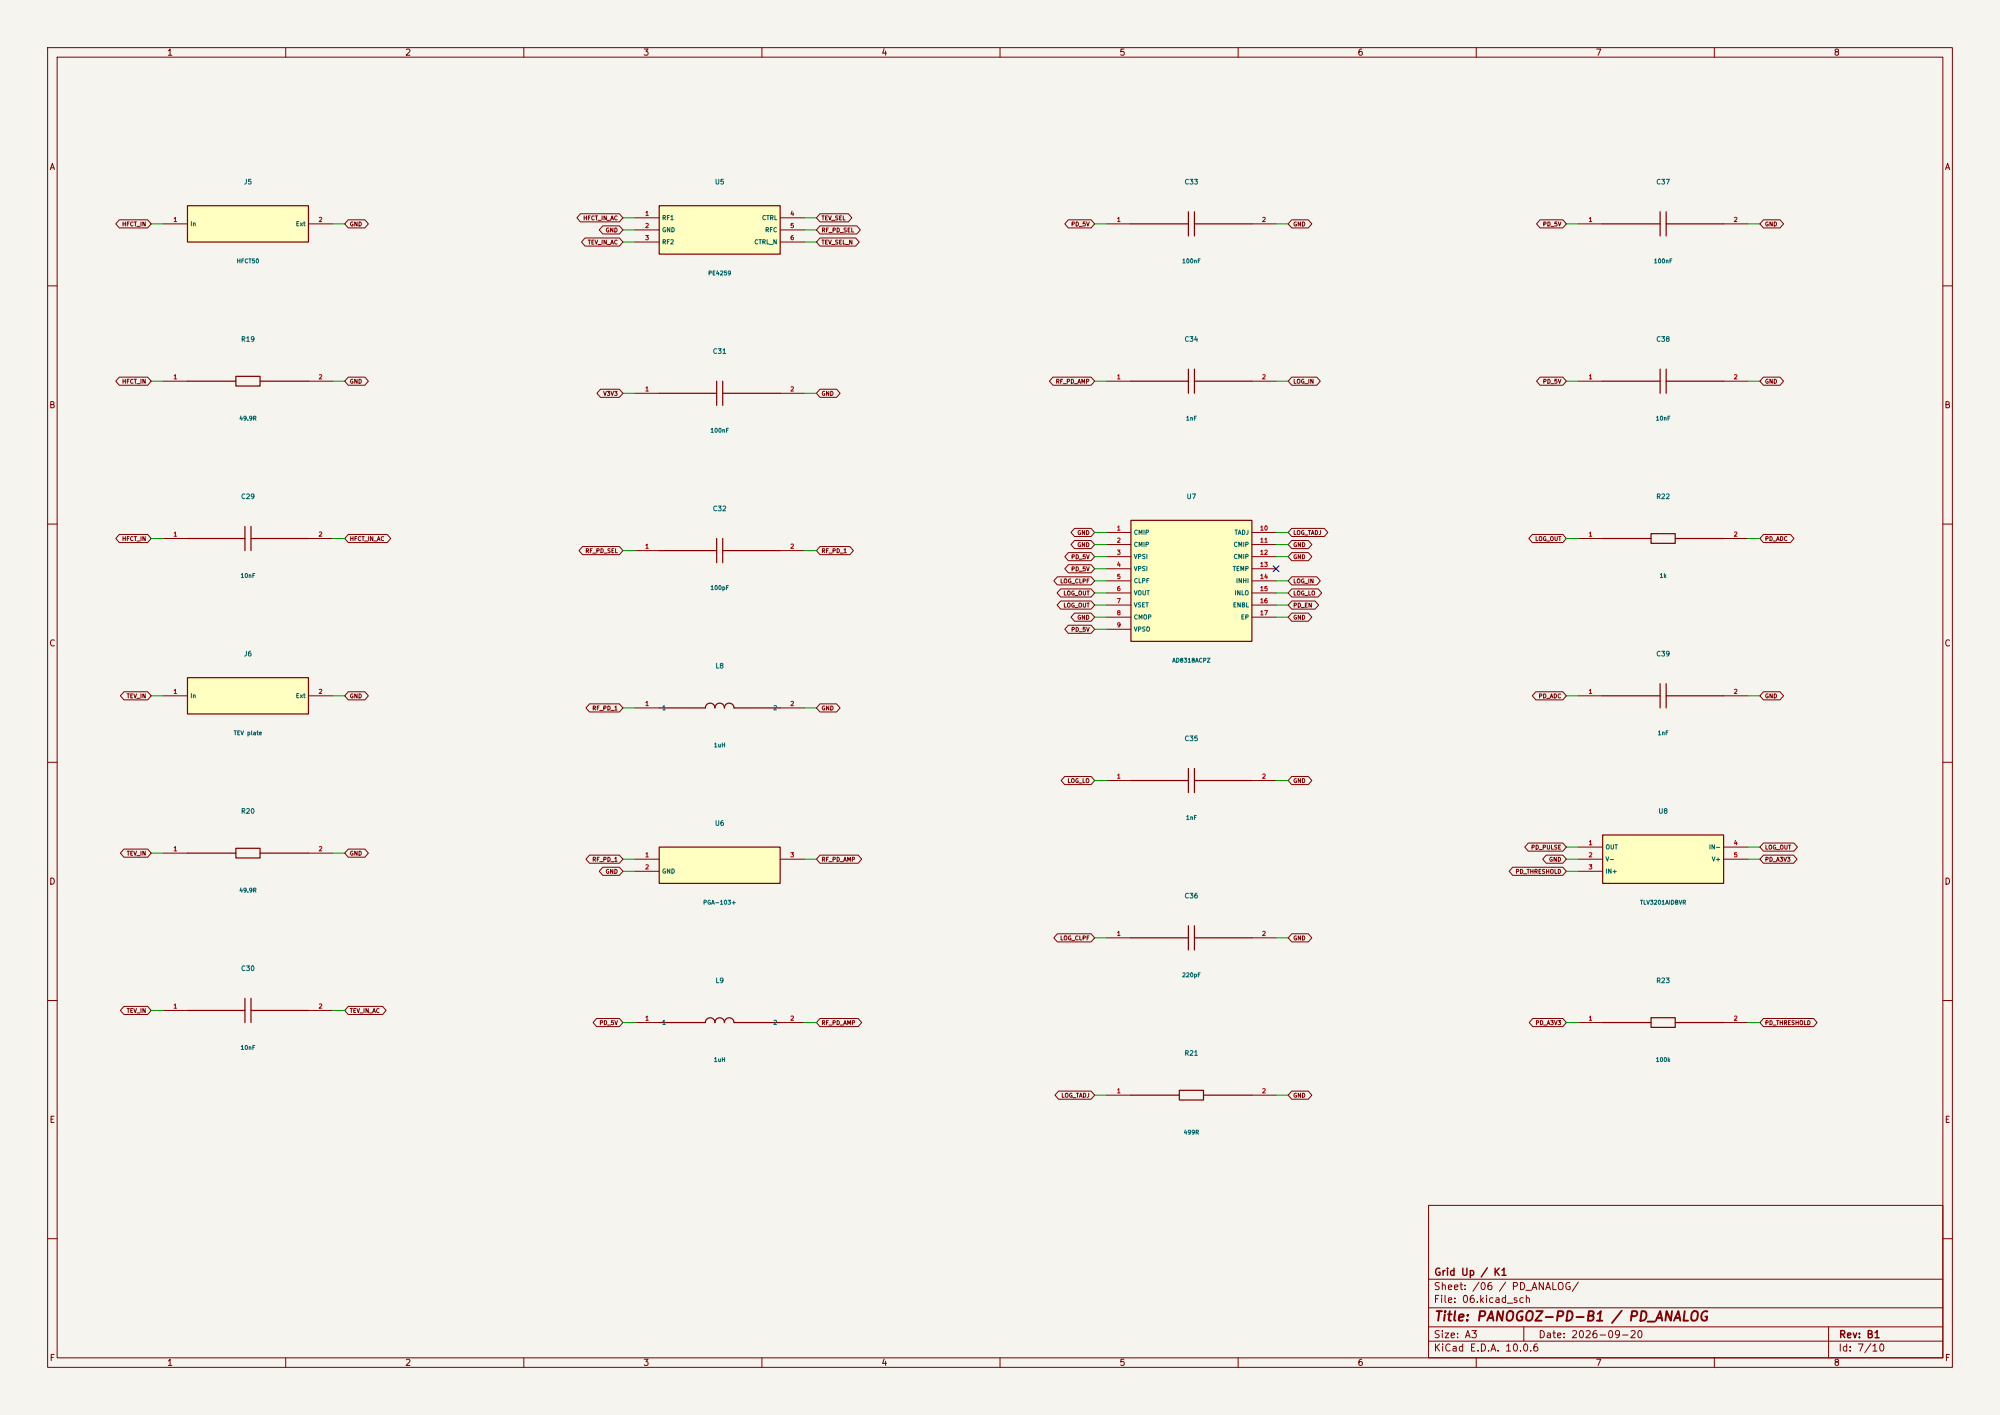
[picture p62: page 7]

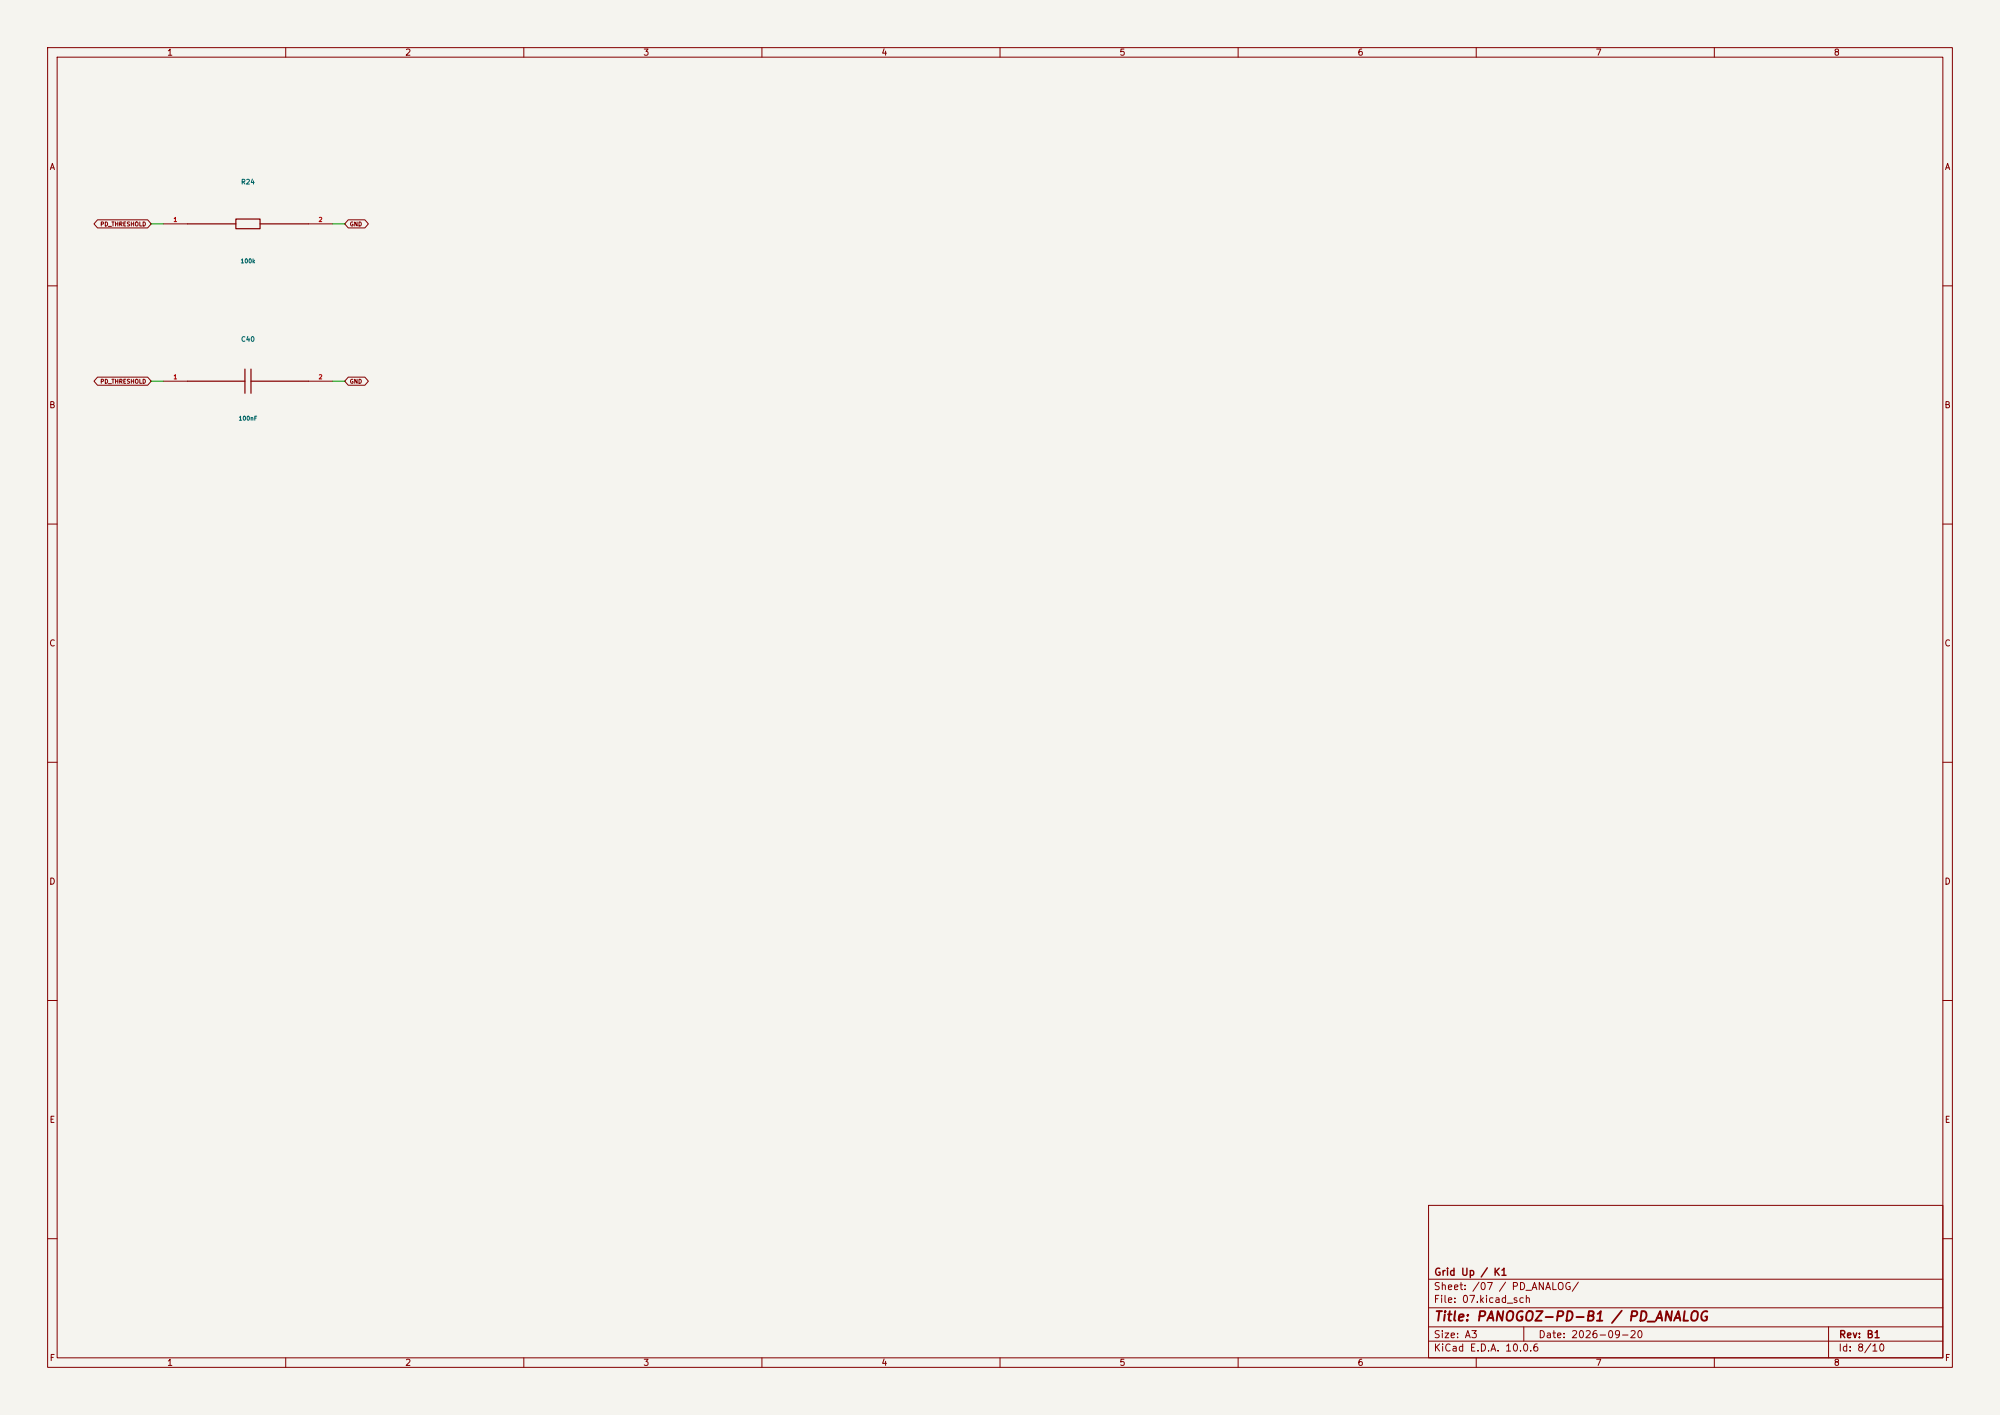
[picture p63: page 8]

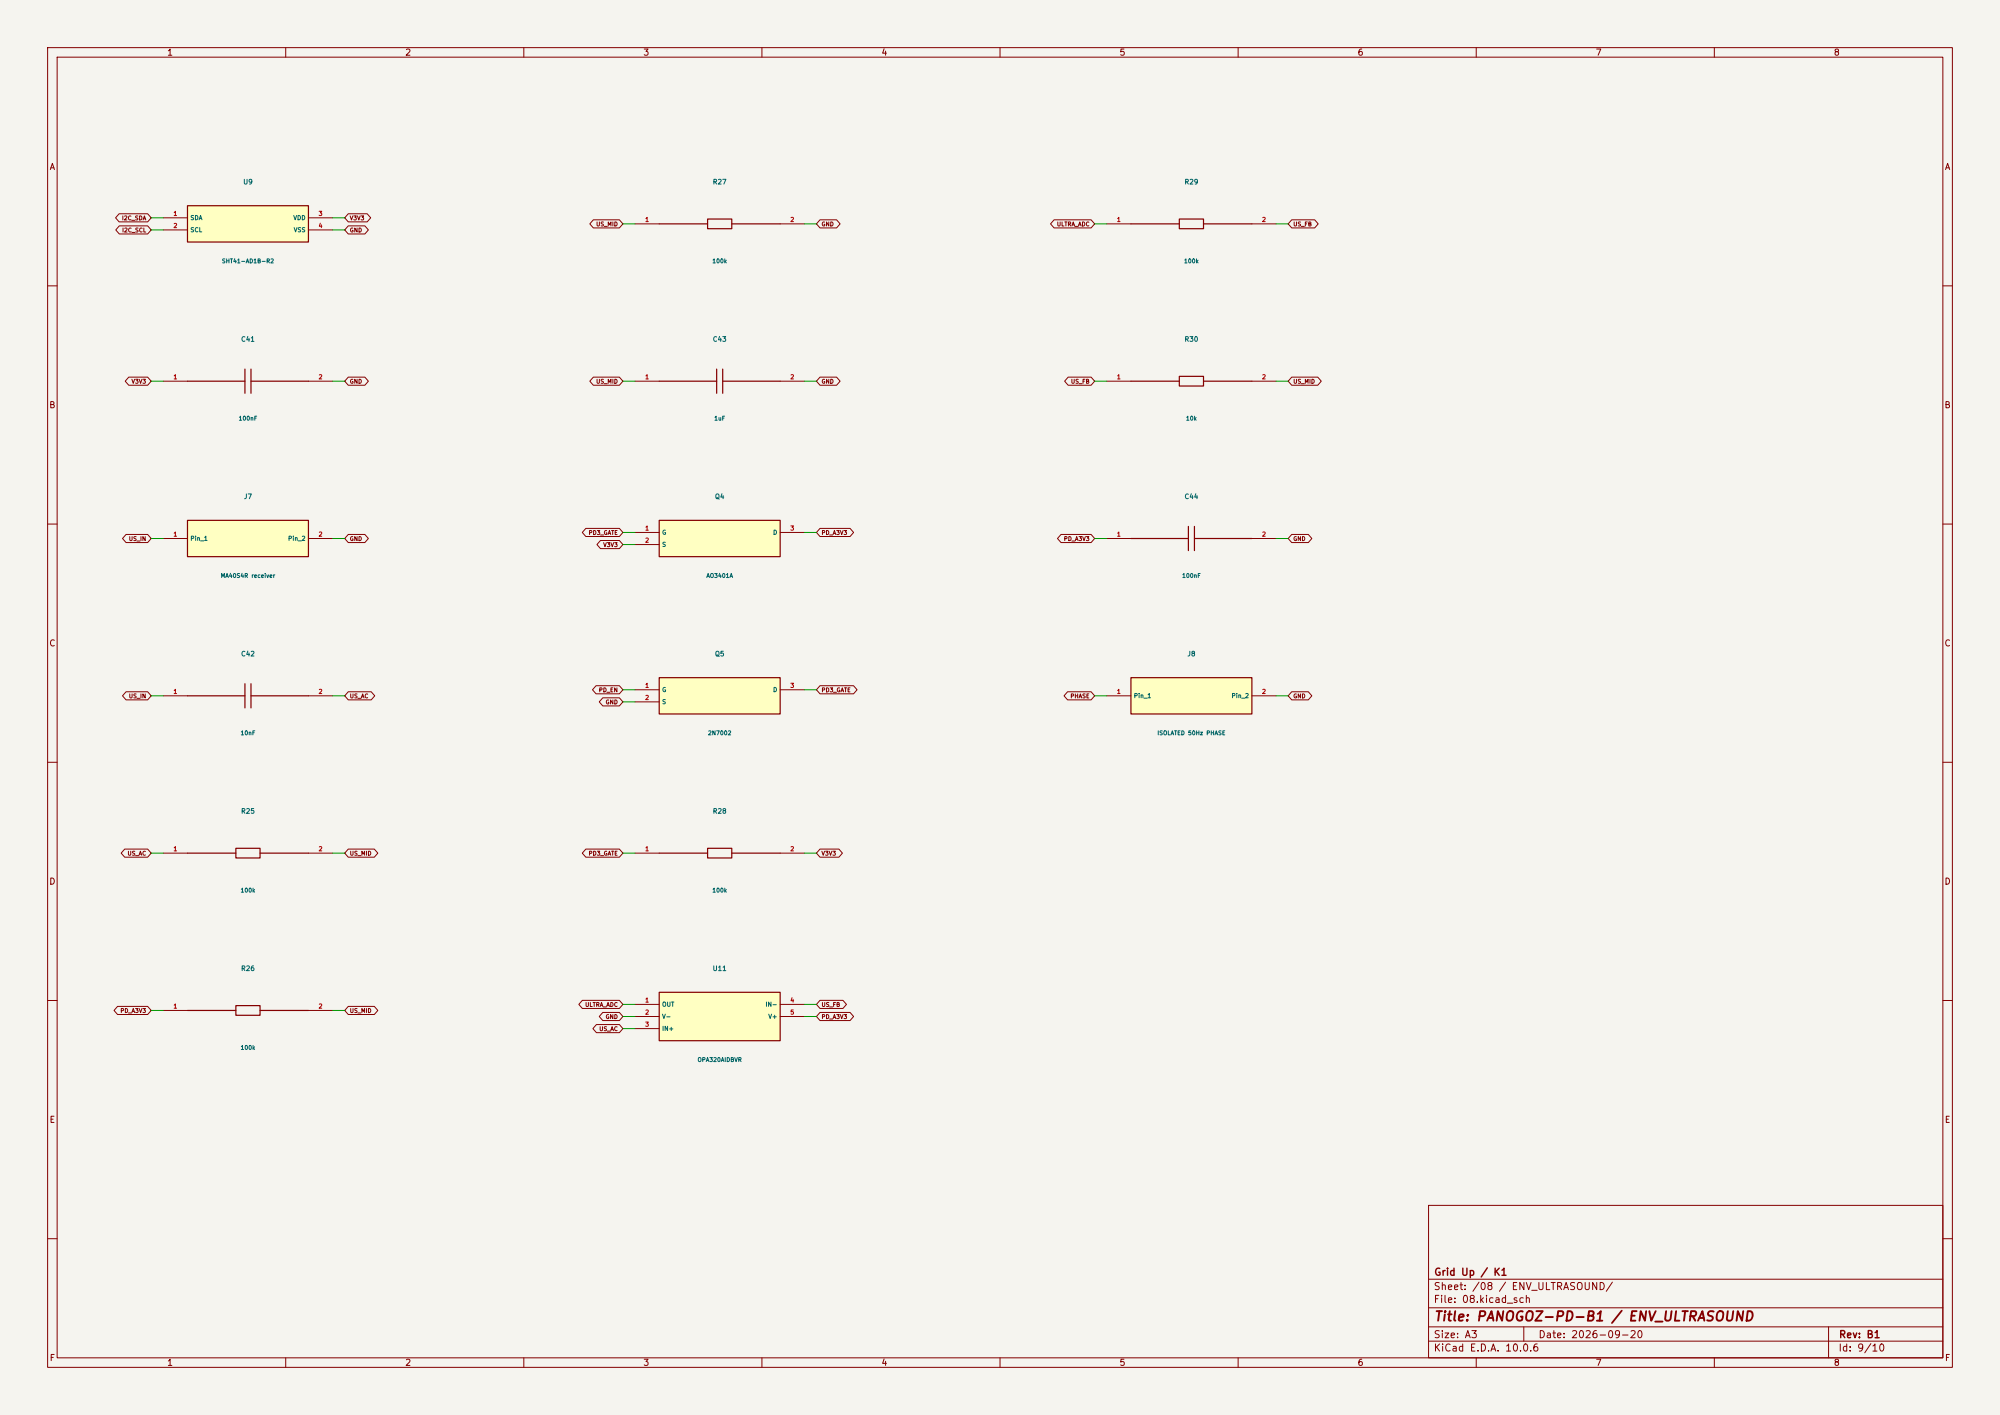
[picture p64: page 9]

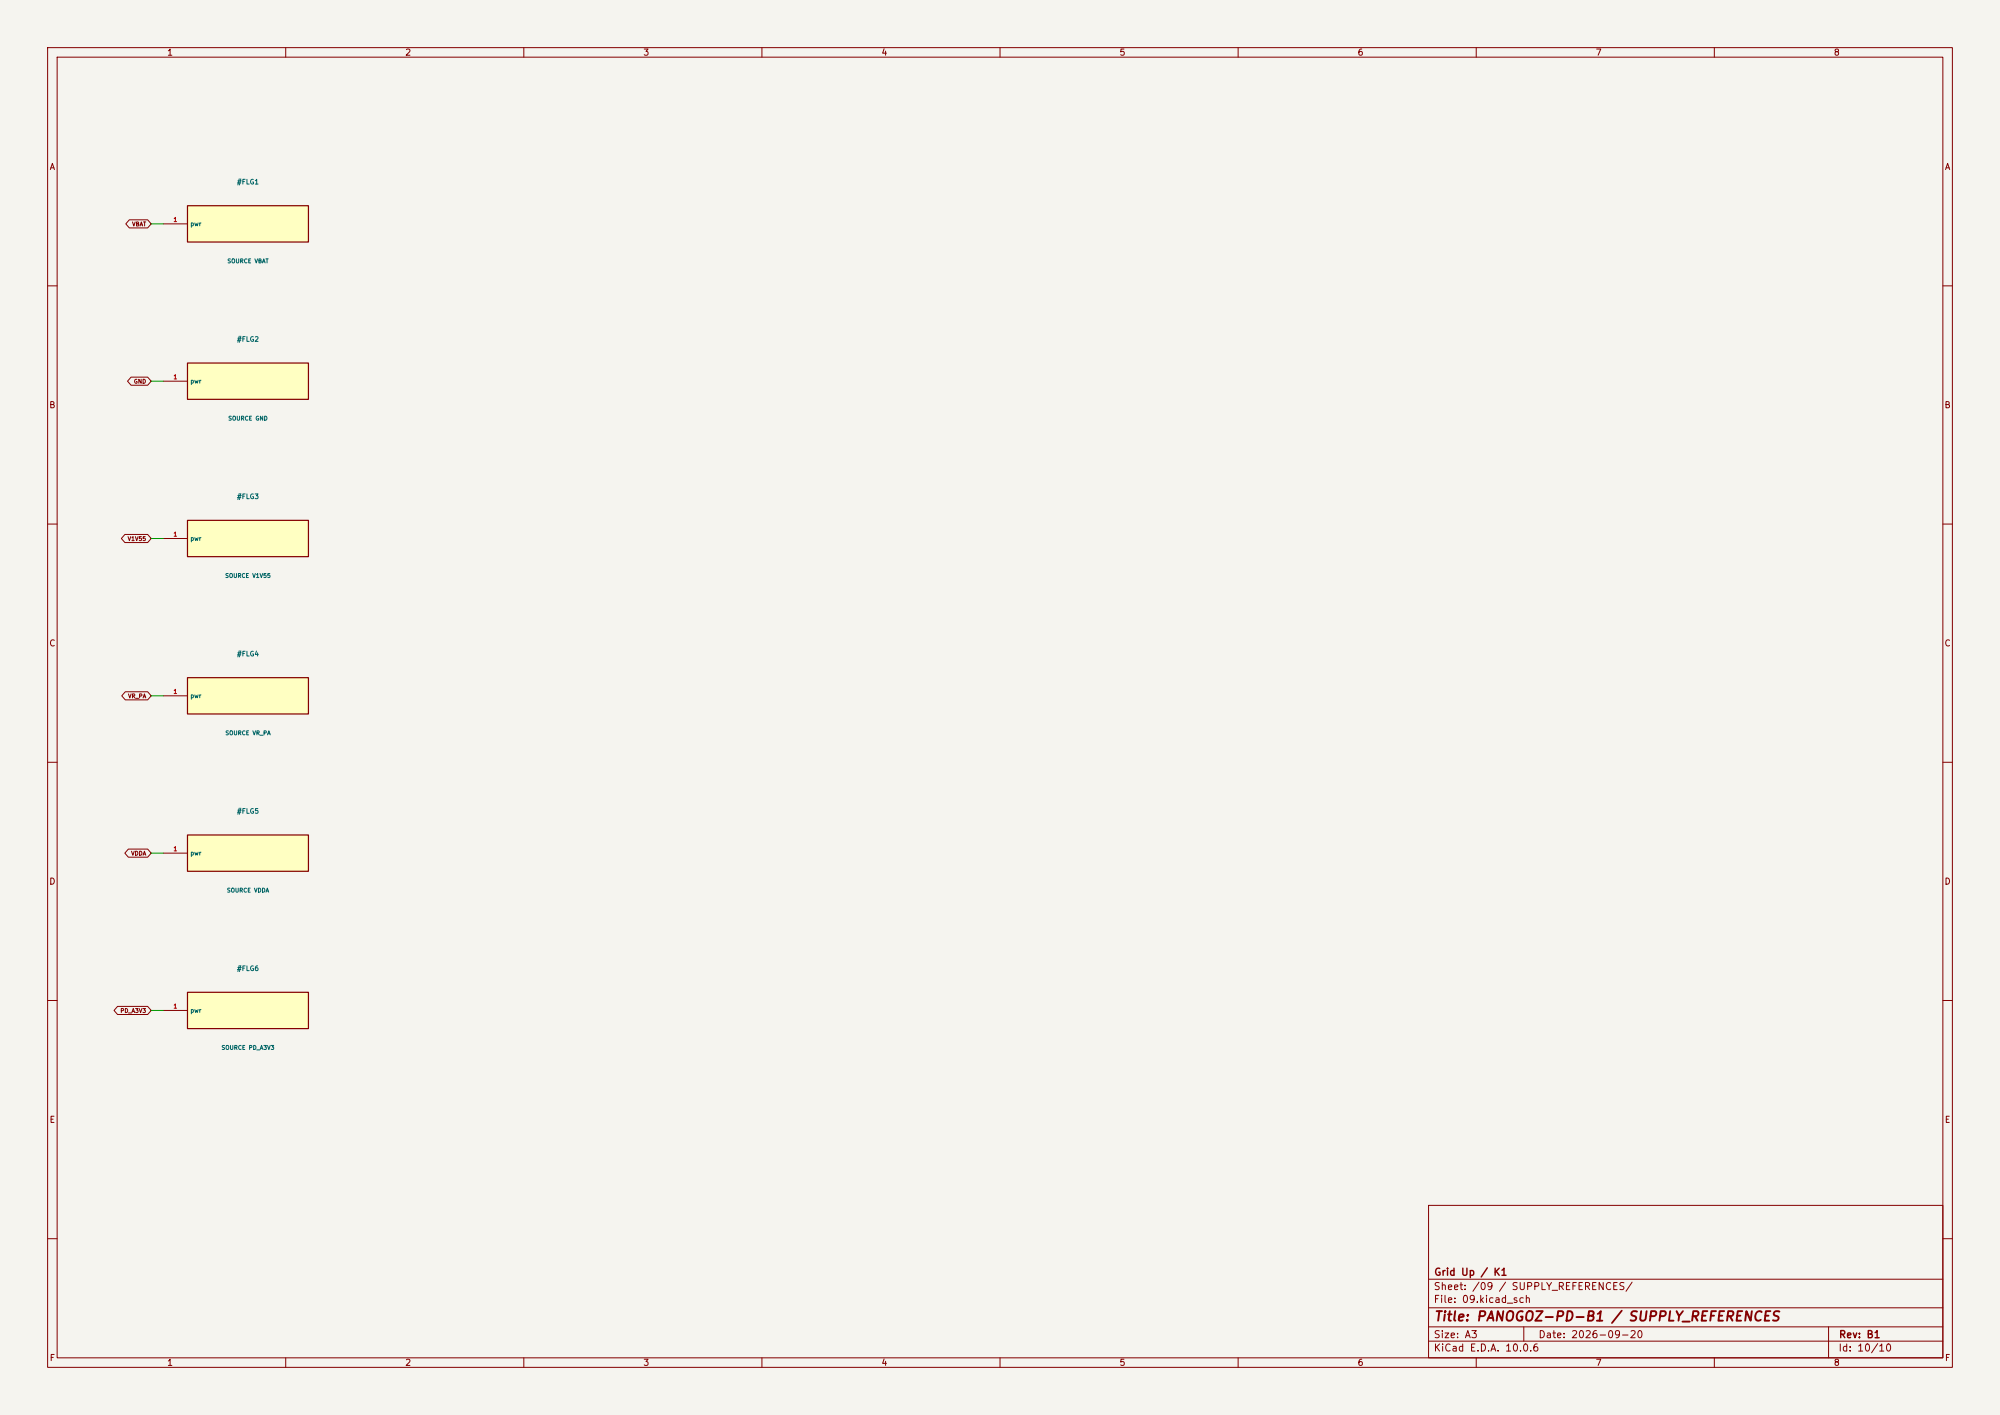
[picture p65: page 10]
