hackathon-buke-team/grid-up/hardware/B1/TC/schematic.pdf

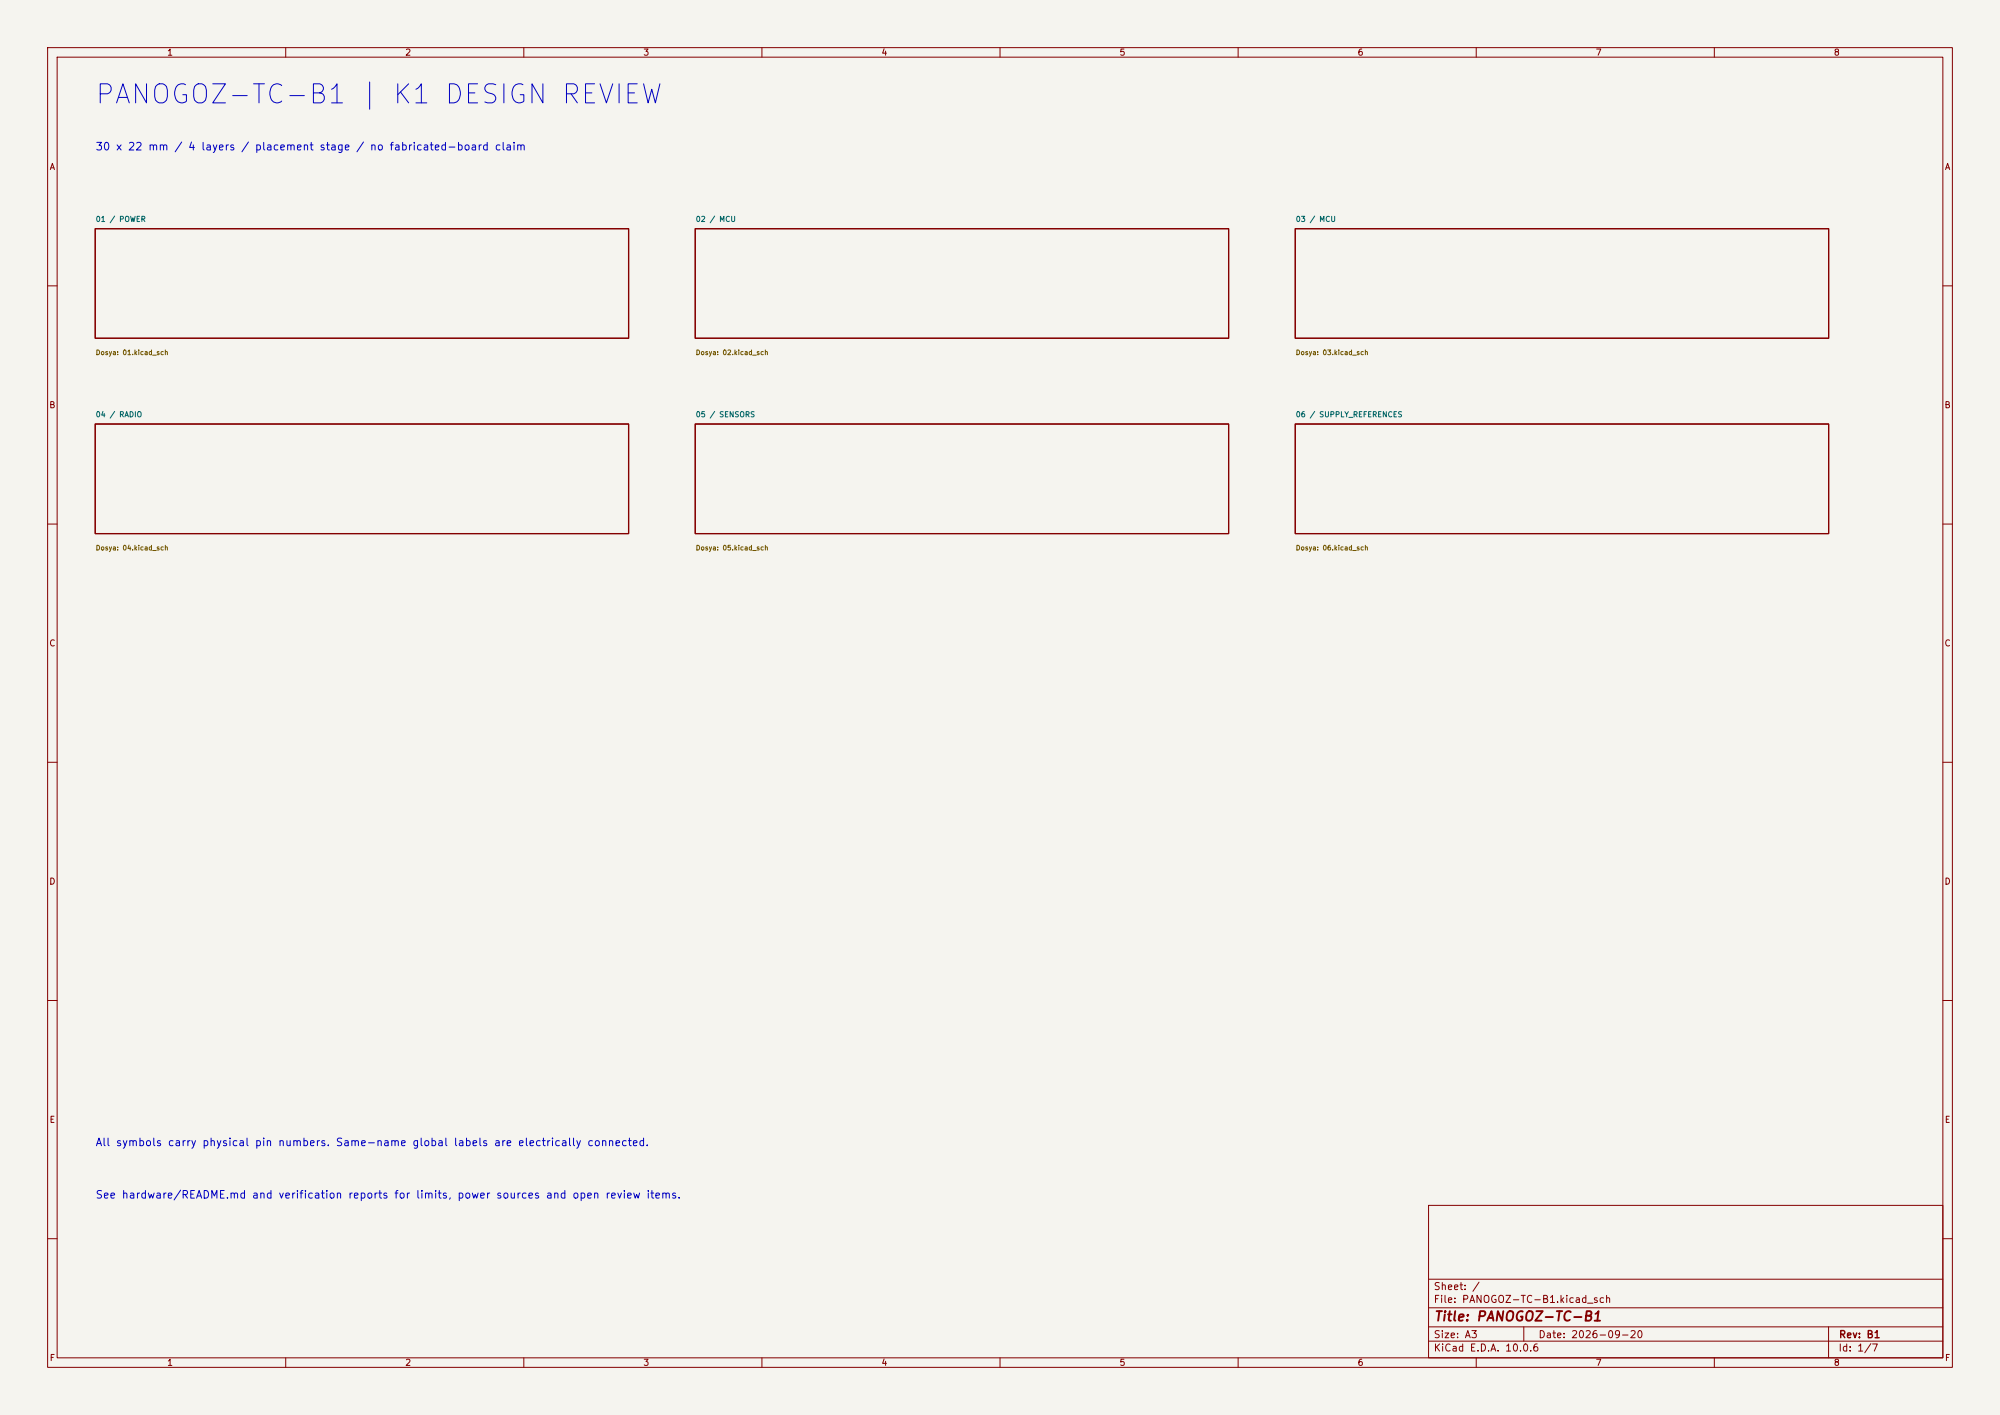
[picture p66: page 1]

Dosya: 04.kicad_sch PANOGOZ-TC-B1 | K1 DESIGN REVIEW

30 x 22 mm / 4 layers / placement stage / no fabricated-board claim

All symbols carry physical pin numbers. Same-name global labels are electrically connected.

See hardware/README.md and verification reports for limits, power sources and open review items.

Size: A3 | Rev: B1 | F Date: 2026-09-20
KiCad E.D.A. 10.0.6 | Id: 1/7

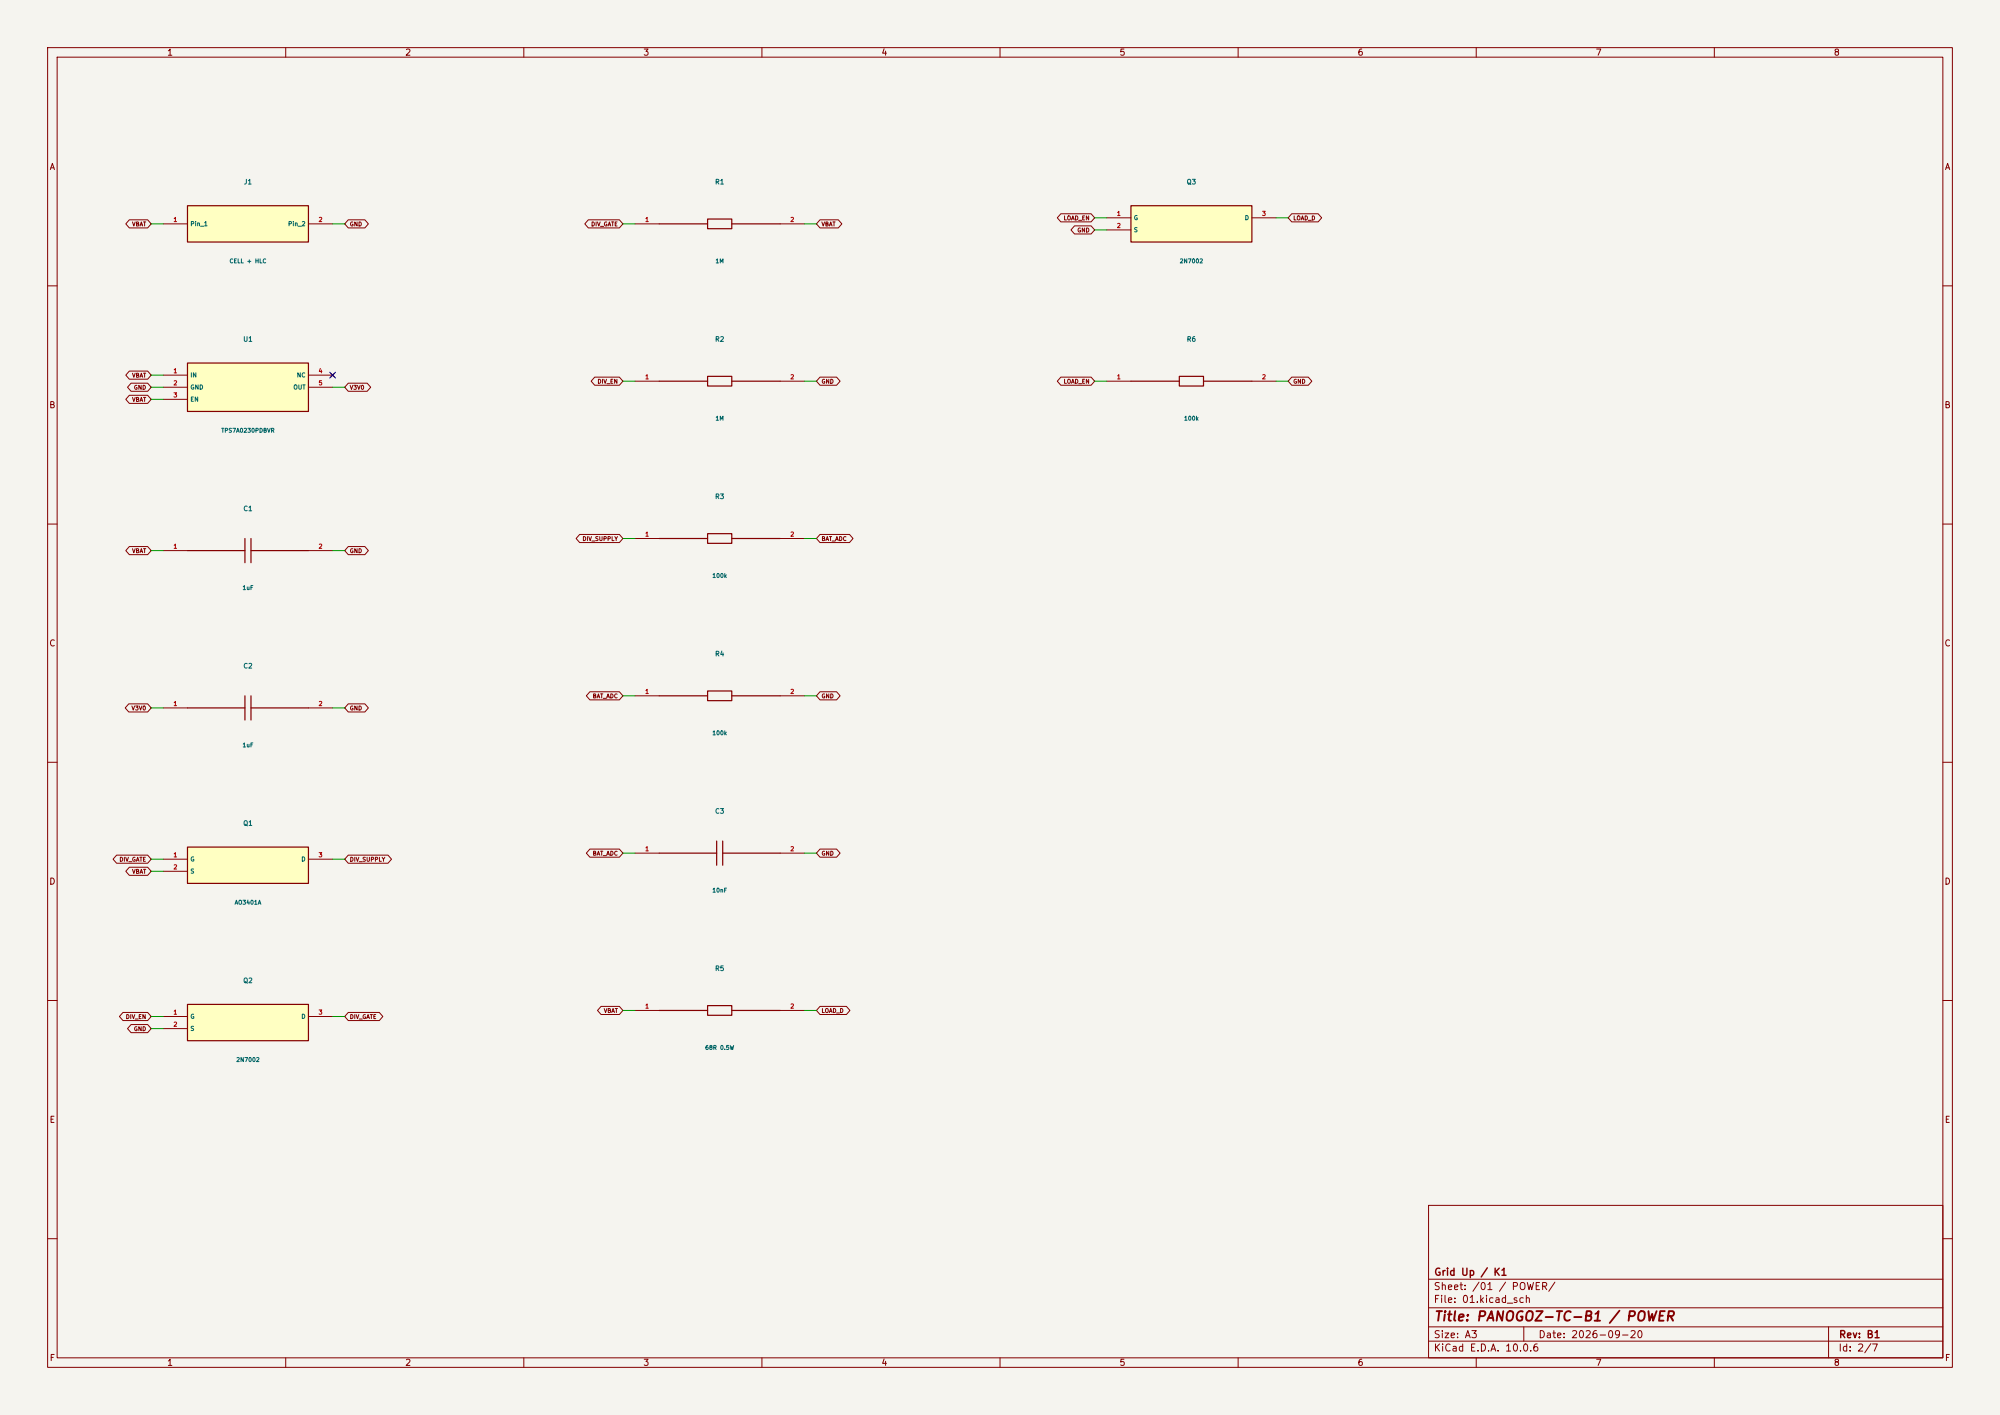
[picture p67: page 2]

Grid Up / K1
Sheet: /01 / POWER/
File: 01.kicad_sch
Title: PANOGOZ-TC-B1 / POWER

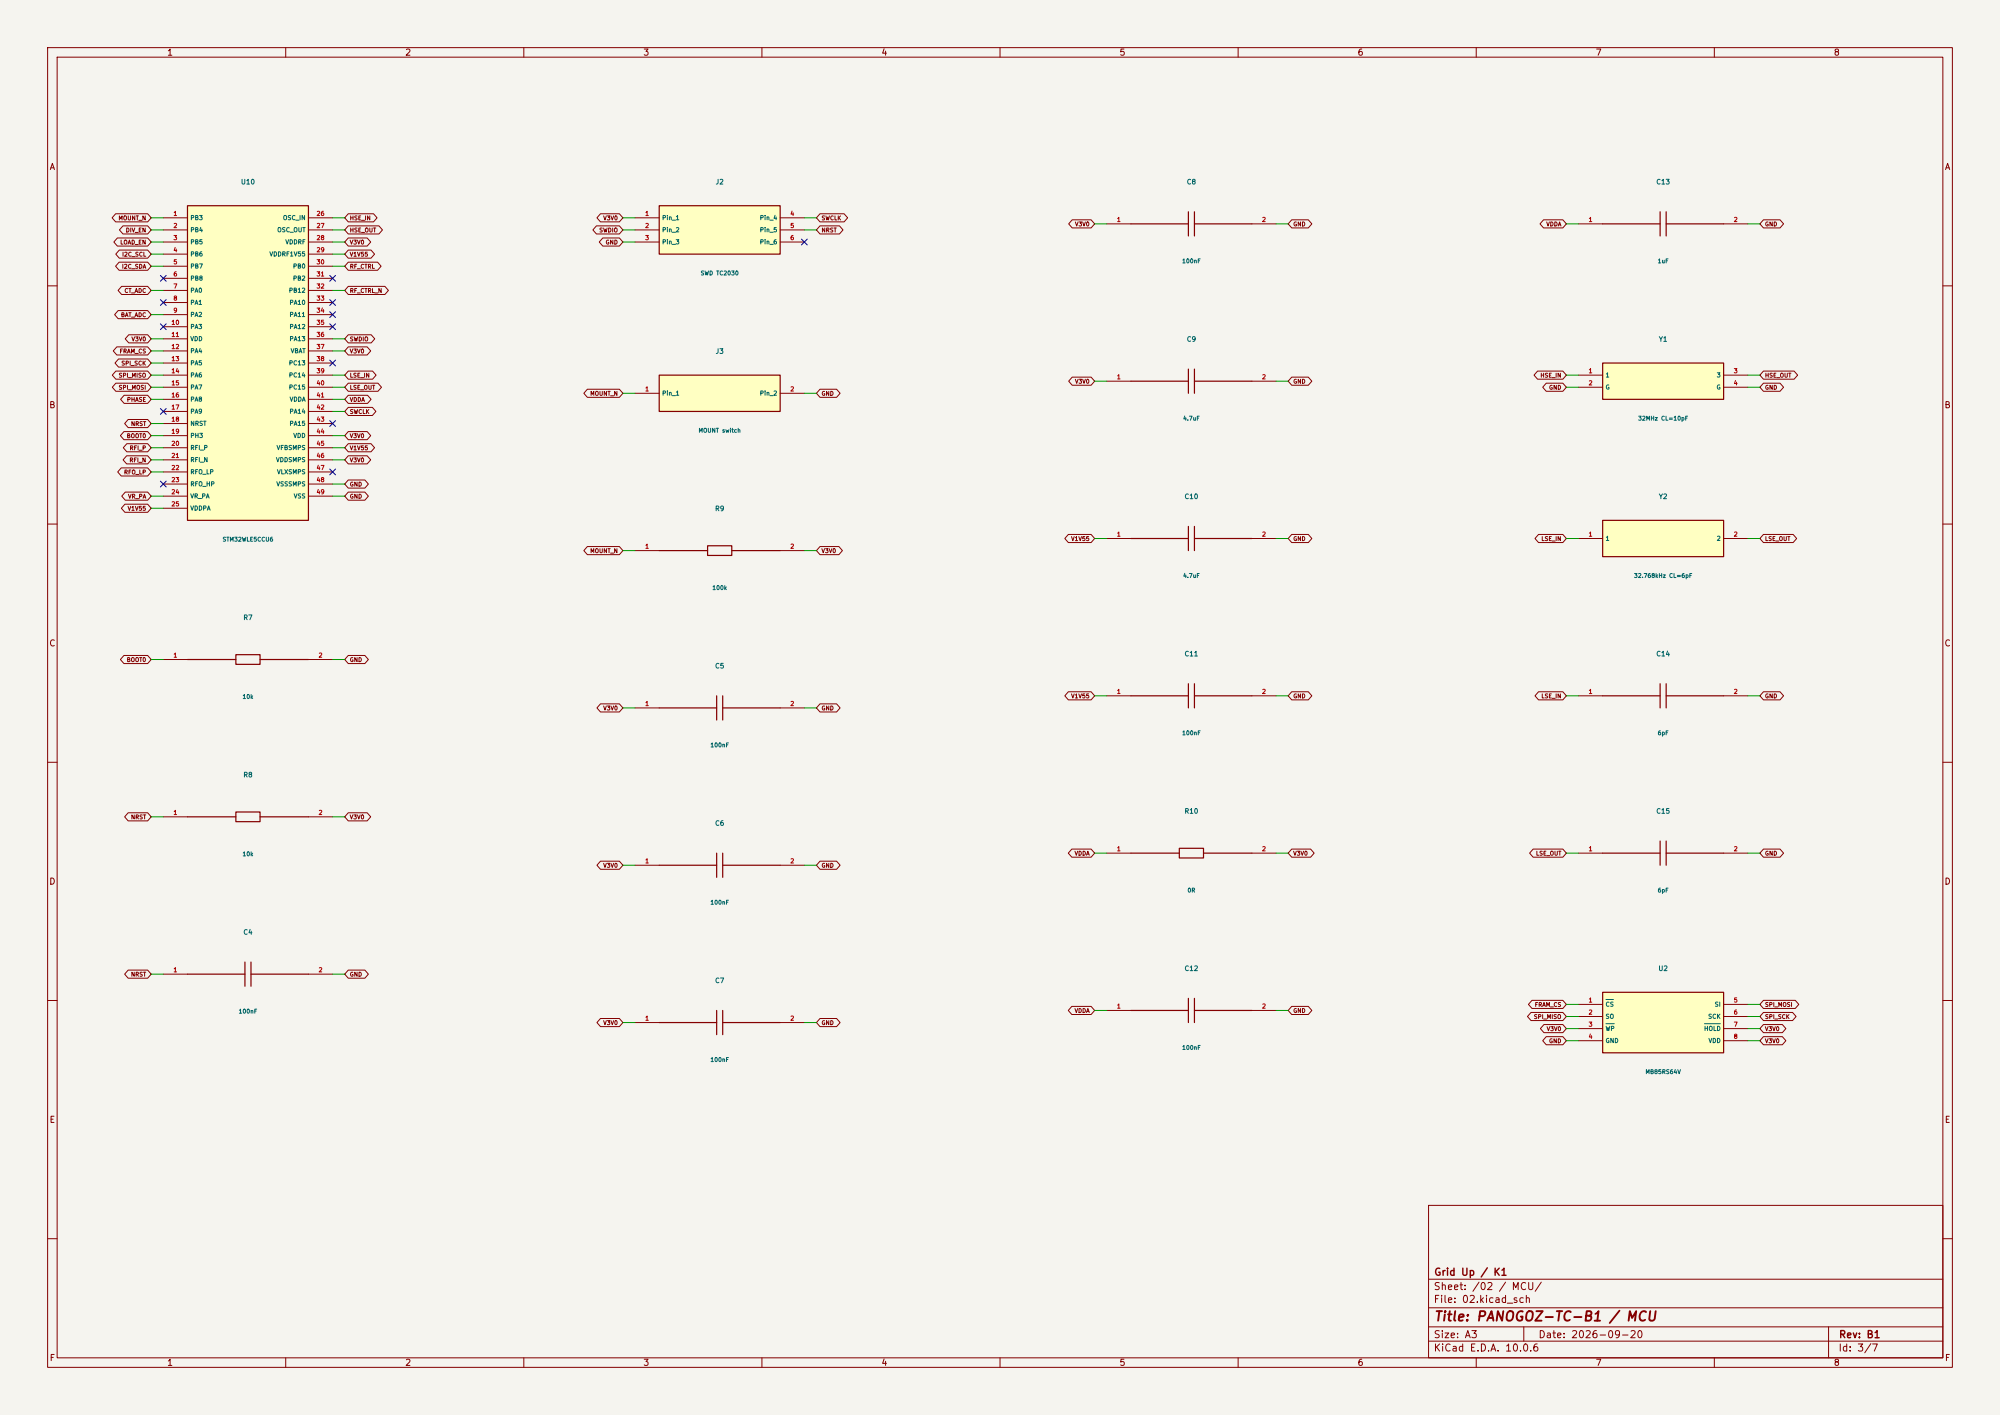
[picture p68: page 3]

Sheet: /02 / MCU/
File: 02.kicad_sch
Title: PANOGOZ-TC-B1 / MCU

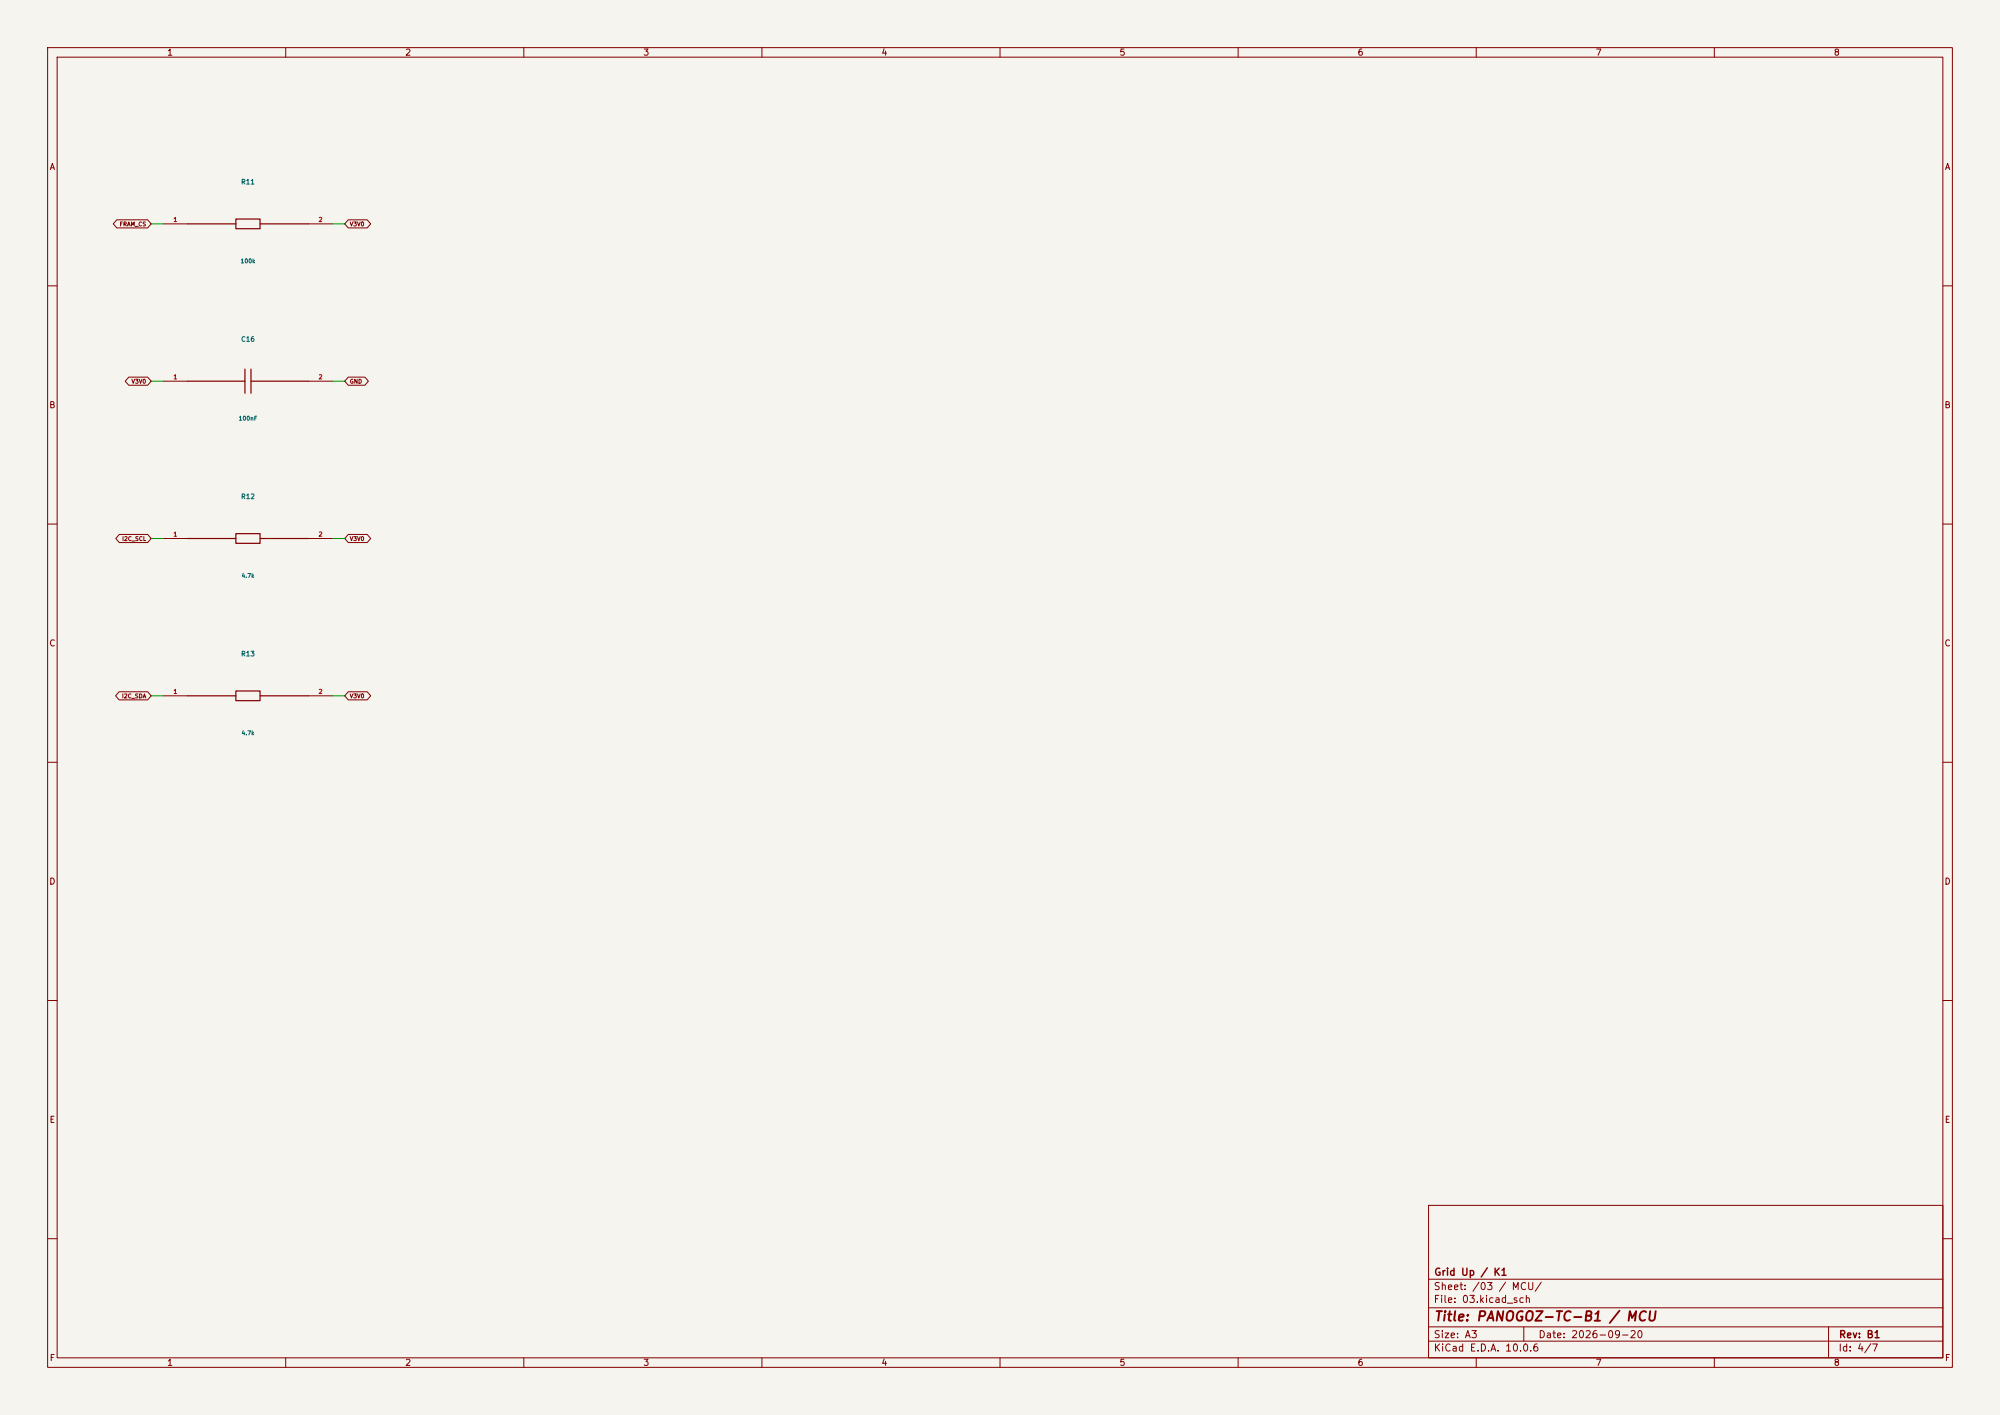
[picture p69: page 4]

Grid Up / K1
Sheet: /03 / MCU/
File: 03.kicad_sch
Title: PANOGOZ-TC-B1 / MCU

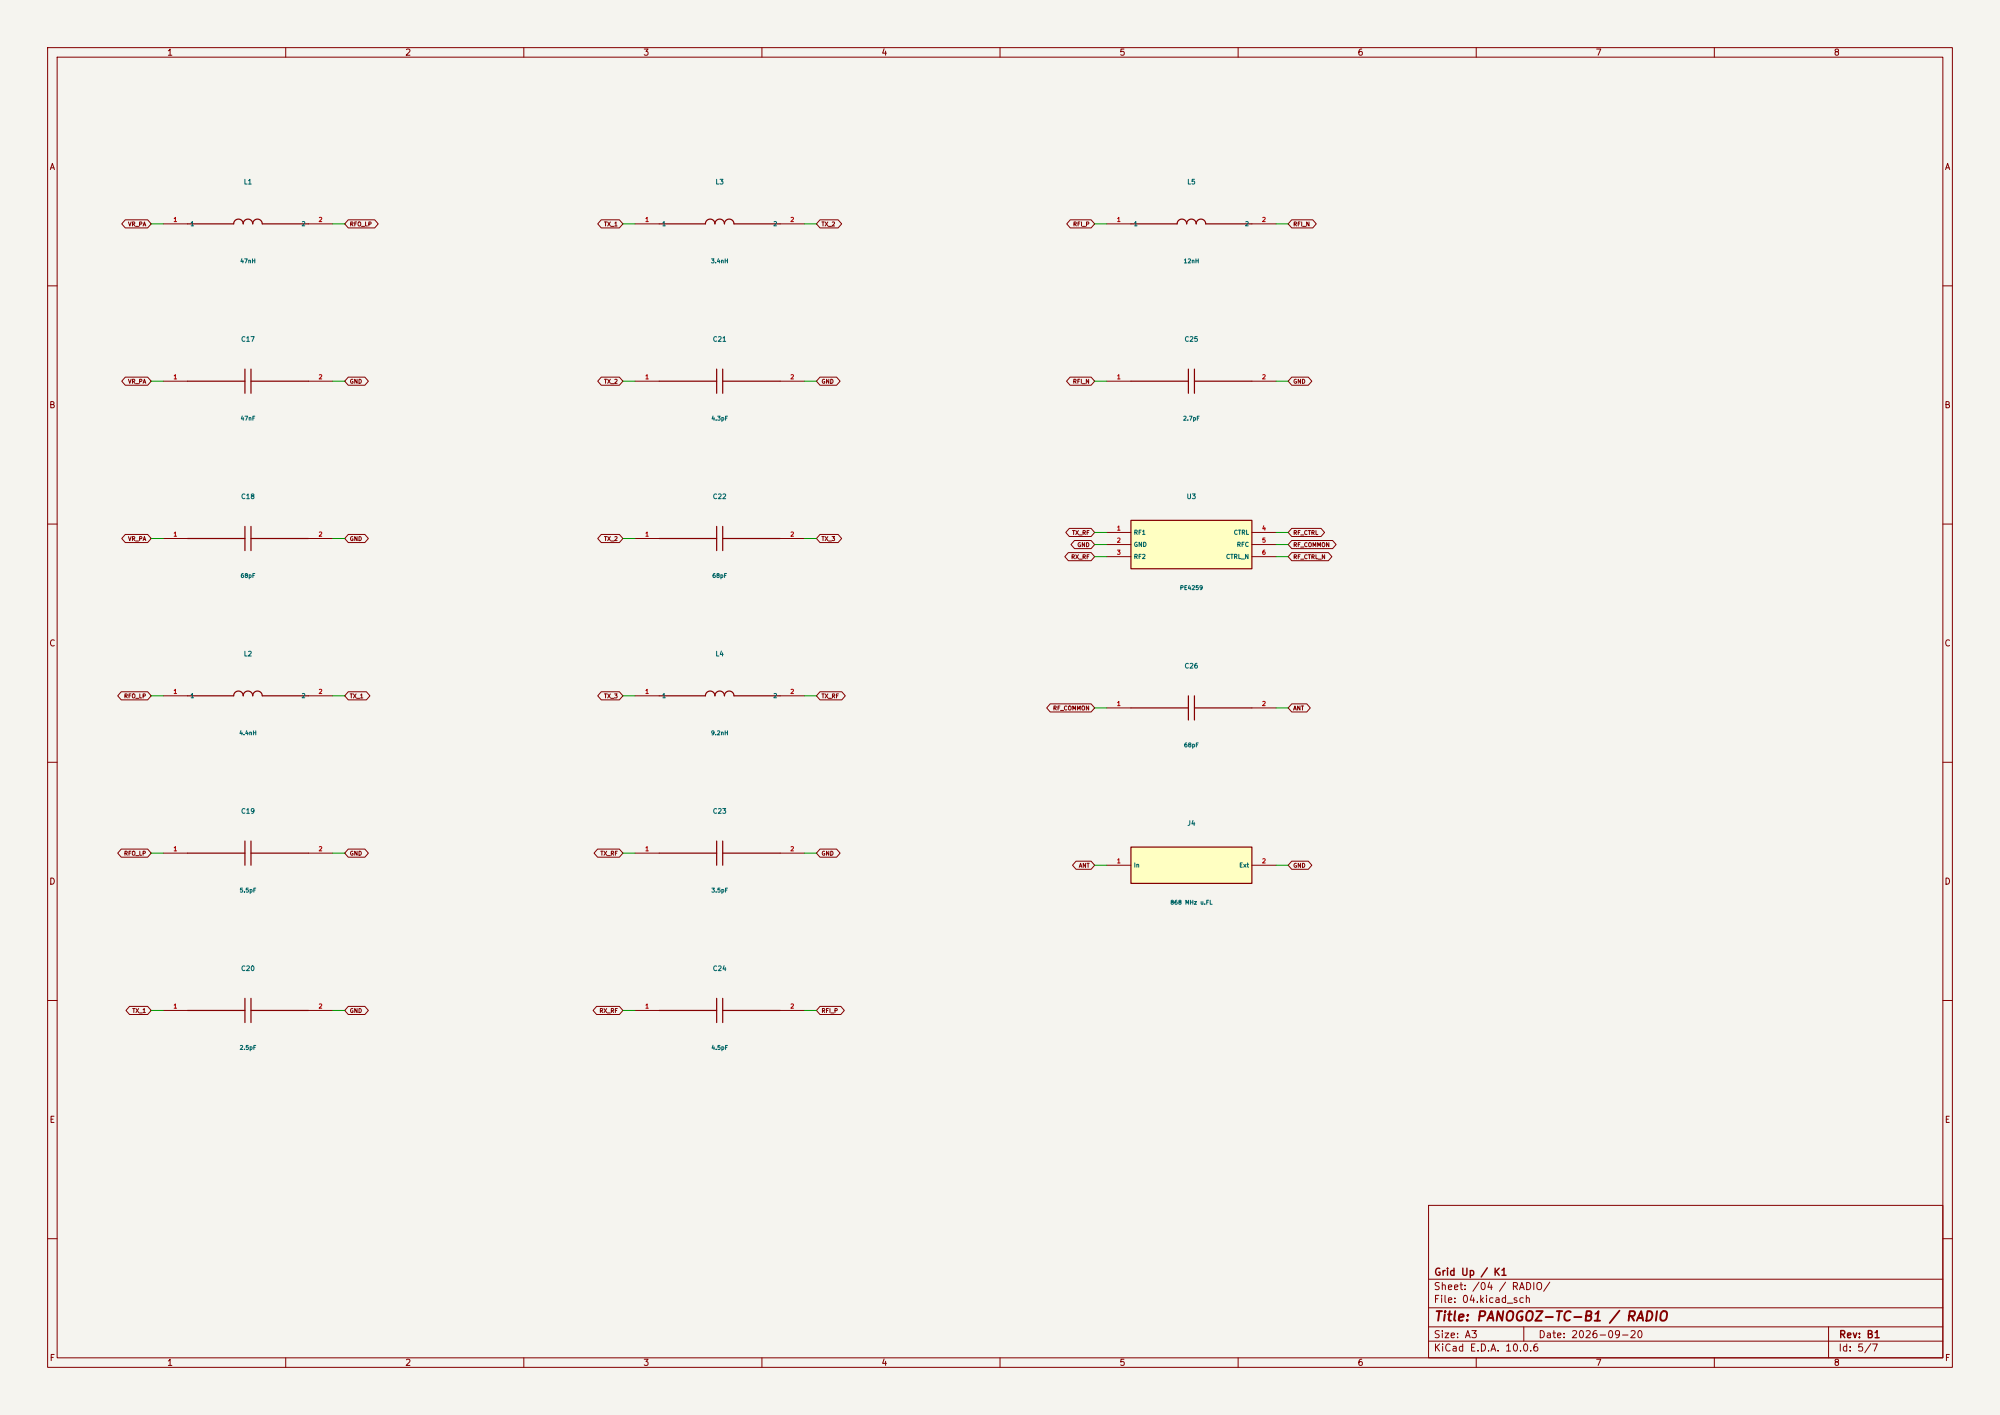
[picture p70: page 5]

Grid Up / K1
Sheet: /04 / RADIO/
File: 04.kicad_sch
Title: PANOGOZ-TC-B1 / RADIO

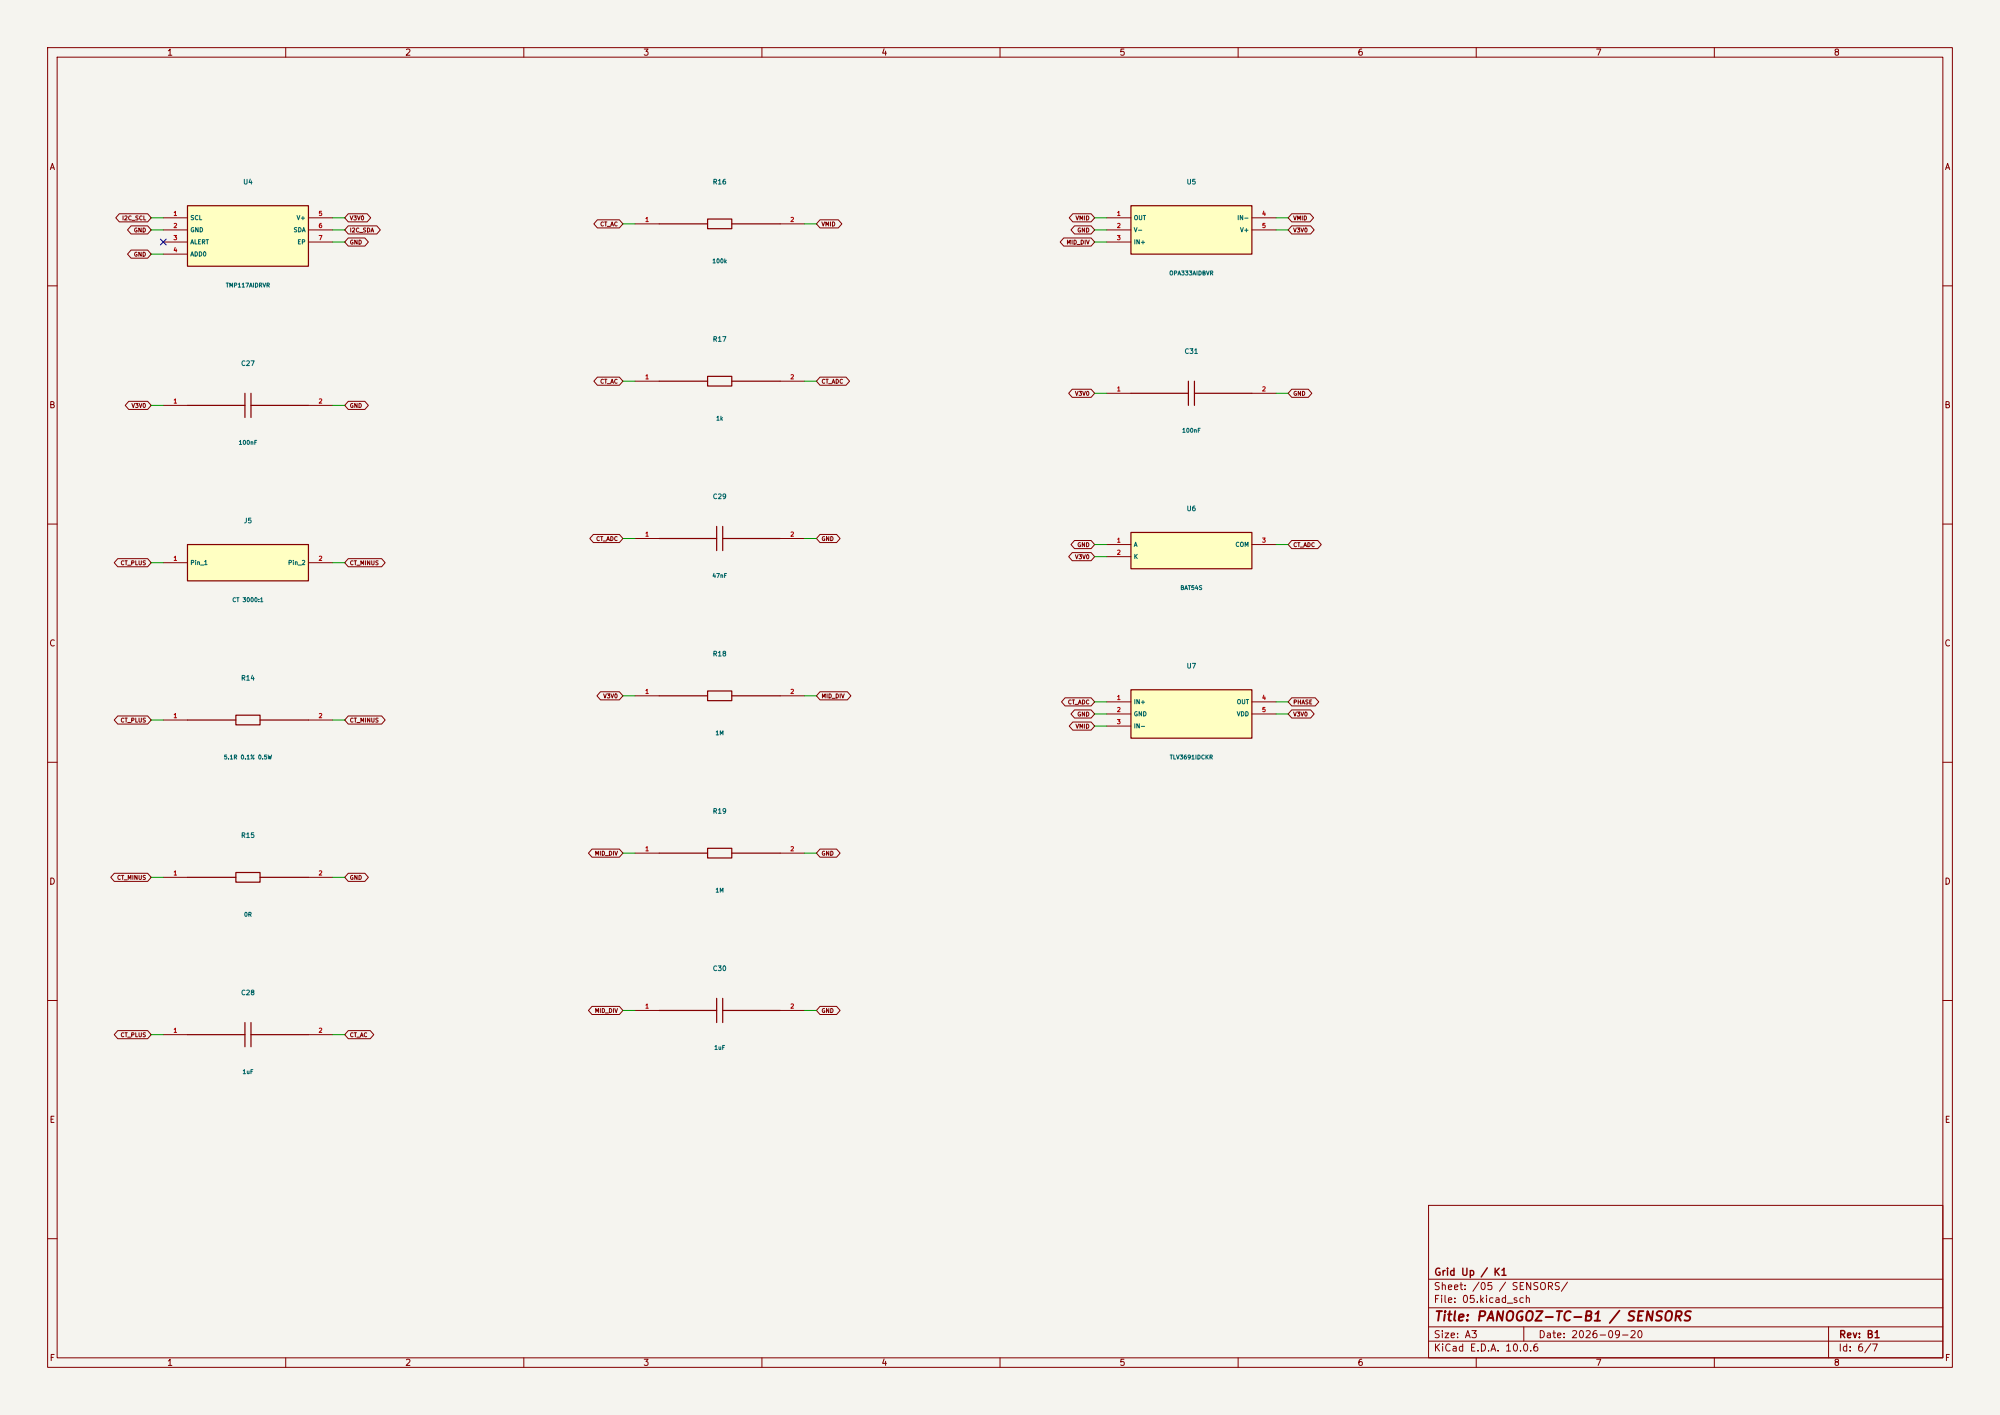
[picture p71: page 6]

Grid Up / K1
Sheet: /05 / SENSORS/
File: 05.kicad_sch
Title: PANOGOZ-TC-B1 / SENSORS

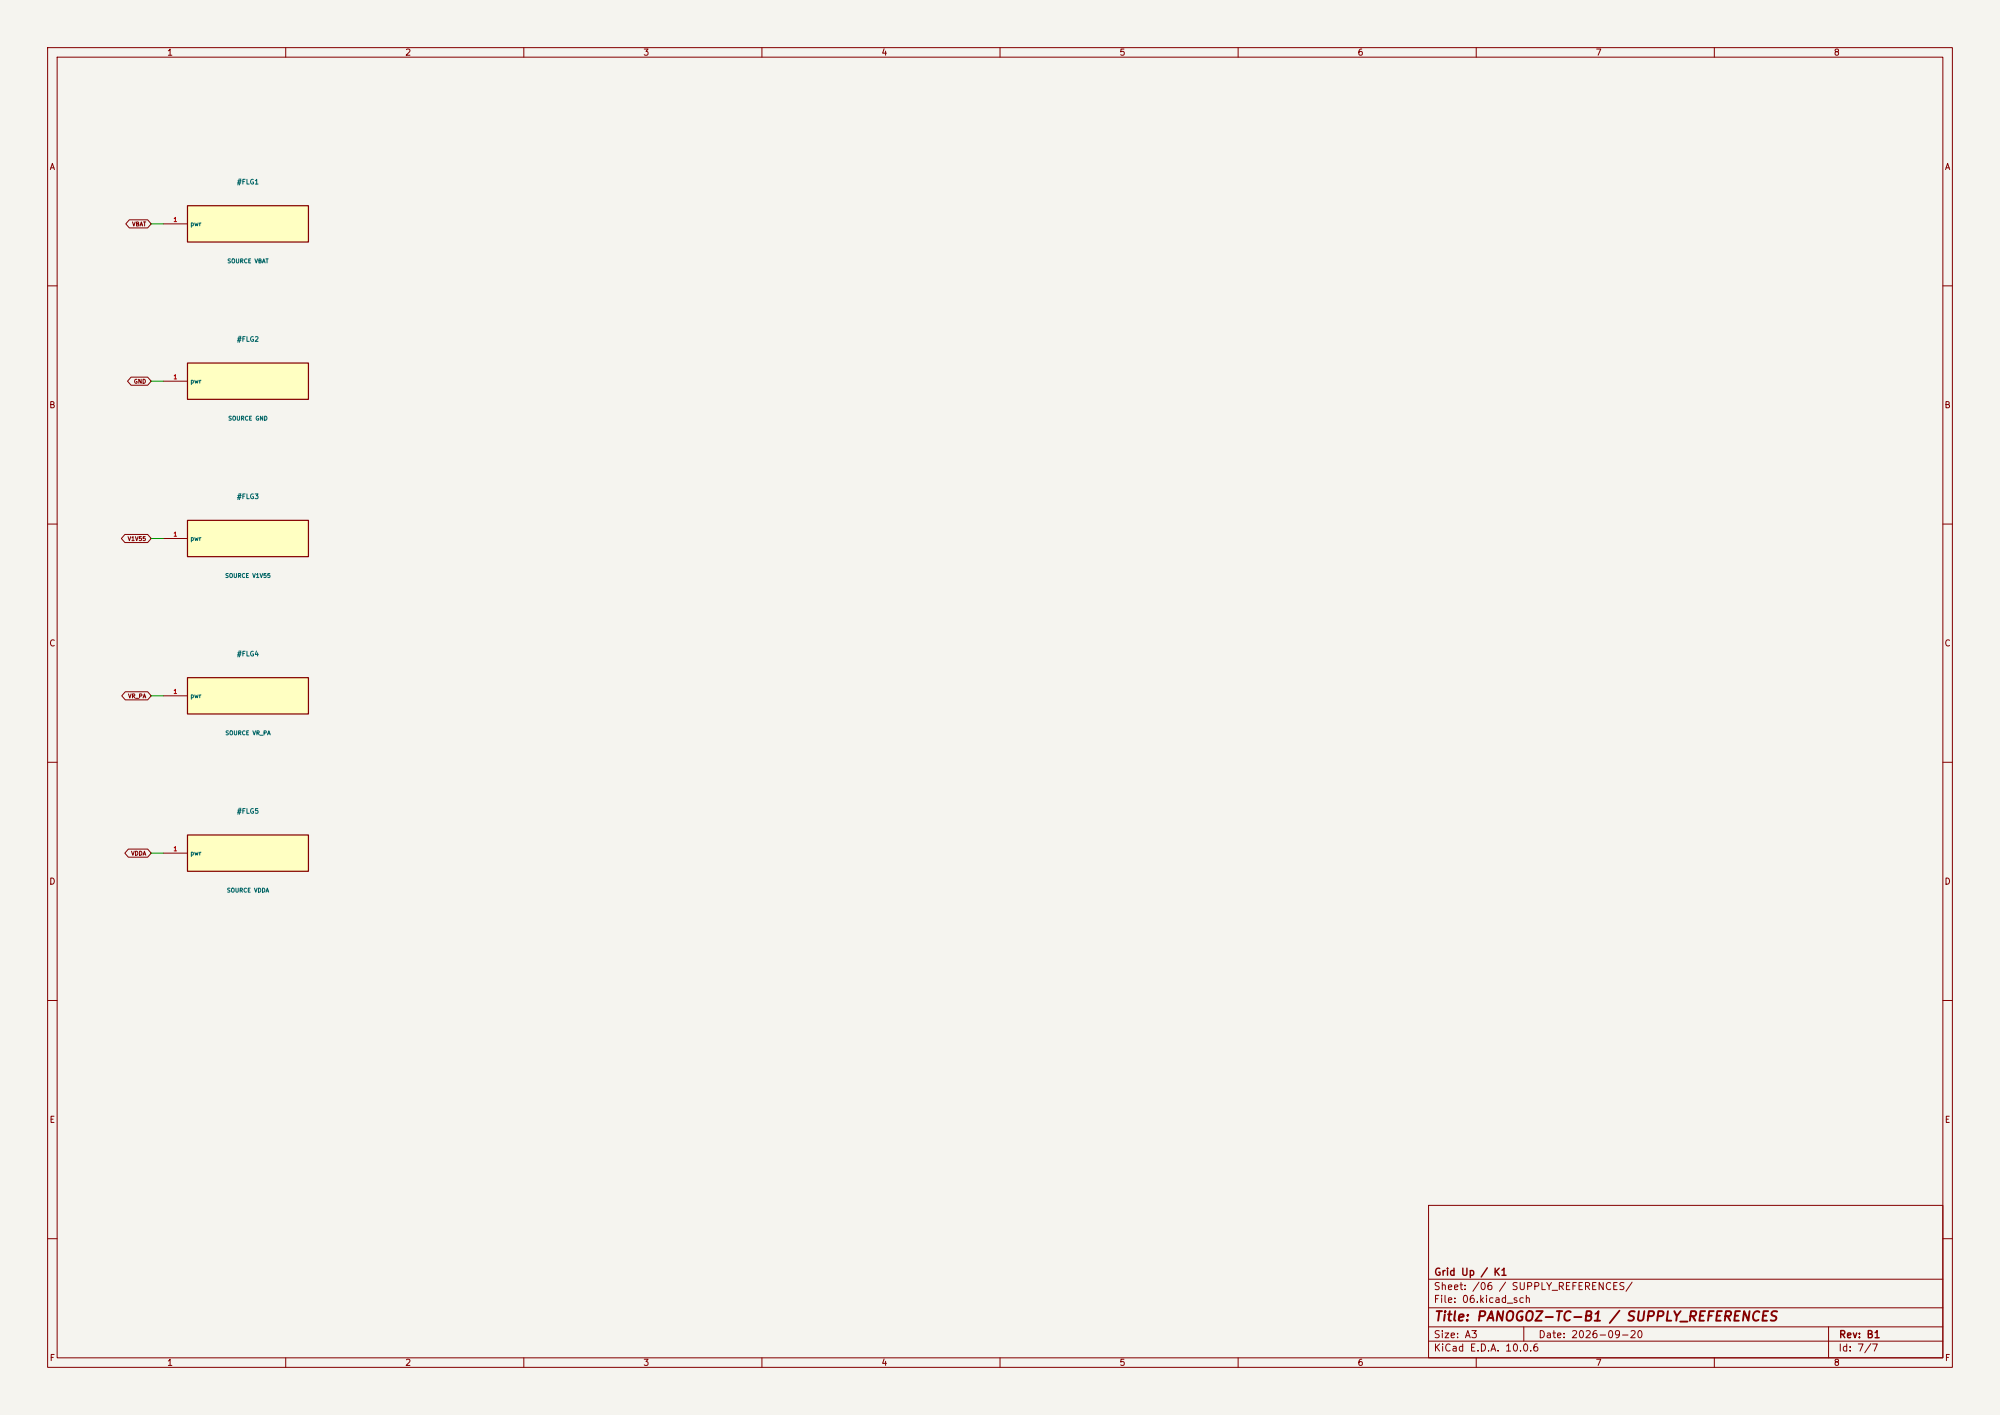
[picture p72: page 7]
