hackathon-buke-team/grid-up/hardware/B1/IR/PANOGOZ-IR-B1.kicad_pcb

## KiCad design hardware/B1/IR/PANOGOZ-IR-B1.kicad_pcb (2026-09-20)

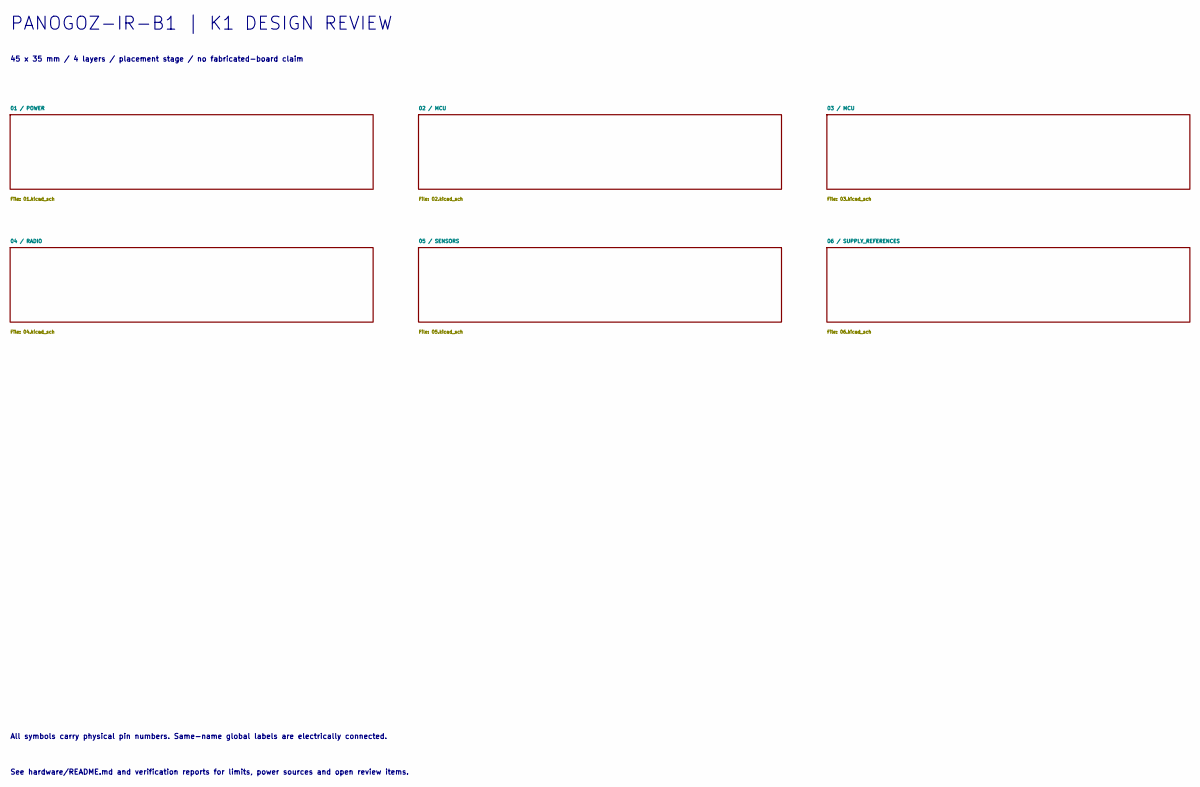
[picture p73: schematic PANOGOZ-IR-B1.kicad_sch]

Notes on the sheet:
PANOGOZ-IR-B1 | K1 DESIGN REVIEW
45 x 35 mm / 4 layers / placement stage / no fabricated-board claim
All symbols carry physical pin numbers. Same-name global labels are electrically connected.
See hardware/README.md and verification reports for limits, power sources and open review items.

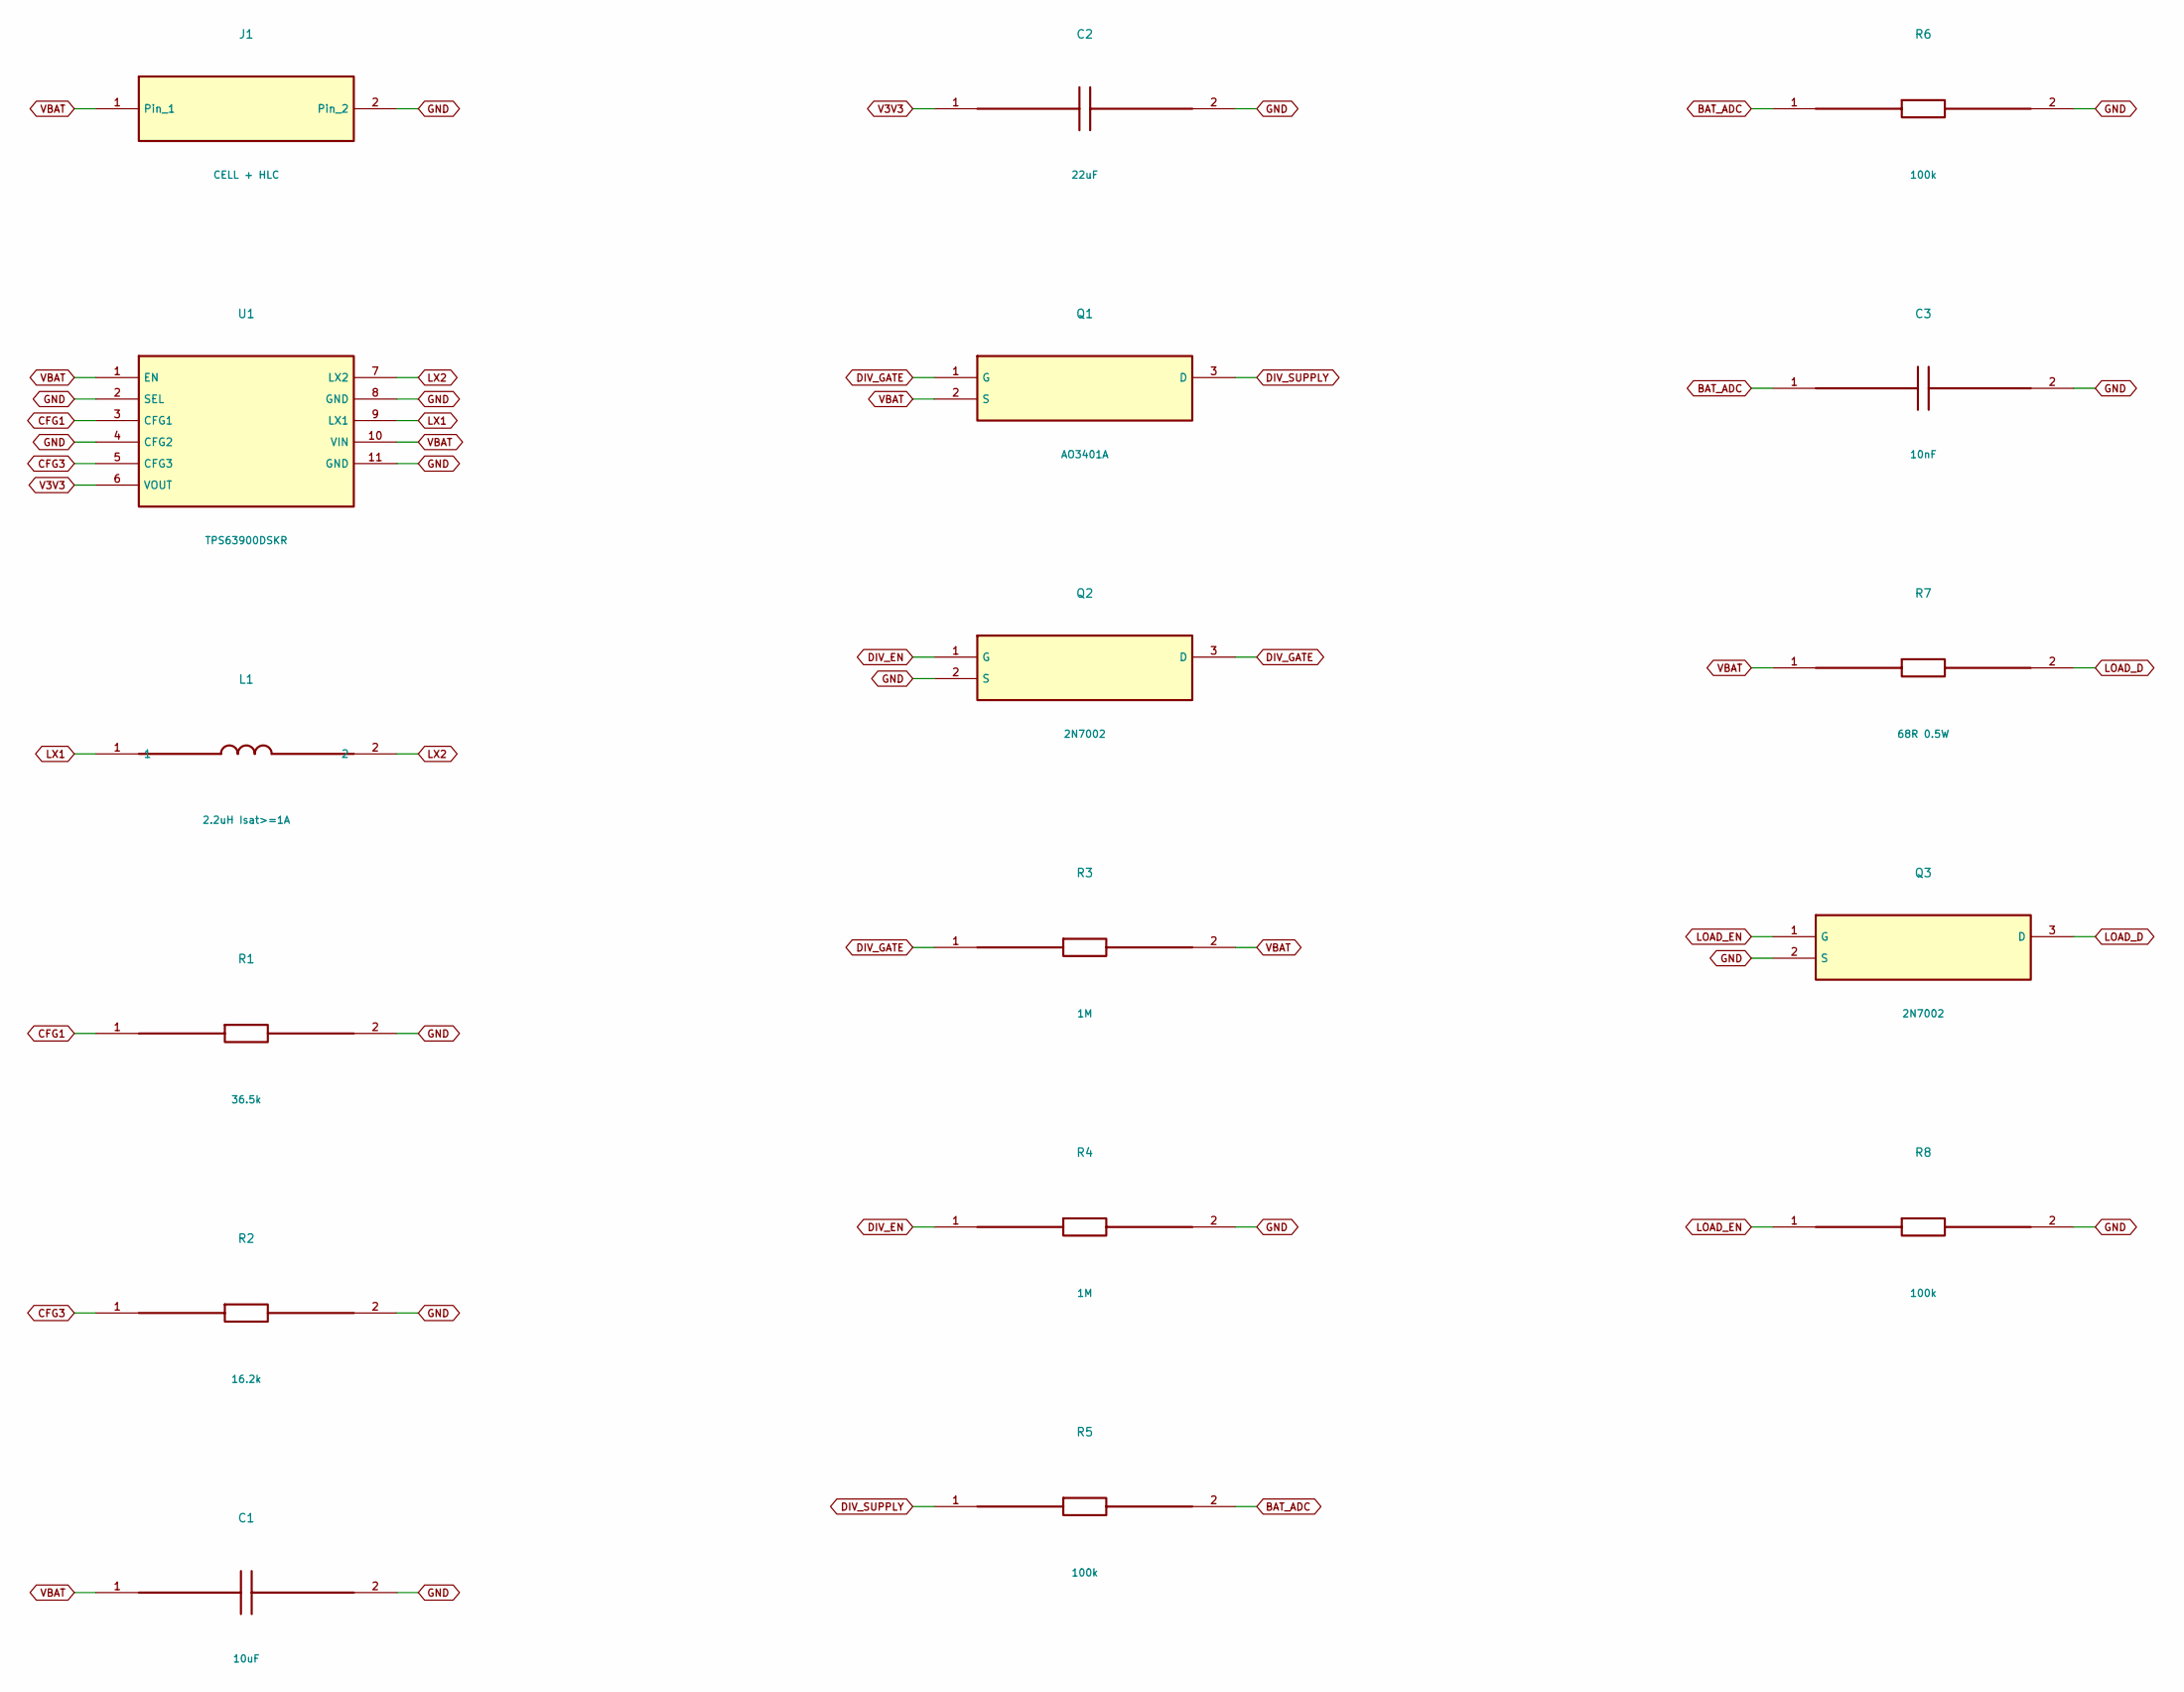
[picture p74: schematic 01.kicad_sch, PANOGOZ-IR-B1 / POWER]

Parts:
C1: 10uF; C_0805_2012Metric; MPN X7R 16V 10uF
C2: 22uF; C_0805_2012Metric; MPN X7R 16V 22uF
C3: 10nF; C_0402_1005Metric; MPN X7R 16V 10nF
J1: CELL + HLC; JST_SH_SM02B-SRSS-TB_1x02-1MP_P1.00mm_Horizontal; MPN CELL + HLC
L1: 2.2uH Isat>=1A; L_0805_2012Metric; MPN 2.2uH Isat>=1A
Q1: AO3401A; SOT-23; MPN AO3401A
Q2, Q3: 2N7002; SOT-23; MPN 2N7002
R1: 36.5k; R_0402_1005Metric; MPN 1% thick film 36.5k
R2: 16.2k; R_0402_1005Metric; MPN 1% thick film 16.2k
R3, R4: 1M; R_0402_1005Metric; MPN 1% thick film 1M
R5, R6, R8: 100k; R_0402_1005Metric; MPN 1% thick film 100k
R7: 68R 0.5W; R_1210_3225Metric; MPN 1% thick film 68R 0.5W
U1: TPS63900DSKR; WSON-10-1EP_2.5x2.5mm_P0.5mm_EP1.2x2mm_ThermalVias; MPN TPS63900DSKR

Connections:
BAT_ADC: C3.1, R5.2, R6.1; also elsewhere on the board
CFG1: R1.1, U1.3 (CFG1)
CFG3: R2.1, U1.5 (CFG3)
DIV_EN: Q2.1 (G), R4.1; also elsewhere on the board
DIV_GATE: Q1.1 (G), Q2.3 (D), R3.1
DIV_SUPPLY: Q1.3 (D), R5.1
GND: C1.2, C2.2, C3.2, J1.2, Q2.2 (S), Q3.2 (S), R1.2, R2.2, R4.2, R6.2, R8.2, U1.2 (SEL), U1.4 (CFG2), U1.8 (GND), U1.11 (GND); also elsewhere on the board
LOAD_D: Q3.3 (D), R7.2
LOAD_EN: Q3.1 (G), R8.1; also elsewhere on the board
LX1: L1.1, U1.9 (LX1)
LX2: L1.2, U1.7 (LX2)
V3V3: C2.1, U1.6 (VOUT); also elsewhere on the board
VBAT: C1.1, J1.1, Q1.2 (S), R3.2, R7.1, U1.1 (EN), U1.10 (VIN)

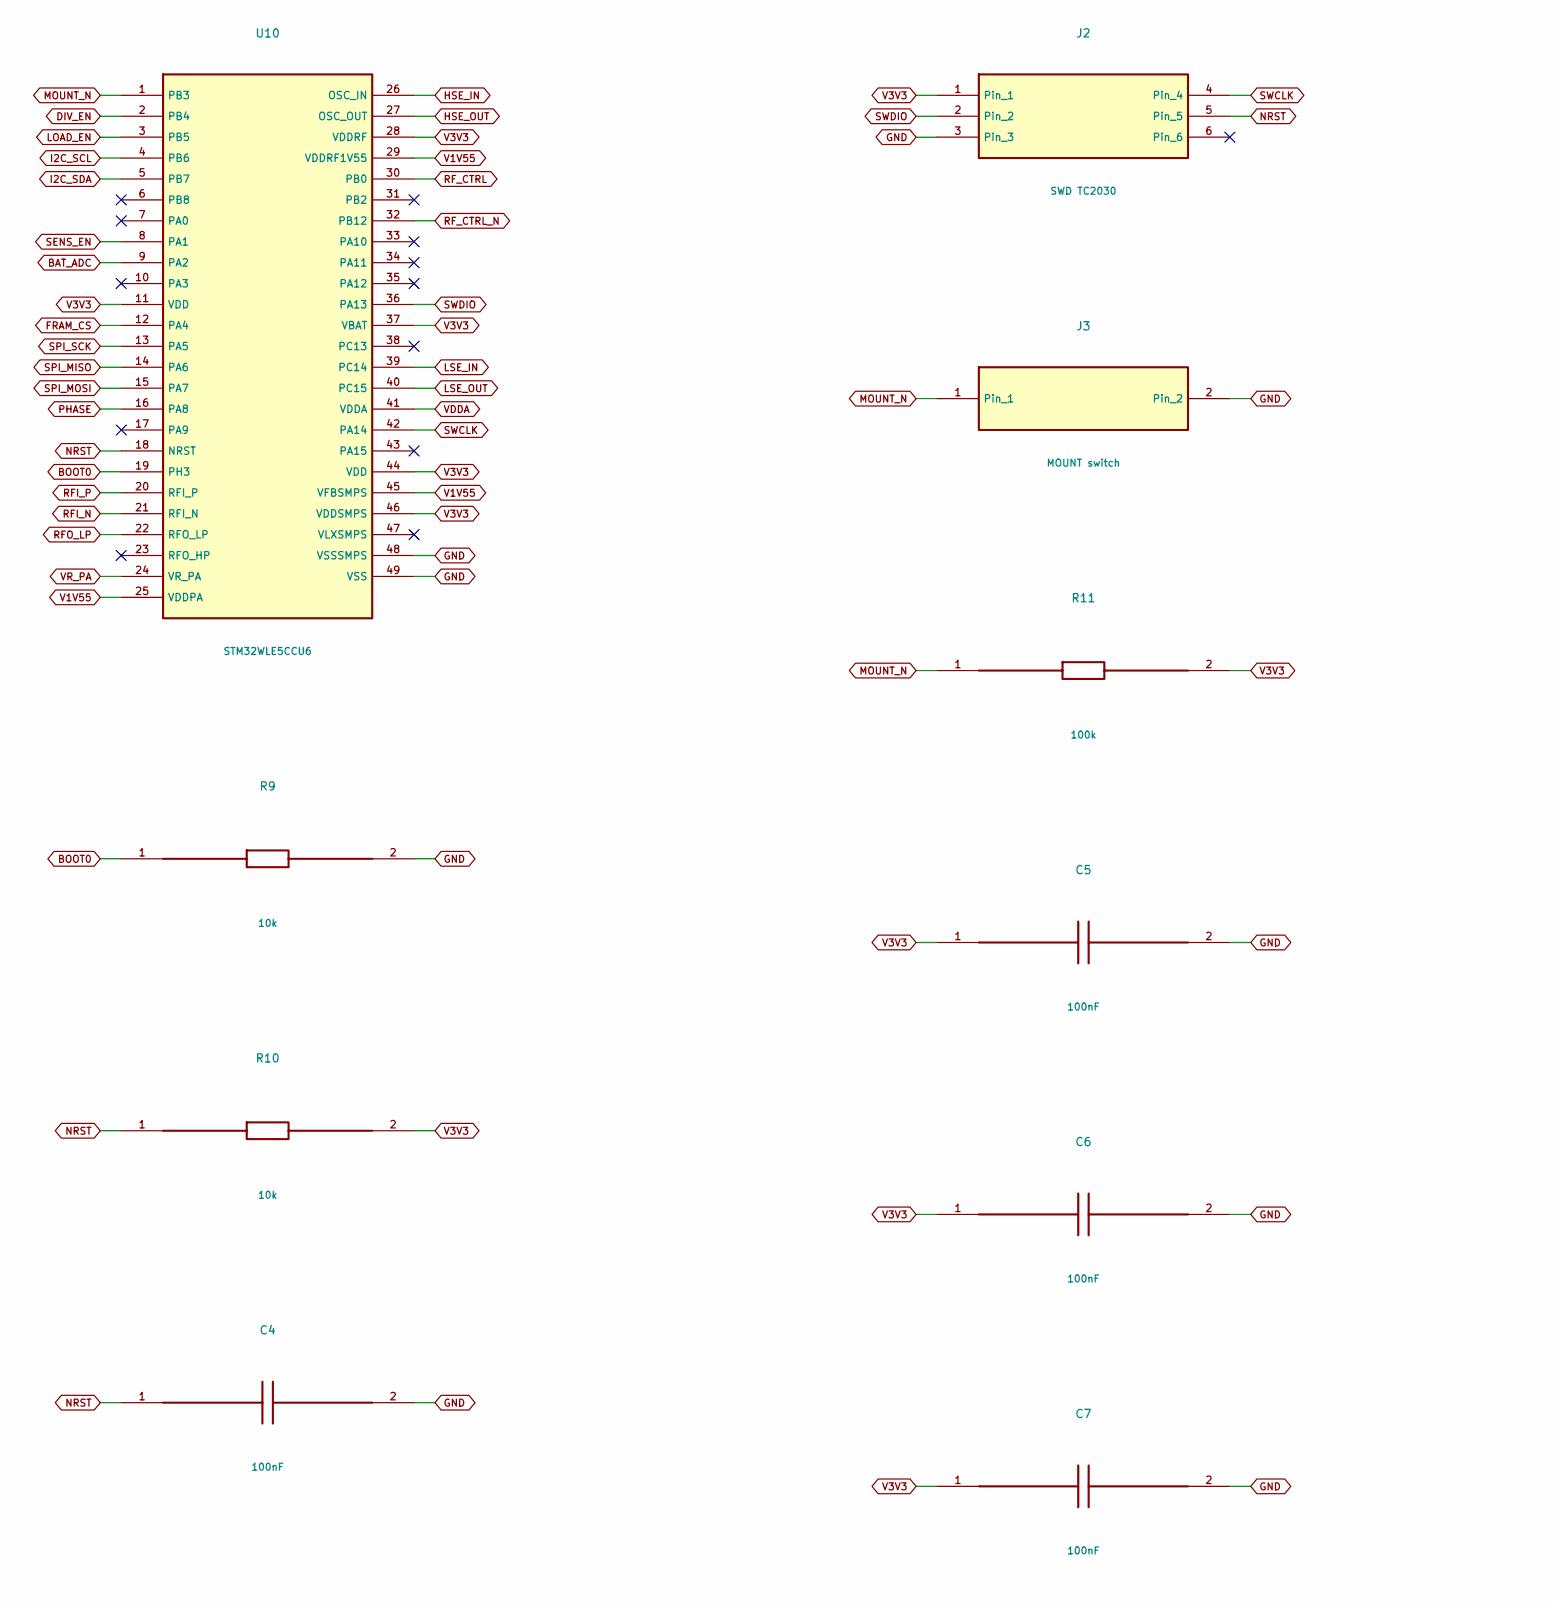
[picture p75: schematic 02.kicad_sch, PANOGOZ-IR-B1 / MCU, part in row 1, column 1]

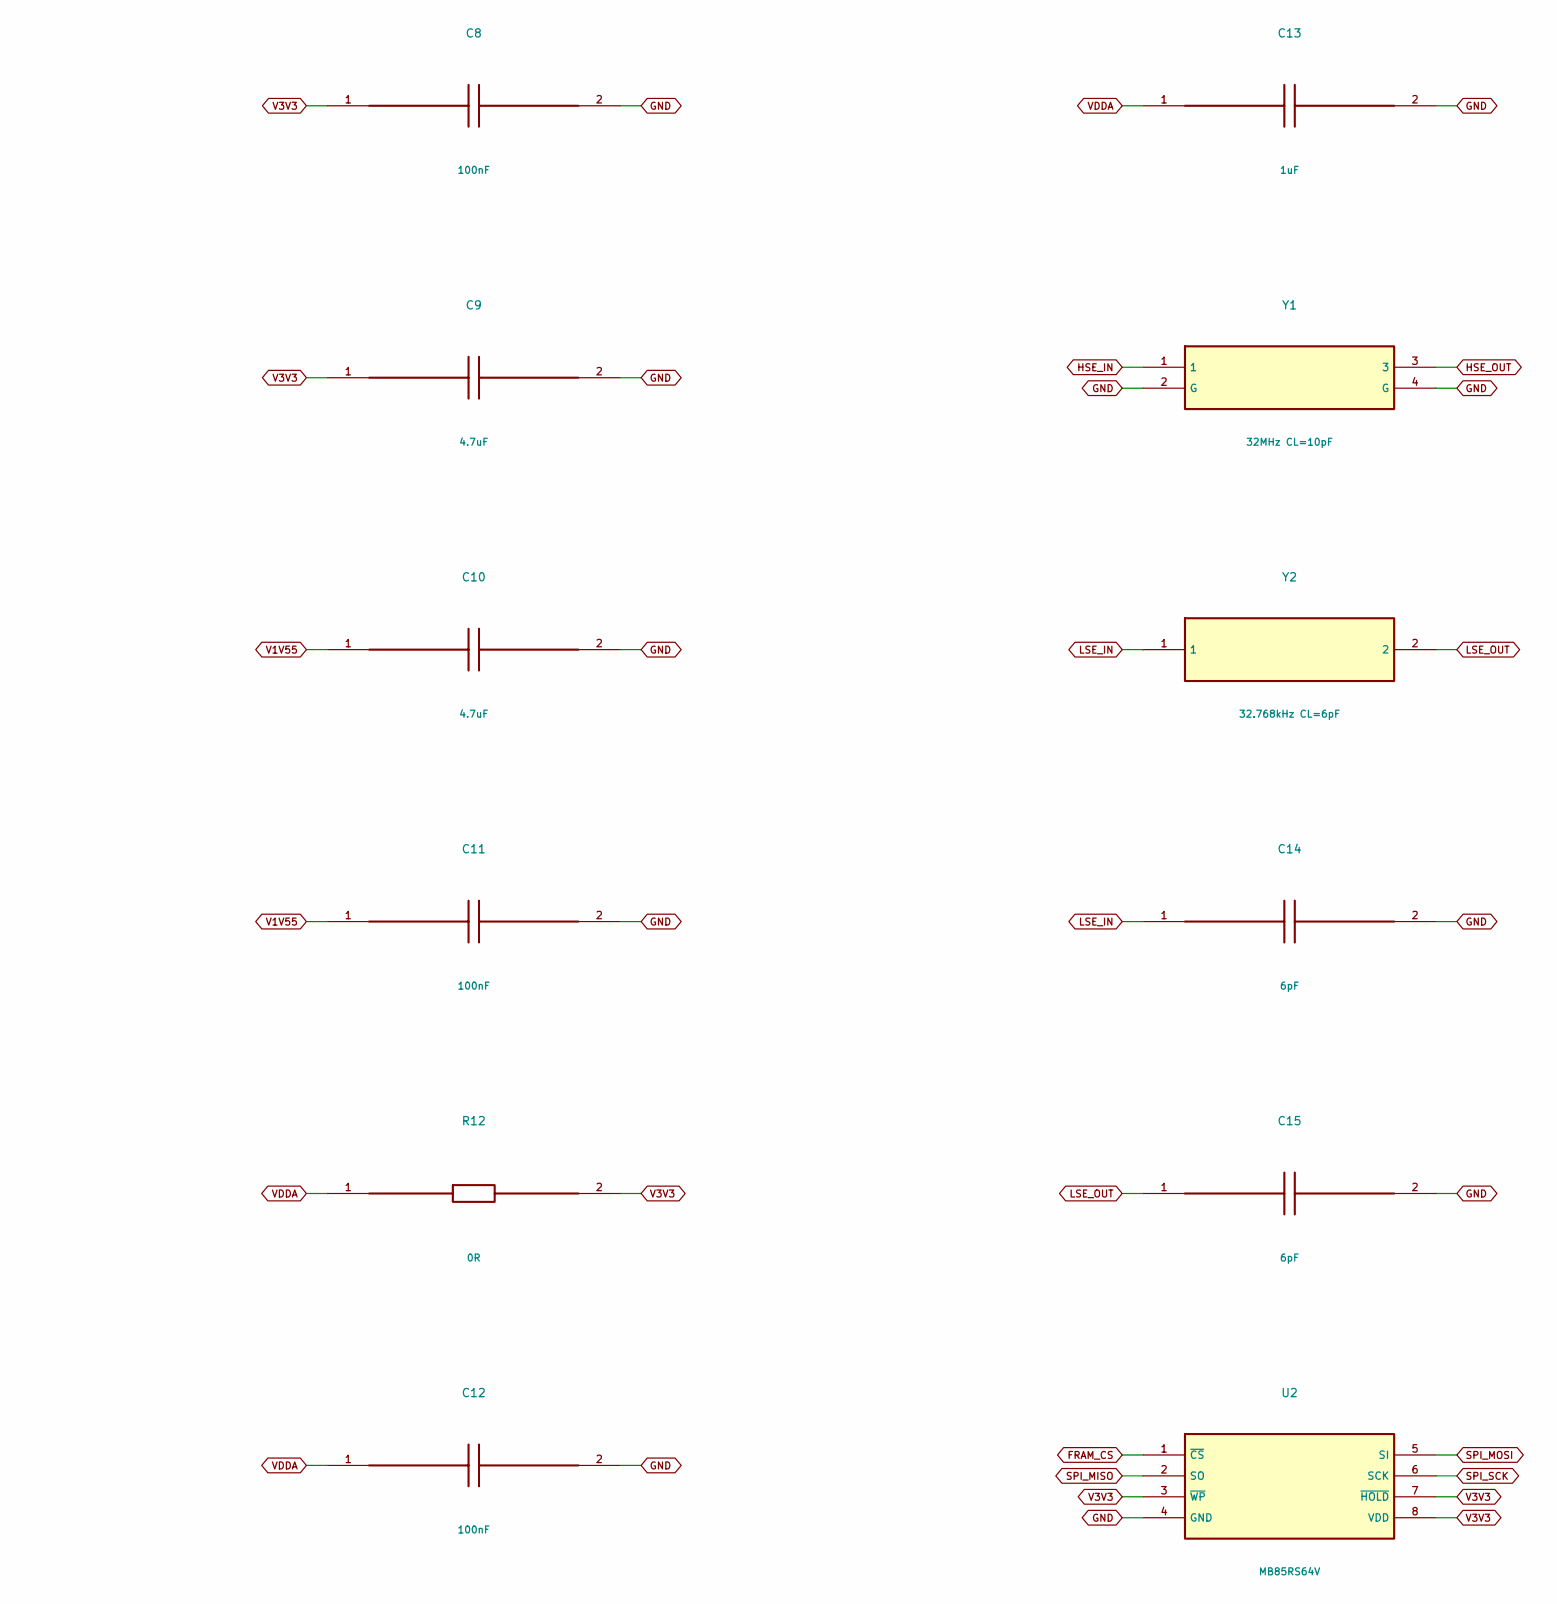
[picture p76: schematic 02.kicad_sch, PANOGOZ-IR-B1 / MCU, part in row 1, column 2]

Parts:
C4, C5, C6, C7, C8, C11, C12: 100nF; C_0402_1005Metric; MPN X7R 16V 100nF
C9, C10: 4.7uF; C_0402_1005Metric; MPN X7R 16V 4.7uF
C13: 1uF; C_0402_1005Metric; MPN X7R 16V 1uF
C14, C15: 6pF; C_0402_1005Metric; MPN X7R 16V 6pF
J2: SWD TC2030; Tag-Connect_TC2030-IDC-NL_2x03_P1.27mm_Vertical; MPN SWD TC2030
J3: MOUNT switch; JST_SH_SM02B-SRSS-TB_1x02-1MP_P1.00mm_Horizontal; MPN MOUNT switch
R9, R10: 10k; R_0402_1005Metric; MPN 1% thick film 10k
R11: 100k; R_0402_1005Metric; MPN 1% thick film 100k
R12: 0R; R_0402_1005Metric; MPN 1% thick film 0R
U2: MB85RS64V; SOIC-8_3.9x4.9mm_P1.27mm; MPN MB85RS64V
U10: STM32WLE5CCU6; QFN-48-1EP_7x7mm_P0.5mm_EP5.6x5.6mm; MPN STM32WLE5CCU6
Y1: 32MHz CL=10pF; Crystal_SMD_3225-4Pin_3.2x2.5mm; MPN 32MHz CL=10pF
Y2: 32.768kHz CL=6pF; Crystal_SMD_3215-2Pin_3.2x1.5mm; MPN 32.768kHz CL=6pF

Connections:
BAT_ADC: U10.9 (PA2); also elsewhere on the board
BOOT0: R9.1, U10.19 (PH3)
DIV_EN: U10.2 (PB4); also elsewhere on the board
FRAM_CS: U2.1 (~CS), U10.12 (PA4); also elsewhere on the board
GND: C4.2, C5.2, C6.2, C7.2, C8.2, C9.2, C10.2, C11.2, C12.2, C13.2, C14.2, C15.2, J2.3, J3.2, R9.2, U2.4 (GND), U10.48 (VSSSMPS), U10.49 (VSS), Y1.2 (G), Y1.4 (G); also elsewhere on the board
HSE_IN: U10.26 (OSC_IN), Y1.1
HSE_OUT: U10.27 (OSC_OUT), Y1.3
I2C_SCL: U10.4 (PB6); also elsewhere on the board
I2C_SDA: U10.5 (PB7); also elsewhere on the board
LOAD_EN: U10.3 (PB5); also elsewhere on the board
LSE_IN: C14.1, U10.39 (PC14), Y2.1
LSE_OUT: C15.1, U10.40 (PC15), Y2.2
MOUNT_N: J3.1, R11.1, U10.1 (PB3)
NRST: C4.1, J2.5, R10.1, U10.18 (NRST)
PHASE: U10.16 (PA8); also elsewhere on the board
RFI_N: U10.21 (RFI_N); also elsewhere on the board
RFI_P: U10.20 (RFI_P); also elsewhere on the board
RFO_LP: U10.22 (RFO_LP); also elsewhere on the board
RF_CTRL: U10.30 (PB0); also elsewhere on the board
RF_CTRL_N: U10.32 (PB12); also elsewhere on the board
SENS_EN: U10.8 (PA1); also elsewhere on the board
SPI_MISO: U2.2 (SO), U10.14 (PA6)
SPI_MOSI: U2.5 (SI), U10.15 (PA7)
SPI_SCK: U2.6 (SCK), U10.13 (PA5)
SWCLK: J2.4, U10.42 (PA14)
SWDIO: J2.2, U10.36 (PA13)
V1V55: C10.1, C11.1, U10.25 (VDDPA), U10.29 (VDDRF1V55), U10.45 (VFBSMPS)
V3V3: C5.1, C6.1, C7.1, C8.1, C9.1, J2.1, R10.2, R11.2, R12.2, U2.3 (~WP), U2.7 (~HOLD), U2.8 (VDD), U10.11 (VDD), U10.28 (VDDRF), U10.37 (VBAT), U10.44 (VDD), U10.46 (VDDSMPS); also elsewhere on the board
VDDA: C12.1, C13.1, R12.1, U10.41 (VDDA)
VR_PA: U10.24 (VR_PA); also elsewhere on the board

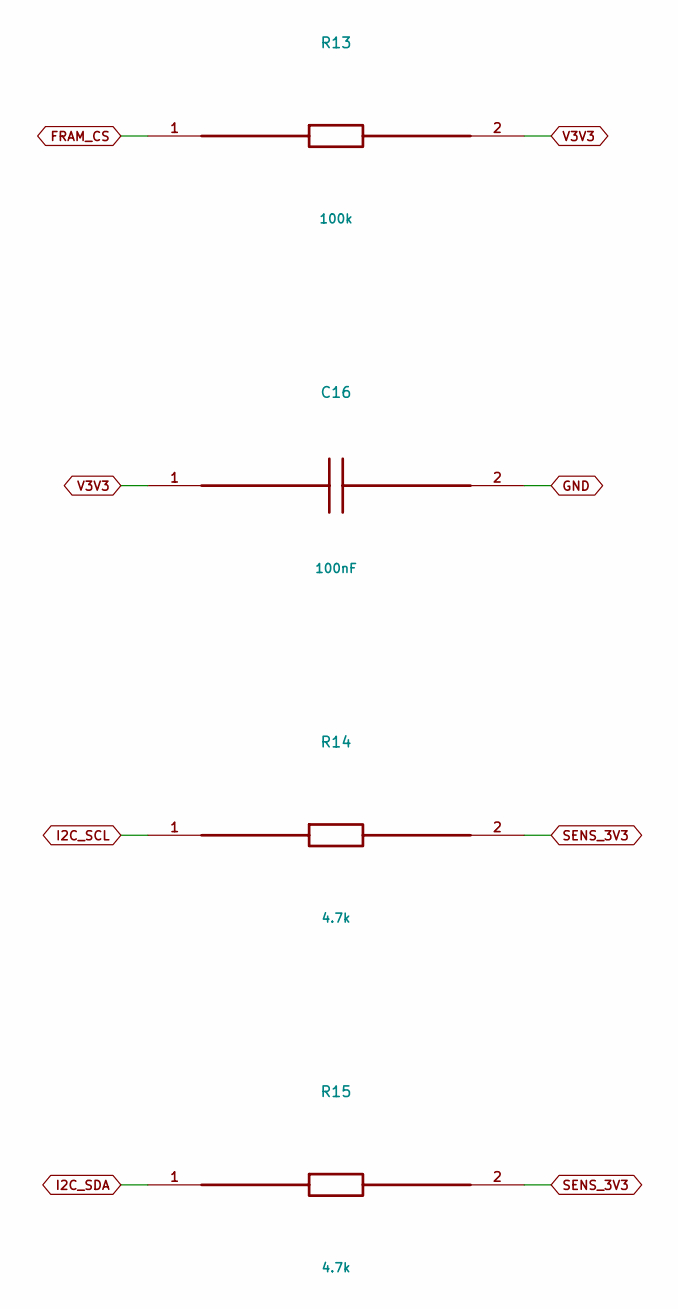
[picture p77: schematic 03.kicad_sch, PANOGOZ-IR-B1 / MCU]

Parts:
C16: 100nF; C_0402_1005Metric; MPN X7R 16V 100nF
R13: 100k; R_0402_1005Metric; MPN 1% thick film 100k
R14, R15: 4.7k; R_0402_1005Metric; MPN 1% thick film 4.7k

Connections:
FRAM_CS: R13.1; also elsewhere on the board
GND: C16.2; also elsewhere on the board
I2C_SCL: R14.1; also elsewhere on the board
I2C_SDA: R15.1; also elsewhere on the board
SENS_3V3: R14.2, R15.2; also elsewhere on the board
V3V3: C16.1, R13.2; also elsewhere on the board

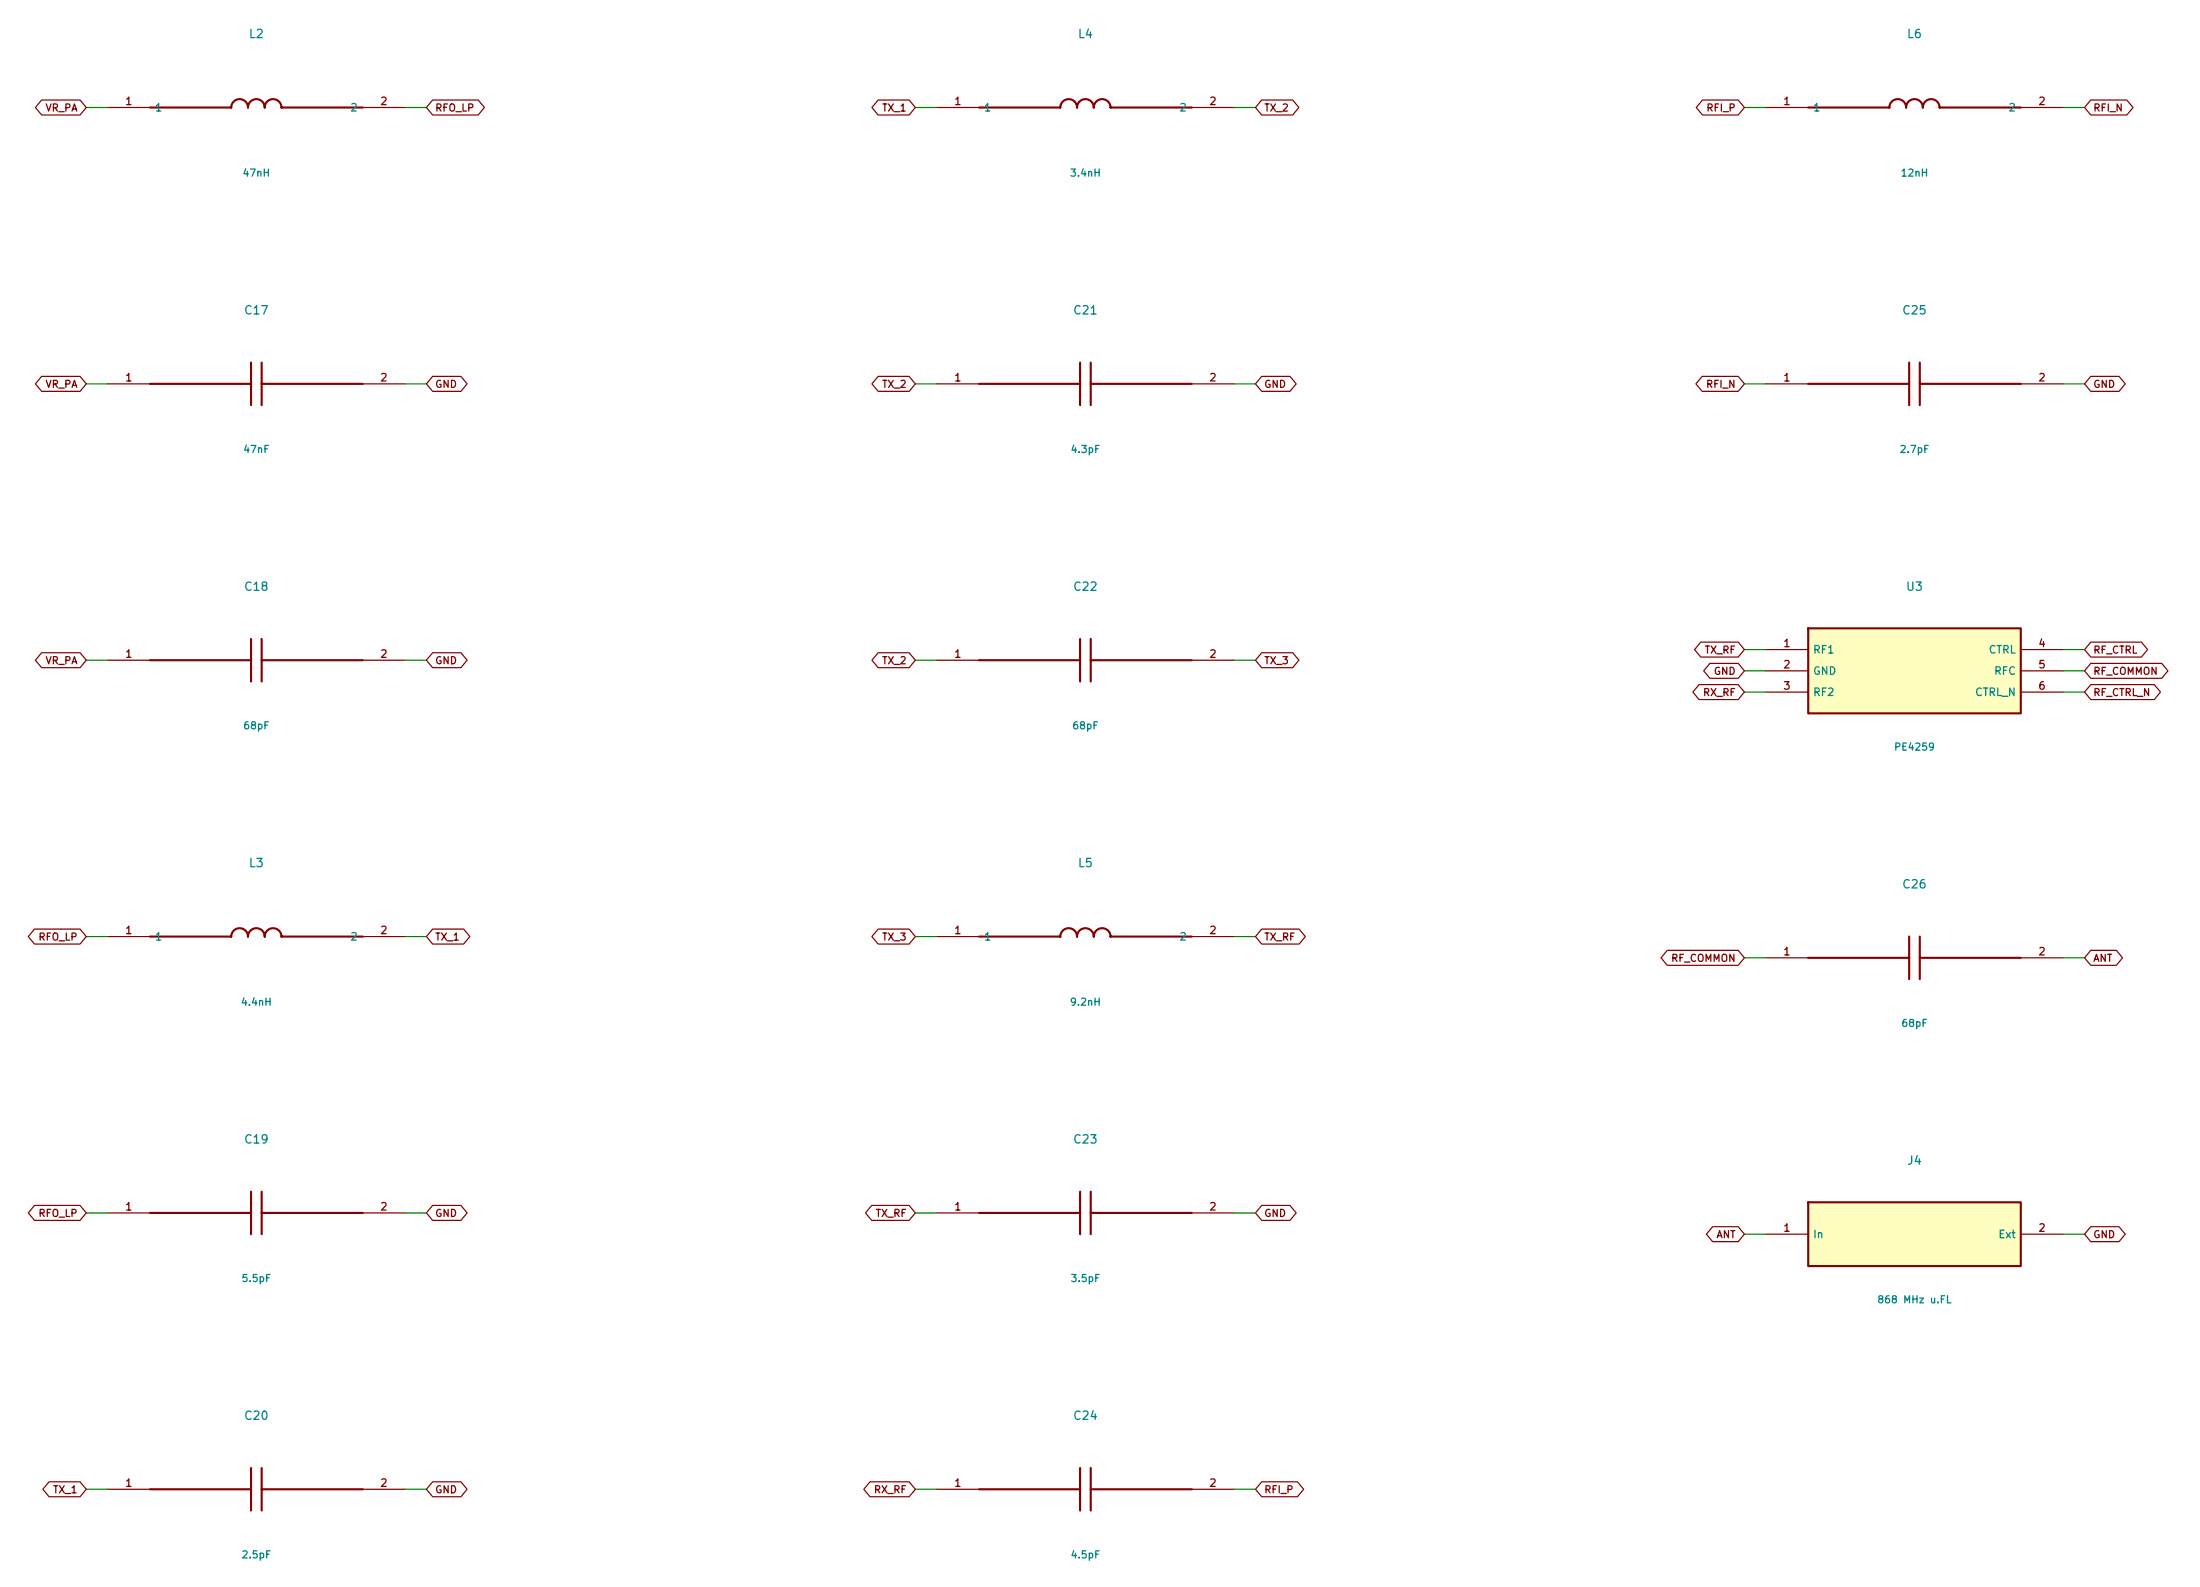
[picture p78: schematic 04.kicad_sch, PANOGOZ-IR-B1 / RADIO]

Parts:
C17: 47nF; C_0402_1005Metric; MPN X7R 16V 47nF
C18, C22, C26: 68pF; C_0402_1005Metric; MPN X7R 16V 68pF
C19: 5.5pF; C_0402_1005Metric; MPN X7R 16V 5.5pF
C20: 2.5pF; C_0402_1005Metric; MPN X7R 16V 2.5pF
C21: 4.3pF; C_0402_1005Metric; MPN X7R 16V 4.3pF
C23: 3.5pF; C_0402_1005Metric; MPN X7R 16V 3.5pF
C24: 4.5pF; C_0402_1005Metric; MPN X7R 16V 4.5pF
C25: 2.7pF; C_0402_1005Metric; MPN X7R 16V 2.7pF
J4: 868 MHz u.FL; U.FL_Hirose_U.FL-R-SMT-1_Vertical; MPN 868 MHz u.FL
L2: 47nH; L_0402_1005Metric; MPN 47nH
L3: 4.4nH; L_0402_1005Metric; MPN 4.4nH
L4: 3.4nH; L_0402_1005Metric; MPN 3.4nH
L5: 9.2nH; L_0402_1005Metric; MPN 9.2nH
L6: 12nH; L_0402_1005Metric; MPN 12nH
U3: PE4259; SOT-363_SC-70-6; MPN PE4259

Connections:
ANT: C26.2, J4.1 (In)
GND: C17.2, C18.2, C19.2, C20.2, C21.2, C23.2, C25.2, J4.2 (Ext), U3.2 (GND); also elsewhere on the board
RFI_N: C25.1, L6.2; also elsewhere on the board
RFI_P: C24.2, L6.1; also elsewhere on the board
RFO_LP: C19.1, L2.2, L3.1; also elsewhere on the board
RF_COMMON: C26.1, U3.5 (RFC)
RF_CTRL: U3.4 (CTRL); also elsewhere on the board
RF_CTRL_N: U3.6 (CTRL_N); also elsewhere on the board
RX_RF: C24.1, U3.3 (RF2)
TX_1: C20.1, L3.2, L4.1
TX_2: C21.1, C22.1, L4.2
TX_3: C22.2, L5.1
TX_RF: C23.1, L5.2, U3.1 (RF1)
VR_PA: C17.1, C18.1, L2.1; also elsewhere on the board

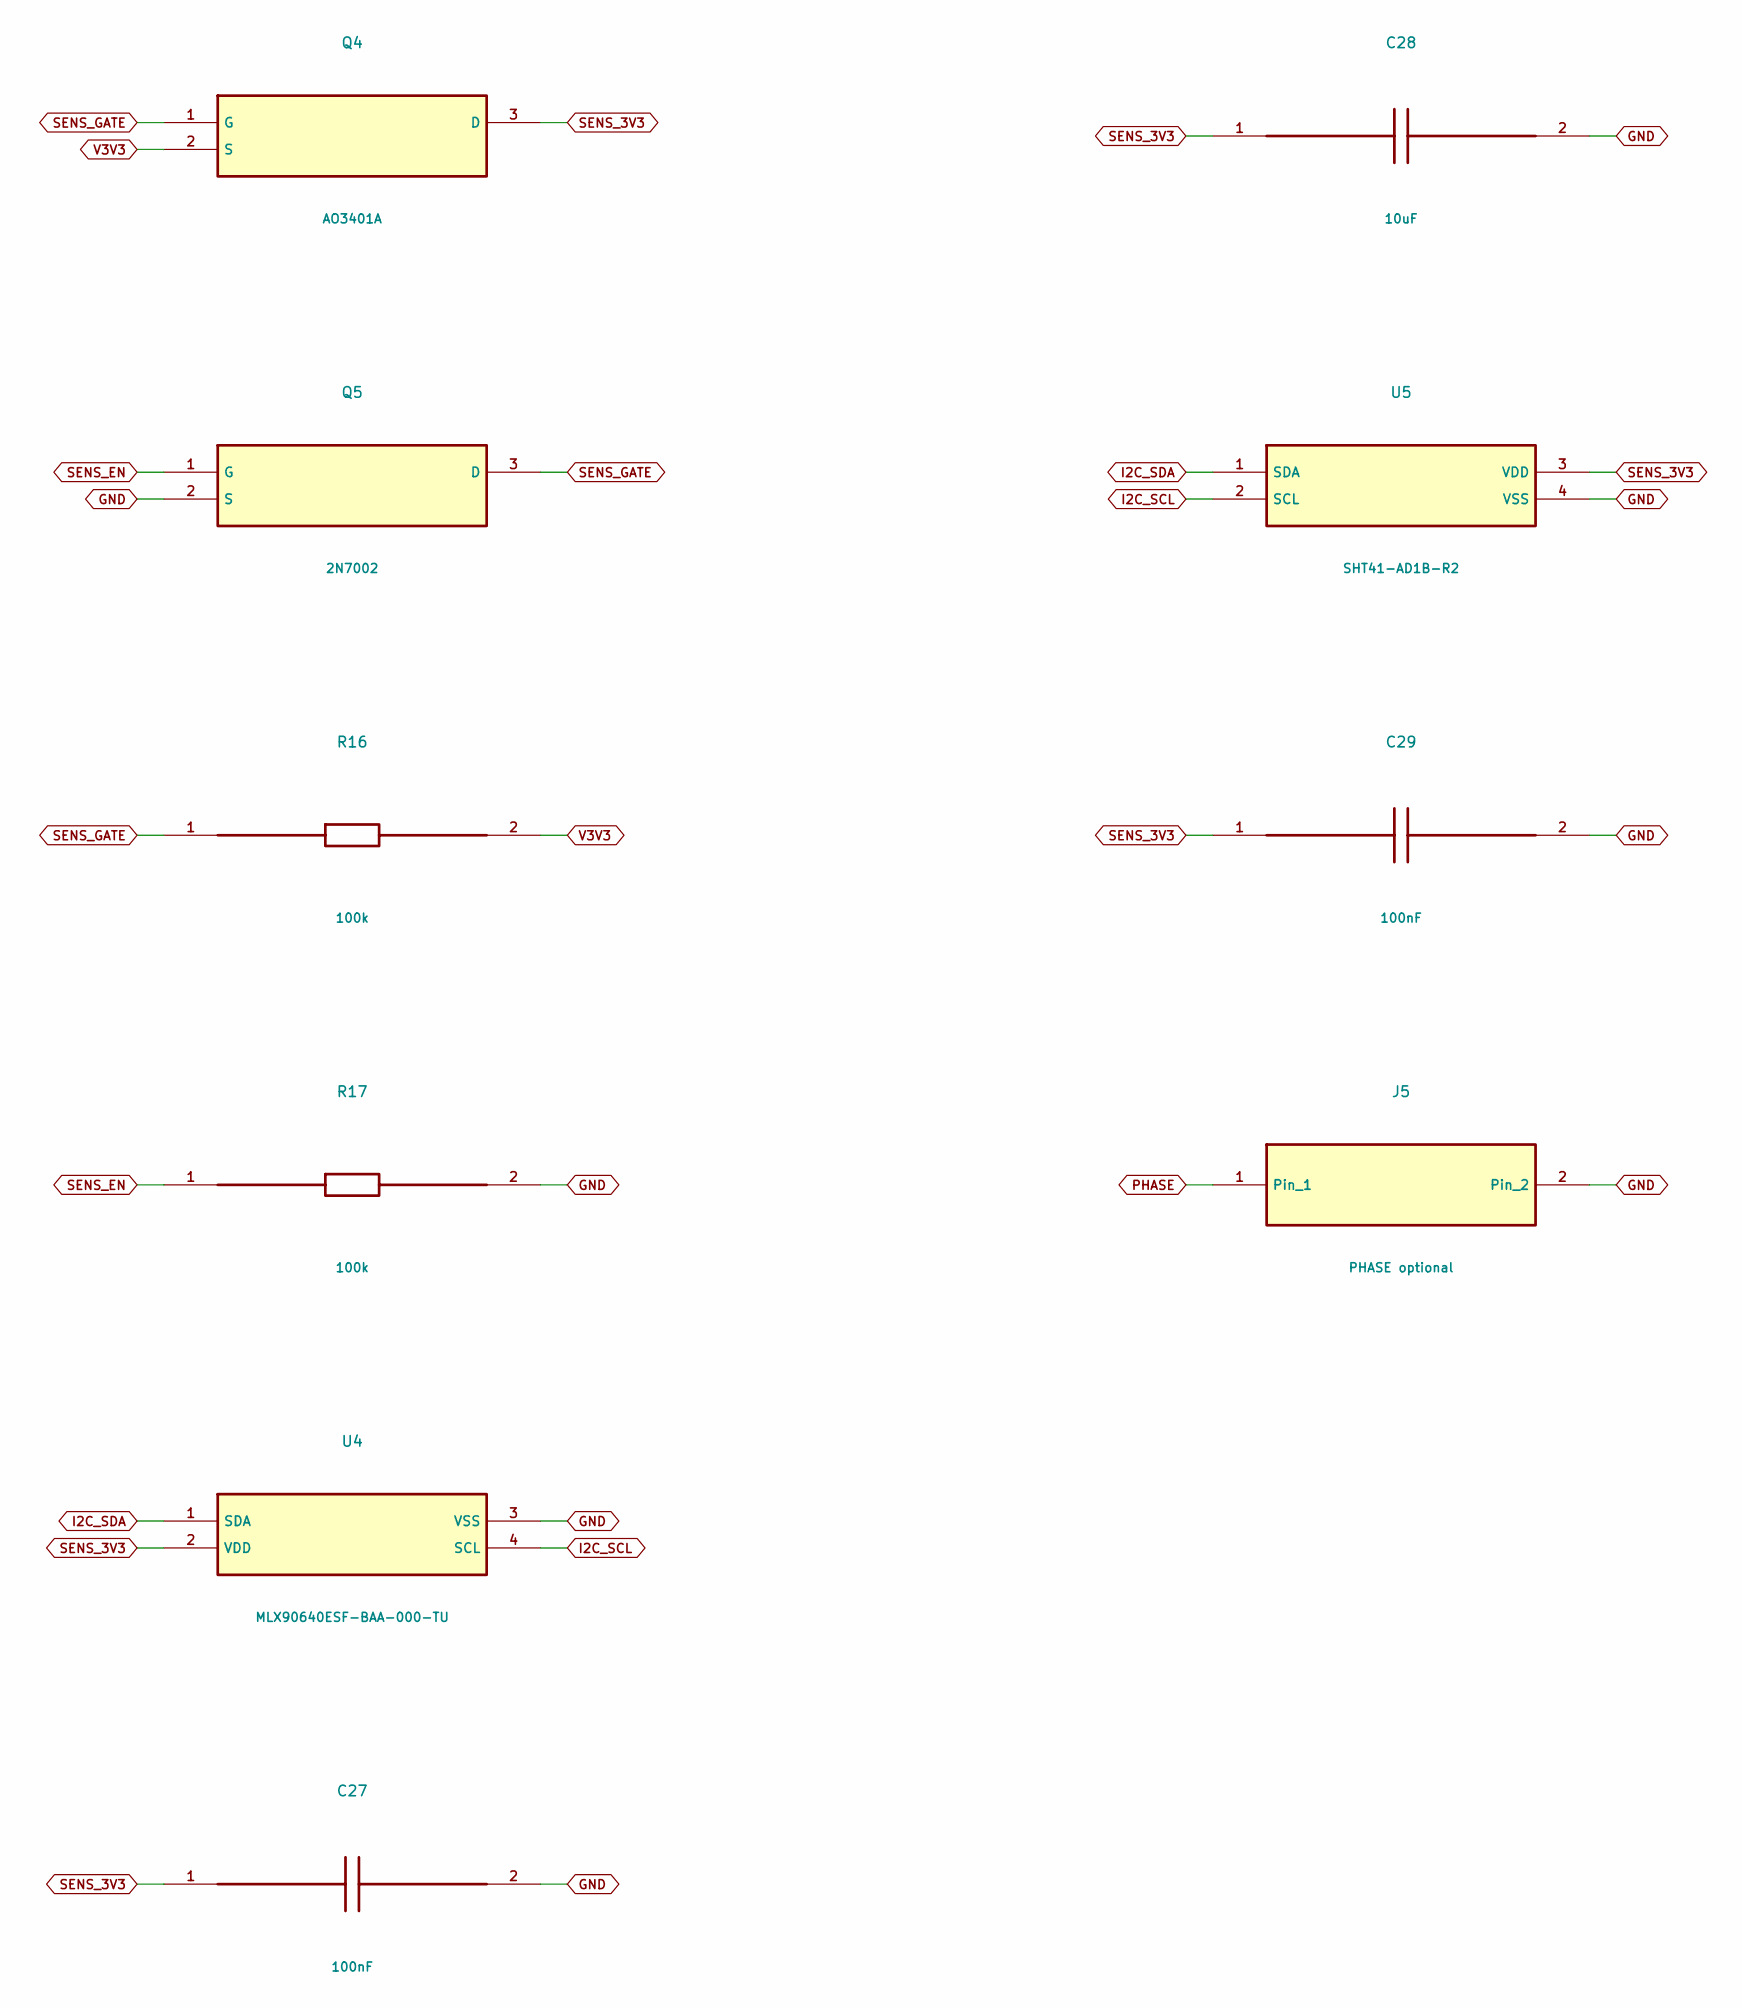
[picture p79: schematic 05.kicad_sch, PANOGOZ-IR-B1 / SENSORS]

Parts:
C27, C29: 100nF; C_0402_1005Metric; MPN X7R 16V 100nF
C28: 10uF; C_0805_2012Metric; MPN X7R 16V 10uF
J5: PHASE optional; JST_SH_SM02B-SRSS-TB_1x02-1MP_P1.00mm_Horizontal; MPN PHASE optional
Q4: AO3401A; SOT-23; MPN AO3401A
Q5: 2N7002; SOT-23; MPN 2N7002
R16, R17: 100k; R_0402_1005Metric; MPN 1% thick film 100k
U4: MLX90640ESF-BAA-000-TU; TO-39-4_Window; MPN MLX90640ESF-BAA-000-TU
U5: SHT41-AD1B-R2; Sensirion_DFN-4_1.5x1.5mm_P0.8mm_SHT4x_NoCentralPad; MPN SHT41-AD1B-R2

Connections:
GND: C27.2, C28.2, C29.2, J5.2, Q5.2 (S), R17.2, U4.3 (VSS), U5.4 (VSS); also elsewhere on the board
I2C_SCL: U4.4 (SCL), U5.2 (SCL); also elsewhere on the board
I2C_SDA: U4.1 (SDA), U5.1 (SDA); also elsewhere on the board
PHASE: J5.1; also elsewhere on the board
SENS_3V3: C27.1, C28.1, C29.1, Q4.3 (D), U4.2 (VDD), U5.3 (VDD); also elsewhere on the board
SENS_EN: Q5.1 (G), R17.1; also elsewhere on the board
SENS_GATE: Q4.1 (G), Q5.3 (D), R16.1
V3V3: Q4.2 (S), R16.2; also elsewhere on the board

Board: 4 copper layers, 70 parts (1 on the bottom side), 47 nets, no tracks yet.
