hackathon-buke-team/grid-up/hardware/B1/GW/PANOGOZ-GW-B1.kicad_pcb

## KiCad design hardware/B1/GW/PANOGOZ-GW-B1.kicad_pcb (2026-09-20)

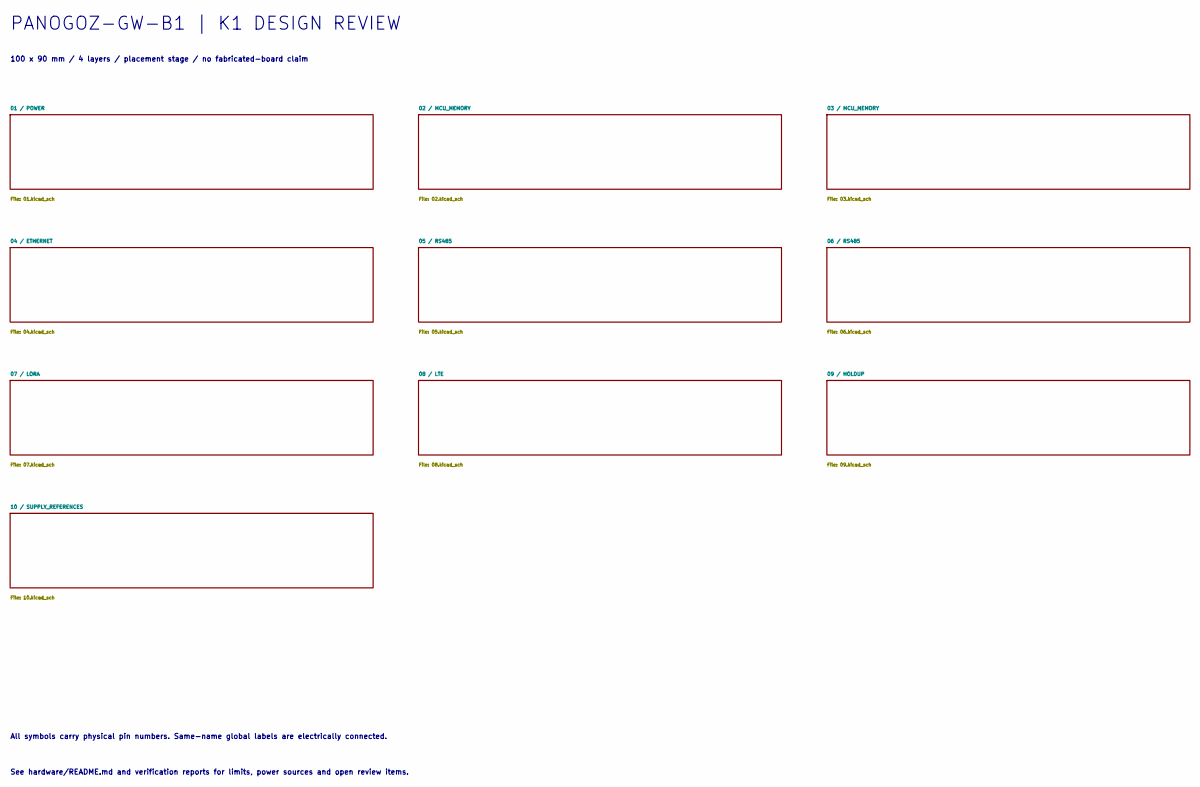
[picture p80: schematic PANOGOZ-GW-B1.kicad_sch]

Notes on the sheet:
PANOGOZ-GW-B1 | K1 DESIGN REVIEW
100 x 90 mm / 4 layers / placement stage / no fabricated-board claim
All symbols carry physical pin numbers. Same-name global labels are electrically connected.
See hardware/README.md and verification reports for limits, power sources and open review items.
