hackathon-buke-team/grid-up/hardware/B1/GW/PANOGOZ-GW-B1.kicad_pcb

## KiCad design hardware/B1/GW/PANOGOZ-GW-B1.kicad_pcb (continued)

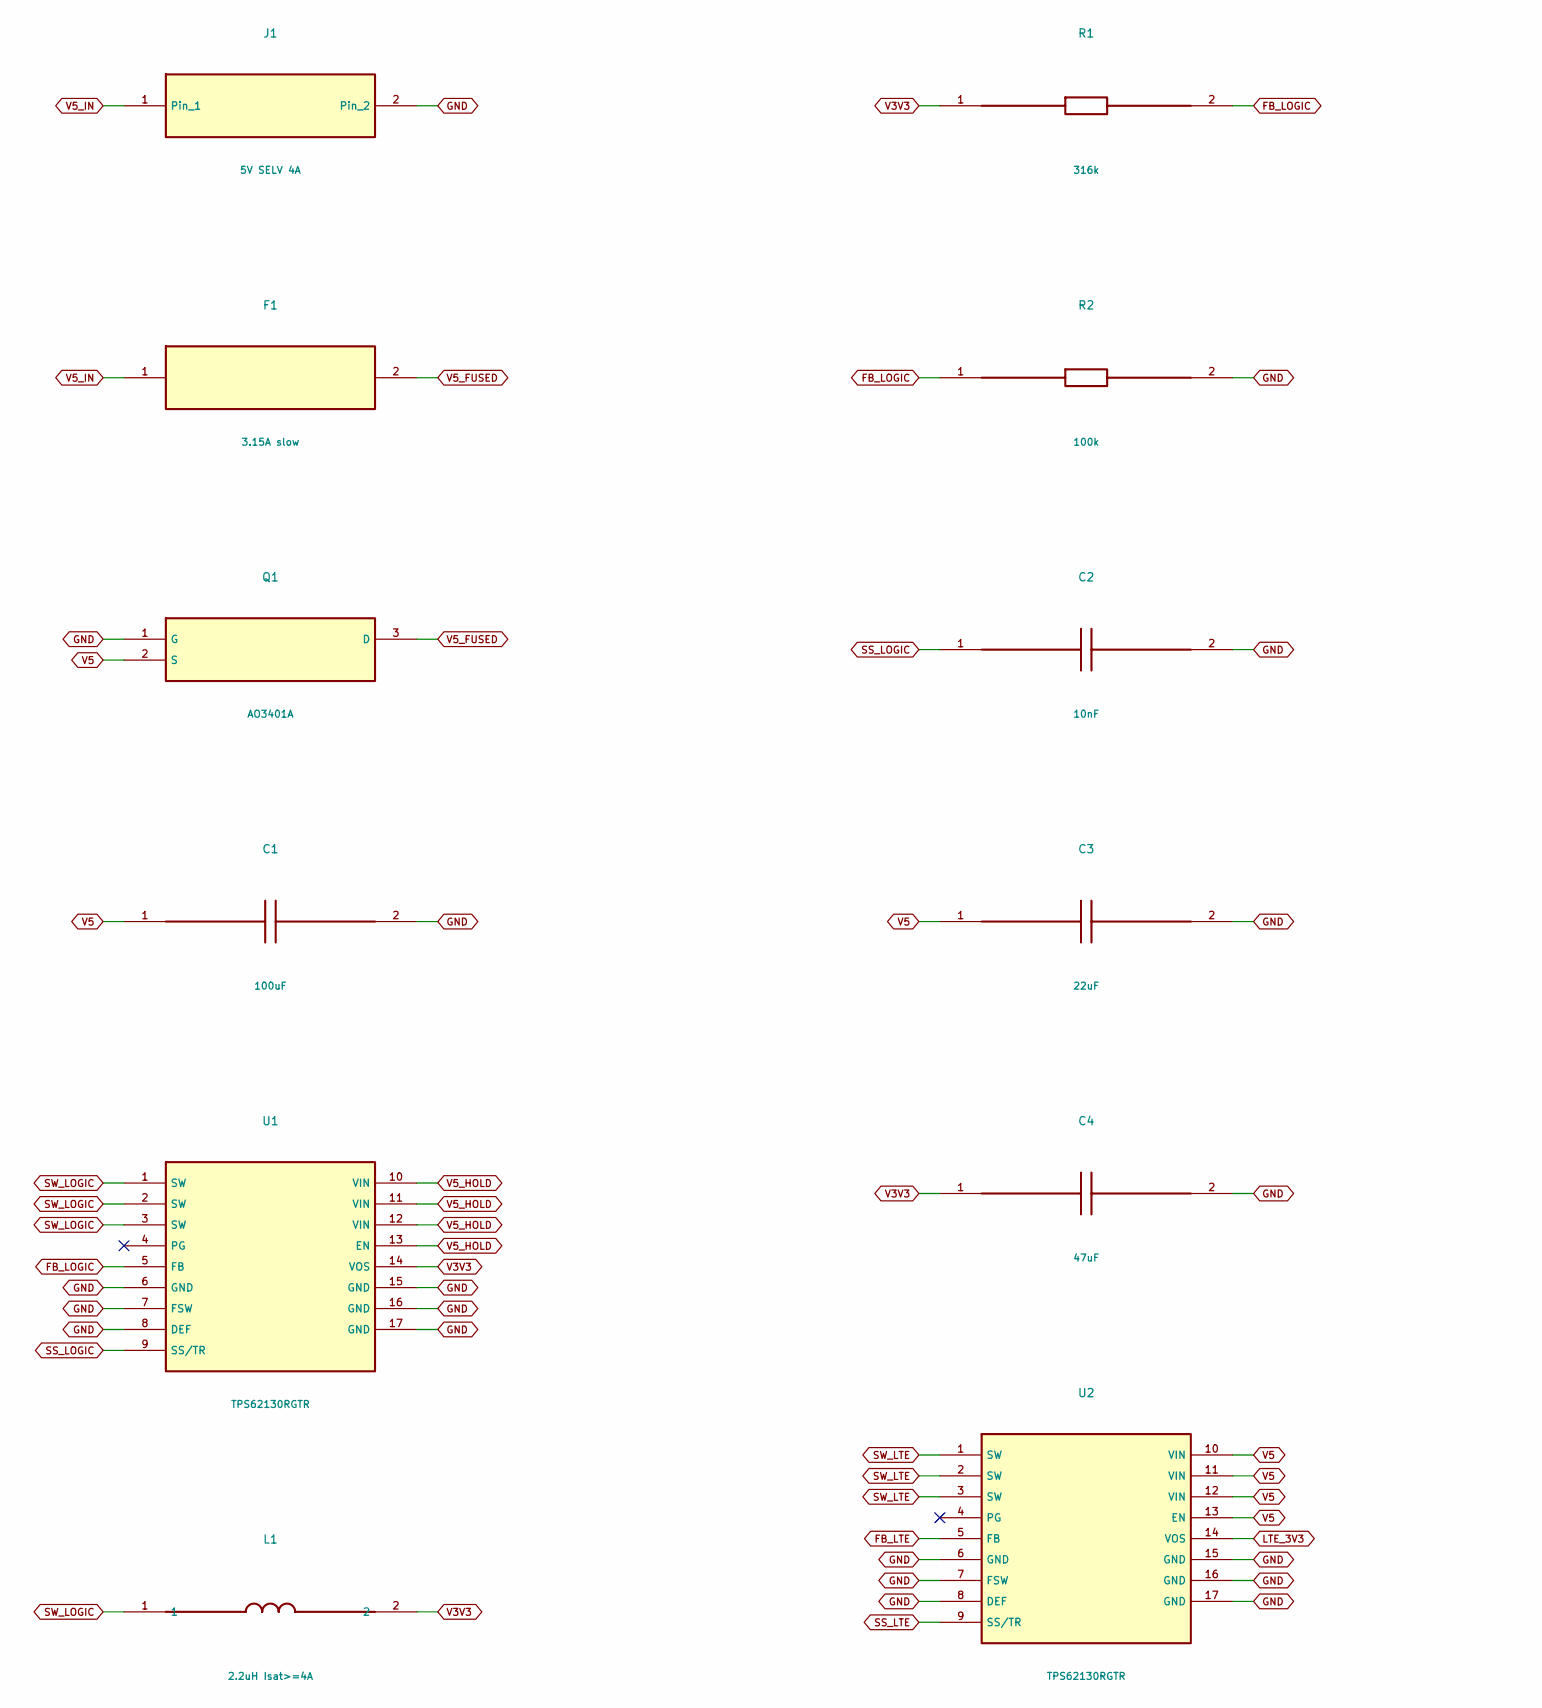
[picture p81: schematic 01.kicad_sch, PANOGOZ-GW-B1 / POWER, part in row 1, column 1]

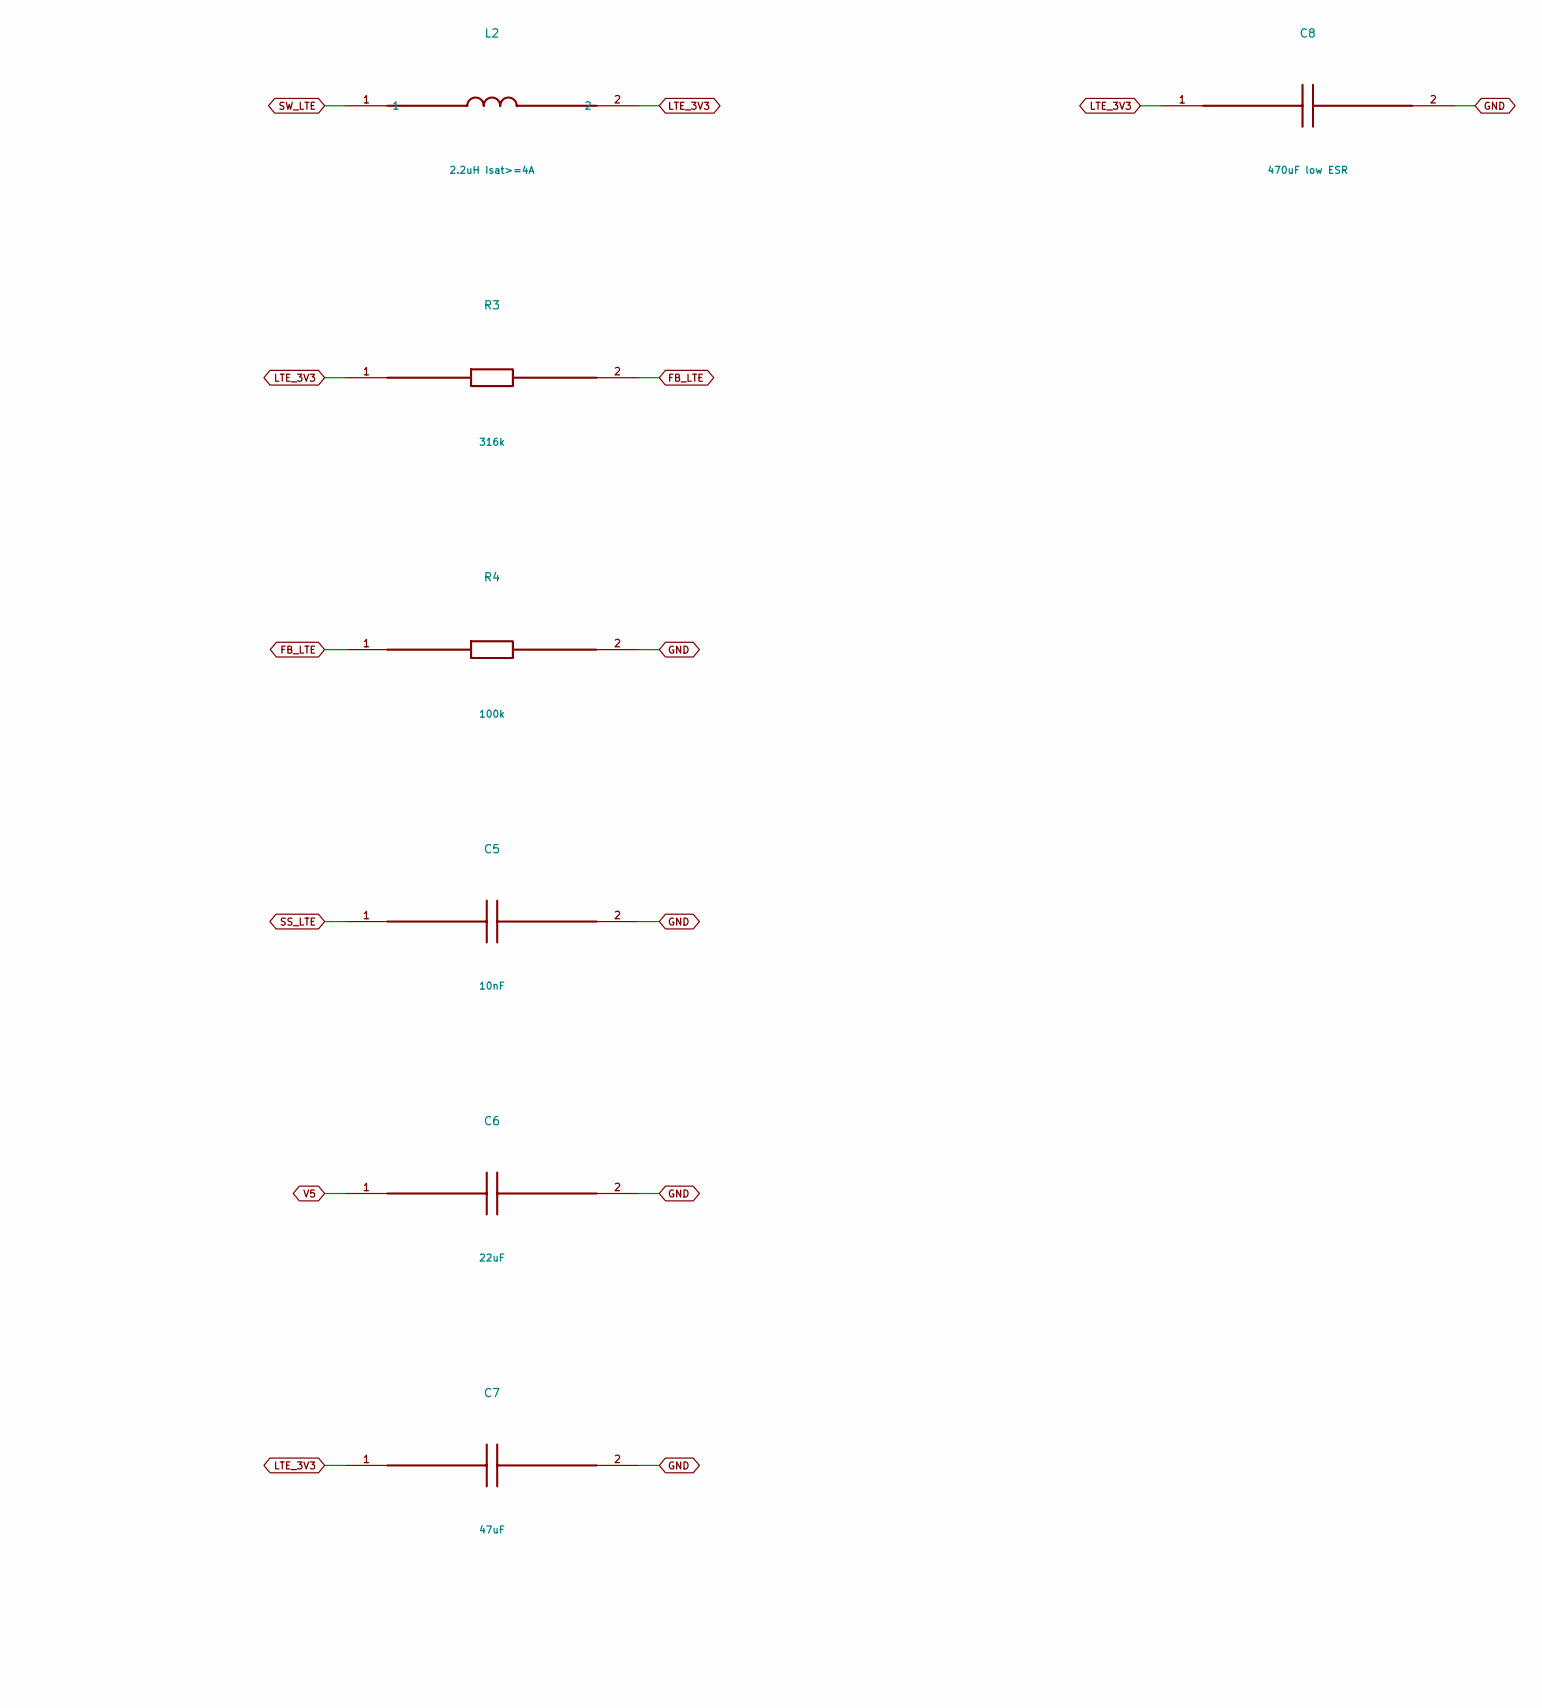
[picture p82: schematic 01.kicad_sch, PANOGOZ-GW-B1 / POWER, part in row 1, column 2]

Parts:
C1: 100uF; C_1210_3225Metric; MPN X7R 16V 100uF
C2, C5: 10nF; C_0402_1005Metric; MPN X7R 16V 10nF
C3, C6: 22uF; C_0805_2012Metric; MPN X7R 16V 22uF
C4, C7: 47uF; C_1210_3225Metric; MPN X7R 16V 47uF
C8: 470uF low ESR; CP_Elec_8x10; MPN X7R 16V 470uF low ESR
F1: 3.15A slow; Fuse_1206_3216Metric; MPN 3.15A slow
J1: 5V SELV 4A; TerminalBlock_Phoenix_MKDS-1,5-2-5.08_1x02_P5.08mm_Horizont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; MPN 5V SELV 4A
L1, L2: 2.2uH Isat>=4A; L_1210_3225Metric; MPN 2.2uH Isat>=4A
Q1: AO3401A; SOT-23; MPN AO3401A
R1, R3: 316k; R_0402_1005Metric; MPN 1% thick film 316k
R2, R4: 100k; R_0402_1005Metric; MPN 1% thick film 100k
U1, U2: TPS62130RGTR; VQFN-16-1EP_3x3mm_P0.5mm_EP1.68x1.68mm_ThermalVias; MPN TPS62130RGTR

Connections:
FB_LOGIC: R1.2, R2.1, U1.5 (FB)
FB_LTE: R3.2, R4.1, U2.5 (FB)
GND: C1.2, C2.2, C3.2, C4.2, C5.2, C6.2, C7.2, C8.2, J1.2, Q1.1 (G), R2.2, R4.2, U1.6 (GND), U1.7 (FSW), U1.8 (DEF), U1.15 (GND), U1.16 (GND), U1.17 (GND), U2.6 (GND), U2.7 (FSW), U2.8 (DEF), U2.15 (GND), U2.16 (GND), U2.17 (GND); also elsewhere on the board
LTE_3V3: C7.1, C8.1, L2.2, R3.1, U2.14 (VOS); also elsewhere on the board
SS_LOGIC: C2.1, U1.9 (SS/TR)
SS_LTE: C5.1, U2.9 (SS/TR)
SW_LOGIC: L1.1, U1.1 (SW), U1.2 (SW), U1.3 (SW)
SW_LTE: L2.1, U2.1 (SW), U2.2 (SW), U2.3 (SW)
V3V3: C4.1, L1.2, R1.1, U1.14 (VOS); also elsewhere on the board
V5: C1.1, C3.1, C6.1, Q1.2 (S), U2.10 (VIN), U2.11 (VIN), U2.12 (VIN), U2.13 (EN); also elsewhere on the board
V5_FUSED: F1.2, Q1.3 (D)
V5_HOLD: U1.10 (VIN), U1.11 (VIN), U1.12 (VIN), U1.13 (EN); also elsewhere on the board
V5_IN: F1.1, J1.1

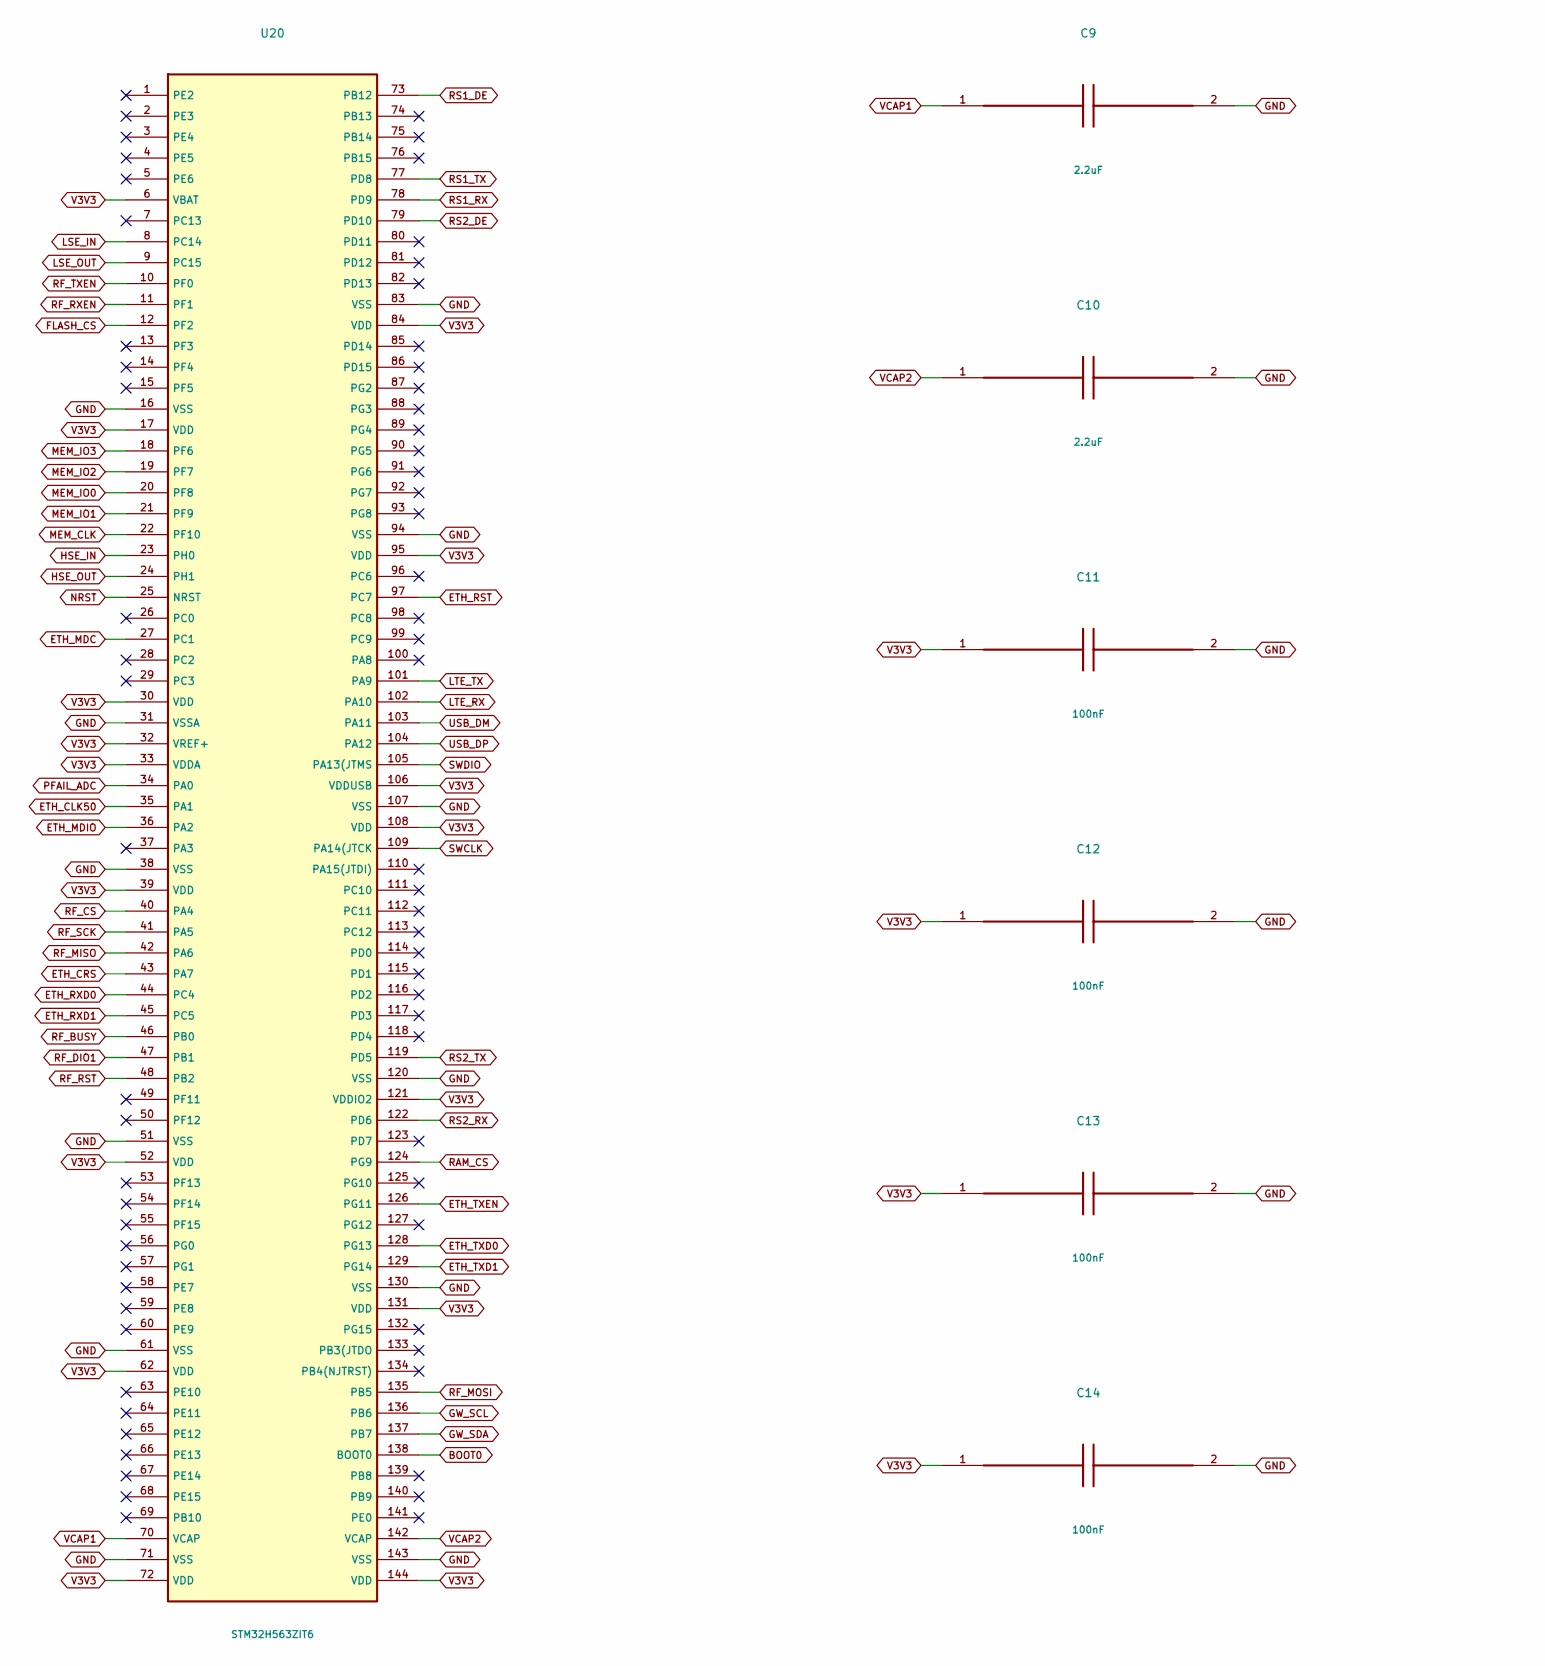
[picture p83: schematic 02.kicad_sch, PANOGOZ-GW-B1 / MCU_MEMORY, part in row 1, column 1]

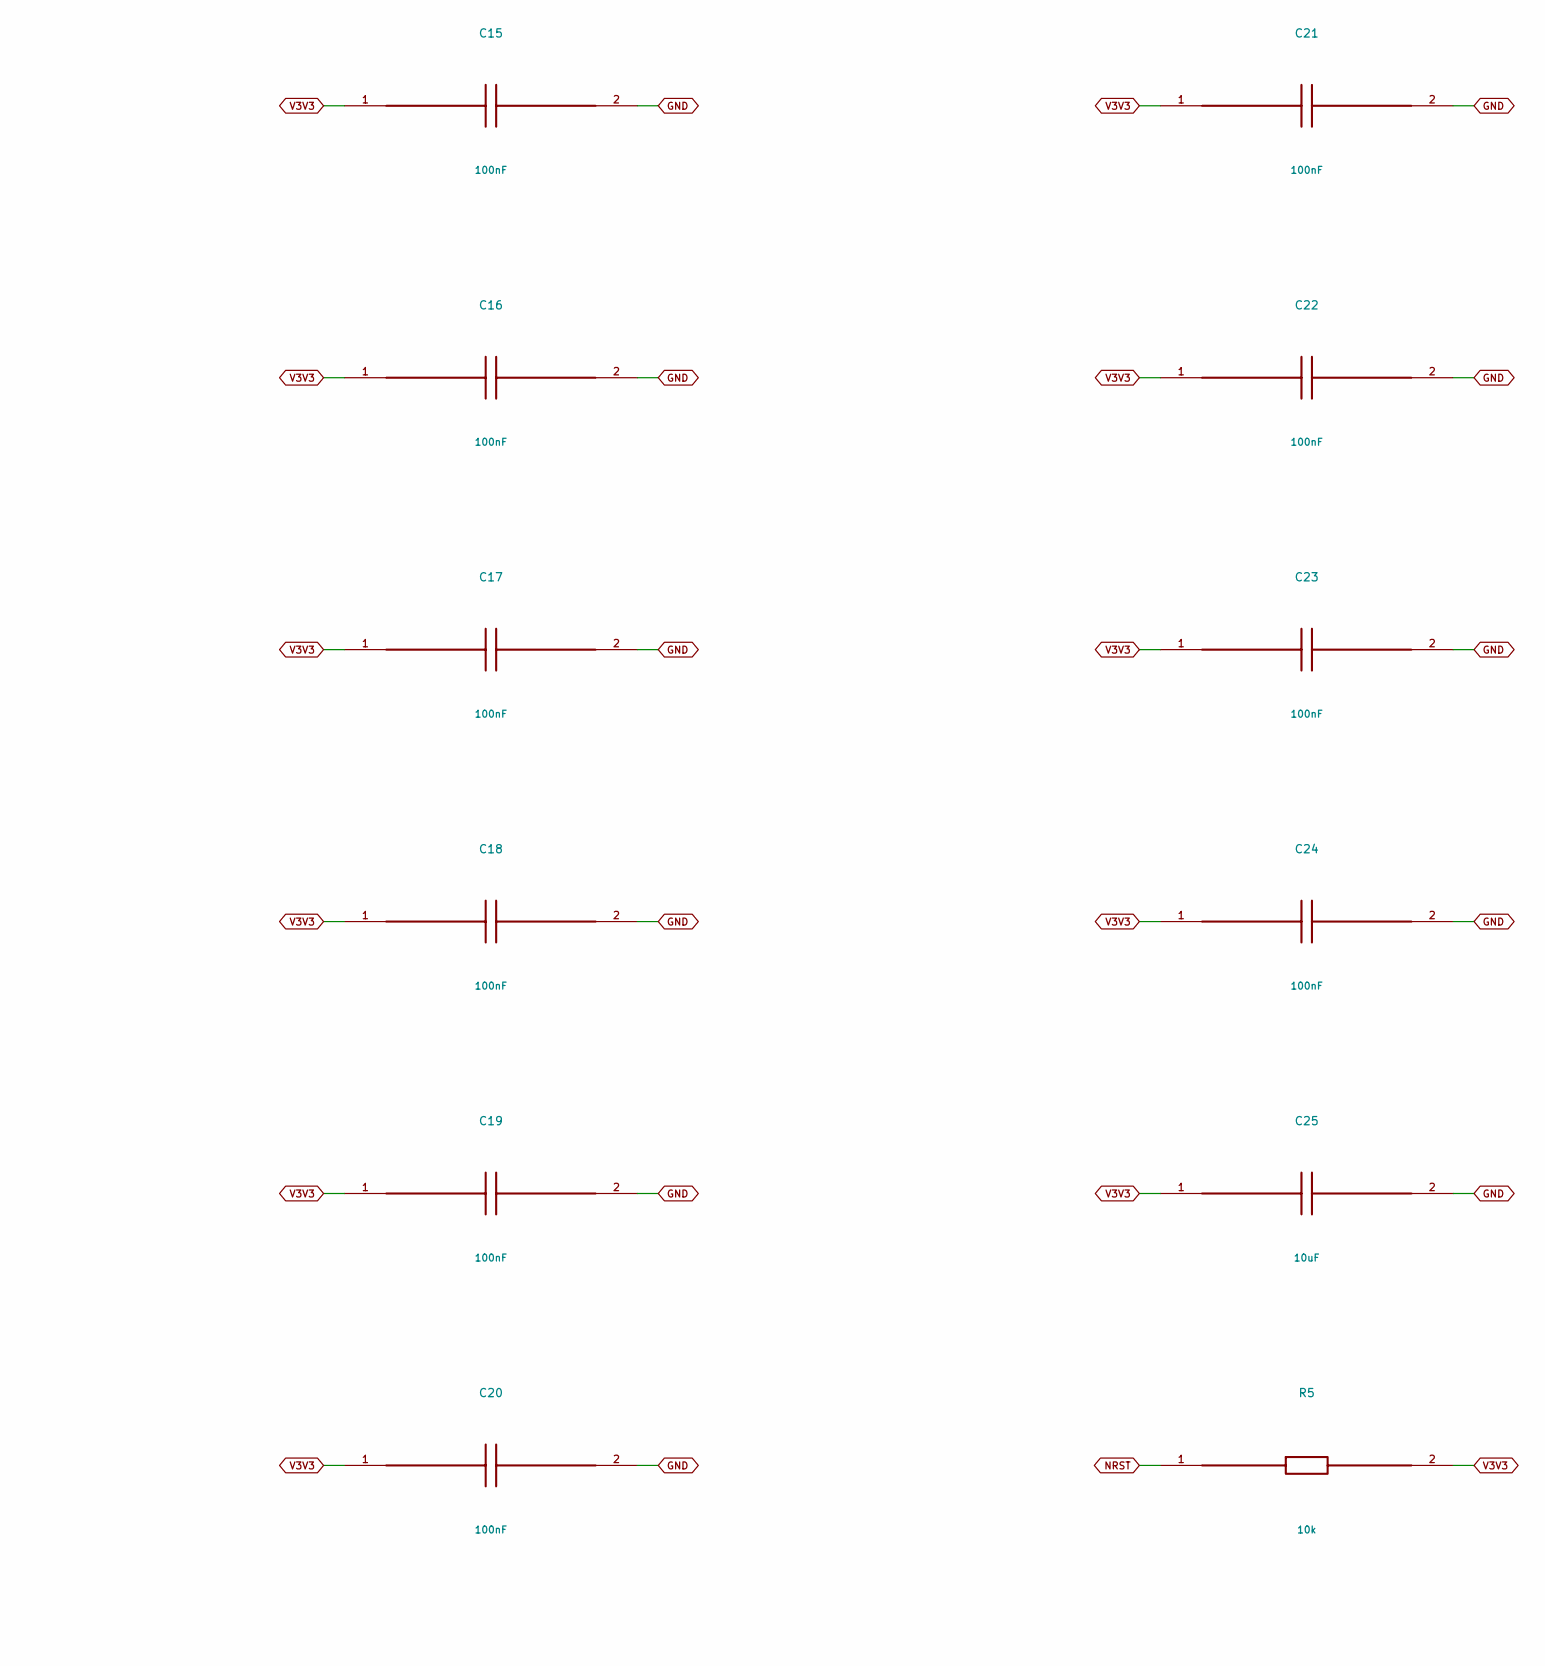
[picture p84: schematic 02.kicad_sch, PANOGOZ-GW-B1 / MCU_MEMORY, part in row 1, column 2]

Parts:
C9, C10: 2.2uF; C_0402_1005Metric; MPN X7R 16V 2.2uF
C11, C12, C13, C14, C15, C16, C17, C18, C19, C20, C21, C22, C23, C24: 100nF; C_0402_1005Metric; MPN X7R 16V 100nF
C25: 10uF; C_0805_2012Metric; MPN X7R 16V 10uF
R5: 10k; R_0402_1005Metric; MPN 1% thick film 10k
U20: STM32H563ZIT6; LQFP-144_20x20mm_P0.5mm; MPN STM32H563ZIT6

Connections:
BOOT0: U20.138 (BOOT0); also elsewhere on the board
ETH_CLK50: U20.35 (PA1); also elsewhere on the board
ETH_CRS: U20.43 (PA7); also elsewhere on the board
ETH_MDC: U20.27 (PC1); also elsewhere on the board
ETH_MDIO: U20.36 (PA2); also elsewhere on the board
ETH_RST: U20.97 (PC7); also elsewhere on the board
ETH_RXD0: U20.44 (PC4); also elsewhere on the board
ETH_RXD1: U20.45 (PC5); also elsewhere on the board
ETH_TXD0: U20.128 (PG13); also elsewhere on the board
ETH_TXD1: U20.129 (PG14); also elsewhere on the board
ETH_TXEN: U20.126 (PG11); also elsewhere on the board
FLASH_CS: U20.12 (PF2); also elsewhere on the board
GND: C9.2, C10.2, C11.2, C12.2, C13.2, C14.2, C15.2, C16.2, C17.2, C18.2, C19.2, C20.2, C21.2, C22.2, C23.2, C24.2, C25.2, U20.16 (VSS), U20.31 (VSSA), U20.38 (VSS), U20.51 (VSS), U20.61 (VSS), U20.71 (VSS), U20.83 (VSS), U20.94 (VSS), U20.107 (VSS), U20.120 (VSS), U20.130 (VSS), U20.143 (VSS); also elsewhere on the board
GW_SCL: U20.136 (PB6); also elsewhere on the board
GW_SDA: U20.137 (PB7); also elsewhere on the board
HSE_IN: U20.23 (PH0); also elsewhere on the board
HSE_OUT: U20.24 (PH1); also elsewhere on the board
LSE_IN: U20.8 (PC14); also elsewhere on the board
LSE_OUT: U20.9 (PC15); also elsewhere on the board
LTE_RX: U20.102 (PA10); also elsewhere on the board
LTE_TX: U20.101 (PA9); also elsewhere on the board
MEM_CLK: U20.22 (PF10); also elsewhere on the board
MEM_IO0: U20.20 (PF8); also elsewhere on the board
MEM_IO1: U20.21 (PF9); also elsewhere on the board
MEM_IO2: U20.19 (PF7); also elsewhere on the board
MEM_IO3: U20.18 (PF6); also elsewhere on the board
NRST: R5.1, U20.25 (NRST); also elsewhere on the board
PFAIL_ADC: U20.34 (PA0); also elsewhere on the board
RAM_CS: U20.124 (PG9); also elsewhere on the board
RF_BUSY: U20.46 (PB0); also elsewhere on the board
RF_CS: U20.40 (PA4); also elsewhere on the board
RF_DIO1: U20.47 (PB1); also elsewhere on the board
RF_MISO: U20.42 (PA6); also elsewhere on the board
RF_MOSI: U20.135 (PB5); also elsewhere on the board
RF_RST: U20.48 (PB2); also elsewhere on the board
RF_RXEN: U20.11 (PF1); also elsewhere on the board
RF_SCK: U20.41 (PA5); also elsewhere on the board
RF_TXEN: U20.10 (PF0); also elsewhere on the board
RS1_DE: U20.73 (PB12); also elsewhere on the board
RS1_RX: U20.78 (PD9); also elsewhere on the board
RS1_TX: U20.77 (PD8); also elsewhere on the board
RS2_DE: U20.79 (PD10); also elsewhere on the board
RS2_RX: U20.122 (PD6); also elsewhere on the board
RS2_TX: U20.119 (PD5); also elsewhere on the board
SWCLK: U20.109 (PA14(JTCK); also elsewhere on the board
SWDIO: U20.105 (PA13(JTMS); also elsewhere on the board
USB_DM: U20.103 (PA11); also elsewhere on the board
USB_DP: U20.104 (PA12); also elsewhere on the board
V3V3: C11.1, C12.1, C13.1, C14.1, C15.1, C16.1, C17.1, C18.1, C19.1, C20.1, C21.1, C22.1, C23.1, C24.1, C25.1, R5.2, U20.6 (VBAT), U20.17 (VDD), U20.30 (VDD), U20.32 (VREF+), U20.33 (VDDA), U20.39 (VDD), U20.52 (VDD), U20.62 (VDD), U20.72 (VDD), U20.84 (VDD), U20.95 (VDD), U20.106 (VDDUSB), U20.108 (VDD), U20.121 (VDDIO2), U20.131 (VDD), U20.144 (VDD); also elsewhere on the board
VCAP1: C9.1, U20.70 (VCAP)
VCAP2: C10.1, U20.142 (VCAP)

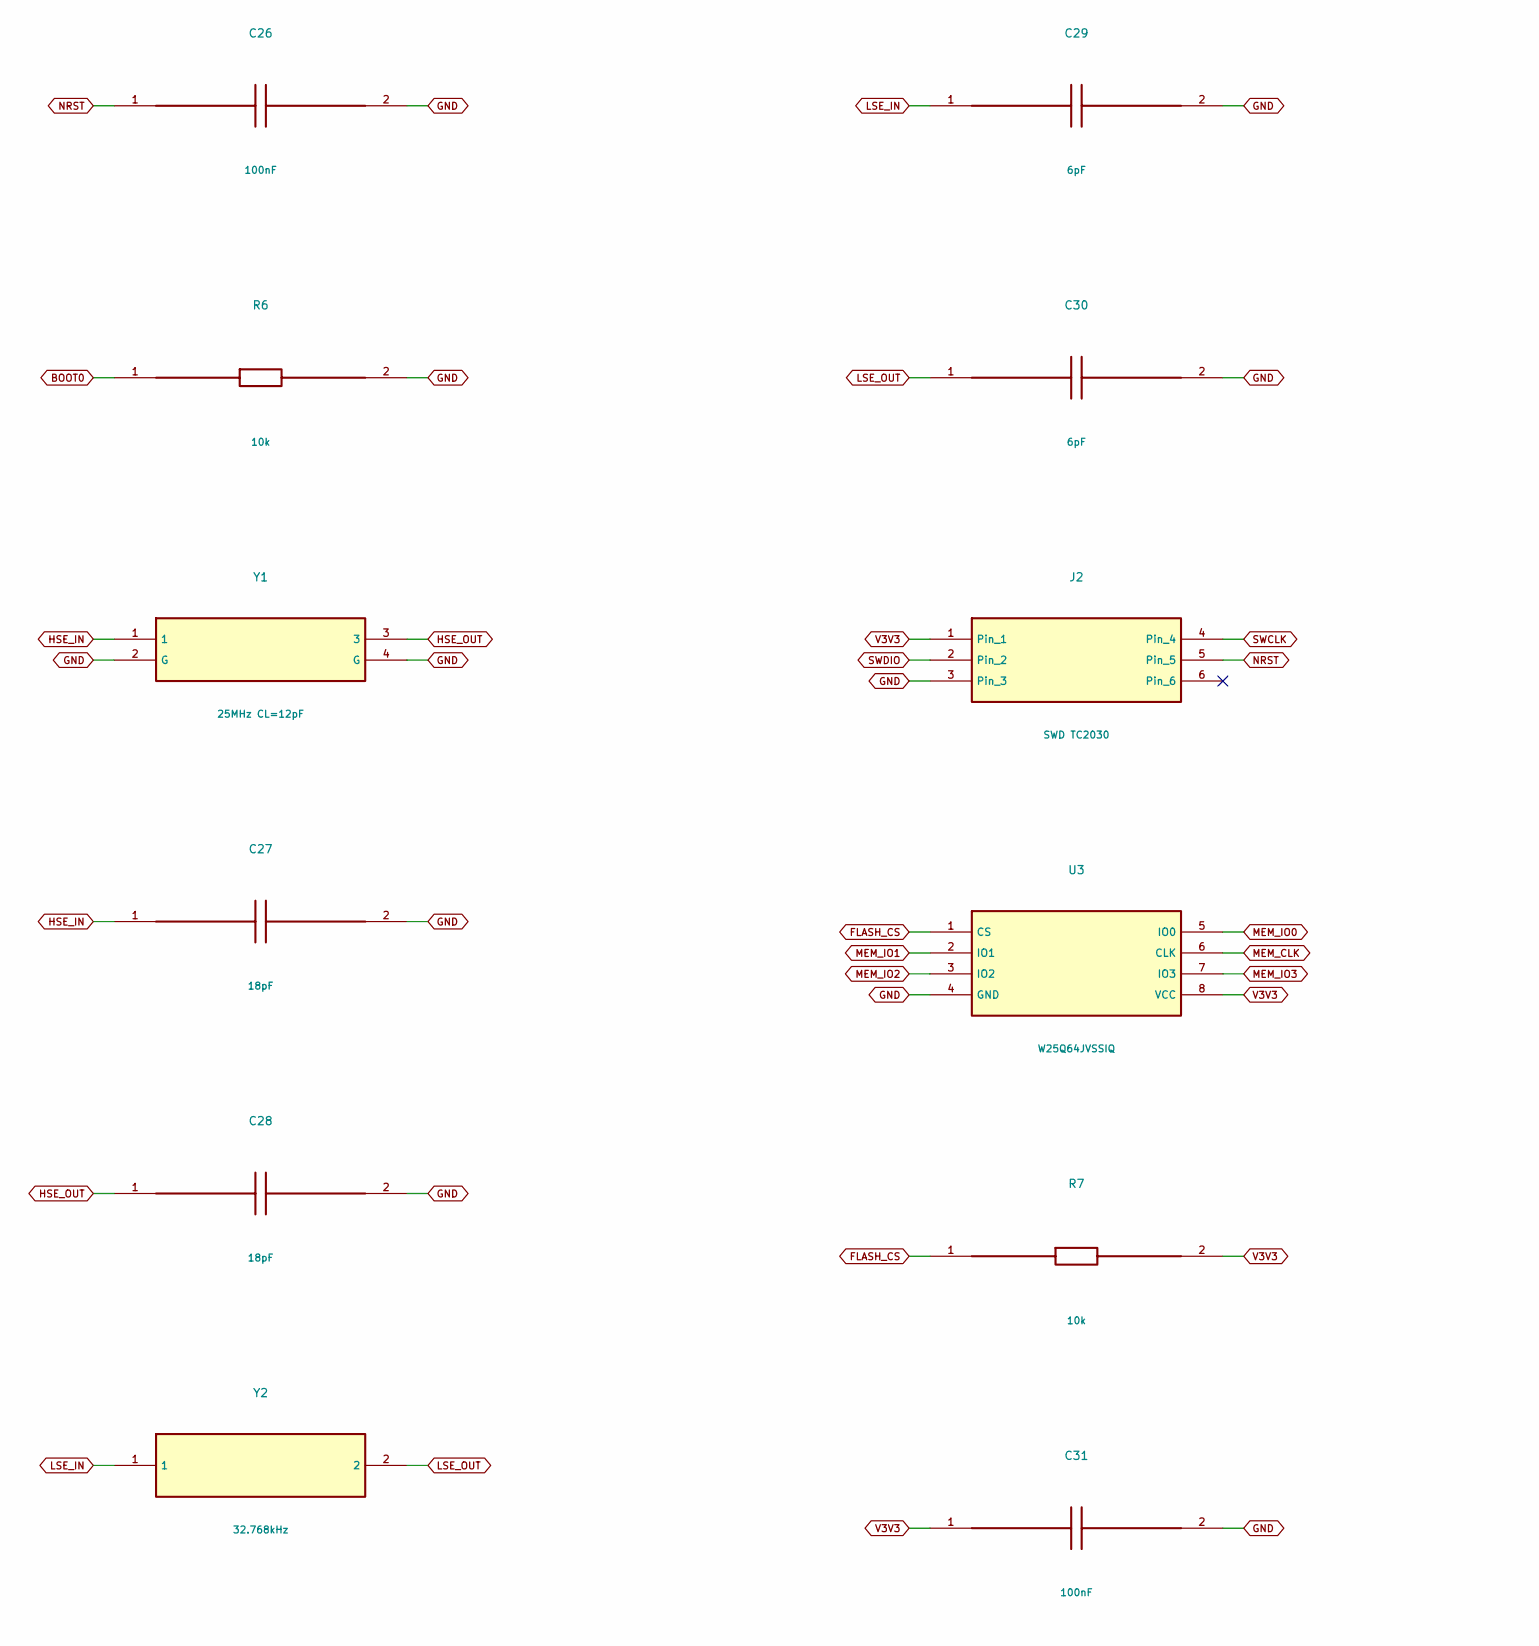
[picture p85: schematic 03.kicad_sch, PANOGOZ-GW-B1 / MCU_MEMORY, part in row 1, column 1]

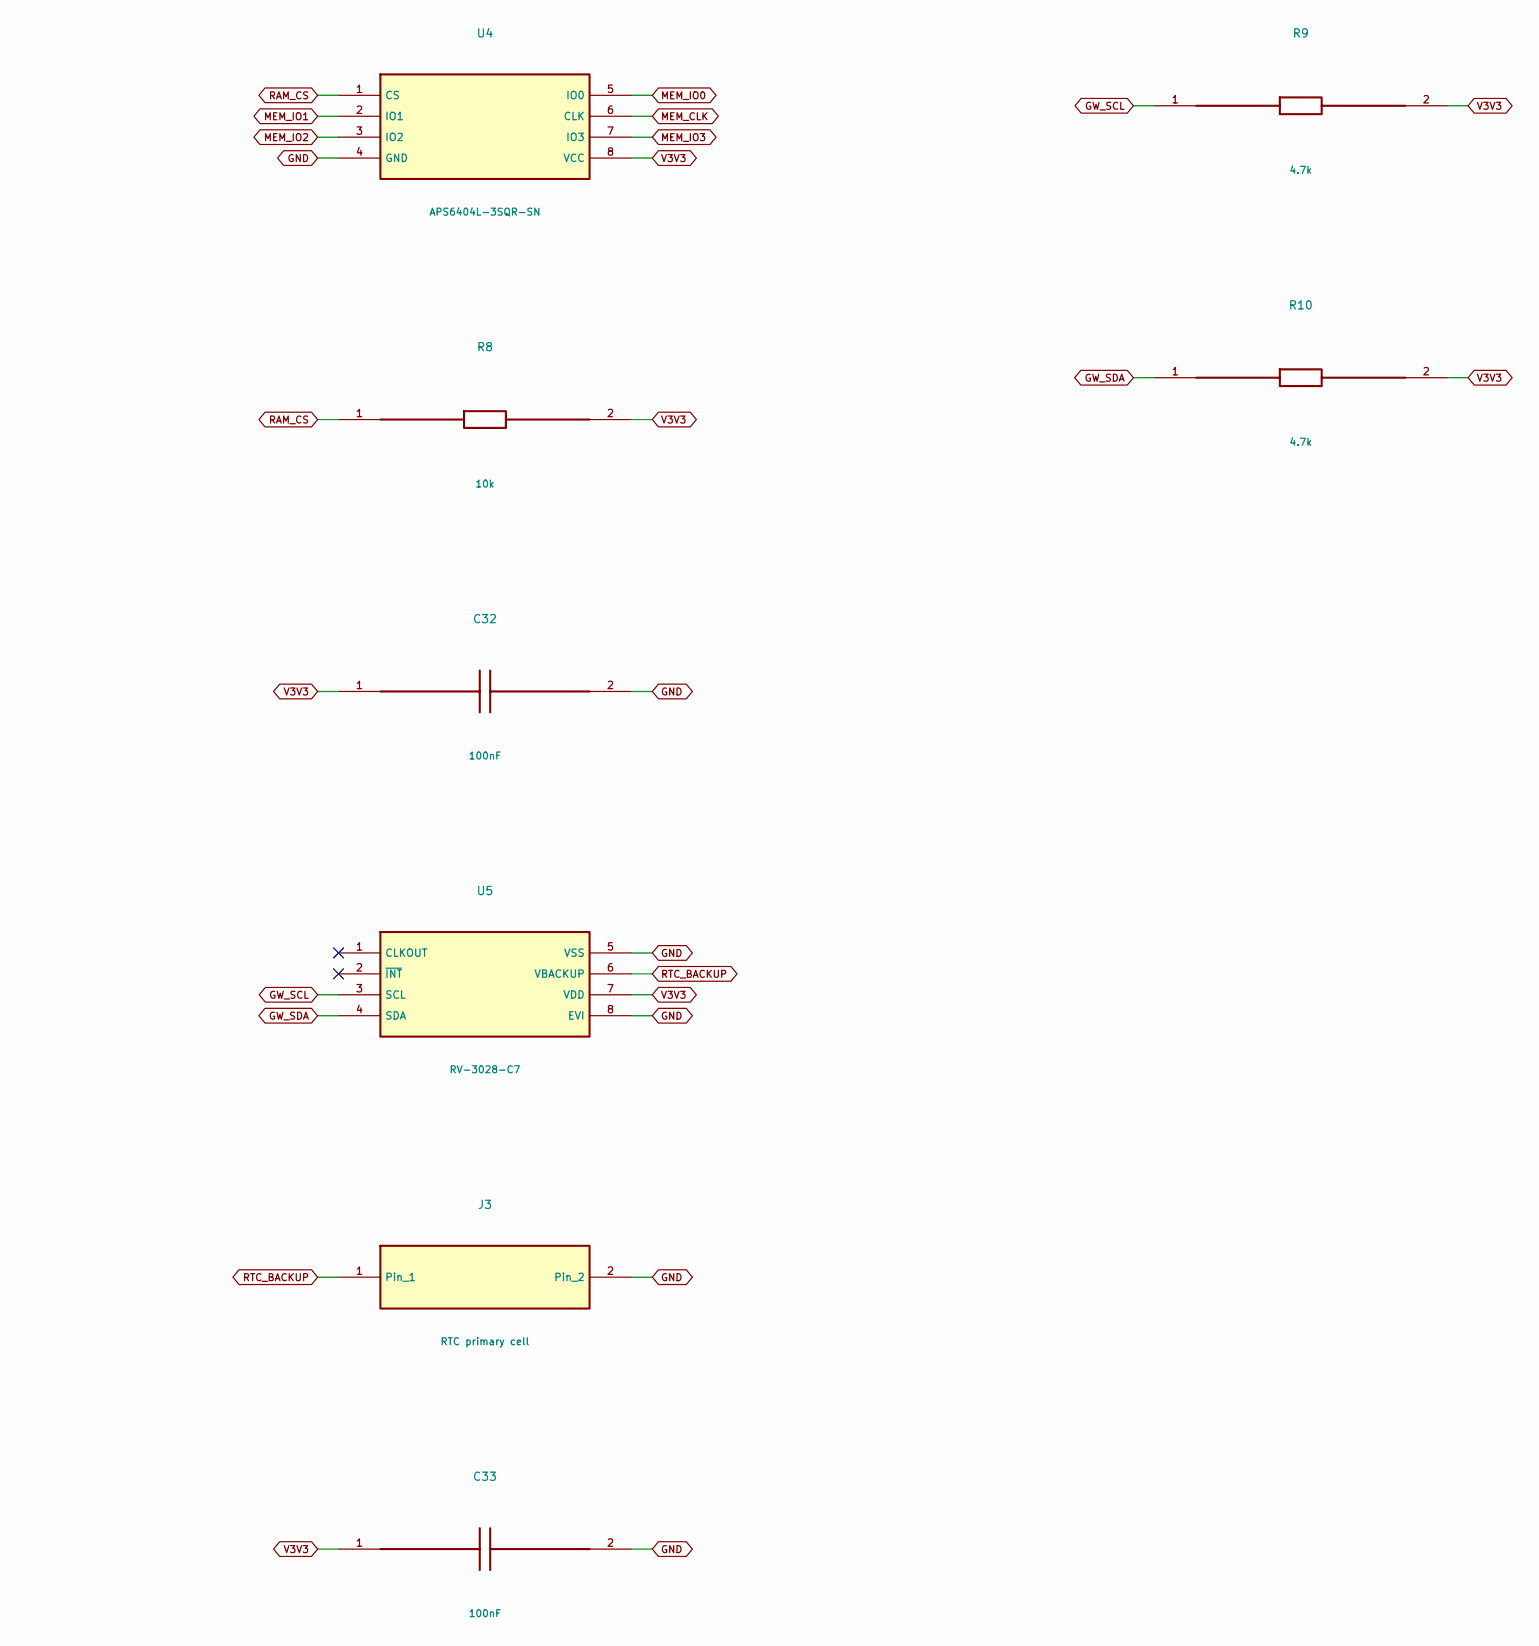
[picture p86: schematic 03.kicad_sch, PANOGOZ-GW-B1 / MCU_MEMORY, part in row 1, column 2]

Parts:
C26, C31, C32, C33: 100nF; C_0402_1005Metric; MPN X7R 16V 100nF
C27, C28: 18pF; C_0402_1005Metric; MPN X7R 16V 18pF
C29, C30: 6pF; C_0402_1005Metric; MPN X7R 16V 6pF
J2: SWD TC2030; Tag-Connect_TC2030-IDC-NL_2x03_P1.27mm_Vertical; MPN SWD TC2030
J3: RTC primary cell; JST_SH_SM02B-SRSS-TB_1x02-1MP_P1.00mm_Horizontal; MPN RTC primary cell
R6, R7, R8: 10k; R_0402_1005Metric; MPN 1% thick film 10k
R9, R10: 4.7k; R_0402_1005Metric; MPN 1% thick film 4.7k
U3: W25Q64JVSSIQ; SOIC-8_3.9x4.9mm_P1.27mm; MPN W25Q64JVSSIQ
U4: APS6404L-3SQR-SN; SOIC-8_3.9x4.9mm_P1.27mm; MPN APS6404L-3SQR-SN
U5: RV-3028-C7; MicroCrystal_C7_SON-8_1.5x3.2mm_P0.9mm; MPN RV-3028-C7
Y1: 25MHz CL=12pF; Crystal_SMD_3225-4Pin_3.2x2.5mm; MPN 25MHz CL=12pF
Y2: 32.768kHz; Crystal_SMD_3215-2Pin_3.2x1.5mm; MPN 32.768kHz

Connections:
BOOT0: R6.1; also elsewhere on the board
FLASH_CS: R7.1, U3.1 (CS); also elsewhere on the board
GND: C26.2, C27.2, C28.2, C29.2, C30.2, C31.2, C32.2, C33.2, J2.3, J3.2, R6.2, U3.4 (GND), U4.4 (GND), U5.5 (VSS), U5.8 (EVI), Y1.2 (G), Y1.4 (G); also elsewhere on the board
GW_SCL: R9.1, U5.3 (SCL); also elsewhere on the board
GW_SDA: R10.1, U5.4 (SDA); also elsewhere on the board
HSE_IN: C27.1, Y1.1; also elsewhere on the board
HSE_OUT: C28.1, Y1.3; also elsewhere on the board
LSE_IN: C29.1, Y2.1; also elsewhere on the board
LSE_OUT: C30.1, Y2.2; also elsewhere on the board
MEM_CLK: U3.6 (CLK), U4.6 (CLK); also elsewhere on the board
MEM_IO0: U3.5 (IO0), U4.5 (IO0); also elsewhere on the board
MEM_IO1: U3.2 (IO1), U4.2 (IO1); also elsewhere on the board
MEM_IO2: U3.3 (IO2), U4.3 (IO2); also elsewhere on the board
MEM_IO3: U3.7 (IO3), U4.7 (IO3); also elsewhere on the board
NRST: C26.1, J2.5; also elsewhere on the board
RAM_CS: R8.1, U4.1 (CS); also elsewhere on the board
RTC_BACKUP: J3.1, U5.6 (VBACKUP)
SWCLK: J2.4; also elsewhere on the board
SWDIO: J2.2; also elsewhere on the board
V3V3: C31.1, C32.1, C33.1, J2.1, R7.2, R8.2, R9.2, R10.2, U3.8 (VCC), U4.8 (VCC), U5.7 (VDD); also elsewhere on the board
