hackathon-buke-team/grid-up/hardware/B1/GW/PANOGOZ-GW-B1.kicad_pcb

## KiCad design hardware/B1/GW/PANOGOZ-GW-B1.kicad_pcb (continued)

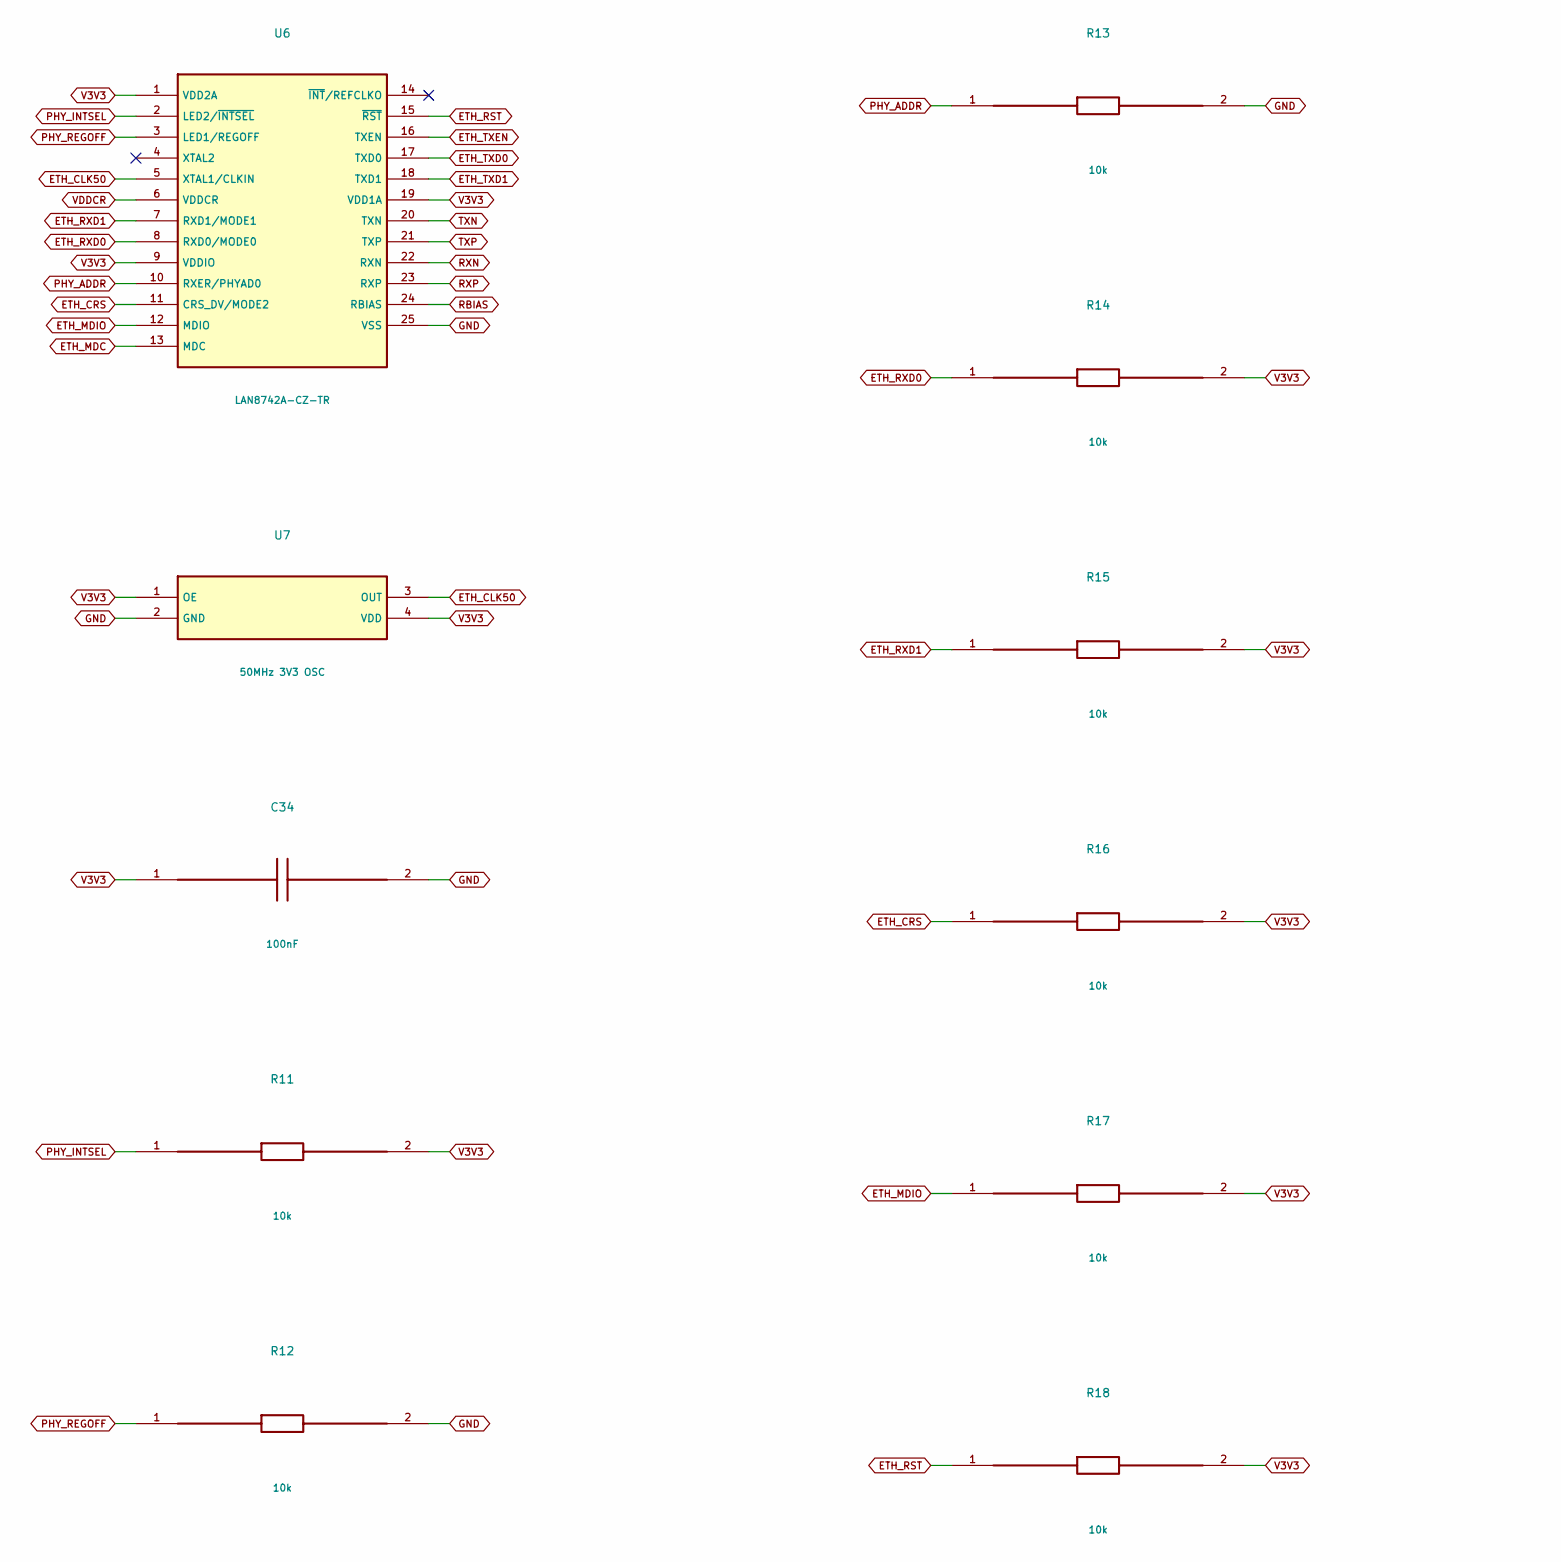
[picture p87: schematic 04.kicad_sch, PANOGOZ-GW-B1 / ETHERNET, part in row 1, column 1]

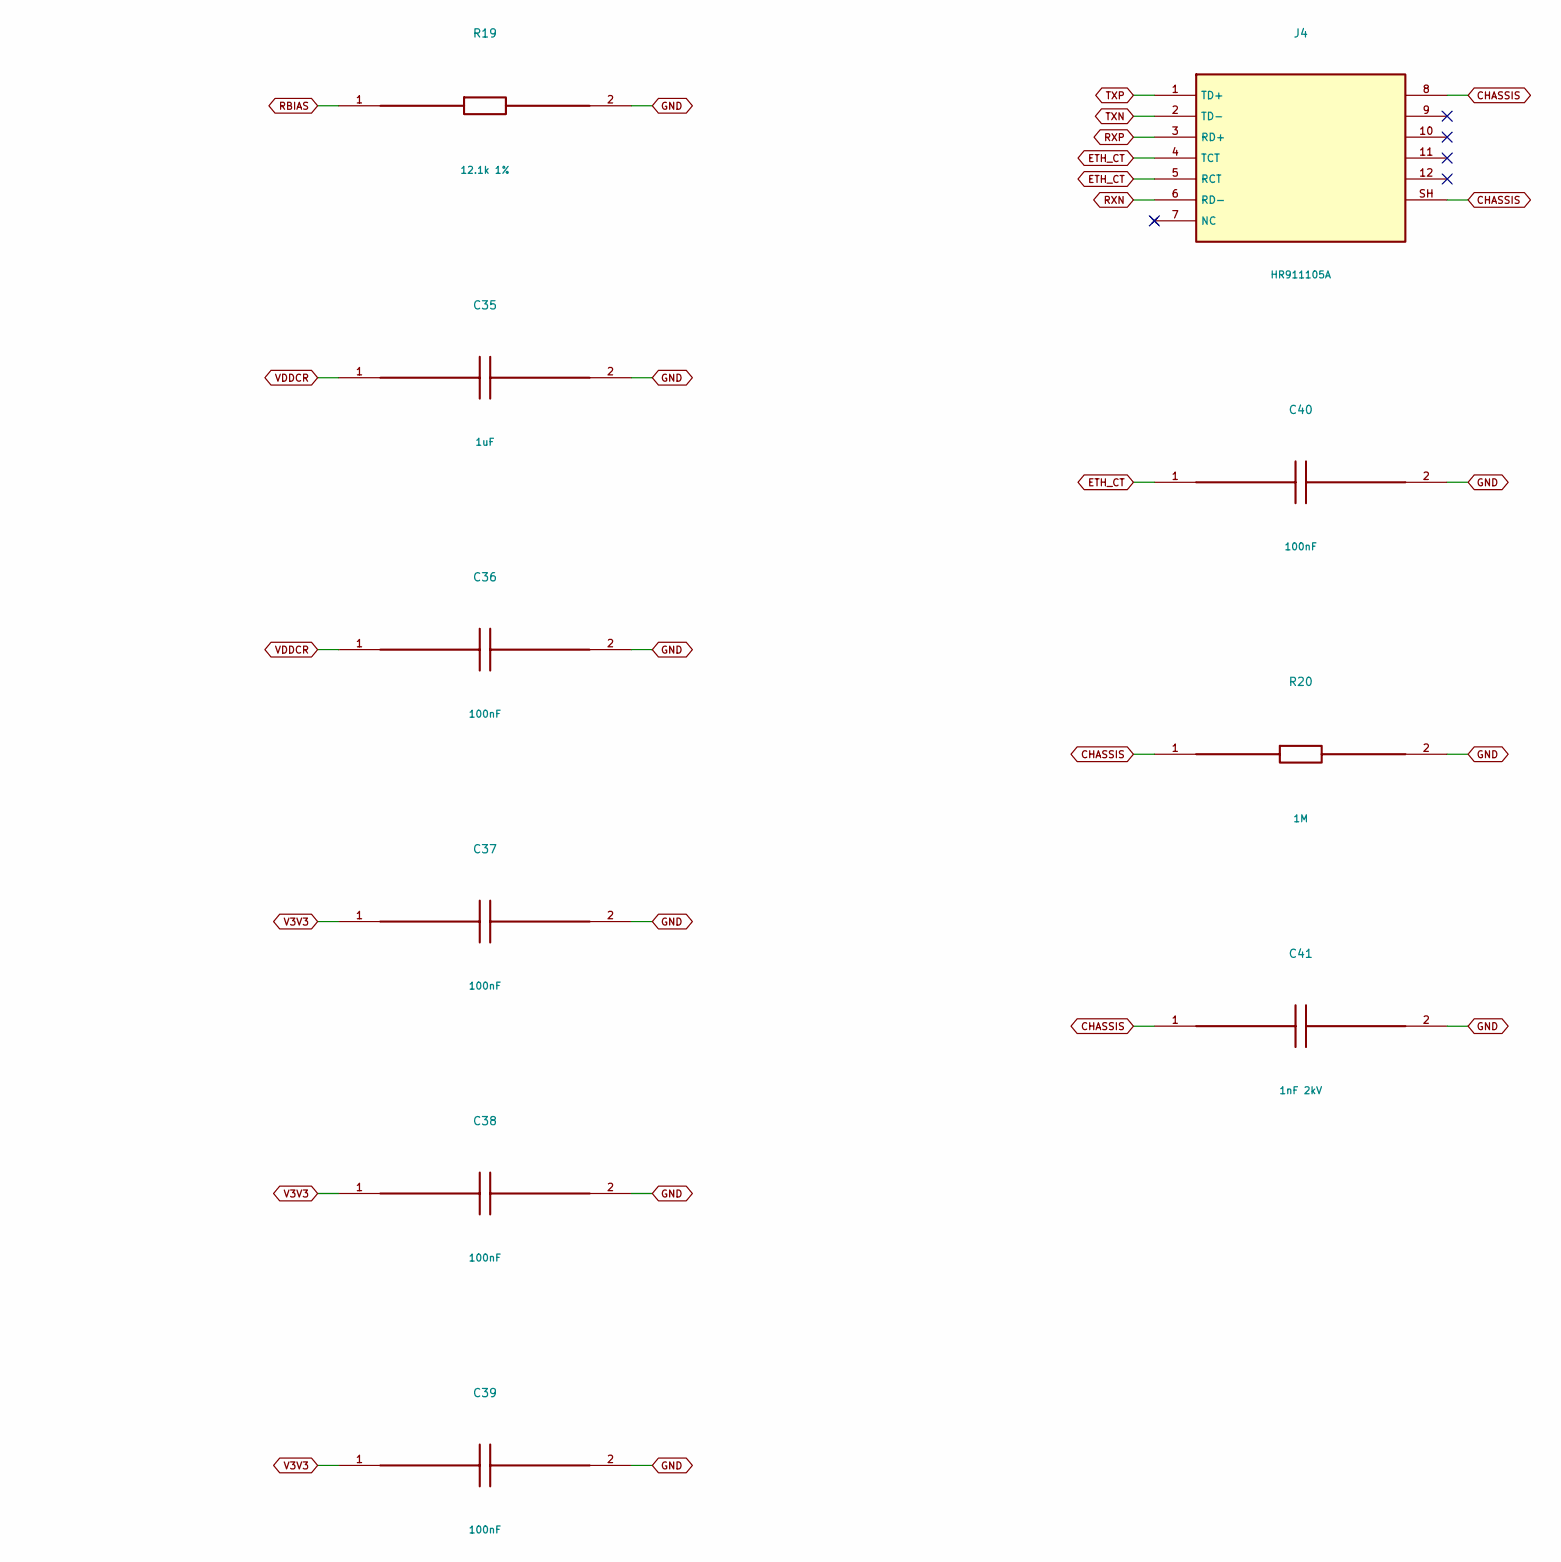
[picture p88: schematic 04.kicad_sch, PANOGOZ-GW-B1 / ETHERNET, part in row 1, column 2]

Parts:
C34, C36, C37, C38, C39, C40: 100nF; C_0402_1005Metric; MPN X7R 16V 100nF
C35: 1uF; C_0402_1005Metric; MPN X7R 16V 1uF
C41: 1nF 2kV; C_1206_3216Metric; MPN X7R 16V 1nF 2kV
J4: HR911105A; RJ45_Hanrun_HR911105A_Horizontal; MPN HR911105A
R11, R12, R13, R14, R15, R16, R17, R18: 10k; R_0402_1005Metric; MPN 1% thick film 10k
R19: 12.1k 1%; R_0402_1005Metric; MPN 1% thick film 12.1k 1%
R20: 1M; R_0402_1005Metric; MPN 1% thick film 1M
U6: LAN8742A-CZ-TR; VQFN-24-1EP_4x4mm_P0.5mm_EP2.5x2.5mm_ThermalVias; MPN LAN8742A-CZ-TR
U7: 50MHz 3V3 OSC; Oscillator_SMD_Abracon_ASE-4Pin_3.2x2.5mm; MPN 50MHz 3V3 OSC

Connections:
CHASSIS: C41.1, J4.8, J4.SH, R20.1
ETH_CLK50: U6.5 (XTAL1/CLKIN), U7.3 (OUT); also elsewhere on the board
ETH_CRS: R16.1, U6.11 (CRS_DV/MODE2); also elsewhere on the board
ETH_CT: C40.1, J4.4 (TCT), J4.5 (RCT)
ETH_MDC: U6.13 (MDC); also elsewhere on the board
ETH_MDIO: R17.1, U6.12 (MDIO); also elsewhere on the board
ETH_RST: R18.1, U6.15 (~RST); also elsewhere on the board
ETH_RXD0: R14.1, U6.8 (RXD0/MODE0); also elsewhere on the board
ETH_RXD1: R15.1, U6.7 (RXD1/MODE1); also elsewhere on the board
ETH_TXD0: U6.17 (TXD0); also elsewhere on the board
ETH_TXD1: U6.18 (TXD1); also elsewhere on the board
ETH_TXEN: U6.16 (TXEN); also elsewhere on the board
GND: C34.2, C35.2, C36.2, C37.2, C38.2, C39.2, C40.2, C41.2, R12.2, R13.2, R19.2, R20.2, U6.25 (VSS), U7.2 (GND); also elsewhere on the board
PHY_ADDR: R13.1, U6.10 (RXER/PHYAD0)
PHY_INTSEL: R11.1, U6.2 (LED2/~INTSEL)
PHY_REGOFF: R12.1, U6.3 (LED1/REGOFF)
RBIAS: R19.1, U6.24 (RBIAS)
RXN: J4.6 (RD-), U6.22 (RXN)
RXP: J4.3 (RD+), U6.23 (RXP)
TXN: J4.2 (TD-), U6.20 (TXN)
TXP: J4.1 (TD+), U6.21 (TXP)
V3V3: C34.1, C37.1, C38.1, C39.1, R11.2, R14.2, R15.2, R16.2, R17.2, R18.2, U6.1 (VDD2A), U6.9 (VDDIO), U6.19 (VDD1A), U7.1 (OE), U7.4 (VDD); also elsewhere on the board
VDDCR: C35.1, C36.1, U6.6 (VDDCR)

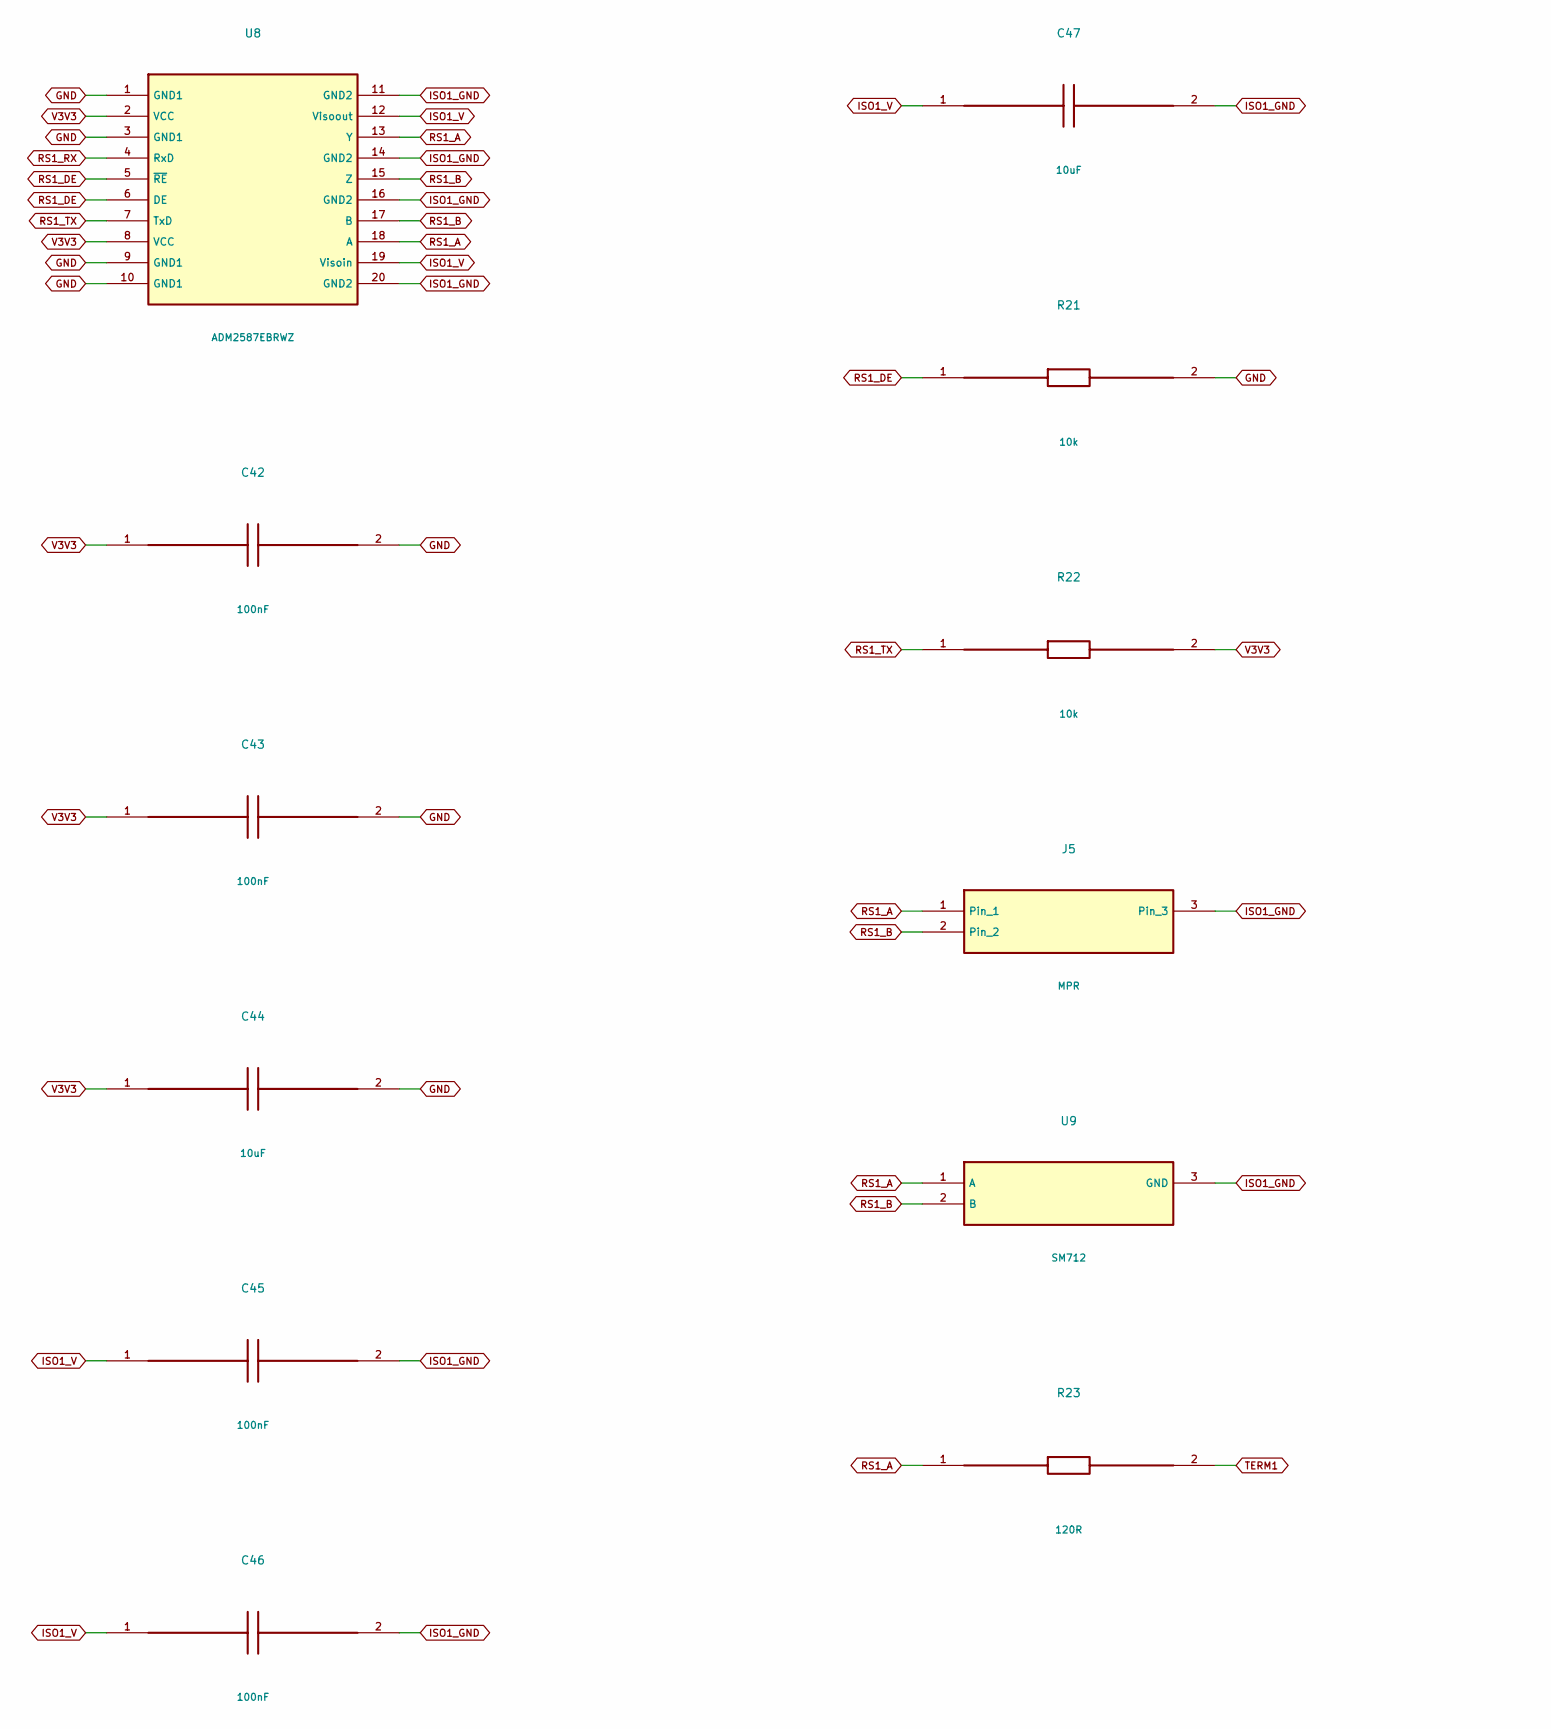
[picture p89: schematic 05.kicad_sch, PANOGOZ-GW-B1 / RS485, part in row 1, column 1]

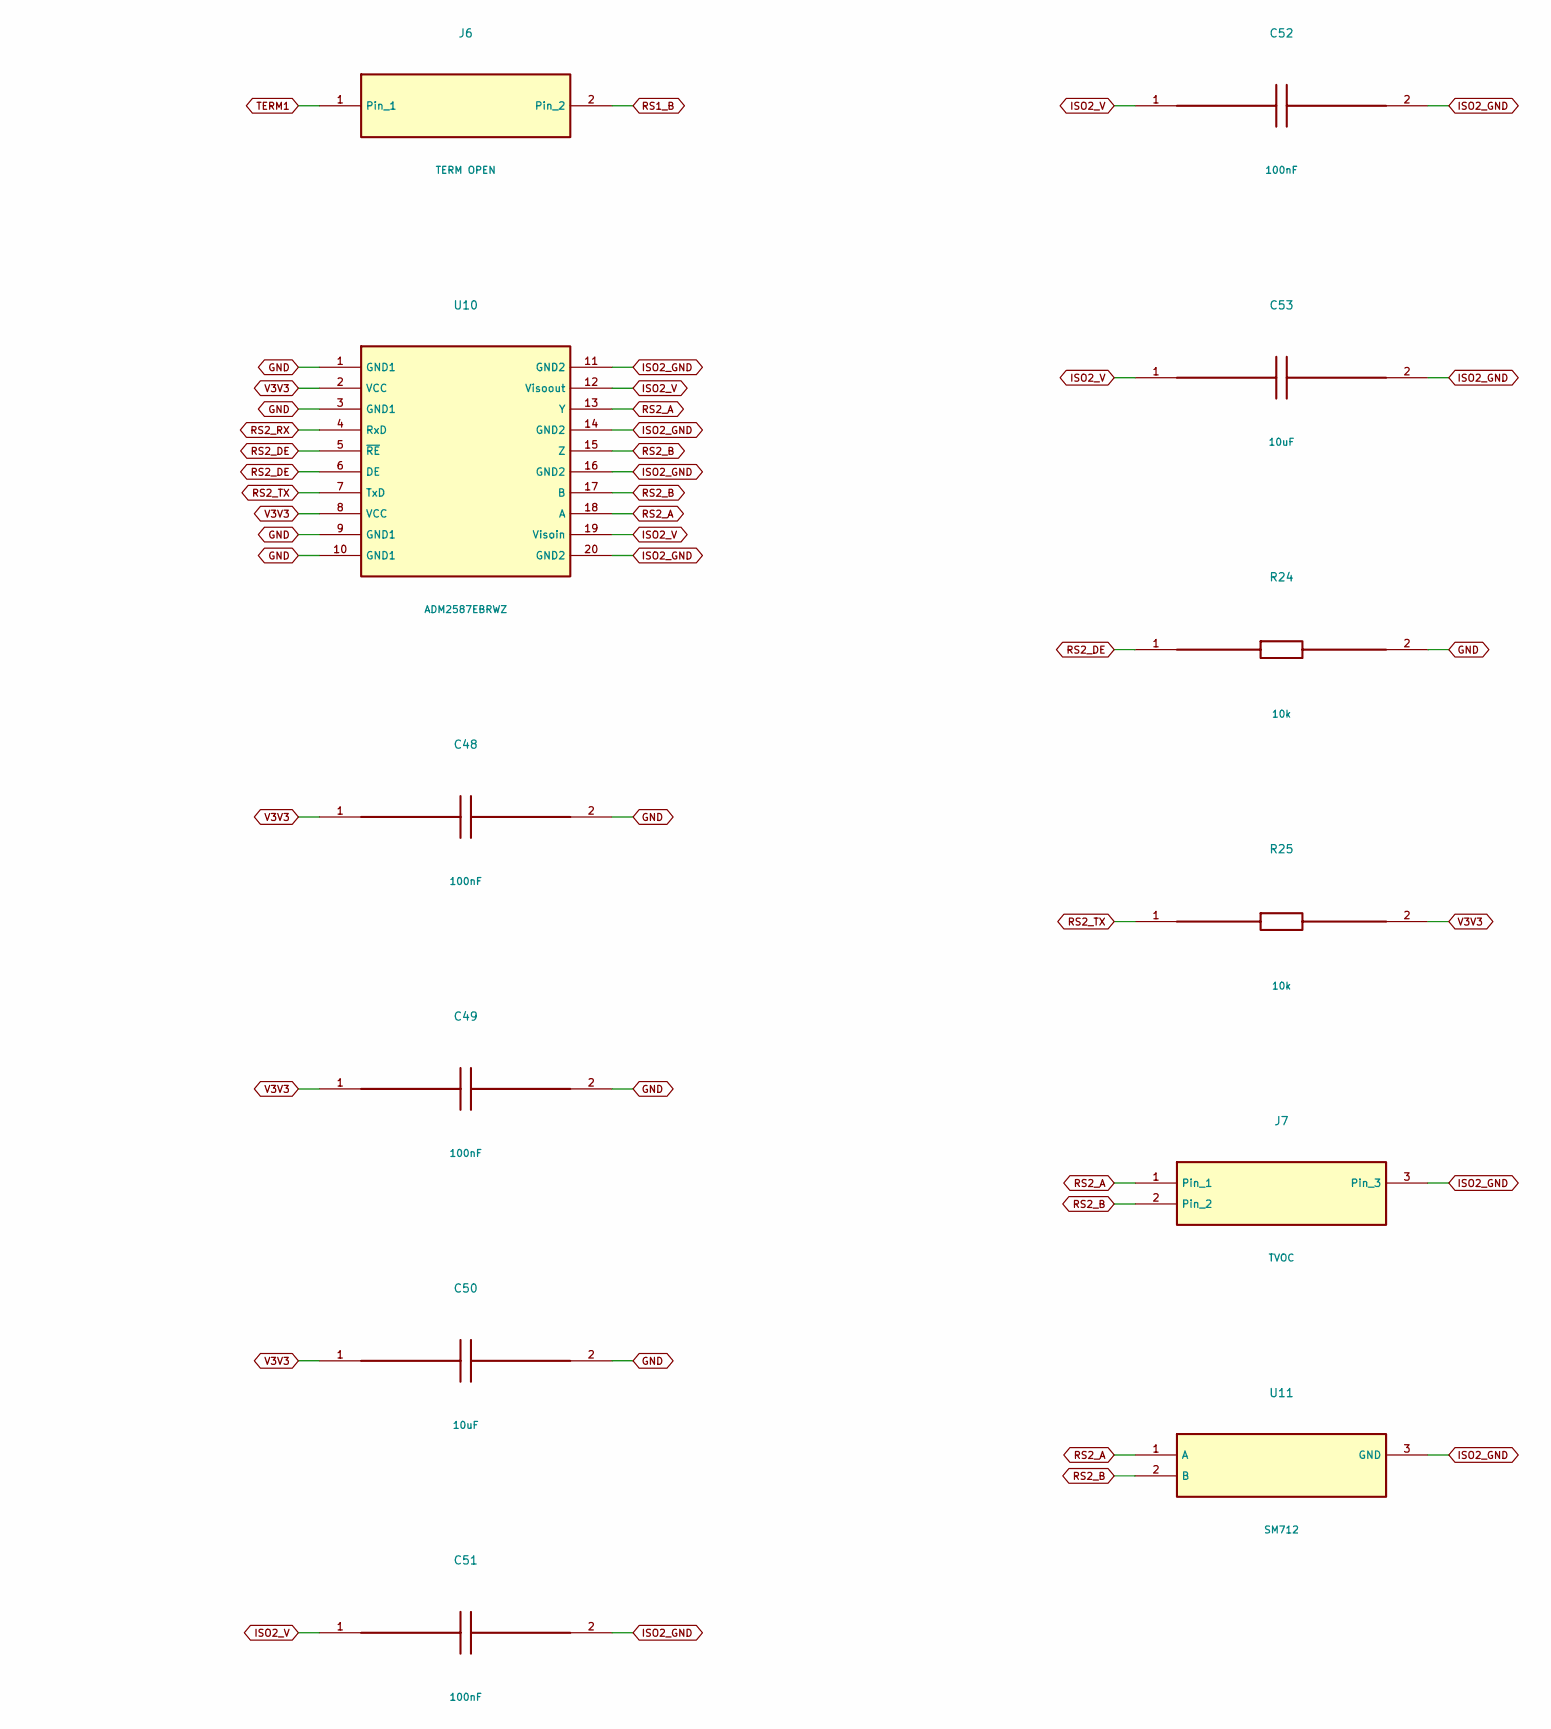
[picture p90: schematic 05.kicad_sch, PANOGOZ-GW-B1 / RS485, part in row 1, column 2]

Parts:
C42, C43, C45, C46, C48, C49, C51, C52: 100nF; C_0402_1005Metric; MPN X7R 16V 100nF
C44, C47, C50, C53: 10uF; C_0805_2012Metric; MPN X7R 16V 10uF
J5: MPR; TerminalBlock_Phoenix_MKDS-1,5-3-5.08_1x03_P5.08mm_Horizont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; MPN MPR
J6: TERM OPEN; PinHeader_1x02_P2.54mm_Vertical; MPN TERM OPEN
J7: TVOC; TerminalBlock_Phoenix_MKDS-1,5-3-5.08_1x03_P5.08mm_Horizont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; MPN TVOC
R21, R22, R24, R25: 10k; R_0402_1005Metric; MPN 1% thick film 10k
R23: 120R; R_0805_2012Metric; MPN 1% thick film 120R
U8, U10: ADM2587EBRWZ; SOIC-20W_7.5x12.8mm_P1.27mm; MPN ADM2587EBRWZ
U9, U11: SM712; SOT-23; MPN SM712

Connections:
GND: C42.2, C43.2, C44.2, C48.2, C49.2, C50.2, R21.2, R24.2, U8.1 (GND1), U8.3 (GND1), U8.9 (GND1), U8.10 (GND1), U10.1 (GND1), U10.3 (GND1), U10.9 (GND1), U10.10 (GND1); also elsewhere on the board
ISO1_GND: C45.2, C46.2, C47.2, J5.3, U8.11 (GND2), U8.14 (GND2), U8.16 (GND2), U8.20 (GND2), U9.3 (GND)
ISO1_V: C45.1, C46.1, C47.1, U8.12 (Visoout), U8.19 (Visoin)
ISO2_GND: C51.2, C52.2, C53.2, J7.3, U10.11 (GND2), U10.14 (GND2), U10.16 (GND2), U10.20 (GND2), U11.3 (GND)
ISO2_V: C51.1, C52.1, C53.1, U10.12 (Visoout), U10.19 (Visoin)
RS1_A: J5.1, R23.1, U8.13 (Y), U8.18 (A), U9.1 (A)
RS1_B: J5.2, J6.2, U8.15 (Z), U8.17 (B), U9.2 (B)
RS1_DE: R21.1, U8.5 (~RE), U8.6 (DE); also elsewhere on the board
RS1_RX: U8.4 (RxD); also elsewhere on the board
RS1_TX: R22.1, U8.7 (TxD); also elsewhere on the board
RS2_A: J7.1, U10.13 (Y), U10.18 (A), U11.1 (A); also elsewhere on the board
RS2_B: J7.2, U10.15 (Z), U10.17 (B), U11.2 (B); also elsewhere on the board
RS2_DE: R24.1, U10.5 (~RE), U10.6 (DE); also elsewhere on the board
RS2_RX: U10.4 (RxD); also elsewhere on the board
RS2_TX: R25.1, U10.7 (TxD); also elsewhere on the board
TERM1: J6.1, R23.2
V3V3: C42.1, C43.1, C44.1, C48.1, C49.1, C50.1, R22.2, R25.2, U8.2 (VCC), U8.8 (VCC), U10.2 (VCC), U10.8 (VCC); also elsewhere on the board

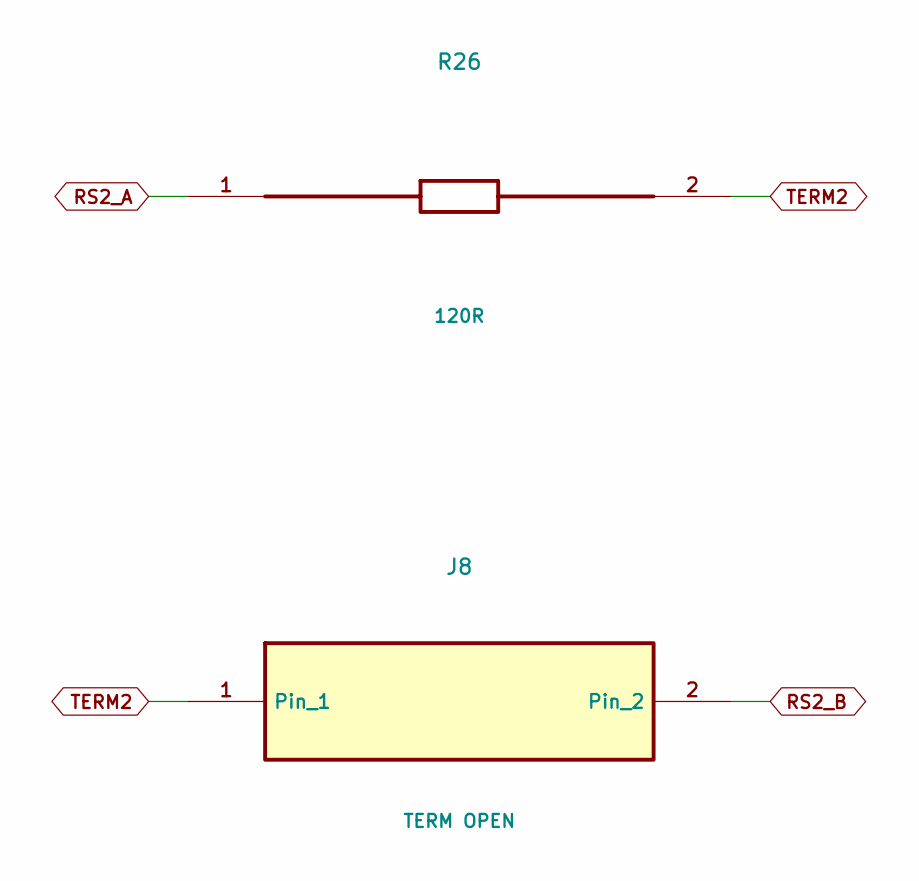
[picture p91: schematic 06.kicad_sch, PANOGOZ-GW-B1 / RS485]

Parts:
J8: TERM OPEN; PinHeader_1x02_P2.54mm_Vertical; MPN TERM OPEN
R26: 120R; R_0805_2012Metric; MPN 1% thick film 120R

Connections:
RS2_A: R26.1; also elsewhere on the board
RS2_B: J8.2; also elsewhere on the board
TERM2: J8.1, R26.2

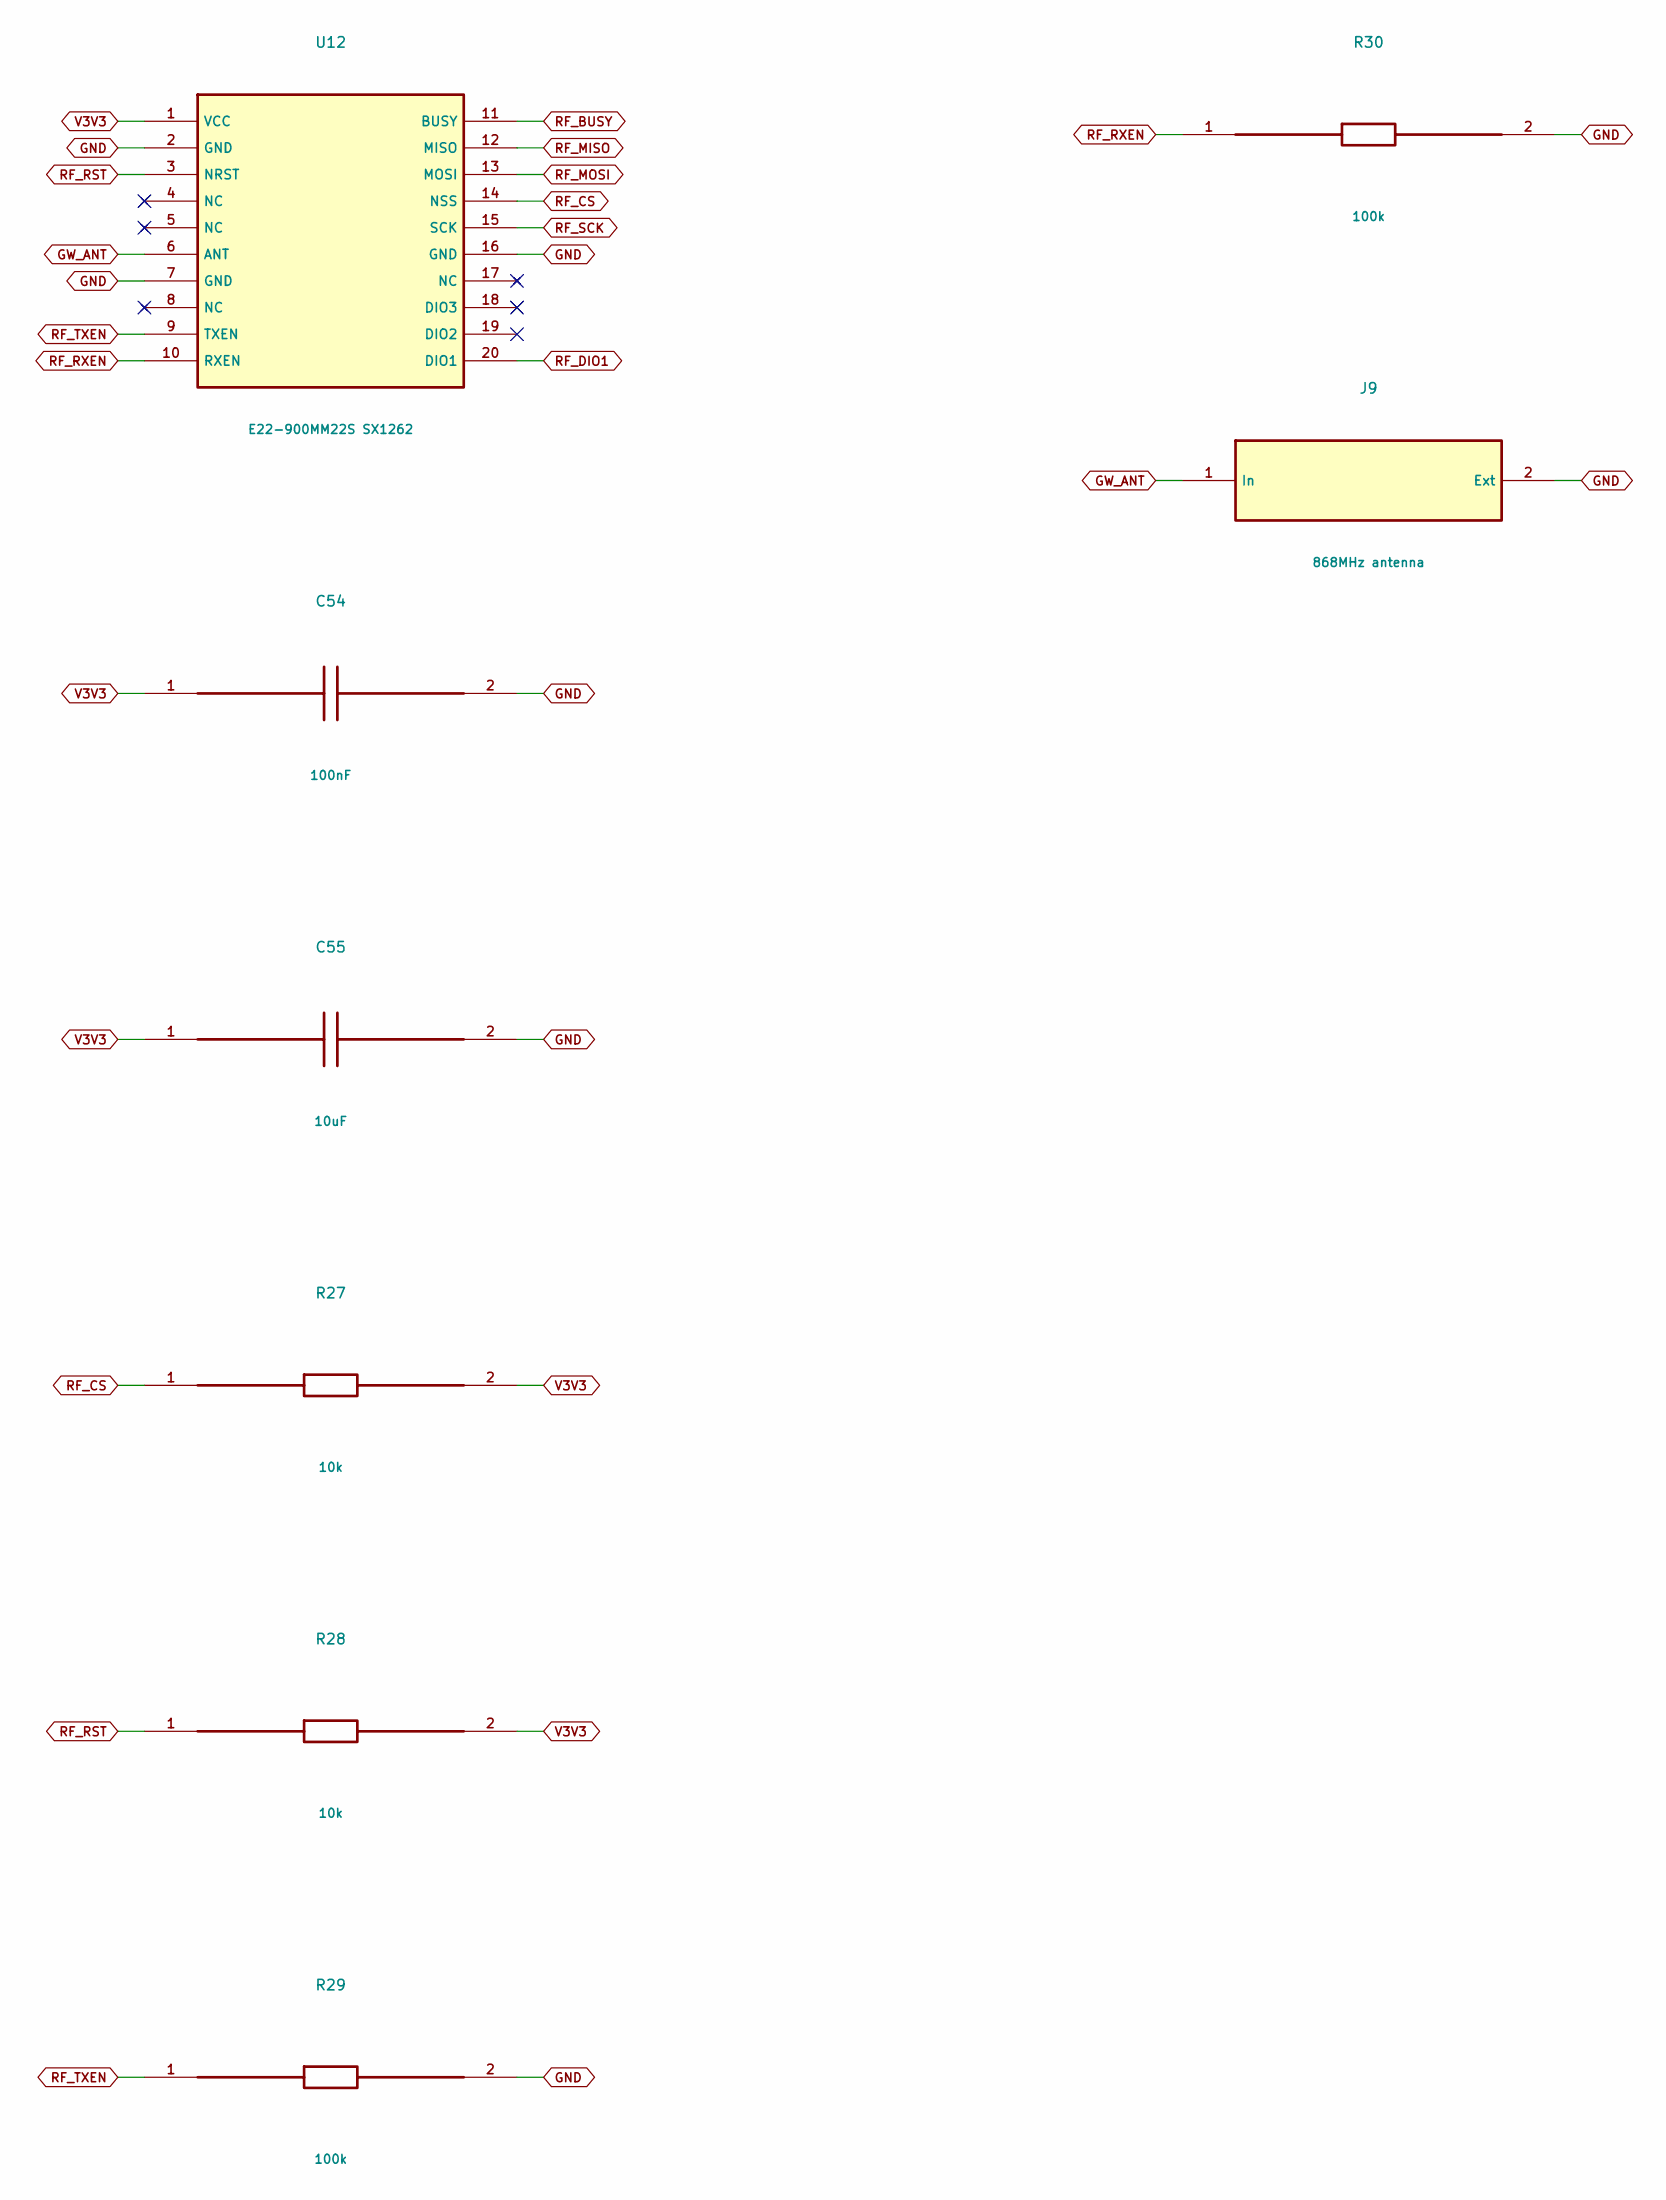
[picture p92: schematic 07.kicad_sch, PANOGOZ-GW-B1 / LORA]

Parts:
C54: 100nF; C_0402_1005Metric; MPN X7R 16V 100nF
C55: 10uF; C_0805_2012Metric; MPN X7R 16V 10uF
J9: 868MHz antenna; U.FL_Hirose_U.FL-R-SMT-1_Vertical; MPN 868MHz antenna
R27, R28: 10k; R_0402_1005Metric; MPN 1% thick film 10k
R29, R30: 100k; R_0402_1005Metric; MPN 1% thick film 100k
U12: E22-900MM22S SX1262; E22-900MM22S; MPN E22-900MM22S

Connections:
GND: C54.2, C55.2, J9.2 (Ext), R29.2, R30.2, U12.2 (GND), U12.7 (GND), U12.16 (GND); also elsewhere on the board
GW_ANT: J9.1 (In), U12.6 (ANT)
RF_BUSY: U12.11 (BUSY); also elsewhere on the board
RF_CS: R27.1, U12.14 (NSS); also elsewhere on the board
RF_DIO1: U12.20 (DIO1); also elsewhere on the board
RF_MISO: U12.12 (MISO); also elsewhere on the board
RF_MOSI: U12.13 (MOSI); also elsewhere on the board
RF_RST: R28.1, U12.3 (NRST); also elsewhere on the board
RF_RXEN: R30.1, U12.10 (RXEN); also elsewhere on the board
RF_SCK: U12.15 (SCK); also elsewhere on the board
RF_TXEN: R29.1, U12.9 (TXEN); also elsewhere on the board
V3V3: C54.1, C55.1, R27.2, R28.2, U12.1 (VCC); also elsewhere on the board

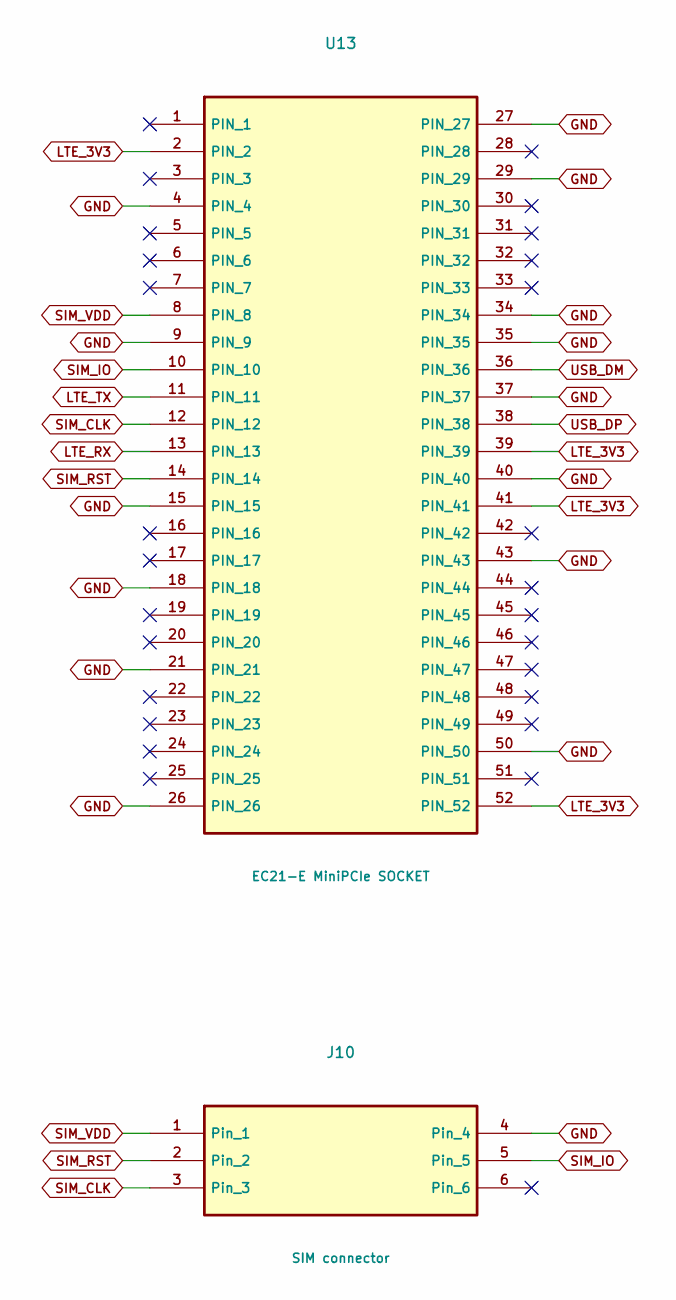
[picture p93: schematic 08.kicad_sch, PANOGOZ-GW-B1 / LTE]

Parts:
J10: SIM connector; PinHeader_1x06_P2.00mm_Vertical; MPN SIM connector
U13: EC21-E MiniPCIe SOCKET; TE_2041119_1; MPN 2041119-1

Connections:
GND: J10.4, U13.4 (PIN_4), U13.9 (PIN_9), U13.15 (PIN_15), U13.18 (PIN_18), U13.21 (PIN_21), U13.26 (PIN_26), U13.27 (PIN_27), U13.29 (PIN_29), U13.34 (PIN_34), U13.35 (PIN_35), U13.37 (PIN_37), U13.40 (PIN_40), U13.43 (PIN_43), U13.50 (PIN_50); also elsewhere on the board
LTE_3V3: U13.2 (PIN_2), U13.39 (PIN_39), U13.41 (PIN_41), U13.52 (PIN_52); also elsewhere on the board
LTE_RX: U13.13 (PIN_13); also elsewhere on the board
LTE_TX: U13.11 (PIN_11); also elsewhere on the board
SIM_CLK: J10.3, U13.12 (PIN_12)
SIM_IO: J10.5, U13.10 (PIN_10)
SIM_RST: J10.2, U13.14 (PIN_14)
SIM_VDD: J10.1, U13.8 (PIN_8)
USB_DM: U13.36 (PIN_36); also elsewhere on the board
USB_DP: U13.38 (PIN_38); also elsewhere on the board
