hackathon-buke-team/grid-up/hardware/B1/GW/PANOGOZ-GW-B1.kicad_pcb

## KiCad design hardware/B1/GW/PANOGOZ-GW-B1.kicad_pcb (continued)

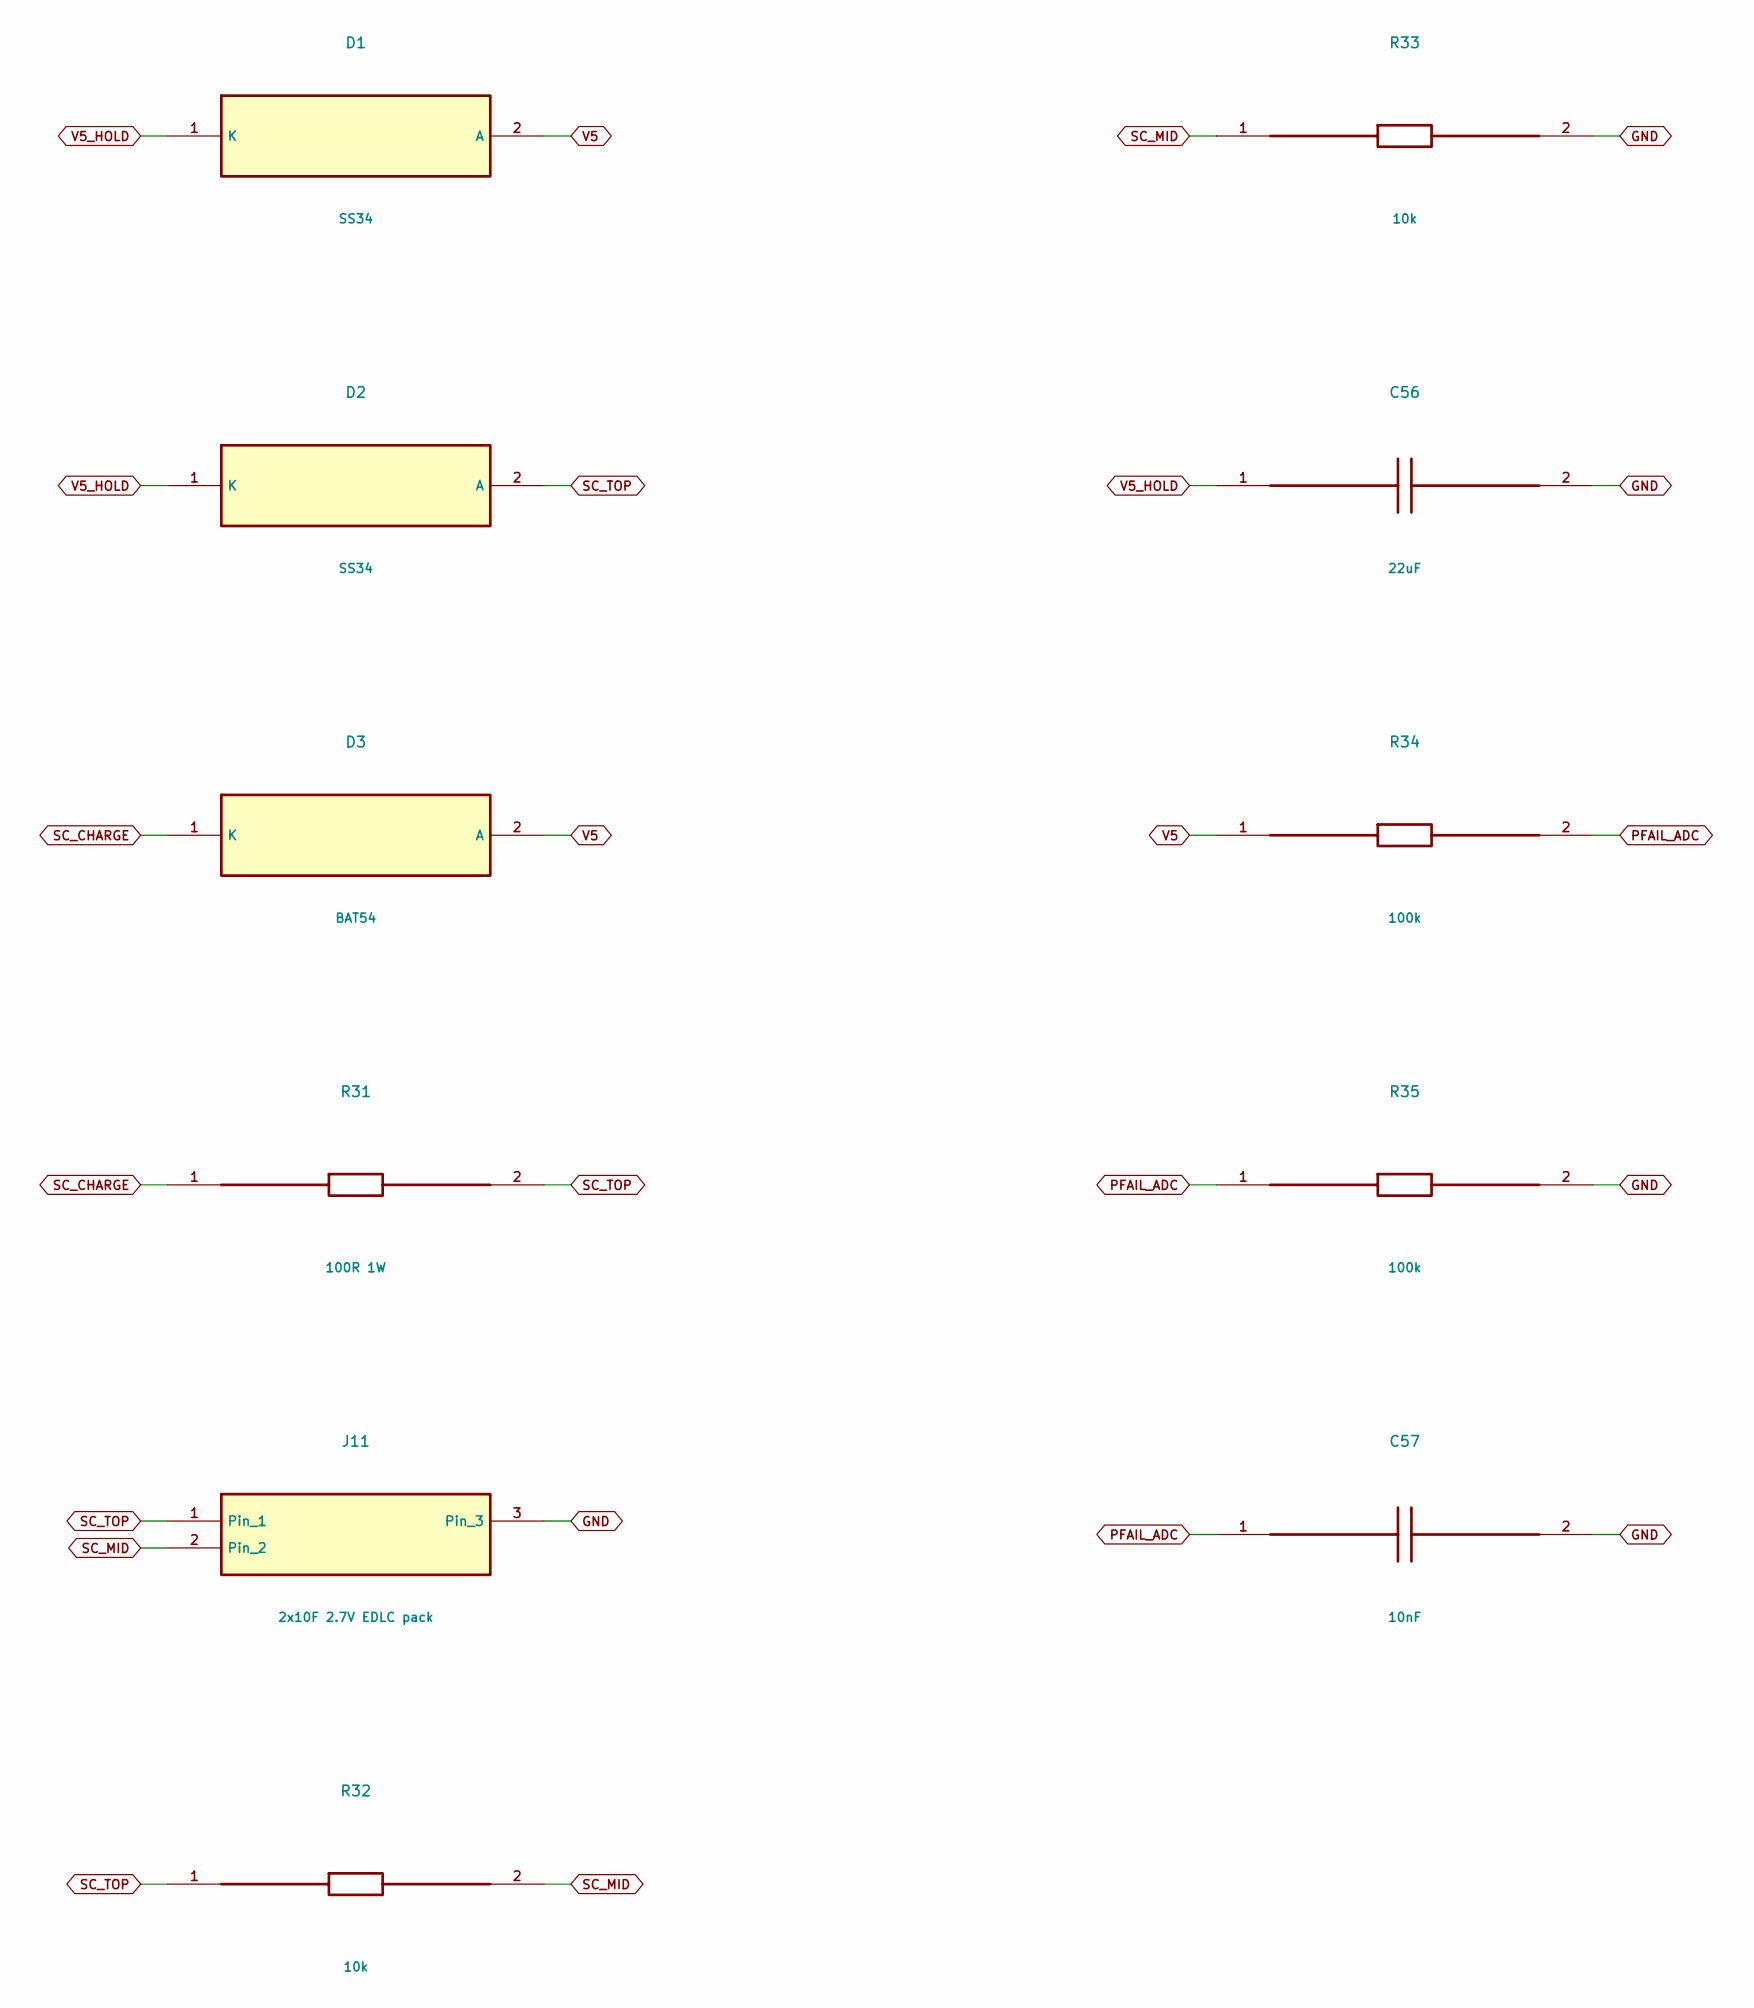
[picture p94: schematic 09.kicad_sch, PANOGOZ-GW-B1 / HOLDUP]

Parts:
C56: 22uF; C_0805_2012Metric; MPN X7R 16V 22uF
C57: 10nF; C_0402_1005Metric; MPN X7R 16V 10nF
D1, D2: SS34; D_SMA; MPN SS34
D3: BAT54; D_SOD-123; MPN BAT54
J11: 2x10F 2.7V EDLC pack; JST_SH_SM03B-SRSS-TB_1x03-1MP_P1.00mm_Horizontal; MPN 2x10F 2.7V EDLC pack
R31: 100R 1W; R_2512_6332Metric; MPN 1% thick film 100R 1W
R32, R33: 10k; R_0402_1005Metric; MPN 1% thick film 10k
R34, R35: 100k; R_0402_1005Metric; MPN 1% thick film 100k

Connections:
GND: C56.2, C57.2, J11.3, R33.2, R35.2; also elsewhere on the board
PFAIL_ADC: C57.1, R34.2, R35.1; also elsewhere on the board
SC_CHARGE: D3.1 (K), R31.1
SC_MID: J11.2, R32.2, R33.1
SC_TOP: D2.2 (A), J11.1, R31.2, R32.1
V5: D1.2 (A), D3.2 (A), R34.1; also elsewhere on the board
V5_HOLD: C56.1, D1.1 (K), D2.1 (K); also elsewhere on the board

Board: 4 copper layers, 126 parts (1 on the bottom side), 92 nets, no tracks yet.
