hackathon-buke-team/grid-up/hardware/B1/TC/PANOGOZ-TC-B1.kicad_pcb

## KiCad design hardware/B1/TC/PANOGOZ-TC-B1.kicad_pcb (2026-09-20)

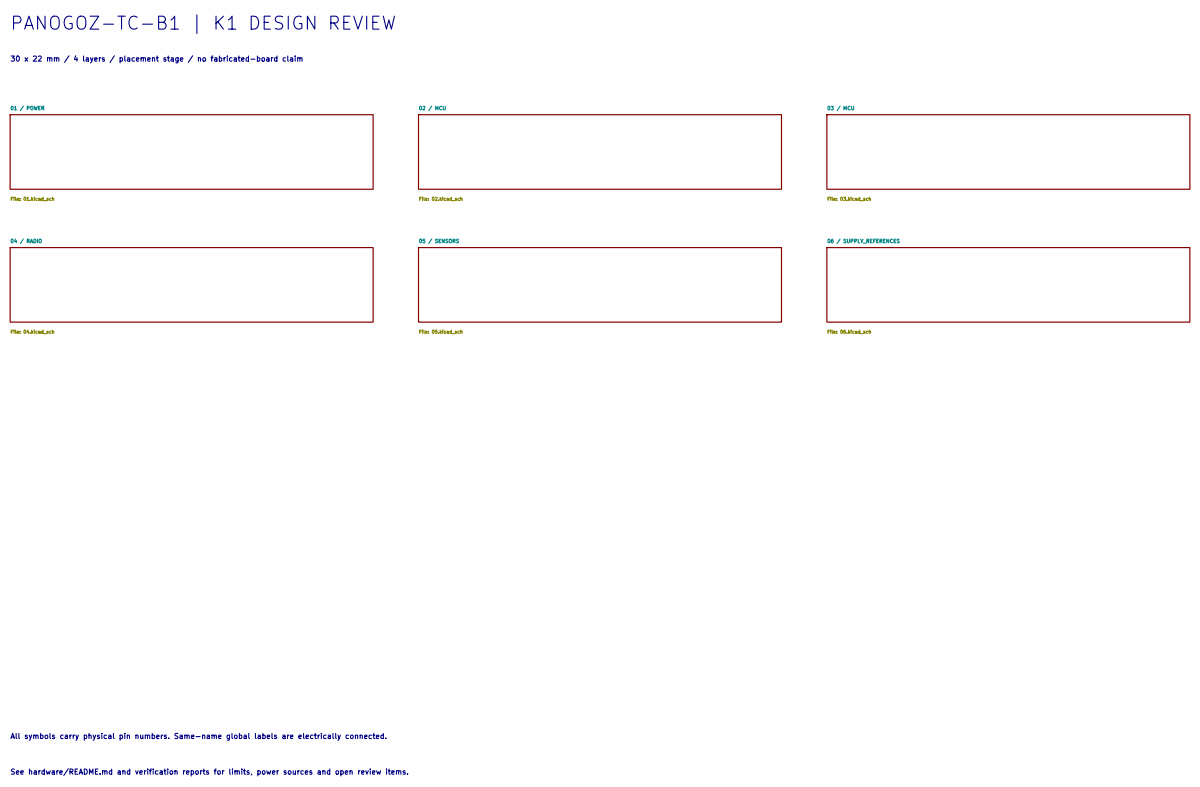
[picture p95: schematic PANOGOZ-TC-B1.kicad_sch]

Notes on the sheet:
PANOGOZ-TC-B1 | K1 DESIGN REVIEW
30 x 22 mm / 4 layers / placement stage / no fabricated-board claim
All symbols carry physical pin numbers. Same-name global labels are electrically connected.
See hardware/README.md and verification reports for limits, power sources and open review items.

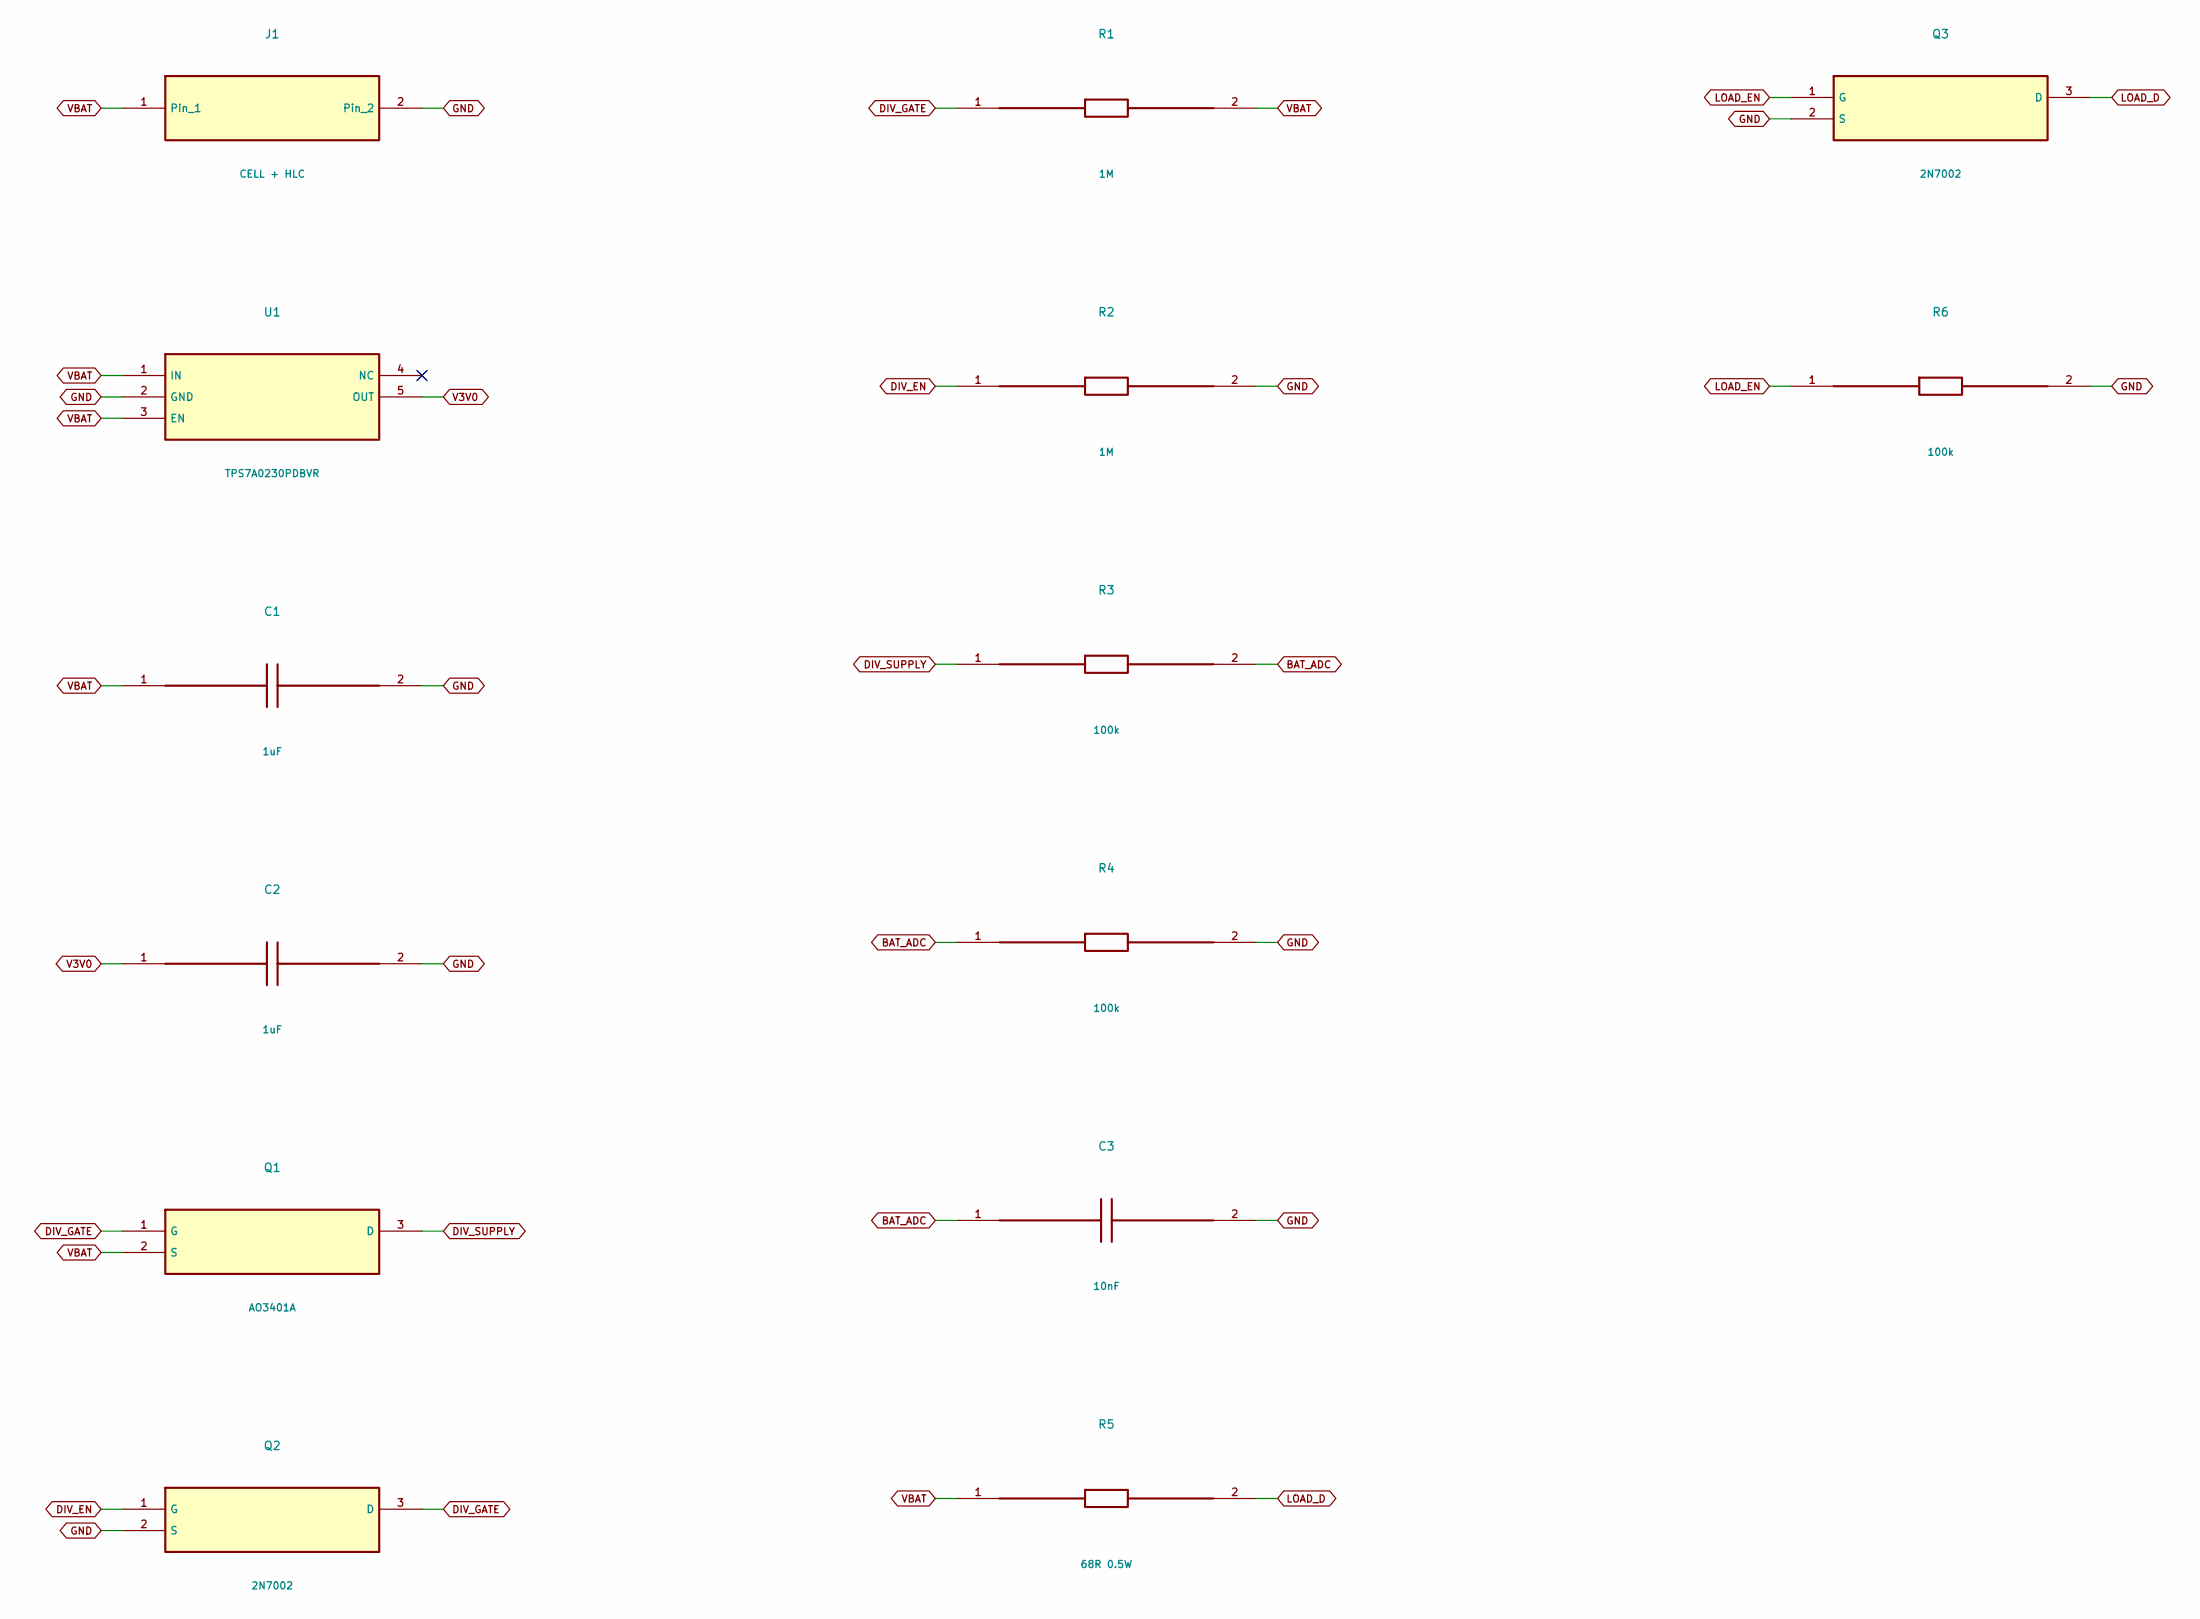
[picture p96: schematic 01.kicad_sch, PANOGOZ-TC-B1 / POWER]

Parts:
C1, C2: 1uF; C_0402_1005Metric; MPN X7R 16V 1uF
C3: 10nF; C_0402_1005Metric; MPN X7R 16V 10nF
J1: CELL + HLC; JST_SH_SM02B-SRSS-TB_1x02-1MP_P1.00mm_Horizontal; MPN CELL + HLC
Q1: AO3401A; SOT-23; MPN AO3401A
Q2, Q3: 2N7002; SOT-23; MPN 2N7002
R1, R2: 1M; R_0402_1005Metric; MPN 1% thick film 1M
R3, R4, R6: 100k; R_0402_1005Metric; MPN 1% thick film 100k
R5: 68R 0.5W; R_1210_3225Metric; MPN 1% thick film 68R 0.5W
U1: TPS7A0230PDBVR; SOT-23-5; MPN TPS7A0230PDBVR

Connections:
BAT_ADC: C3.1, R3.2, R4.1; also elsewhere on the board
DIV_EN: Q2.1 (G), R2.1; also elsewhere on the board
DIV_GATE: Q1.1 (G), Q2.3 (D), R1.1
DIV_SUPPLY: Q1.3 (D), R3.1
GND: C1.2, C2.2, C3.2, J1.2, Q2.2 (S), Q3.2 (S), R2.2, R4.2, R6.2, U1.2 (GND); also elsewhere on the board
LOAD_D: Q3.3 (D), R5.2
LOAD_EN: Q3.1 (G), R6.1; also elsewhere on the board
V3V0: C2.1, U1.5 (OUT); also elsewhere on the board
VBAT: C1.1, J1.1, Q1.2 (S), R1.2, R5.1, U1.1 (IN), U1.3 (EN)

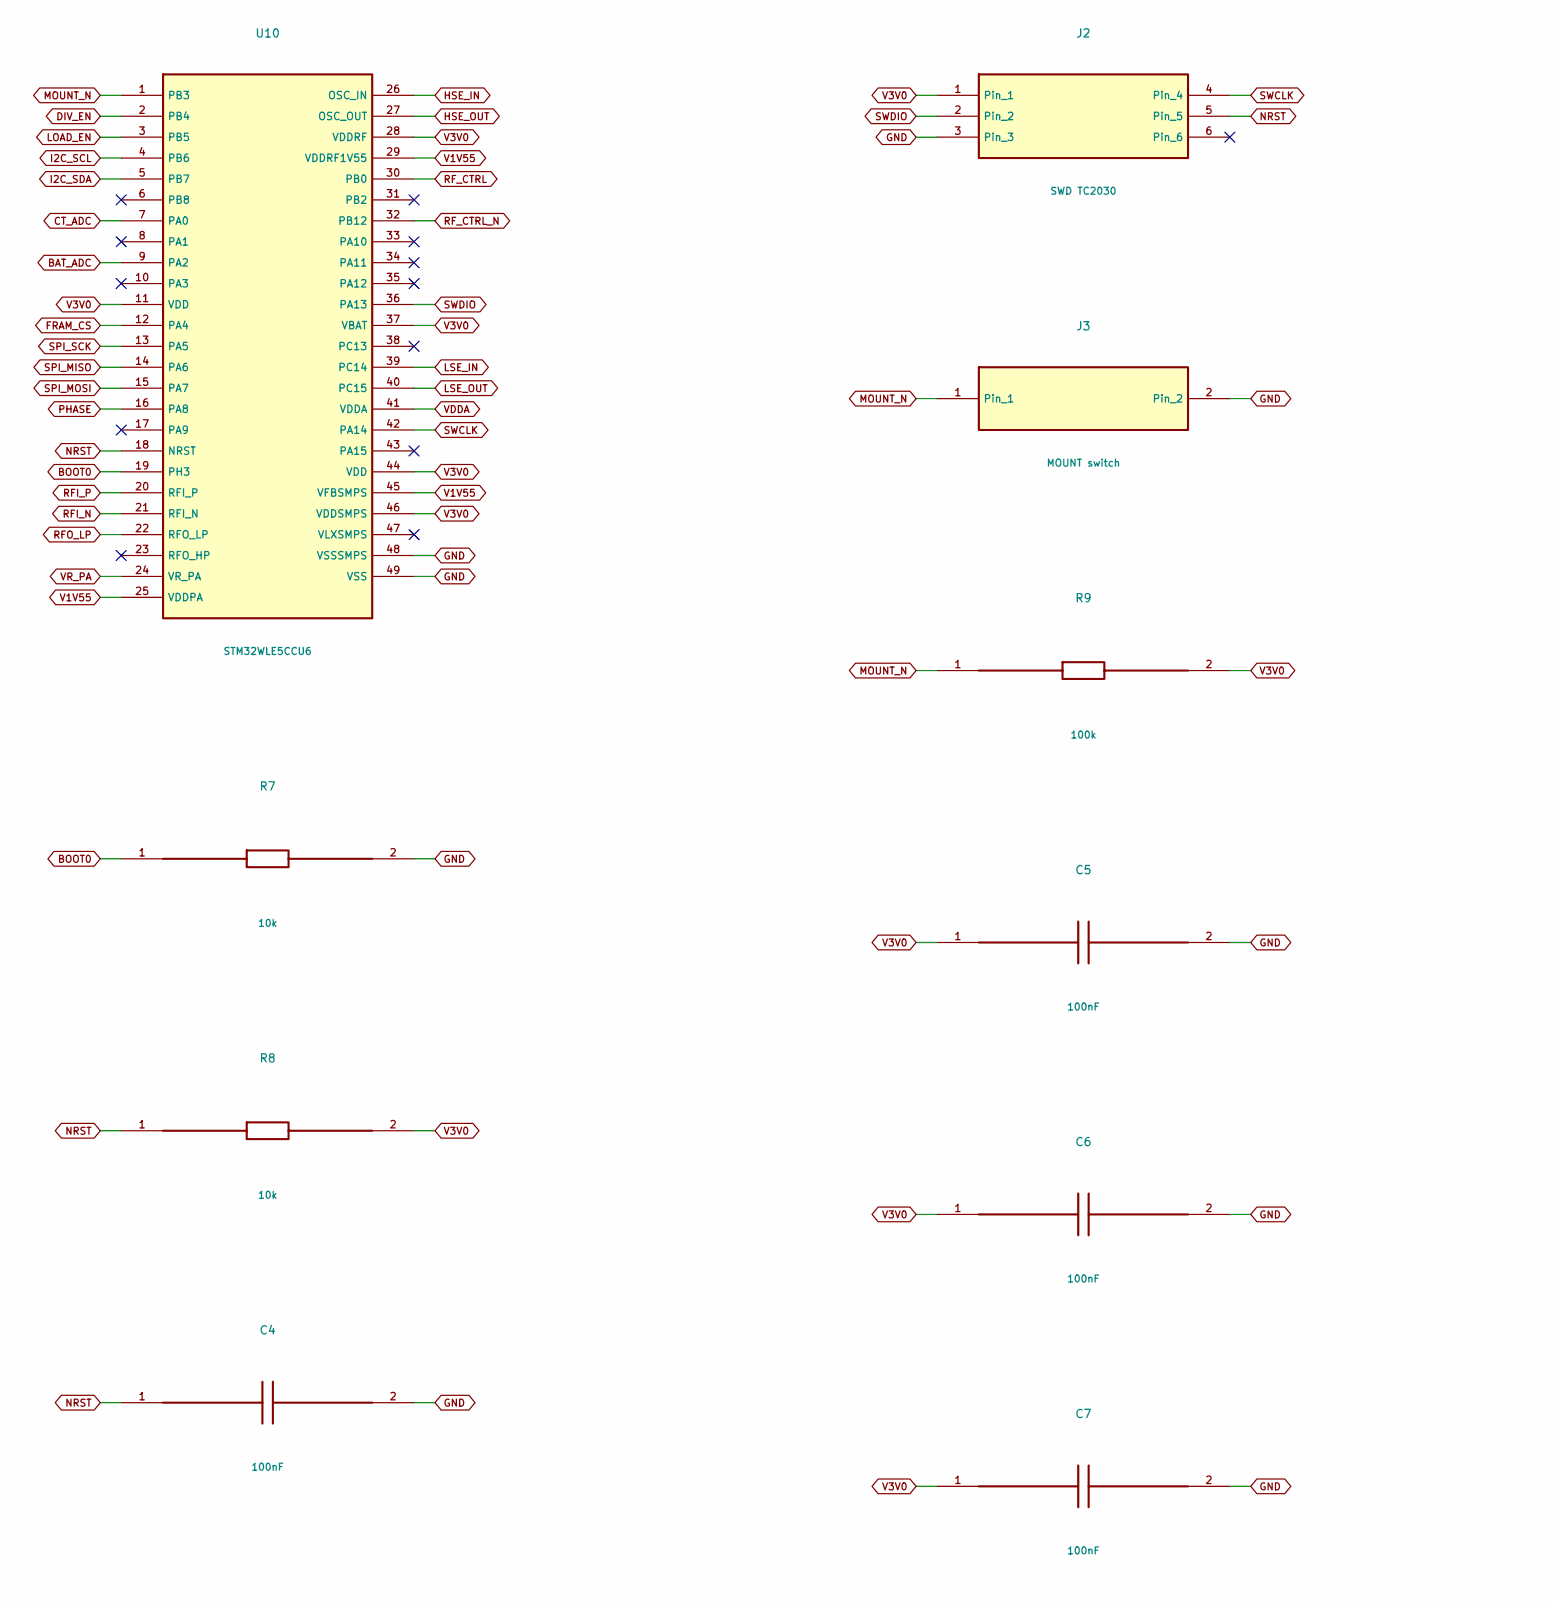
[picture p97: schematic 02.kicad_sch, PANOGOZ-TC-B1 / MCU, part in row 1, column 1]

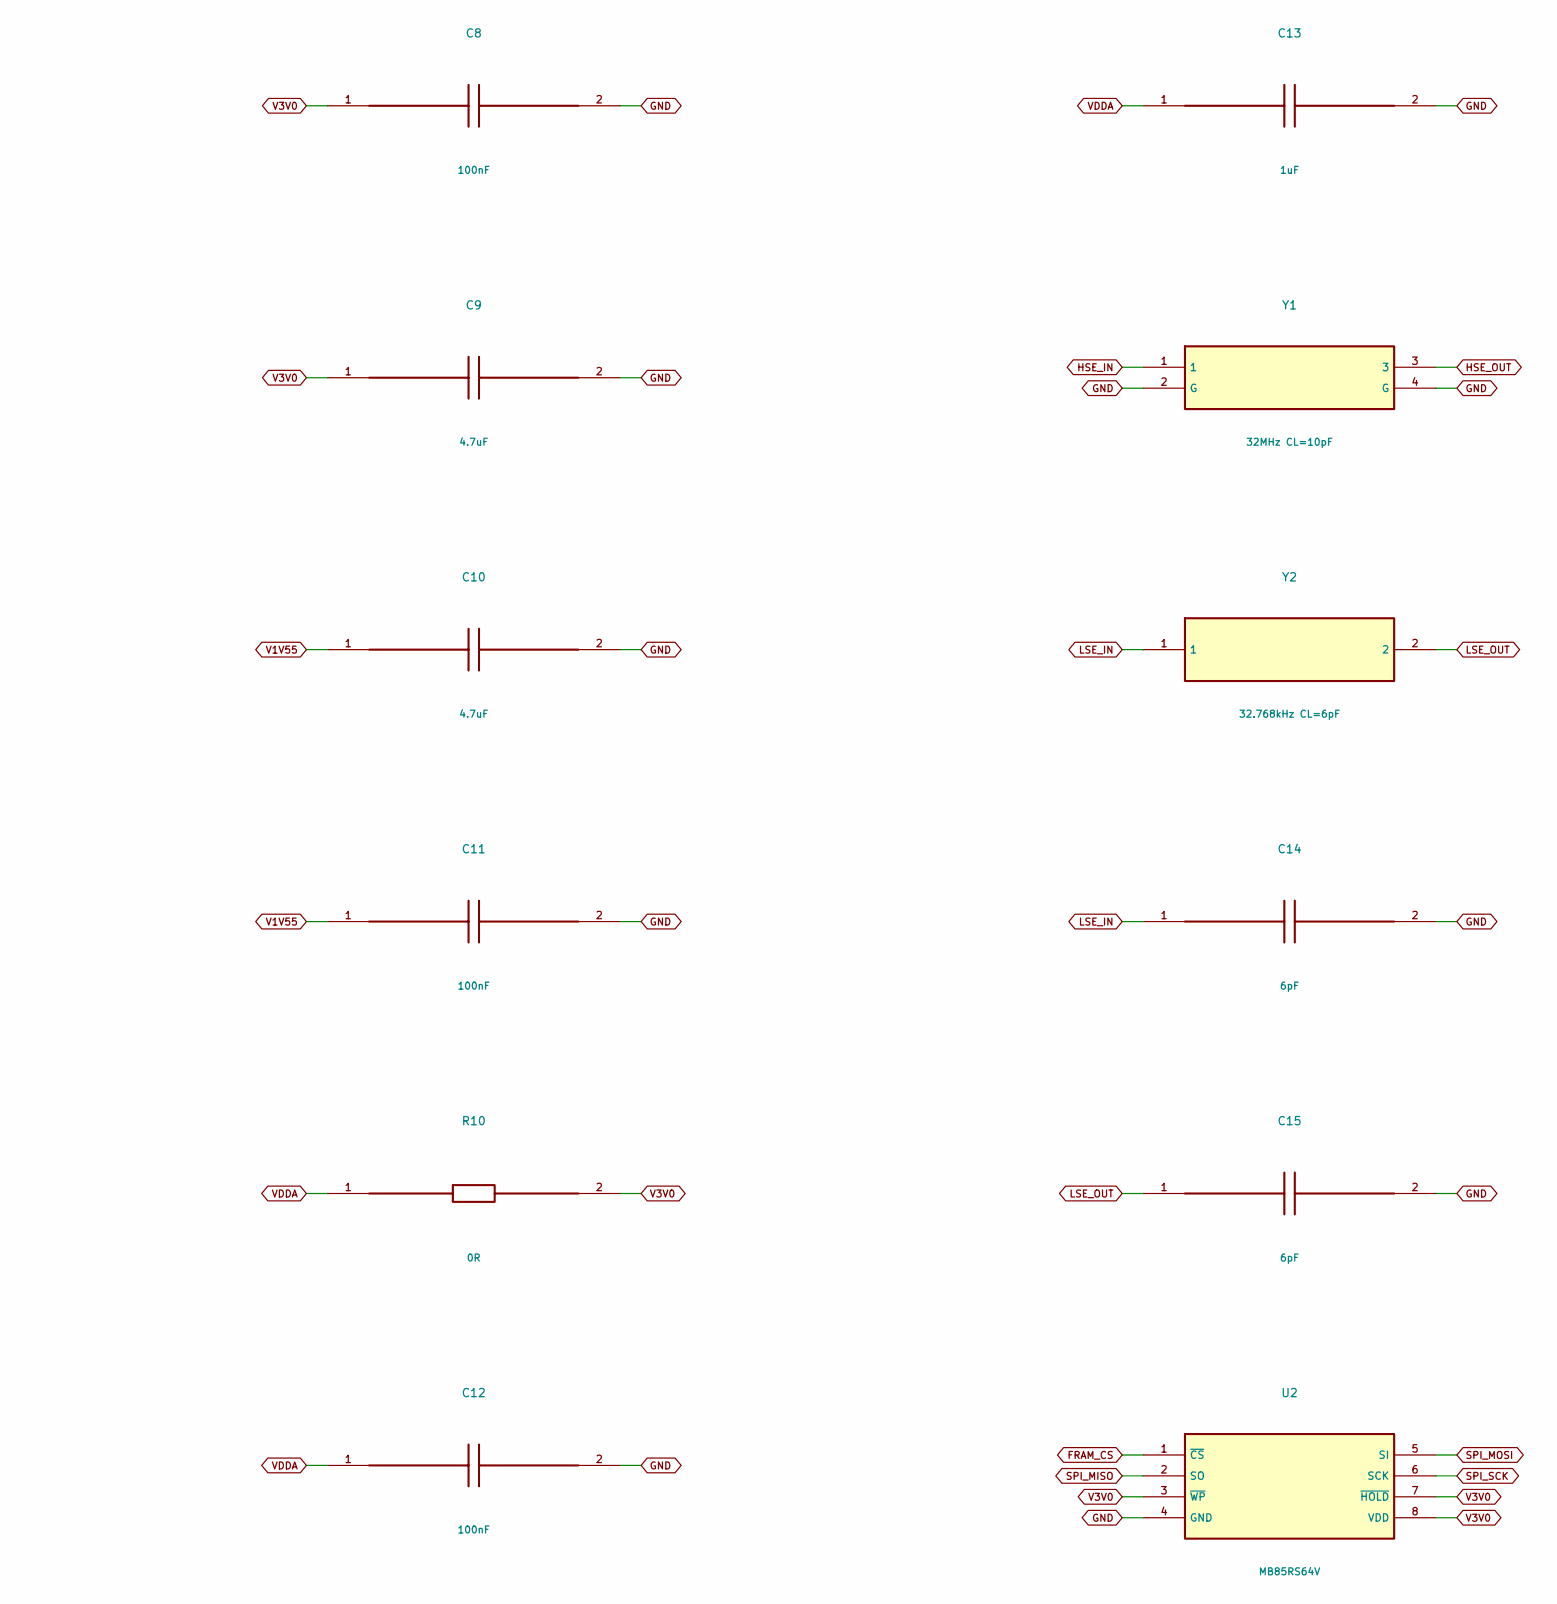
[picture p98: schematic 02.kicad_sch, PANOGOZ-TC-B1 / MCU, part in row 1, column 2]

Parts:
C4, C5, C6, C7, C8, C11, C12: 100nF; C_0402_1005Metric; MPN X7R 16V 100nF
C9, C10: 4.7uF; C_0402_1005Metric; MPN X7R 16V 4.7uF
C13: 1uF; C_0402_1005Metric; MPN X7R 16V 1uF
C14, C15: 6pF; C_0402_1005Metric; MPN X7R 16V 6pF
J2: SWD TC2030; Tag-Connect_TC2030-IDC-NL_2x03_P1.27mm_Vertical; MPN SWD TC2030
J3: MOUNT switch; JST_SH_SM02B-SRSS-TB_1x02-1MP_P1.00mm_Horizontal; MPN MOUNT switch
R7, R8: 10k; R_0402_1005Metric; MPN 1% thick film 10k
R9: 100k; R_0402_1005Metric; MPN 1% thick film 100k
R10: 0R; R_0402_1005Metric; MPN 1% thick film 0R
U2: MB85RS64V; SOIC-8_3.9x4.9mm_P1.27mm; MPN MB85RS64V
U10: STM32WLE5CCU6; QFN-48-1EP_7x7mm_P0.5mm_EP5.6x5.6mm; MPN STM32WLE5CCU6
Y1: 32MHz CL=10pF; Crystal_SMD_3225-4Pin_3.2x2.5mm; MPN 32MHz CL=10pF
Y2: 32.768kHz CL=6pF; Crystal_SMD_3215-2Pin_3.2x1.5mm; MPN 32.768kHz CL=6pF

Connections:
BAT_ADC: U10.9 (PA2); also elsewhere on the board
BOOT0: R7.1, U10.19 (PH3)
CT_ADC: U10.7 (PA0); also elsewhere on the board
DIV_EN: U10.2 (PB4); also elsewhere on the board
FRAM_CS: U2.1 (~CS), U10.12 (PA4); also elsewhere on the board
GND: C4.2, C5.2, C6.2, C7.2, C8.2, C9.2, C10.2, C11.2, C12.2, C13.2, C14.2, C15.2, J2.3, J3.2, R7.2, U2.4 (GND), U10.48 (VSSSMPS), U10.49 (VSS), Y1.2 (G), Y1.4 (G); also elsewhere on the board
HSE_IN: U10.26 (OSC_IN), Y1.1
HSE_OUT: U10.27 (OSC_OUT), Y1.3
I2C_SCL: U10.4 (PB6); also elsewhere on the board
I2C_SDA: U10.5 (PB7); also elsewhere on the board
LOAD_EN: U10.3 (PB5); also elsewhere on the board
LSE_IN: C14.1, U10.39 (PC14), Y2.1
LSE_OUT: C15.1, U10.40 (PC15), Y2.2
MOUNT_N: J3.1, R9.1, U10.1 (PB3)
NRST: C4.1, J2.5, R8.1, U10.18 (NRST)
PHASE: U10.16 (PA8); also elsewhere on the board
RFI_N: U10.21 (RFI_N); also elsewhere on the board
RFI_P: U10.20 (RFI_P); also elsewhere on the board
RFO_LP: U10.22 (RFO_LP); also elsewhere on the board
RF_CTRL: U10.30 (PB0); also elsewhere on the board
RF_CTRL_N: U10.32 (PB12); also elsewhere on the board
SPI_MISO: U2.2 (SO), U10.14 (PA6)
SPI_MOSI: U2.5 (SI), U10.15 (PA7)
SPI_SCK: U2.6 (SCK), U10.13 (PA5)
SWCLK: J2.4, U10.42 (PA14)
SWDIO: J2.2, U10.36 (PA13)
V1V55: C10.1, C11.1, U10.25 (VDDPA), U10.29 (VDDRF1V55), U10.45 (VFBSMPS)
V3V0: C5.1, C6.1, C7.1, C8.1, C9.1, J2.1, R8.2, R9.2, R10.2, U2.3 (~WP), U2.7 (~HOLD), U2.8 (VDD), U10.11 (VDD), U10.28 (VDDRF), U10.37 (VBAT), U10.44 (VDD), U10.46 (VDDSMPS); also elsewhere on the board
VDDA: C12.1, C13.1, R10.1, U10.41 (VDDA)
VR_PA: U10.24 (VR_PA); also elsewhere on the board

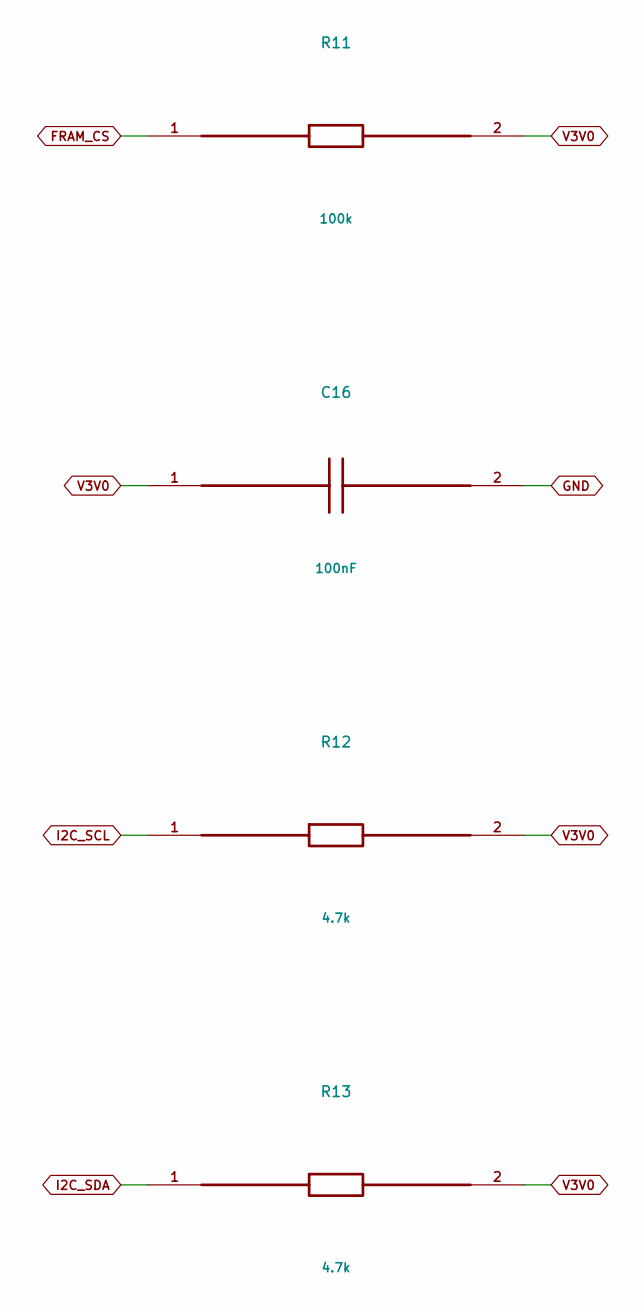
[picture p99: schematic 03.kicad_sch, PANOGOZ-TC-B1 / MCU]

Parts:
C16: 100nF; C_0402_1005Metric; MPN X7R 16V 100nF
R11: 100k; R_0402_1005Metric; MPN 1% thick film 100k
R12, R13: 4.7k; R_0402_1005Metric; MPN 1% thick film 4.7k

Connections:
FRAM_CS: R11.1; also elsewhere on the board
GND: C16.2; also elsewhere on the board
I2C_SCL: R12.1; also elsewhere on the board
I2C_SDA: R13.1; also elsewhere on the board
V3V0: C16.1, R11.2, R12.2, R13.2; also elsewhere on the board

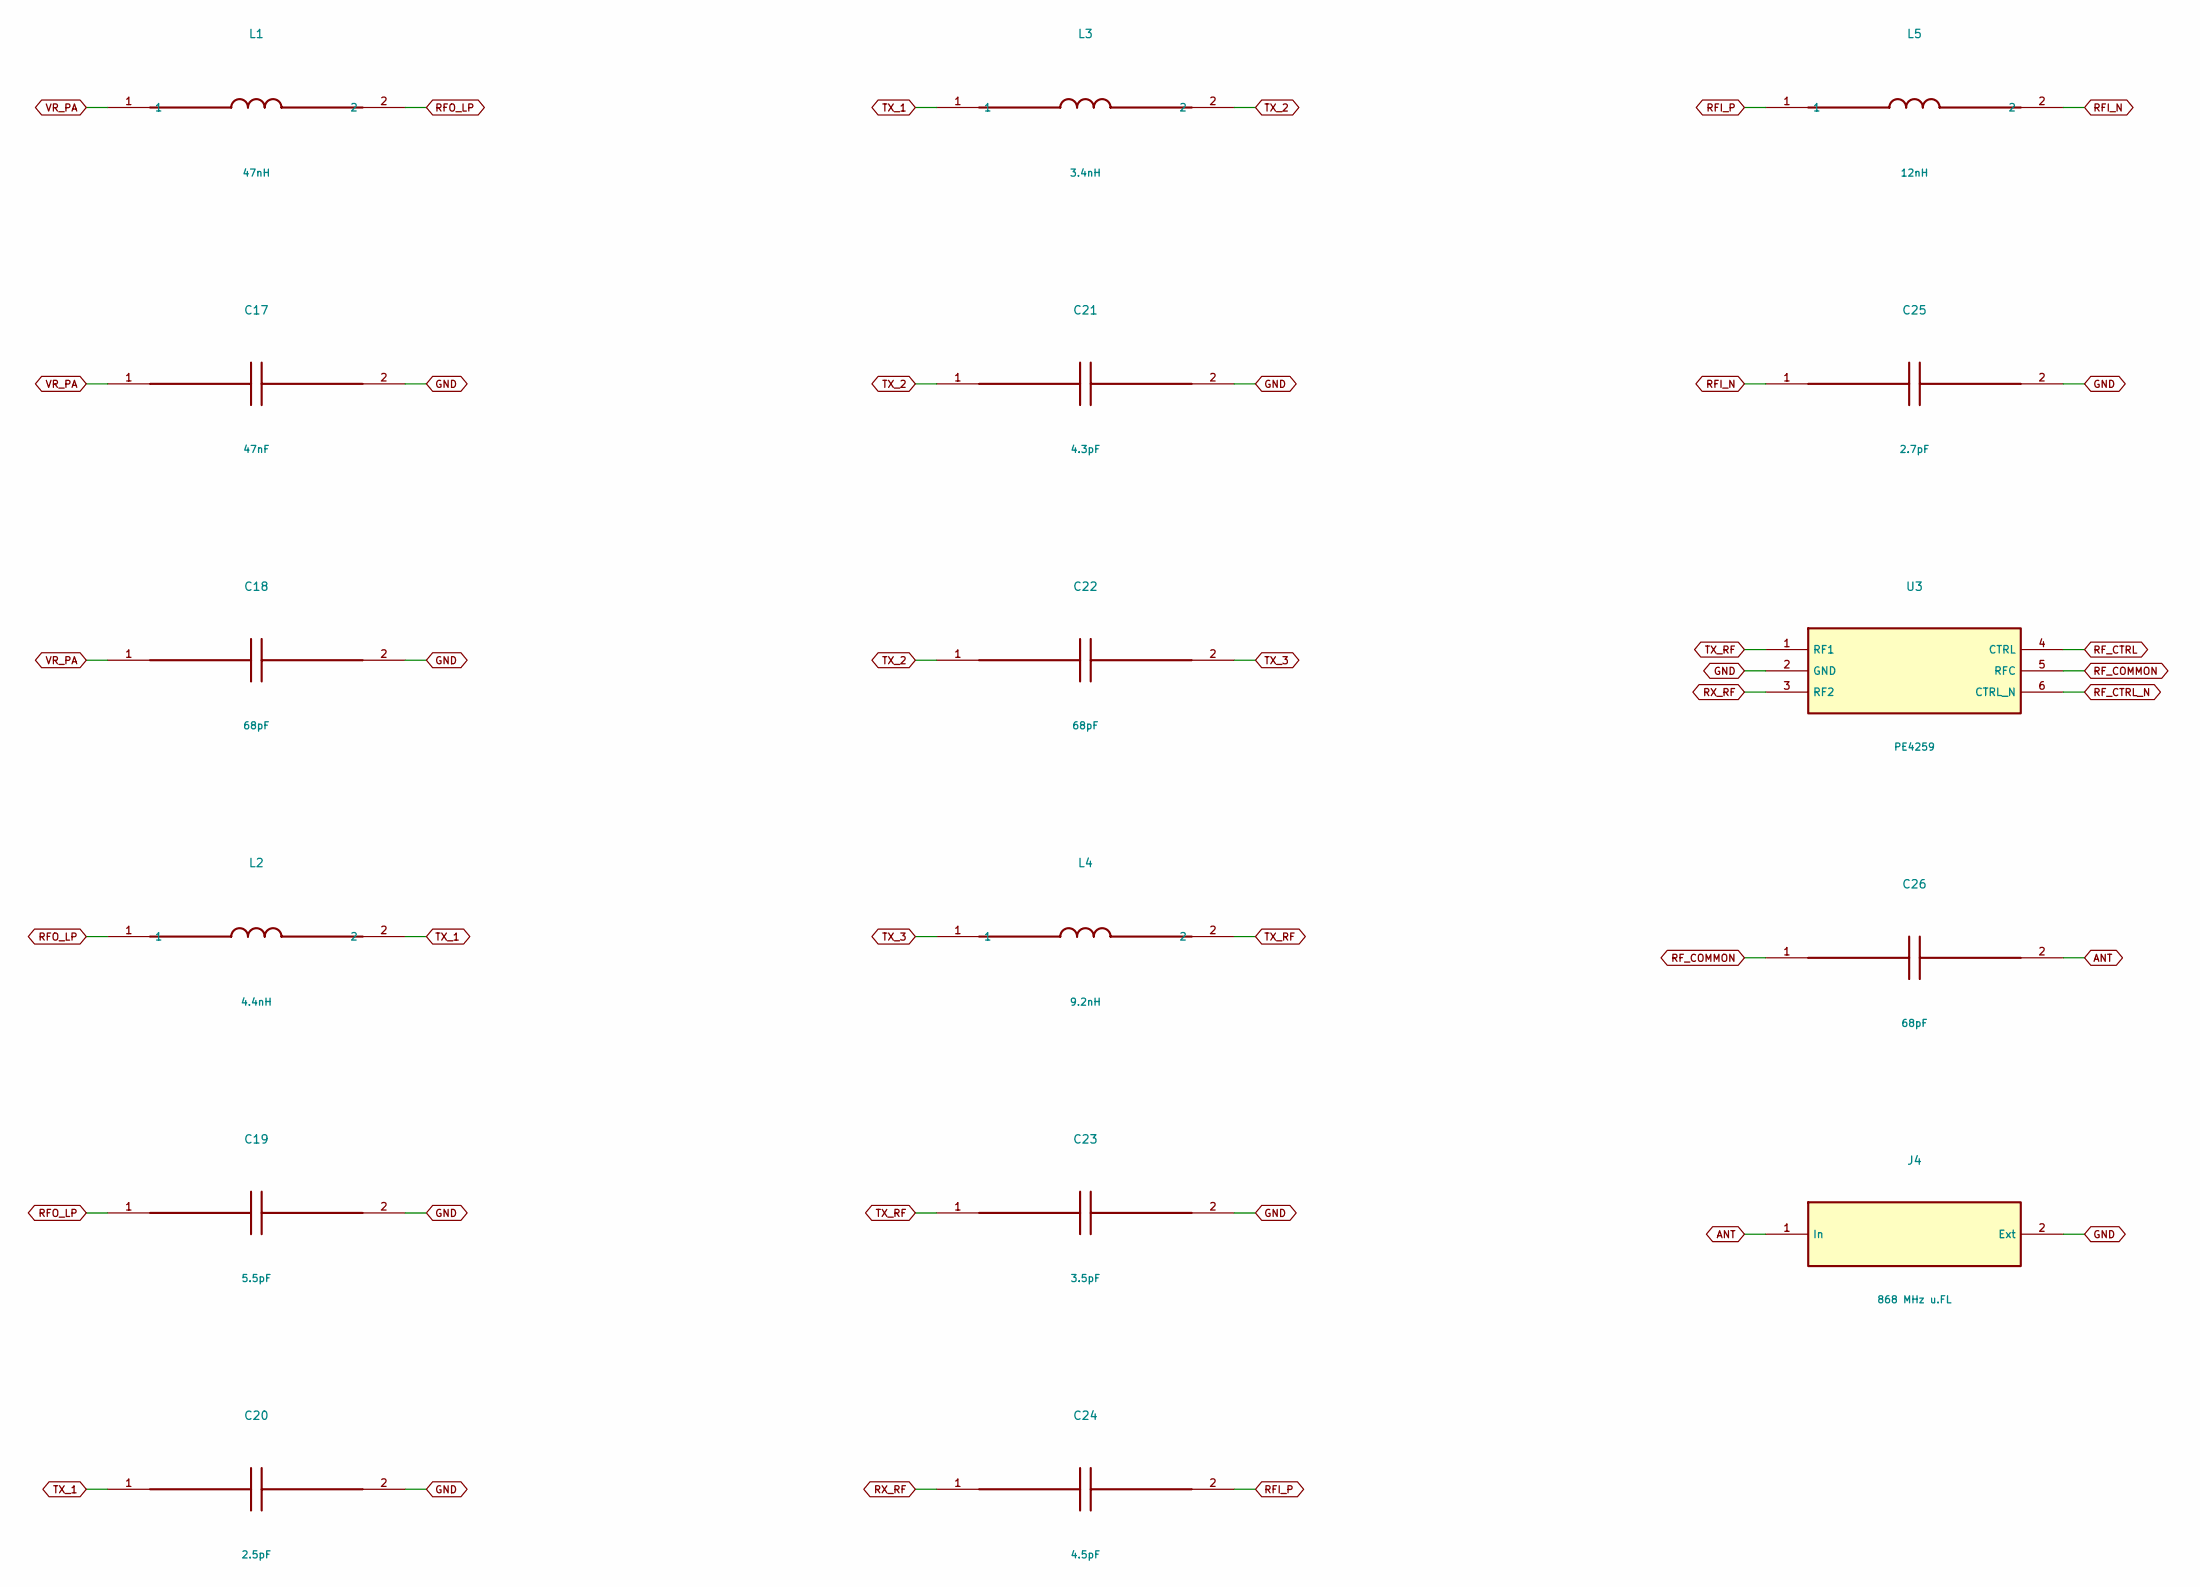
[picture p100: schematic 04.kicad_sch, PANOGOZ-TC-B1 / RADIO]

Parts:
C17: 47nF; C_0402_1005Metric; MPN X7R 16V 47nF
C18, C22, C26: 68pF; C_0402_1005Metric; MPN X7R 16V 68pF
C19: 5.5pF; C_0402_1005Metric; MPN X7R 16V 5.5pF
C20: 2.5pF; C_0402_1005Metric; MPN X7R 16V 2.5pF
C21: 4.3pF; C_0402_1005Metric; MPN X7R 16V 4.3pF
C23: 3.5pF; C_0402_1005Metric; MPN X7R 16V 3.5pF
C24: 4.5pF; C_0402_1005Metric; MPN X7R 16V 4.5pF
C25: 2.7pF; C_0402_1005Metric; MPN X7R 16V 2.7pF
J4: 868 MHz u.FL; U.FL_Hirose_U.FL-R-SMT-1_Vertical; MPN 868 MHz u.FL
L1: 47nH; L_0402_1005Metric; MPN 47nH
L2: 4.4nH; L_0402_1005Metric; MPN 4.4nH
L3: 3.4nH; L_0402_1005Metric; MPN 3.4nH
L4: 9.2nH; L_0402_1005Metric; MPN 9.2nH
L5: 12nH; L_0402_1005Metric; MPN 12nH
U3: PE4259; SOT-363_SC-70-6; MPN PE4259

Connections:
ANT: C26.2, J4.1 (In)
GND: C17.2, C18.2, C19.2, C20.2, C21.2, C23.2, C25.2, J4.2 (Ext), U3.2 (GND); also elsewhere on the board
RFI_N: C25.1, L5.2; also elsewhere on the board
RFI_P: C24.2, L5.1; also elsewhere on the board
RFO_LP: C19.1, L1.2, L2.1; also elsewhere on the board
RF_COMMON: C26.1, U3.5 (RFC)
RF_CTRL: U3.4 (CTRL); also elsewhere on the board
RF_CTRL_N: U3.6 (CTRL_N); also elsewhere on the board
RX_RF: C24.1, U3.3 (RF2)
TX_1: C20.1, L2.2, L3.1
TX_2: C21.1, C22.1, L3.2
TX_3: C22.2, L4.1
TX_RF: C23.1, L4.2, U3.1 (RF1)
VR_PA: C17.1, C18.1, L1.1; also elsewhere on the board
