hackathon-buke-team/grid-up/hardware/B1/TC/PANOGOZ-TC-B1.kicad_pcb

## KiCad design hardware/B1/TC/PANOGOZ-TC-B1.kicad_pcb (continued)

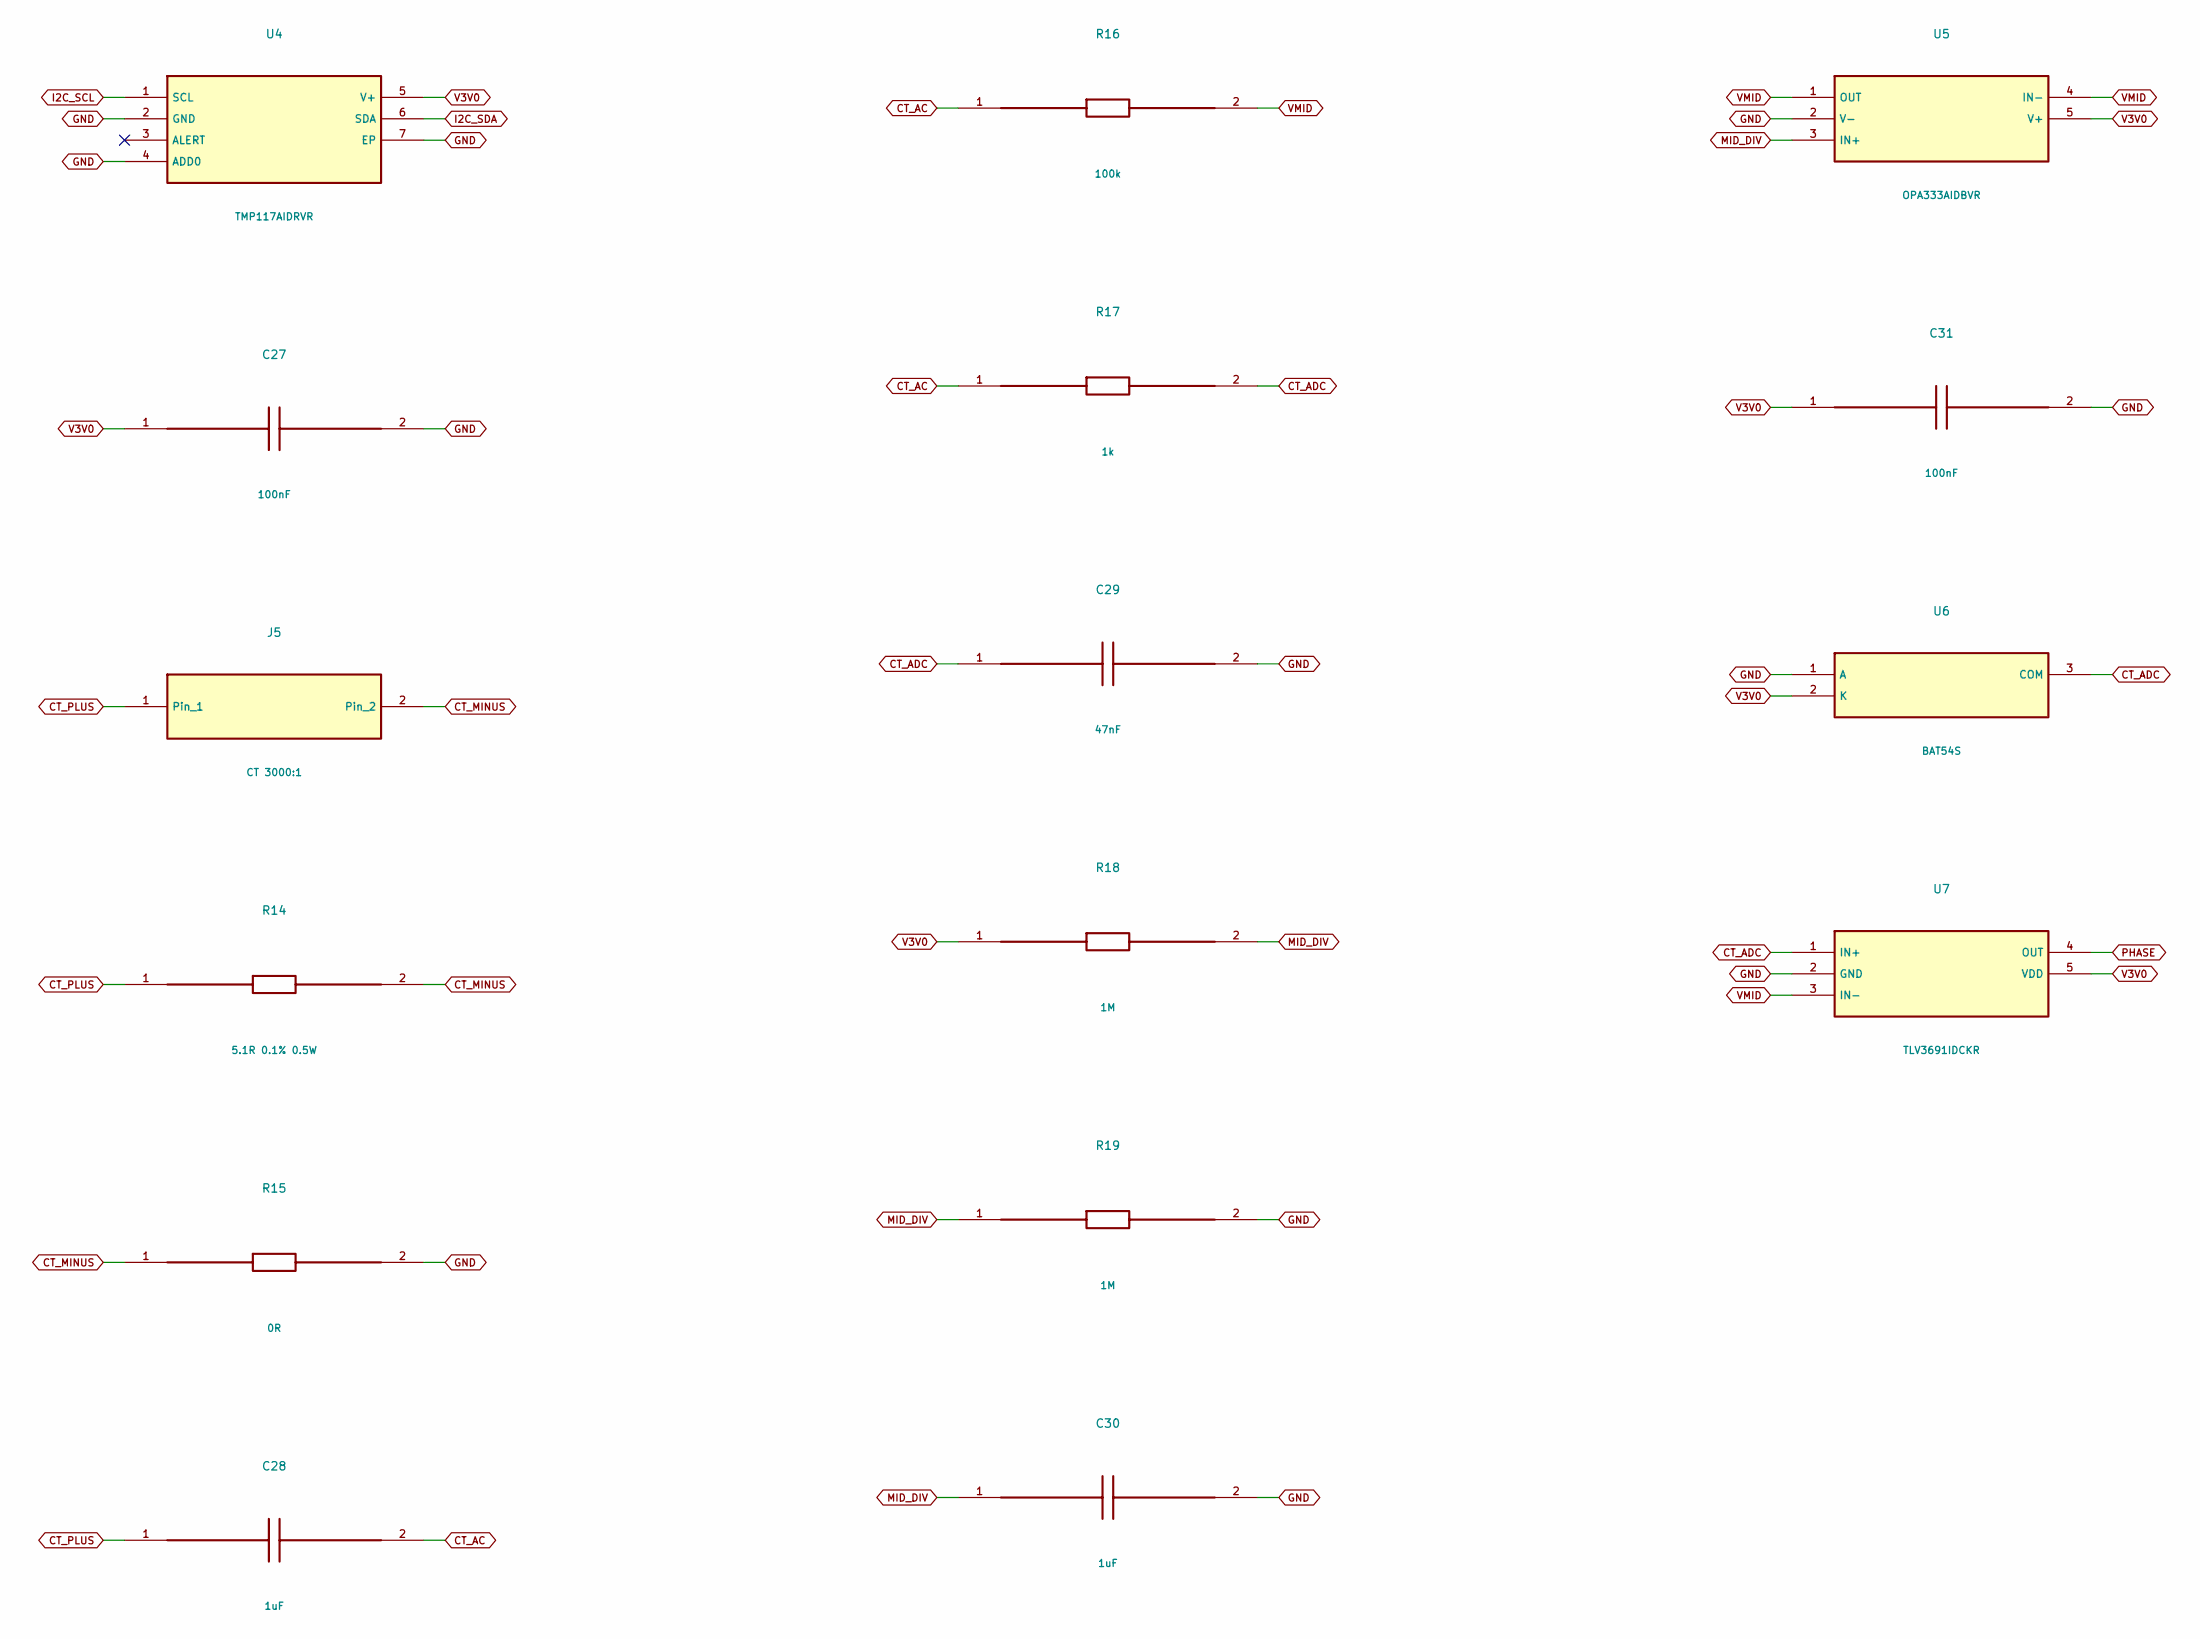
[picture p101: schematic 05.kicad_sch, PANOGOZ-TC-B1 / SENSORS]

Parts:
C27, C31: 100nF; C_0402_1005Metric; MPN X7R 16V 100nF
C28, C30: 1uF; C_0402_1005Metric; MPN X7R 16V 1uF
C29: 47nF; C_0402_1005Metric; MPN X7R 16V 47nF
J5: CT 3000:1; JST_SH_SM02B-SRSS-TB_1x02-1MP_P1.00mm_Horizontal; MPN CT 3000:1
R14: 5.1R 0.1% 0.5W; R_1210_3225Metric; MPN 1% thick film 5.1R 0.1% 0.5W
R15: 0R; R_0402_1005Metric; MPN 1% thick film 0R
R16: 100k; R_0402_1005Metric; MPN 1% thick film 100k
R17: 1k; R_0402_1005Metric; MPN 1% thick film 1k
R18, R19: 1M; R_0402_1005Metric; MPN 1% thick film 1M
U4: TMP117AIDRVR; WSON-6-1EP_2x2mm_P0.65mm_EP1x1.6mm; MPN TMP117AIDRVR
U5: OPA333AIDBVR; SOT-23-5; MPN OPA333AIDBVR
U6: BAT54S; SOT-23; MPN BAT54S
U7: TLV3691IDCKR; SOT-353_SC-70-5; MPN TLV3691IDCKR

Connections:
CT_AC: C28.2, R16.1, R17.1
CT_ADC: C29.1, R17.2, U6.3 (COM), U7.1 (IN+); also elsewhere on the board
CT_MINUS: J5.2, R14.2, R15.1
CT_PLUS: C28.1, J5.1, R14.1
GND: C27.2, C29.2, C30.2, C31.2, R15.2, R19.2, U4.2 (GND), U4.4 (ADD0), U4.7 (EP), U5.2 (V-), U6.1 (A), U7.2 (GND); also elsewhere on the board
I2C_SCL: U4.1 (SCL); also elsewhere on the board
I2C_SDA: U4.6 (SDA); also elsewhere on the board
MID_DIV: C30.1, R18.2, R19.1, U5.3 (IN+)
PHASE: U7.4 (OUT); also elsewhere on the board
V3V0: C27.1, C31.1, R18.1, U4.5 (V+), U5.5 (V+), U6.2 (K), U7.5 (VDD); also elsewhere on the board
VMID: R16.2, U5.1 (OUT), U5.4 (IN-), U7.3 (IN-)

Board: 4 copper layers, 73 parts (27 on the bottom side), 46 nets, no tracks yet.
