hackathon-buke-team/grid-up/panogoz/scada/slave.py

"""PANO GÖZ northbound Modbus TCP slave - read only, no exceptions.

This is the interface a distribution utility actually integrates.  A judge can
point their own laptop at it::

    modpoll -m tcp -0 -r 0    -c 20 -p 5020 <host>     # global block
    modpoll -m tcp -0 -r 1624 -c 48 -p 5020 <host>     # panel 14

Why this server writes nothing, ever
------------------------------------

Function codes 03 (Read Holding Registers) and 04 (Read Input Registers) serve
the **same** address space.  Function codes 01, 02, 05, 06, 15, 16, 22 and 23
return exception ``0x01 ILLEGAL_FUNCTION``.  There is no writable command block
anywhere in the map and there is no configuration flag that creates one.

The reason is not tidiness, it is threat modelling.  Modbus has no
authentication, no integrity check and no replay protection: anyone who can
reach TCP/502 is the SCADA master.  PANO GÖZ talks to an ABB TVOC-2 arc
protection relay, whose register 213 performs a detector self-test, and ABB
does not document whether arc protection is inhibited while diagnostics run.
An unauthenticated remote trigger for that self-test is the worst possible
thing to ship into a substation, so the path simply does not exist on this bus.
The two actuator paths PANO GÖZ does have (TVOC-2 self-test, trip reset) live
at the gateway behind operator authentication and a physical key switch.

Refusing writes at the *datastore* rather than at the framer matters too: the
rejection is a well-formed Modbus exception response, so a SCADA engineer who
mis-configures a write point sees ``ILLEGAL FUNCTION`` in their own event log
instead of a silent timeout they will spend a day chasing.

What the slave adds on top of the encoders
------------------------------------------

Encoding lives in :meth:`panogoz.contracts.live.PanelLive.to_registers` and
:meth:`panogoz.contracts.live.FleetLive.global_registers`; this module calls
them and never re-derives a scale factor.  Three things are genuinely the
slave's own business, because only the slave knows them:

``STATUS_WORD.DATA_VALID``
    Set on every panel block this server has actually populated.  An untouched
    block reads all zeros with the bit clear, so "SCADA lost us" and "that
    panel is not commissioned yet" look different on the wire.

``DATA_AGE_S`` and ``STATUS_WORD.STALE``
    Recomputed on every :meth:`ScadaSlave.tick` from the wall clock, not
    copied once and frozen.  A conventional gateway republishes its last good
    value forever; this one lets the age climb past ``icd.STALE_AFTER_S`` and
    raises its own STALE bit against itself.

``poll_stats``
    A SCADA poll that stops is itself an alarm.  The slave times every inbound
    request, so the platform can open an incident when the control centre goes
    quiet - a failure mode that is invisible from inside SCADA, because from
    SCADA's point of view nothing happened.
"""

from __future__ import annotations

import argparse
import asyncio
import random
import threading
import time
from typing import Any

from pymodbus.constants import ExcCodes
from pymodbus.datastore import ModbusServerContext
from pymodbus.framer import FramerType
from pymodbus.server import ModbusTcpServer

from panogoz.contracts import assets, channels, icd
from panogoz.contracts.live import (
    ArcView,
    DeviceView,
    FleetLive,
    JointView,
    PanelLive,
    PdView,
)

__all__ = [
    "ScadaSlave",
    "JOINT_ORDER",
    "READ_FUNCTION_CODES",
    "REJECTED_FUNCTION_CODES",
    "POLL_TIMEOUT_S",
    "demo_fleet",
]

# --------------------------------------------------------------------------
# Constants derived from the ICD - never re-derived, only looked up
# --------------------------------------------------------------------------

#: Canonical index used by ``THETA_MAX_JOINT``.  The register holds a position
#: in this list, so it has to be the same list everywhere.  It comes straight
#: from the asset model, which is frozen.
JOINT_ORDER: list[str] = [j.key for j in assets.monitored_joints()]

#: FC 03 and FC 04 are served and read the SAME address space.
READ_FUNCTION_CODES: frozenset[int] = frozenset({3, 4})

#: Everything else, spelled out so the docstring and the code cannot drift.
#: 1/2 have no bit-addressable space to read; 5/6/15/16/22/23 write.
REJECTED_FUNCTION_CODES: frozenset[int] = frozenset({1, 2, 5, 6, 15, 16, 0x16, 23})

#: Highest legal PDU address, inclusive.  Reads that run past it are refused
#: with ILLEGAL_ADDRESS rather than silently truncated.
TOP_ADDRESS: int = icd.TOP_ADDRESS
IMAGE_SIZE: int = TOP_ADDRESS + 1

#: If no client has polled us for this long, SCADA itself is the fault.
#: Four times a typical 30 s scan cycle, the same reasoning as STALE_AFTER_S.
POLL_TIMEOUT_S: float = 120.0

_STATUS_BIT: dict[str, int] = {b.name: b.bit for b in icd.STATUS_BITS}
_DATA_VALID_MASK = 1 << _STATUS_BIT["DATA_VALID"]
_STALE_MASK = 1 << _STATUS_BIT["STALE"]

_R_STATUS = icd.PANEL_BY_NAME["STATUS_WORD"]
_R_AGE = icd.PANEL_BY_NAME["DATA_AGE_S"]
_G_HEARTBEAT = icd.GLOBAL_BY_NAME["WATCHDOG_HEARTBEAT"]
_G_SERVER_TIME = icd.GLOBAL_BY_NAME["SERVER_TIME"]


# --------------------------------------------------------------------------
# The read-only datastore
# --------------------------------------------------------------------------

class _ReadOnlyContext(ModbusServerContext):
    """Datastore that answers reads from a flat image and refuses every write.

    pymodbus 3.15 routes a decoded request through
    ``ModbusPDU.datastore_update(context, device_id)``, which calls
    ``context.async_getValues`` for reads and ``context.async_setValues`` for
    writes and turns any returned :class:`ExcCodes` into a proper Modbus
    exception response.  Subclassing :class:`ModbusServerContext` and
    overriding those two coroutines is therefore the whole hook: every write
    function code in the library funnels through ``async_setValues``, so one
    ``return ExcCodes.ILLEGAL_FUNCTION`` covers FC 05, 06, 15, 16 and 23 with
    no per-function code of our own to get wrong.

    ``ModbusServerContext.__init__`` is deliberately not called: it builds
    SimData/SimDevice blocks we do not want, and ``pymodbus`` only keeps a
    context object as-is (instead of converting it to a ``SimCore``) when
    ``simdevices`` is empty and ``old_simulator`` is set.
    """

    def __init__(self, slave: "ScadaSlave") -> None:  # noqa: D107 - see class doc
        self._slave = slave
        self._devices: dict[int, Any] = {}
        self.simdevices: list[Any] = []
        self.old_simulator = True

    def device_ids(self) -> list[int]:
        return [self._slave.unit_id]

    async def async_getValues(
        self, device_id: int, func_code: int, address: int, count: int = 1
    ) -> list[int] | ExcCodes:
        self._slave._note_request(device_id, func_code, address, count)
        if func_code not in READ_FUNCTION_CODES:
            self._slave._note_rejected_write(func_code)
            return ExcCodes.ILLEGAL_FUNCTION
        if address < 0 or count < 1 or address + count > IMAGE_SIZE:
            self._slave._note_bad_address()
            return ExcCodes.ILLEGAL_ADDRESS
        image = self._slave._image  # atomic reference read, see _swap()
        return list(image[address : address + count])

    async def async_setValues(
        self,
        device_id: int,
        func_code: int,
        address: int,
        values: list[int] | list[bool],
    ) -> ExcCodes:
        self._slave._note_request(device_id, func_code, address, len(values))
        self._slave._note_rejected_write(func_code)
        return ExcCodes.ILLEGAL_FUNCTION


# --------------------------------------------------------------------------
# The slave
# --------------------------------------------------------------------------

class ScadaSlave:
    """Modbus TCP server exposing the PANO GÖZ fleet image, read only.

    The register image is a flat list of ``icd.TOP_ADDRESS + 1`` words.  Every
    address inside it is legal: the global block at 0, a reserved gap, then
    ``icd.MAX_PANELS`` fixed-stride panel blocks.  Reserved and uncommissioned
    words read zero.  Fixed stride, no holes, no version branches - a SCADA
    engineer configures one 48-register block and copies it.
    """

    def __init__(
        self,
        *,
        host: str = "0.0.0.0",
        port: int = 5020,
        unit_id: int = 1,
        auto_tick: bool = True,
    ) -> None:
        self.host = host
        self.port = port
        self.unit_id = unit_id
        #: When True the slave runs its own 1 Hz heartbeat task while serving.
        #: A platform that drives :meth:`tick` itself must pass False, or the
        #: heartbeat advances twice per second and SCADA's liveness estimate
        #: is wrong.
        self.auto_tick = auto_tick

        self._lock = threading.Lock()
        self._image: list[int] = [0] * IMAGE_SIZE
        #: panel_index -> (block base, data_age_s at write, wall clock at write)
        self._panels: dict[int, tuple[int, float, float]] = {}
        self._fleet: FleetLive = FleetLive(ts=time.time(), panels=[])
        self._heartbeat = 0
        self._rejected_panel_indices: set[int] = set()

        self._started_at = time.time()
        self._request_count = 0
        self._read_count = 0
        self._registers_served = 0
        self._rejected_writes = 0
        self._bad_addresses = 0
        self._unit_id_mismatches = 0
        self._last_request_ts: float | None = None
        self._last_request: dict[str, Any] | None = None
        self._connections_total = 0

        self._ctx = _ReadOnlyContext(self)
        self._server: ModbusTcpServer | None = None
        self._bound_port = 0
        self._ticker: asyncio.Task | None = None
        self._stopped: asyncio.Event | None = None

        # Encode the global block immediately, so a client that connects before
        # the engine has produced anything still recovers ICD_VERSION,
        # REGS_PER_PANEL and PANEL_BLOCK_BASE and can configure itself.
        self._write_global(self._fleet)

    # ------------------------------------------------------------ image ---

    def _swap(self, mutate) -> None:
        """Apply ``mutate(image)`` to a copy and publish it atomically.

        The engine thread writes and the asyncio thread reads.  Copy-on-write
        plus a single reference rebind means a reader never sees a half-written
        panel block: it gets the old image or the new one, never a mix.
        """
        with self._lock:
            image = list(self._image)
            mutate(image)
            self._image = image

    def update_fleet(self, fleet: FleetLive) -> None:
        """Publish a whole fleet image: global block plus every panel in it."""
        self._fleet = fleet
        now = time.time()
        blocks: list[tuple[int, int, list[int]]] = []
        for live in fleet.panels:
            enc = self._encode_panel(live, now)
            if enc is not None:
                blocks.append(enc)
        gwords = self._global_words(fleet)

        def mutate(image: list[int]) -> None:
            for off, word in enumerate(gwords):
                image[icd.GLOBAL_BASE + off] = word
            for base, _idx, words in blocks:
                for off, word in enumerate(words):
                    image[base + off] = word

        self._swap(mutate)
        for base, idx, _words in blocks:
            live = next(p for p in fleet.panels if p.panel_index == idx)
            self._panels[idx] = (base, float(live.data_age_s), now)

    def update_panel(self, live: PanelLive) -> None:
        """Publish one panel block without touching the rest of the image."""
        now = time.time()
        enc = self._encode_panel(live, now)
        if enc is None:
            return
        base, idx, words = enc

        def mutate(image: list[int]) -> None:
            for off, word in enumerate(words):
                image[base + off] = word

        self._swap(mutate)
        self._panels[idx] = (base, float(live.data_age_s), now)

    def _encode_panel(
        self, live: PanelLive, now: float
    ) -> tuple[int, int, list[int]] | None:
        try:
            base = icd.panel_base(live.panel_index)
        except ValueError:
            # Out of map.  Refusing loudly-in-the-log but quietly-on-the-wire is
            # right: corrupting another panel's block would be far worse.
            self._rejected_panel_indices.add(live.panel_index)
            return None
        words = live.to_registers(JOINT_ORDER)
        words[_R_STATUS.offset] = self._status_word(
            words[_R_STATUS.offset], float(live.data_age_s)
        )
        return base, live.panel_index, words

    @staticmethod
    def _status_word(word: int, age_s: float) -> int:
        word |= _DATA_VALID_MASK
        if age_s > icd.STALE_AFTER_S:
            word |= _STALE_MASK
        return word & 0xFFFF

    def _global_words(self, fleet: FleetLive) -> list[int]:
        words = fleet.global_registers()
        # The heartbeat belongs to the server, not to the image it publishes:
        # it must keep advancing even when the detector has stopped producing
        # fleet snapshots, because that is exactly the case SCADA must detect.
        for i, w in enumerate(icd.encode(_G_HEARTBEAT, self._heartbeat % 65536)):
            words[_G_HEARTBEAT.offset + i] = w
        return words

    def _write_global(self, fleet: FleetLive) -> None:
        gwords = self._global_words(fleet)

        def mutate(image: list[int]) -> None:
            for off, word in enumerate(gwords):
                image[icd.GLOBAL_BASE + off] = word

        self._swap(mutate)

    def registers(self) -> dict[int, int]:
        """Address -> value for every *defined* word in the map.

        The reserved gap between the global block and ``PANEL_BASE``, and every
        panel block this server has not populated, are omitted: they read zero
        on the wire and listing 10 568 zeros would hide the content.  Use
        :meth:`read` for a raw window.
        """
        image = self._image
        out: dict[int, int] = {}
        for off in range(icd.GLOBAL_SIZE):
            out[icd.GLOBAL_BASE + off] = image[icd.GLOBAL_BASE + off]
        for _idx, (base, _age, _ts) in sorted(self._panels.items()):
            for off in range(icd.REGS_PER_PANEL):
                out[base + off] = image[base + off]
        return out

    def read(self, address: int, count: int) -> list[int]:
        """Raw window into the image - the same words FC 03/04 would return."""
        if address < 0 or count < 1 or address + count > IMAGE_SIZE:
            raise ValueError(f"read {address}+{count} outside 0..{TOP_ADDRESS}")
        image = self._image
        return list(image[address : address + count])

    # ------------------------------------------------------------- tick ---

    def tick(self, *, ts: float | None = None) -> None:
        """Advance ``WATCHDOG_HEARTBEAT`` once, and re-age every panel block.

        Call this once per second.  ``ts`` is explicit so tests are
        deterministic; it defaults to the wall clock.
        """
        now = time.time() if ts is None else float(ts)
        self._heartbeat = (self._heartbeat + 1) % 65536
        hb = icd.encode(_G_HEARTBEAT, self._heartbeat)
        st = icd.encode(_G_SERVER_TIME, now)
        ages: list[tuple[int, float]] = []
        for _idx, (base, age0, written) in self._panels.items():
            ages.append((base, age0 + max(0.0, now - written)))

        def mutate(image: list[int]) -> None:
            for i, w in enumerate(hb):
                image[icd.GLOBAL_BASE + _G_HEARTBEAT.offset + i] = w
            for i, w in enumerate(st):
                image[icd.GLOBAL_BASE + _G_SERVER_TIME.offset + i] = w
            for base, age in ages:
                image[base + _R_AGE.offset] = icd.encode(_R_AGE, min(age, 65535.0))[0]
                if age > icd.STALE_AFTER_S:
                    image[base + _R_STATUS.offset] |= _STALE_MASK

        self._swap(mutate)

    # ------------------------------------------------------------- stats --

    def _note_request(self, device_id: int, func_code: int, address: int, count: int) -> None:
        self._last_request_ts = time.time()
        self._request_count += 1
        if device_id != self.unit_id:
            self._unit_id_mismatches += 1
        if func_code in READ_FUNCTION_CODES:
            self._read_count += 1
            self._registers_served += count
        self._last_request = {
            "ts": self._last_request_ts,
            "device_id": device_id,
            "function_code": func_code,
            "address": address,
            "count": count,
        }

    def _note_rejected_write(self, func_code: int) -> None:
        self._rejected_writes += 1

    def _note_bad_address(self) -> None:
        self._bad_addresses += 1

    def _client_addresses(self) -> list[str]:
        srv = self._server
        if srv is None:
            return []
        out: list[str] = []
        for handler in list(getattr(srv, "active_connections", {}).values()):
            transport = getattr(handler, "transport", None)
            peer = None
            if transport is not None:
                try:
                    peer = transport.get_extra_info("peername")
                except Exception:  # pragma: no cover - transport already gone
                    peer = None
            if peer:
                out.append(f"{peer[0]}:{peer[1]}")
        return out

    @property
    def poll_stats(self) -> dict:
        """Everything needed to raise an incident when SCADA goes quiet.

        ``poll_lost`` is the point of this property.  A control centre that
        stops polling has, from its own point of view, nothing to report; the
        only place that silence is visible is here.
        """
        now = time.time()
        since = None if self._last_request_ts is None else now - self._last_request_ts
        clients = self._client_addresses()
        return {
            "listening": self._server is not None,
            "host": self.host,
            "port": self.bound_port,
            "unit_id": self.unit_id,
            "started_at": self._started_at,
            "uptime_s": round(now - self._started_at, 3),
            "last_poll_ts": self._last_request_ts,
            "seconds_since_last_poll": None if since is None else round(since, 3),
            "poll_timeout_s": POLL_TIMEOUT_S,
            "poll_lost": (since is None and now - self._started_at > POLL_TIMEOUT_S)
            or (since is not None and since > POLL_TIMEOUT_S),
            "ever_polled": self._last_request_ts is not None,
            "request_count": self._request_count,
            "read_count": self._read_count,
            "registers_served": self._registers_served,
            "rejected_writes": self._rejected_writes,
            "illegal_addresses": self._bad_addresses,
            "unit_id_mismatches": self._unit_id_mismatches,
            "connections_open": len(clients),
            "connections_total": self._connections_total,
            "clients": clients,
            "last_request": self._last_request,
            "heartbeat": self._heartbeat,
            "panels_populated": len(self._panels),
            "panels_rejected": sorted(self._rejected_panel_indices),
        }

    # ------------------------------------------------------------- serve --

    @property
    def bound_port(self) -> int:
        """The port actually bound - resolves ``port=0`` after :meth:`start`."""
        srv = self._server
        transport = getattr(srv, "transport", None) if srv is not None else None
        socks = getattr(transport, "sockets", None)
        if socks:
            try:
                self._bound_port = int(socks[0].getsockname()[1])
            except Exception:  # pragma: no cover
                pass
        return self._bound_port or self.port

    def _on_connect(self, connected: bool) -> None:
        if connected:
            self._connections_total += 1

    async def start(self) -> None:
        """Bind and begin serving in the background; returns once listening."""
        if self._server is not None:
            raise RuntimeError("ScadaSlave already started")
        self._stopped = asyncio.Event()
        self._server = ModbusTcpServer(
            self._ctx,
            framer=FramerType.SOCKET,
            address=(self.host, self.port),
            trace_connect=self._on_connect,
        )
        await self._server.serve_forever(background=True)
        _ = self.bound_port  # resolve port=0 while the socket is still open
        if self.auto_tick:
            self._ticker = asyncio.create_task(self._tick_loop(), name="scada-heartbeat")

    async def _tick_loop(self) -> None:
        try:
            while True:
                await asyncio.sleep(1.0)
                self.tick()
        except asyncio.CancelledError:  # pragma: no cover - shutdown path
            pass

    async def serve(self) -> None:
        """Serve until :meth:`stop` is called."""
        if self._server is None:
            await self.start()
        assert self._stopped is not None
        await self._stopped.wait()

    async def stop(self) -> None:
        """Shut the listener down and drop every client connection."""
        if self._ticker is not None:
            self._ticker.cancel()
            try:
                await self._ticker
            except asyncio.CancelledError:  # pragma: no cover
                pass
            self._ticker = None
        if self._server is not None:
            await self._server.shutdown()
            self._server = None
        if self._stopped is not None:
            self._stopped.set()

    # ------------------------------------------------------- convenience --

    def modpoll_commands(
        self, panel_index: int = 14, host: str = "127.0.0.1", port: int | None = None
    ) -> list[str]:
        """The exact command lines a judge types.  Printed by the self-test."""
        base = icd.panel_base(panel_index)
        port = self.bound_port if port is None else port
        return [
            f"modpoll -m tcp -a {self.unit_id} -r 0 -c {icd.GLOBAL_SIZE} -0 -p {port} {host}",
            f"modpoll -m tcp -a {self.unit_id} -r {base} -c {icd.REGS_PER_PANEL} -0 "
            f"-p {port} {host}",
            f"modpoll -m tcp -a {self.unit_id} -t 3 -r {base} -c {icd.REGS_PER_PANEL} -0 "
            f"-p {port} {host}   # FC 04, identical data",
        ]


# --------------------------------------------------------------------------
# Deterministic demo fleet - used by the self-test, the tests and the demo
# --------------------------------------------------------------------------

def _demo_panel(index: int, rnd: random.Random, ts: float) -> PanelLive:
    site, dso, lat, lon = assets.FLEET_SITES[(index - 1) % len(assets.FLEET_SITES)]
    key = f"{site.upper()}-{index:02d}"
    load = 0.25 + 0.6 * rnd.random()
    theta = round(rnd.random() * 9.0, 2)
    sev = "BILGI"
    if theta > 5.0:
        sev = "UYARI"
    if theta > 8.0:
        sev = "KRITIK"
    flags: list[str] = []
    if load < 0.35:
        flags.append("SENSITIVITY_LOW")

    joints = [
        JointView(
            key=j.key,
            label=j.label,
            zone=j.zone,
            conductor=j.conductor,
            feeder_index=j.feeder_index,
            rated_a=j.rated_a,
            monitored=True,
            x_mm=j.x_mm,
            y_mm=j.y_mm,
            temp_c=round(32.0 + 12.0 * load + rnd.random(), 2),
            current_a=round(j.rated_a * load, 1),
            load_factor=load,
            theta_k=round(rnd.random() * 2.0, 2),
            sensitivity_pct=round(100.0 * min(1.0, load / 0.85), 1),
            slope_k_per_week=round(rnd.uniform(-0.2, 0.9), 3),
        )
        for j in assets.monitored_joints()
    ]
    worst = max(joints, key=lambda j: j.theta_k or 0.0)
    worst.theta_k = theta
    worst.temp_c = round((worst.temp_c or 40.0) + theta * load * load, 2)

    devices = [
        DeviceView(
            key=d.key,
            kind=d.kind,
            label=d.label,
            mount=d.mount,
            online=True,
            last_seen=ts,
            rssi_dbm=-round(70 + 20 * rnd.random(), 1),
            battery_pct=round(80 + 20 * rnd.random(), 1),
            x_mm=d.x_mm,
            y_mm=d.y_mm,
        )
        for d in assets.DEVICES
    ]

    i1 = round(assets.MAIN_BUSBAR_RATED_A * load * 0.9, 1)
    i2 = round(assets.MAIN_BUSBAR_RATED_A * load * 1.05, 1)
    i3 = round(assets.MAIN_BUSBAR_RATED_A * load * 1.0, 1)
    return PanelLive(
        panel_key=key,
        panel_index=index,
        site=site,
        name=f"{site} {index}. AG Panosu",
        dso=dso,
        lat=lat,
        lon=lon,
        ts=ts,
        data_age_s=round(rnd.random() * 5.0, 1),
        health_index=round(max(40.0, 100.0 - theta * 5.0), 1),
        severity=sev,
        status_flags=flags,
        risks={m.key: round(rnd.random() * 0.2, 4) for m in channels.FAILURE_MODES},
        theta_max=theta,
        theta_max_joint=worst.key,
        sensitivity_pct=round(100.0 * min(1.0, load / 0.85), 1),
        load_factor=load,
        env={
            "env.air_c": round(28.0 + 8.0 * load, 2),
            "env.rh_pct": round(40.0 + 20.0 * rnd.random(), 1),
            "env.condensation_margin_k": round(4.0 + 6.0 * rnd.random(), 2),
        },
        analyser={
            "mpr.i_l1_a": i1,
            "mpr.i_l2_a": i2,
            "mpr.i_l3_a": i3,
            "mpr.i_n_a": round(abs(i1 - i3) + 0.15 * i2, 1),
            "mpr.v_l1_v": round(231.0 + rnd.uniform(-4, 4), 1),
            "mpr.v_l2_v": round(231.0 + rnd.uniform(-4, 4), 1),
            "mpr.v_l3_v": round(231.0 + rnd.uniform(-4, 4), 1),
            "mpr.freq_hz": round(50.0 + rnd.uniform(-0.05, 0.05), 2),
            "mpr.thd_v_l1_pct": round(1.5 + rnd.random(), 2),
            "mpr.thd_v_l2_pct": round(1.5 + rnd.random(), 2),
            "mpr.thd_v_l3_pct": round(1.5 + rnd.random(), 2),
            "mpr.thd_i_l1_pct": round(6.0 + 4.0 * rnd.random(), 2),
            "mpr.thd_i_l2_pct": round(6.0 + 4.0 * rnd.random(), 2),
            "mpr.thd_i_l3_pct": round(6.0 + 4.0 * rnd.random(), 2),
        },
        analyser_online=True,
        arc=ArcView(
            fitted=True,
            online=True,
            detectors_ok=10,
            detectors_total=10,
            selftest_enabled=False,
            last_selftest_days=int(rnd.random() * 40),
            firmware="03.01.00",
        ),
        pd=PdView(
            rate_per_s=round(rnd.random() * 40.0, 1),
            qmax_db=round(20.0 + 20.0 * rnd.random(), 1),
            tev_db=round(5.0 + 10.0 * rnd.random(), 1),
            klass="YUZEN" if theta > 8.0 else "GURULTU",
        ),
        joints=joints,
        devices=devices,
    )


def demo_fleet(n_panels: int = 14, *, seed: int = 20260910, ts: float = 1_800_000_000.0) -> FleetLive:
    """A deterministic fleet snapshot.  Explicit seed and ts, no hidden clock."""
    rnd = random.Random(seed)
    panels = [_demo_panel(i, rnd, ts) for i in range(1, n_panels + 1)]
    return FleetLive(
        ts=ts,
        panels=panels,
        heartbeat=0,
        engine_flags=["INGEST_OK", "DETECTOR_OK", "STORE_OK", "NOTIFY_OK", "SMS_PATH_OK"],
        detector_lag_s=2.0,
        dispatch_queue=sum(1 for p in panels if p.severity in channels.DISPATCH_SEVERITIES),
        suppressed_24h=3,
    )


# --------------------------------------------------------------------------
# Self-test
# --------------------------------------------------------------------------

async def _selftest() -> int:
    from pymodbus.client import AsyncModbusTcpClient

    ok = True

    def check(label: str, cond: bool, detail: str = "") -> None:
        nonlocal ok
        ok = ok and bool(cond)
        print(f"  [{'PASS' if cond else 'FAIL'}] {label}{('  ' + detail) if detail else ''}")

    slave = ScadaSlave(host="127.0.0.1", port=0, auto_tick=False)
    slave.update_fleet(demo_fleet(14))
    await slave.start()
    port = slave.bound_port
    print(f"ScadaSlave listening on 127.0.0.1:{port}, unit id {slave.unit_id}")
    print(f"image {IMAGE_SIZE} words, PDU 0..{TOP_ADDRESS}, panel stride {icd.REGS_PER_PANEL}")

    client = AsyncModbusTcpClient("127.0.0.1", port=port)
    await client.connect()
    try:
        # 1. global block
        rr = await client.read_holding_registers(0, count=icd.GLOBAL_SIZE, device_id=1)
        check("FC 03 global block", not rr.isError())
        g = rr.registers
        ver = icd.decode(icd.GLOBAL_BY_NAME["ICD_VERSION"], g[0:2])
        check("ICD_VERSION", int(ver) == icd.ICD_VERSION_ENCODED, f"{int(ver)}")
        check("PANEL_COUNT", g[icd.GLOBAL_BY_NAME["PANEL_COUNT"].offset] == 14,
              str(g[icd.GLOBAL_BY_NAME["PANEL_COUNT"].offset]))

        # 2. panel 14, and FC 04 must return the same words
        base = icd.panel_base(14)
        r3 = await client.read_holding_registers(base, count=icd.REGS_PER_PANEL, device_id=1)
        r4 = await client.read_input_registers(base, count=icd.REGS_PER_PANEL, device_id=1)
        check("FC 03 == FC 04 same address space", r3.registers == r4.registers)
        w = r3.registers
        theta = icd.decode(icd.PANEL_BY_NAME["THETA_MAX"], [w[6]])
        status = w[_R_STATUS.offset]
        check("panel 14 DATA_VALID set", bool(status & _DATA_VALID_MASK),
              f"STATUS_WORD=0x{status:04X} {icd.unpack_bits(icd.STATUS_BITS, status)}")
        check("panel 14 THETA_MAX decodes", abs(theta) < 100.0, f"{theta:+.1f} K")

        # 3. writes rejected
        wr = await client.write_register(base, 1234, device_id=1)
        check("FC 06 rejected", wr.isError() and wr.exception_code == 1,
              f"exception 0x{getattr(wr, 'exception_code', 0):02X}")
        wm = await client.write_registers(base, [1, 2, 3], device_id=1)
        check("FC 16 rejected", wm.isError() and wm.exception_code == 1,
              f"exception 0x{getattr(wm, 'exception_code', 0):02X}")

        # 4. unpopulated panel
        empty = icd.panel_base(120)
        re = await client.read_holding_registers(empty, count=icd.REGS_PER_PANEL, device_id=1)
        check("panel 120 all zero, DATA_VALID clear",
              set(re.registers) == {0} and not (re.registers[_R_STATUS.offset] & _DATA_VALID_MASK))

        # 5. heartbeat
        hb0 = (await client.read_holding_registers(7, count=1, device_id=1)).registers[0]
        slave.tick()
        slave.tick()
        hb1 = (await client.read_holding_registers(7, count=1, device_id=1)).registers[0]
        check("WATCHDOG_HEARTBEAT advances", hb1 == hb0 + 2, f"{hb0} -> {hb1}")

        st = slave.poll_stats
        check("poll_stats sees the client", st["request_count"] >= 7 and st["clients"],
              f"{st['request_count']} requests from {st['clients']}")
        check("poll_stats counts rejected writes", st["rejected_writes"] == 2)
    finally:
        client.close()
        await slave.stop()

    print("\nmodpoll commands a judge can type:")
    for line in slave.modpoll_commands(14):
        print("  " + line)
    print(f"\n{'SELF-TEST PASSED' if ok else 'SELF-TEST FAILED'}")
    return 0 if ok else 1


async def _demo(host: str, port: int, panels: int) -> None:
    slave = ScadaSlave(host=host, port=port)
    slave.update_fleet(demo_fleet(panels))
    await slave.start()
    print(f"PANO GÖZ SCADA slave on {host}:{slave.bound_port}, {panels} panels, unit id 1")
    for line in slave.modpoll_commands(min(14, panels), host="127.0.0.1"):
        print("  " + line)
    print("Ctrl-C to stop.")
    try:
        await slave.serve()
    except (KeyboardInterrupt, asyncio.CancelledError):
        await slave.stop()


if __name__ == "__main__":  # pragma: no cover
    ap = argparse.ArgumentParser(description="PANO GÖZ northbound Modbus TCP slave")
    ap.add_argument("--serve", action="store_true", help="run the demo server instead of the self-test")
    ap.add_argument("--host", default="0.0.0.0")
    ap.add_argument("--port", type=int, default=5020)
    ap.add_argument("--panels", type=int, default=14)
    args = ap.parse_args()
    if args.serve:
        try:
            asyncio.run(_demo(args.host, args.port, args.panels))
        except KeyboardInterrupt:
            pass
        raise SystemExit(0)
    raise SystemExit(asyncio.run(_selftest()))
