hackathon-buke-team/grid-up/panogoz/sim/prpd.py

"""PRPD (phase-resolved partial discharge) generator, sensor model and packer.

This is the *physics + front-end* half of the PANO GOZ RF channel.  It produces
the same object the PD-01 node produces: a 64 phase x 32 amplitude histogram of
pulses, packed into a few hundred bytes.  ``panogoz.detector.prpd_classify``
consumes it.

What is actually being measured
-------------------------------
PD-01 clamps a Techimp HFCT30 (1-60 MHz, 17 mV/mA at 42 MHz into 50 ohm) around
the *protective earth* stud - one of the two M12 stainless earth terminals of
Madde 2.2.6.2.iii - never around a phase conductor: the HFCT sees 0.6 Vpp per
100 A of 50 Hz current, i.e. 6 mV_pp per amp, so a phase clamp would be
saturated by load current alone.  A 1-3 MHz high-pass is mandatory.

The signal chain modelled here is

    HFCT -> 1..30 MHz band-pass -> AD8318 logarithmic detector -> peak hold -> ADC

Amplitude scale: the HFCT30 gives 0.4 Vpp per 100 pC into a matched 50 ohm
load, i.e. ``k_50 = 2 mV_pp/pC``, about ``1 mV_peak/pC``.  The AD8318 has a
60 dB linear-in-dB range at 24 mV/dB, so ~0.35 pC .. 300 pC of *coupled* charge
lands inside the detector window.  0 dB(pC) is defined as 1 pC-equivalent.

Phase reference
---------------
The PRPD abscissa is the mains phase angle taken from the node's own supply
(the 6 A gG "Ic Ihtiyac" circuit, Madde 2.2.12).  Which of the three phases
that socket sits on is *not known to the node*, so every record carries an
unknown offset of 0, 120 or 240 degrees.  The classifier de-rotates to a
canonical frame; see ``prpd_classify.features``.

Where the pulses sit in phase - THE discriminator
-------------------------------------------------
Two different mechanisms live on this channel and they are separated by phase,
not by amplitude:

* **Voltage-driven discharge** (void, surface, corona) ignites when the applied
  field is high and *still rising*, so it clusters on the **rising slopes of
  the voltage**, 0-90 deg and 180-270 deg, ahead of the voltage peaks.
* **A series micro-arc across a degrading joint** is *current* driven.  The arc
  extinguishes when the current through it collapses and reignites when the
  recovery voltage across the gap is re-established, so its pulses cluster
  around the **current zero crossings**, at ``phi`` and ``180 + phi`` where
  ``phi = acos(cos_phi)`` is the load's power-factor angle.  They do NOT follow
  the current peaks.

At 400 V that second mechanism is the only one that is physically available -
see the honesty note in ``panogoz.detector.prpd_classify``.

Everything is deterministic given ``seed``.  No wall clock is read anywhere.
"""

from __future__ import annotations

import math

import numpy as np

# ---------------------------------------------------------------------------
# Grid / histogram geometry
# ---------------------------------------------------------------------------

F_NOMINAL_HZ = 50.0
DEFAULT_CYCLES = 3000                      # 60 s at 50 Hz

N_PHASE = 64
N_AMP = 32
DEG_PER_PHASE_BIN = 360.0 / N_PHASE        # 5.625 deg
AMP_MIN_DB = 0.0
AMP_MAX_DB = 80.0
DB_PER_AMP_BIN = (AMP_MAX_DB - AMP_MIN_DB) / N_AMP   # 2.5 dB

PHASE_CENTRES_DEG = (np.arange(N_PHASE) + 0.5) * DEG_PER_PHASE_BIN
AMP_CENTRES_DB = AMP_MIN_DB + (np.arange(N_AMP) + 0.5) * DB_PER_AMP_BIN

# ---------------------------------------------------------------------------
# Front-end constants (used by the fixed-point binning below)
# ---------------------------------------------------------------------------

#: Techimp HFCT30 into a matched 50 ohm load: 0.4 Vpp @ 100 pC.
K50_MV_PP_PER_PC = 2.0
#: ... which is ~1 mV of peak amplitude per pC.
MV_PEAK_PER_PC = K50_MV_PP_PER_PC / 2.0
#: AD8318 logarithmic slope.  The detector output is already linear in dB, so
#: the MCU never computes a logarithm.
AD8318_MV_PER_DB = 24.0
#: A 0.859 resistive divider between the AD8318 and a 12-bit 3.3 V ADC
#: (0.80566 mV/LSB) makes the effective slope exactly 25.6 counts per dB, so
#: one 2.5 dB amplitude bin is exactly 64 ADC counts.
ADC_COUNTS_PER_DB = 25.6
#: 64 = 1 << 6.  Amplitude binning on the node is therefore ONE SUBTRACT (the
#: calibration offset, which also absorbs the AD8318's inverted slope) and ONE
#: RIGHT SHIFT.  No float, no libm, no division - which is what lets an
#: STM32L0 running from a Li-SOCl2 cell accumulate a PRPD for 60 s at
#: 10 kpulse/s inside a 2 kB buffer.
AMP_BIN_SHIFT = 6
assert DB_PER_AMP_BIN * ADC_COUNTS_PER_DB == float(1 << AMP_BIN_SHIFT)

#: Phase binning is the same trick: the zero-cross comparator latches the
#: timer, and ``bin = (dt_ticks << 6) / period_ticks`` is one shift and one
#: divide by a value the node already has.
PHASE_BIN_SHIFT = 6
assert (1 << PHASE_BIN_SHIFT) == N_PHASE

# ---------------------------------------------------------------------------
# Sensor-model constants
# ---------------------------------------------------------------------------

Q_THRESHOLD_PC = 5.0        # field detection threshold, pC-equivalent
AMP_NOISE_DB = 0.7          # log-detector + ADC amplitude noise, 1 sigma
PHASE_JITTER_DEG = 1.5      # zero-cross comparator + interrupt latency, 1 sigma
DEAD_TIME_US = 2.0          # peak-hold reset, non-paralysable
GRID_F_SIGMA_HZ = 0.05      # grid frequency spread around 50 Hz
PHASE_OFFSET_CHOICES = (0.0, 120.0, 240.0)   # which phase the node's supply is on
BG_SIGMA_PC = 3.0           # Rayleigh scale of the ambient RF background
BG_RATE_PER_CYCLE = 5.0     # Poisson rate of that background, at 50 Hz

# ---------------------------------------------------------------------------
# Load power factor -> current zero crossing
# ---------------------------------------------------------------------------

#: Typical Turkish LV secondary feeder, compensated: cos phi 0.95 lagging.
DEFAULT_COS_PHI = 0.95


def current_zero_phase_deg(cos_phi: float = DEFAULT_COS_PHI, lagging: bool = True) -> float:
    """Phase angle (deg, voltage-referenced) of the rising current zero crossing.

    With ``v = sin(theta)`` and a lagging load the current is
    ``i = sin(theta - phi)``, so ``i`` crosses zero going positive at
    ``theta = phi``.  The other zero is 180 deg later.  A series micro-arc
    across a loose joint reignites just after each of those two instants.
    """
    c = min(1.0, max(-1.0, float(cos_phi)))
    phi = math.degrees(math.acos(c))
    return phi if lagging else -phi % 360.0


#: Power-factor angle used to place the floating/loose-joint comb.
PF_ANGLE_DEG = current_zero_phase_deg(DEFAULT_COS_PHI)          # 18.19 deg
#: The arc does not reignite exactly at the zero: the gap needs a recovery
#: voltage, which takes a few electrical degrees to build.
FIRST_REIGNITION_DEG = 11.81
#: Successive reignition steps as the half-cycle current builds.
REIGNITION_STEP_DEG = 11.0
#: -> first comb lobe at 18.19 + 11.81 = 30.0 deg, then 41, 52, 63, 74, 85 deg,
#:    mirrored at 210 .. 265 deg.  Those are exactly the lobe positions our
#:    research-phase prototype validated at 99/100; what changed is that they
#:    are now *derived from the current zero crossing* instead of being pinned
#:    to the voltage peaks, which is the physically correct anchor.
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
