hackathon-buke-team/grid-up/(commit log)

2026-09-11 PANO GÖZ: pano içi anomali erken uyarı sistemi
    Uçtan uca çalışan teslim: uç düğüm firmware'i, ağ geçidi, dedektör,
    kural katmanı, alarm ve bildirim, Modbus TCP slave ve web arayüzü.
    Katmanlar
    - contracts/ tek doğruluk kaynağı: 57 kanal, 7 arıza modu, ICD v2.0.0
    - sim/ fizikten türetilmiş dijital ikiz, 17 arıza senaryosu
    - gateway/ Modbus master, QoS 1 store-and-forward, kalıcı outbox
    - detector/ θ kestirimi (RLS), CUSUM, değişim noktası, çiy noktası, nötr H3
    - rules/ bastırma → füzyon → alarm yaşam döngüsü
    - scada/ Modbus TCP slave, pano başına 48 register, 200 pano kapasitesi
    - notify/ eskalasyon merdiveni ve kimliklen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
2026-09-16 Arayüz: açık/koyu tema, gerçek Türkiye haritası, aranabilir pano seçici
    Monitoring arayüzü tek koyu yüzeyden iki temalı bir kontrol ekranına
    dönüştü ve filo görünümü artık gerçek coğrafya üzerinde çiziliyor.
    Yeni modüller:
    * js/theme.js - koyu/açık yüzey, seçim localStorage'da, varsayılan koyu.
    index.html'de ilk boyamadan önce çalışan küçük bir
    betik var; aksi halde açık temayı seçen kullanıcı bir
    kare koyu ekran görüyordu.
    * js/map.js - Türkiye il sınırları, 39° K paralelli plate carrée
    izdüşümü. Karo sunucusu yok, kurulum hava boşluklu.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
2026-09-17 Eşiğe kalan gün: tasarım belgesi
    θ sürüklenme eğimini bir sonraki seviye basamağına kalan gün olarak
    çeviren projeksiyonun tasarımı. Yeni kestirici yok: mevcut Theil-Sen
    eğiminin Sen (1968) rank tabanlı güven aralığı, günlük θ medyanları
    üzerinde.
    Kararlar:
    - Hedef, θ'nın günlük değerinin bir üst basamağı; füzyon seviyesi değil
    - Belirsizlik eğimin parametrik olmayan CI'ından; bootstrap reddedildi
    - Beş susma kodu; görünürlük kapısı yüzde değil theta_min >= hedef eşik
    - Basamak varsa projeksiyon changepoint sonrasını kullanır, mevcut
    slope_k_per_week tanımına dokunulmaz
    - SCADA haritasına dokunulmuyor: 48 register'lık pano bloğu tam d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
2026-09-17 Eşiğe kalan gün: uygulama planı, ve spec'te iki düzeltme
    Plan on görev, her biri kırmızı test → uygulama → yeşil → commit.
    Plan yazılırken iki şey ölçüldü ve spec gerçeğe çekildi:
    - joint_daily.theta_min şemada tanımlı ama roll_daily onu hiç
    yazmıyor; det.theta_min_k örneklerini okuyup yalnız load_mean'i
    türetiyor. Görünürlük kapısı bu kolona dayandığı için ölü doğardı.
    Görev 4 olarak plana girdi, spec §5.1'e ön koşul olarak yazıldı.
    - Projeksiyon θ grafiğinin üstüne çizilemez: dört grafik tek ve ortak
    x eksenini paylaşıyor, eksenin sağ kenarı "şimdi" ve gelecekteki
    kesişim tuvalin dışına düşüyor. Spec §9 me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
2026-09-17 contracts: EtaView, bir sonraki basamağa kalan gün sözleşmesi
    JointView ve PanelLive üzerine iç içe görünüm olarak oturur; ArcView /
    PdView desenini izler. excess_r_* gibi aralık taşır, ek olarak bir de
    susma gerekçesi taşır.
    days_hi is None iki ayrı şey demektir ve sözleşme bunu açıkça yazıyor:
    reason boşsa sonsuz, reason doluysa sayı yok. Arayüz reason'a bakar.
2026-09-17 roll_daily: joint_daily.theta_min artık yazılıyor
    Şema bu kolonu baştan tanımlıyordu; rollup det.theta_min_k örneklerini
    okuyup yalnız load_mean'i türetiyor, kolonu boş bırakıyordu. Ufuk
    projeksiyonunun görünürlük kapısı bu kolonu okuyor, yani kapı bugünkü
    kodda ölü doğardı.
    Uyarı: joint_sample 90 günde budandığı için daha eski günlük satırlar
    geriye doldurulamaz; onlarda theta_min NULL kalır ve kapı susma
    tarafına düşer.
2026-09-17 engine: ufuk projeksiyonunu joint_daily'den kurar ve görünümlere yazar
    THETA_ABS_LADDER dört mevcut sabitten türer, onları tekrar etmez.
    _refresh_stats her turda joint_daily'nin GEÇERLİ satırlarından yeniden
    hesaplar: joint_state'e yazılmaz, çünkü sekiz ay sonra SELECT ile
    yeniden üretilemeyen bir istatistik kanıt değildir.
    theta_min bilinmiyorsa inf geçilir ve kapı 'görünürlük düşük' tarafına
    düşer: bilmediğimiz bir tabanla eşiğin görünür olduğunu iddia etmeyiz.
    lift_panel_eta hedefi en ağır bağlantıyı seçer, gününü en yakın olanı
    değil. IZLE'ye 3 gün, KRITIK'e 18 günün önüne geçemez.
    Öz-test 40 günlük rampada θ 10.24 K için "KRI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
2026-09-17 api: eta filo kartında, pano görüntüsünde ve /onset'te
    Yeni uç açılmadı. /onset iki zaman sorusunu cevaplıyordu (ne zaman
    başladı, kanıt ne zaman yeterli oldu); üçüncüsü aynı joint_daily
    oynatmasından çıkıyor, bu yüzden aynı uca kondu.
    Erken dönüş yolu (en kötü bağlantısı olmayan sağlıklı pano) da eta
    anahtarını taşıyor: arayüz alanın VARLIĞINI kontrol etmek zorunda
    kalmamalı, boş bir EtaView "projeksiyon yok" demenin sözleşmeye uygun
    hâlidir.
2026-09-17 Arayüz: filo tablosuna "Eşiğe" kolonu; susmanın her zaman bir kodu var
    fmt.js'e eta/etaReason/etaHasDays ve SEVERITY_DATIVE. Üç ekran aynı
    biçimleyiciyi kullanacak; biçim tek yerde durmazsa aynı sayı üç ekranda
    üç farklı yazılır.
    Sıralama bileşik: önce hedefin ağırlığı, sonra gün. Sayı vermeyen
    satırlar sıralama yönü ne olursa olsun sona gider. Varsayılan sıralama
    Δ7 gün olarak KALIYOR.
    Çalıştırıp bakınca iki sessiz boşluk çıktı ve ikisi de kapatıldı:
    1. lift_panel_eta hiçbir bağlantı sayı vermediğinde boş EtaView
    dönüyordu, yani gerekçe pano düzeyinde kayboluyordu ve filo
    tablosunda sebebi sorulamayan bir "—" görünüyord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
2026-09-17 Arayüz: kanıt ekranına projeksiyon kartı, θ grafiğine hedef eşik
    Projeksiyon θ grafiğinin ÜSTÜNE çizilmiyor ve bu bir kısıt, tercih
    değil: dört grafik tek ve ortak bir x eksenini paylaşıyor, eksenin sağ
    kenarı "şimdi" ve TimeChart noktaları X(t) ile alana eşliyor, yani
    t > domain[1] olan gelecekteki kesişim tuvalin dışına düşer. Alanı
    geleceğe uzatmak dört grafiği birden sıkıştırır ve senkron eksen sözünü
    bozar. Eşiğin NEREDE olduğunu gösteren yatay çizgi alan içinde kalır ve
    işi görür; sayılar kartta durur.
    Kart gerekçeyi sayının YERİNE yazıyor. Basamak notu, sonsuz sınır notu,
    tavan notu ve doğrusallık notu koşullu.
    Tarayıcı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
2026-09-20 K1 B1 tasarimini ve STM32 TC hedef portunu ekle
2026-09-20 Align K1 B1 coverage, battery model, costs and durable radio ingress
2026-09-20 Connect B1 CAD deliverables to digital twin devices
2026-09-20 saha: ekip telefonu uygulaması, API ve sunucuya bağlama
    /saha/ (PWA, sıfır bağımlılık) ve /api/saha, /api/notify uçları: PIN'li
    oturum ve kilitlenme, gelen kutusu, tam ekran alarm, olay ayrıntısı (konum,
    ölçümler, neden alarm verildi / neler elendi), iş emri durumu (audit
    zincirine yazılır, şema değişmedi), zaman çizgisi. Onay kodu telefona
    gönderilmez.
    - api/app.py: saha.install(app, rt); konsolun ark düğmesi yalnız
    {panel_key} gönderiyor ve ark_olayi varsayılanı at_s=3600 idi, yani ark
    tıklamadan 1 saat sonra oluyordu; gecikme verilmezse 3 s (LIVE_DEMO_AT_S)
    - api/runtime.py: notifier fabrikadan kurulur, stop() hatları kapatır
    - run_local.py / baslat.p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
2026-09-20 saha: arayüz yenilendi (giriş tuş takımı, onay süresi, θ ölçeği, sabit eylem çubuğu)
    - Giriş: marka, üye kartları, rakam tuş takımı (eldivenle basılır), yanlış
    PIN'de sallanan noktalar; fiziksel klavye de çalışır
    - Gelen kutusu: "N olay onay bekliyor" özet kartı, rozetli kartlar ve
    onay süresi çubuğu (süre merdivenin kendi ACK_DEADLINE_S sayısı)
    - Ayrıntı: θ'yı mutlak basamaklar üzerinde gösteren ölçek (eşikler
    detector.engine.THETA_ABS_LADDER'den API ile gelir), iş emri adım
    göstergesi, kanal etiketli zaman çizgisi
    - Sabit eylem çubuğu ve üst şerit OPAK: onay alanında arkadaki yazı
    görünmüyor; altına kayan içerik çubuğun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
2026-09-20 saha: arayüz cilası, geniş ekran düzeni (giriş, liste, ayrıntı)
    Telefon düzeni aynı; yeni kurallar min-width sorgularının içinde.
    - giriş: geniş ekranda iki panel (marka + özellikler | PIN kartı)
    - gelen kutusu: yüzen üst çubuk, sayaçlı özet bandı, iki sütunlu kart ızgarası, kart numarası, hover
    - ayrıntı: iki sütun (eylem/iş emri/konum | ölçüm/gerekçe/zaman), yüzen eylem paneli
    - açık tema: daha belirgin zemin/kenar/gölge; koyu tema: iki katmanlı ışıma
    - düzeltme: a.btn bağlantı-düğmeleri mor/altı çizili görünmüyor
    - sw.js önbellek sürümü v3
2026-09-20 notify: repoda sabit demo PIN'leri (notify.demo.json) ve indir-çalıştır README bölümü
    notify.local.json yoksa run_local notify.demo.json'u okur: Nöbetçi tekniker 1111,
    Vardiya amiri 2222, İşletme müdürü 3333. Dosya gizli bilgi içermez, SMS simüle kalır,
    Telegram kapalıdır. notify.local.json varsa o önceliklidir (gerçek anahtar, numara ve
    PIN yine yalnız orada durur ve git'e girmez). Konsol PIN'leri ve "herkese açık"
    uyarısını yazar. Yalnız canlı kanal isteyen süreç (run_local) bu dosyayı okur; testler
    ve yardımcı betikler yine defaults() alır.
